Comxt-i/smart-pill-dispenser/output/qa/revised-render/page-9.png

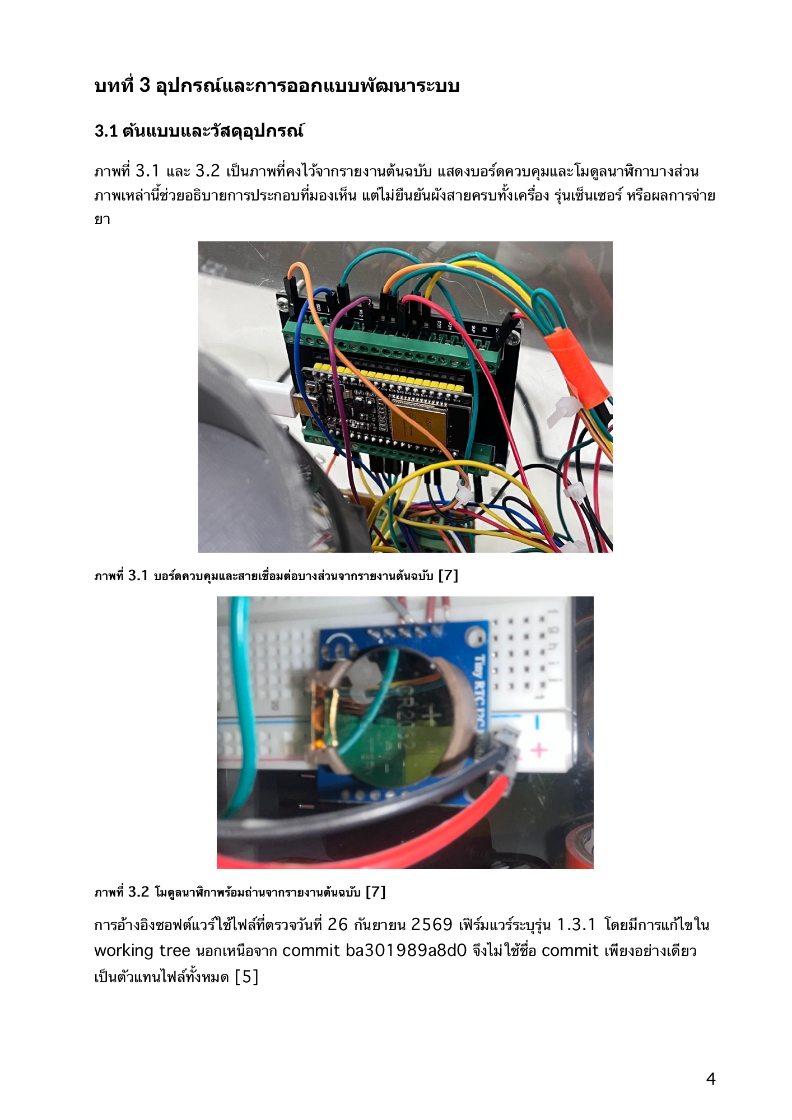
output/qa/revised-render/page-9.png
