Comxt-i/smart-pill-dispenser/output/imagegen/esp32-current-wiring.png

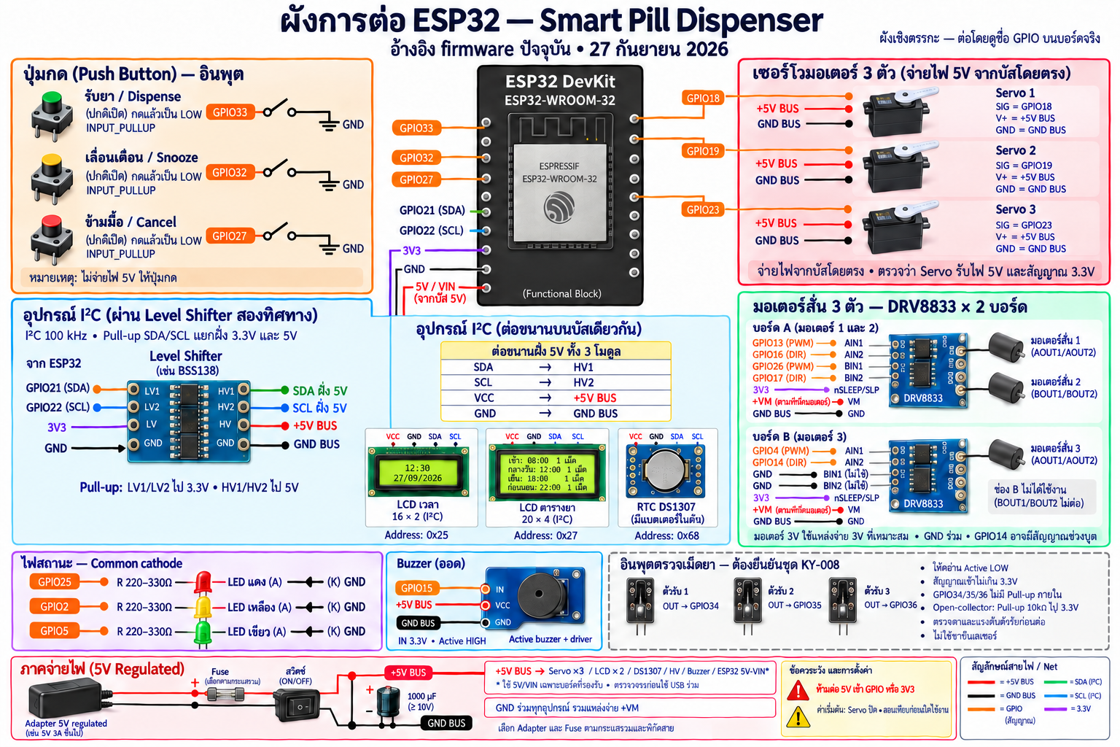
output/imagegen/esp32-current-wiring.png
