Comxt-i/smart-pill-dispenser/README.md

> Wi-Fi setup update: firmware 1.1.0 uses the QR/login + local setup portal. See [QR Wi-Fi setup](docs/QR_WIFI_SETUP.md). To provision a network before flashing, set `WIFI_PRESET_ENABLED true` and fill `WIFI_SSID`/`WIFI_PASSWORD` in local `secrets.h`. On boot, the firmware saves this network only if no valid Wi-Fi settings exist, then connects automatically. Existing saved networks take priority. Account pairing still uses the setup portal; hold the green GPIO33 button for 3 seconds while the mechanism is idle to open it; no restart is needed. The power-on gesture is also supported.

# Smart Pill Dispenser

โปรเจกต์กล่องยาสำหรับผู้สูงอายุแบบจานหมุน 3 ชุด ใช้ **ESP32 เพียงบอร์ดเดียว**
ทำงานร่วมกับเว็บ (`embedded_project/`) ซึ่งเป็นที่ตั้งตารางยาและเก็บประวัติการจ่ายยา

- ESP32 ควบคุม Wi-Fi, RTC DS1307, LCD 2 จอ, ปุ่มกด, Buzzer และ Servo 270° จำนวน 3 ตัวโดยตรง
- Servo แต่ละตัวหมุนจานของยาคนละชนิด ไม่ใช่ระบบรางยา 3 ชุด
- **ตารางยามาจากเว็บอัตโนมัติ** การแก้ไขแจ้งถึงเครื่องผ่าน `/api/device/wait`; sync เต็มทำตามช่วงที่ server กำหนด (ปกติประมาณ 5 นาที)
- ผลการจ่ายที่ส่งไม่สำเร็จจะรอในคิว NVS สูงสุด 12 รายการ เมื่อคิวเต็มรายการเก่าสุดจะถูกแทนที่
- มีอินพุตเซ็นเซอร์ดิจิทัลแบบ active-low สำหรับตรวจเม็ดยา แต่การใช้งานกับชุด **Laser Head Transmitter & Receiver Module KY-008** ยังต้องยืนยันกับอุปกรณ์จริง
- ไม่มีบอร์ด Nano หรือ protocol ส่งคำสั่งระหว่างบอร์ด

## การทำงานหนึ่งรอบ

```text
1. เว็บ: ผู้ใช้เพิ่มยา ตั้งเวลา และเลือกใส่ยาลงช่องที่ 1–3
2. ESP32: รับเวลาและตารางจาก `/api/device/sync`; `/api/device/wait` แจ้งการเปลี่ยนแปลงจากเว็บ
3. ถึงเวลามื้อยา: Buzzer เตือน + LCD จอที่ 2 แสดงชื่อยา เวลา และจำนวนเม็ด
4. ผู้ใช้กดปุ่ม Dispense (GPIO33) -> จานหมุนจ่ายยา
5. ESP32: POST /api/device/events -> เว็บเห็นผลในประวัติและหน้าตารางทันที
6. ถ้าไม่มีใครกดภายใน 30 นาที -> บันทึกเป็น "ขาดยา" อัตโนมัติ
```

รายละเอียดของ API ทั้งหมดอยู่ใน [docs/SERVER_API.md](docs/SERVER_API.md)

## หน้าจอ

**จอเล็ก (16x2, `0x25`)** — วันที่และเวลาปัจจุบันจาก DS1307 รีเฟรชทุกวินาที

**จอใหญ่ (20x4, `0x27`)** — ตารางยาและการโต้ตอบกับผู้ใช้

- **แสดงเฉพาะยาของ "รอบถัดไป" รอบเดียว** ไม่ปนกับรอบอื่น
  ยาหลายชนิดที่ต้องกินพร้อมกันจะขึ้นพร้อมกันบรรทัดละชนิด
- พอรอบนั้นจัดการครบ จอจะเลื่อนไปแสดงรอบถัดไปให้เอง
- รูปแบบ `1 Paracetamol x2` (เลขช่อง ชื่อยา จำนวนเม็ด) ไม่ต้องใส่เวลาในแต่ละบรรทัด
  เพราะทุกบรรทัดใช้เวลาเดียวกันและไปอยู่บรรทัดล่างแล้ว
- **แต่ละบรรทัดเลื่อนวนอิสระจากกัน** ถ้าชื่อยายาวเกิน 20 ตัวอักษร
- **บรรทัดที่ 4 = เวลาของรอบนั้น** และสลับไปแสดงคำแนะนำปุ่มเมื่อถึงเวลา

ตัวอย่างตอนรอ รอบ 08:00 มียา 2 ชนิด ส่วนรอบ 18:00 ยังไม่แสดง:

```text
1 Paracetamol x2
2 Amoxicillin x1

Next 08:00  2 items
```

| สถานการณ์ | บรรทัด 1–3 | บรรทัดที่ 4 (สลับ) |
|---|---|---|
| รอรอบถัดไป | ยาของรอบนั้นทุกชนิด | `Next 08:00  2 items` (นิ่ง ไม่สลับ) |
| ถึงเวลาแล้ว | ช่องที่กำลังเตือนต่อท้ายด้วย `<<` | `NOW 08:00  slot 1` ↔ `GREEN = TAKE NOW` ↔ `YEL +5min  RED skip` |
| เลื่อนไว้ | ช่องนั้นต่อท้ายด้วย `ZZZ` | `Snooze back 08:35` ↔ `Snoozed 1 of 3` |
| เลื่อนครบโควตา | — | คำแนะนำเหลือ `RED = SKIP DOSE` |
| กำลังจ่าย | `Dispensing...` | `Please wait` |
| หมดแล้ววันนี้ | ว่าง | `All done today` |
| เน็ตหลุด | ยาของรอบนั้น | `Next 08:00  2 items` ↔ `OFFLINE - no sync` |

**ไฟแสดงสถานะ (ถ้าเปิดใช้):** แดง GPIO25, เหลือง GPIO2, เขียว GPIO5; Buzzer ใช้ GPIO15

การกดปุ่มทุกครั้งมีข้อความตอบรับสั้นๆ 3 วินาที (`DRY RUN OK`, `SNOOZE 5 MIN`,
`SKIPPED`, `CANNOT SNOOZE`, `NO DOSE DUE`) แล้วกลับไปหน้าเดิมเอง

### สลับจอกัน

ถ้าจอสลับหน้าที่กัน ให้สลับ **เฉพาะค่า `ADDRESS`** ของสองชุดนี้ใน `config.h`
ส่วน `COLS`/`ROWS` ไม่ต้องแตะ เพราะมันบอกขนาดของจอที่ทำหน้าที่นั้น ไม่ได้ผูกกับ address:

```c
constexpr uint8_t LCD_TIME_ADDRESS = 0x25;      // จอเล็ก 16x2
constexpr uint8_t LCD_TIME_COLS = 16;
constexpr uint8_t LCD_TIME_ROWS = 2;

constexpr uint8_t LCD_MEDICINE_ADDRESS = 0x27;  // จอใหญ่ 20x4
constexpr uint8_t LCD_MEDICINE_COLS = 20;
constexpr uint8_t LCD_MEDICINE_ROWS = 4;
```

รองรับจอขนาดอื่นได้ด้วย แค่แก้ COLS/ROWS ให้ตรงกับจอจริง (สูงสุด 20 คอลัมน์ตาม `LCD_MAX_COLS`)

## ปุ่มกด

ใช้โมดูลปุ่ม 3 ตัว **จ่ายไฟ VCC ด้วย 3.3V เท่านั้น** (5V จะทำให้ GPIO เสียหาย)
ทุกปุ่มเป็น active-LOW คือกดแล้วดึงขาลง GND ซึ่งตรงกับ `INPUT_PULLUP` ในโค้ด

| ปุ่ม | สีบนโมดูล | ขาโมดูล | GPIO | กดขณะกำลังเตือน | กดตอนปกติ |
|---|---|---|---:|---|---|
| Dispense (กดสั้นแล้วปล่อย) | เขียว | K3 | 33 | จ่ายยามื้อนั้นเมื่อปล่อยปุ่ม | เตือนว่ายังไม่ถึงเวลา |
| Wi-Fi Setup (กดค้าง 3 วินาที) | เขียว | K3 | 33 | เข้า Setup เมื่อกลไกว่าง โดยไม่จ่ายยา | เข้า Setup โดยไม่ต้องรีสตาร์ต |
| Snooze | เหลือง | K2 | 32 | เลื่อนไปอีก 5 นาที | สั่ง sync ตารางใหม่ทันที |
| Cancel | แดง | K1 | 27 | กดสั้น = ข้ามมื้อนี้ (บันทึก SKIPPED) | — |
| Cancel (กดค้าง ≥ 1.2 วินาที) | แดง | K1 | 27 | หยุดส่ง PWM ทันที | หยุดส่ง PWM ทันที |

กดค้างจะไม่สั่งจ่ายยาเมื่อปล่อยปุ่ม หากกลไกทำงานระหว่างกด ต้องปล่อยแล้วกดใหม่หลังกลไกว่าง ระหว่าง Setup จะพักการจ่ายยาและการเตือนจนตั้งค่าเสร็จ

การหยุด PWM ไม่ใช่การตัดไฟ Servo หรือการรับประกันว่ากลไกหยุดทันที

### การเลื่อนการเตือน (ปุ่มเหลือง)

- เลื่อนครั้งละ `SNOOZE_MINUTES` (5 นาที) ได้สูงสุด `MAX_SNOOZE_PER_DOSE` (3 ครั้ง) ต่อมื้อ
- ระหว่างเลื่อนจะ**เงียบสนิท** ไม่มีเสียงเตือน แต่จอยังแสดงว่าจะกลับมาเตือนกี่โมง
- **เลื่อนจนเลยเวลาผ่อนผันไม่ได้** ถ้าเลื่อนแล้วจะตื่นหลังหมด 30 นาที ระบบจะปฏิเสธ
  และขึ้น `CANNOT SNOOZE` เพื่อไม่ให้ผู้ใช้ผัดจนกลายเป็นขาดยาโดยไม่รู้ตัว
- มื้อที่เลื่อนไว้แล้วไม่มีใครมากดจนหมดเวลา ยังถูกบันทึกเป็น `MISSED` ตามปกติ
- การเลื่อน**ไม่สร้างประวัติแยก** แต่จะแนบจำนวนครั้งไปกับผลสุดท้าย เช่น `snoozed 2x`
  ผู้ดูแลจึงเห็นว่ามื้อนั้นถูกผัดไปกี่รอบโดยที่ประวัติไม่รก

## โครงสร้างโฟลเดอร์

```text
smart-pill-dispenser/
├── ESP32_Main/
│   ├── ESP32_Main.ino        # setup/loop เรียก pill_app เท่านั้น
│   ├── pill_app.cpp/.h       # ตรรกะหลัก: รวมตาราง ปุ่ม เสียง จอ และการคุยกับ server
│   ├── net_sync.cpp/.h       # HTTP + JSON คุยกับ backend
│   ├── schedule_store.cpp/.h # ตารางยาของวันนี้และสถานะรายมื้อ
│   ├── event_queue.cpp/.h    # คิวผลการจ่ายยา เก็บลง NVS กันหายตอนไฟดับ
│   ├── dispenser_control.cpp/.h
│   ├── buttons.cpp/.h
│   ├── alert.cpp/.h          # จังหวะเสียง buzzer แบบไม่ block
│   ├── rtc_lcd.cpp/.h        # นาฬิกา DS1307 + จอสองจอ
│   ├── marquee.cpp/.h        # ข้อความเลื่อนวนบนจอแบบไม่ block
│   ├── wifi_web.cpp/.h       # Wi-Fi แบบไม่ block + หน้าเว็บสถานะในเครื่อง
│   ├── config.h
│   ├── certs.h               # root CA ของ Let's Encrypt สำหรับตรวจใบรับรอง HTTPS
│   └── secrets.example.h
├── examples/
│   ├── TestDispenseEvent/    # sketch ทดสอบยิงผลการกดรับยาขึ้น server (ไม่ต้องต่อกลไก)
│   └── TwoPlateDispense/     # sketch สอบเทียบจานหมุน 2 จาน + มอเตอร์สั่นบน DRV8833
├── tests/
│   ├── syntax/               # header จำลองสำหรับตรวจไวยากรณ์บนคอมพิวเตอร์
│   └── ...
├── docs/
│   ├── ARCHITECTURE.md
│   └── SERVER_API.md
├── .gitignore
└── README.md
```

เปิด `ESP32_Main/ESP32_Main.ino` ด้วย Arduino IDE และอัปโหลดเพียงบอร์ดเดียว

## บอร์ดและไลบรารีที่ต้องใช้

ผังขาเริ่มต้นอิง ESP32 DevKit / ESP32-WROOM-32 แบบดั้งเดิม ไม่ใช่ ESP32-C3/S3
ติดตั้งแพ็กเกจบอร์ด `esp32 by Espressif Systems` และเลือกบอร์ดให้ตรงกับฮาร์ดแวร์
ติดตั้งไลบรารี:

- `ESP32Servo` สำหรับควบคุม Servo ด้วย PWM ของ ESP32
- `ArduinoJson` **เวอร์ชัน 7 ขึ้นไป** (โค้ดใช้ `JsonDocument` แบบใหม่ ไม่รองรับ v6)
- `LiquidCrystal_I2C`
- `TimeLib` (ชื่อใน Library Manager: `Time`)
- `DS1307RTC`

`Wire`, `WiFi`, `WebServer`, `HTTPClient` และ `Preferences` มาพร้อมแพ็กเกจบอร์ด ESP32

## ตั้งค่าก่อนใช้งาน

1. **เตรียม backend ให้พร้อมก่อน** เลือกอย่างใดอย่างหนึ่ง:
   - *ทดสอบในวง LAN*: ที่ `embedded_project/backend` คัดลอก `.env.example` เป็น `.env`
     แล้วรัน `npm install`, `npm run prisma:db:push`, `npm run prisma:seed`, `npm start`
     backend ผูกกับ `0.0.0.0` อยู่แล้ว จึงเรียกจากวง LAN ได้
   - *ใช้งานจริงผ่านอินเทอร์เน็ต*: deploy ด้วย Docker Compose ตาม
     [embedded_project/DEPLOY.md](../embedded_project/DEPLOY.md) จะได้โดเมนพร้อม HTTPS
2. คัดลอก `ESP32_Main/secrets.example.h` เป็น `ESP32_Main/secrets.h` แล้วกรอก:
   - `WIFI_SSID` / `WIFI_PASSWORD`
   - `SERVER_BASE_URL` — รองรับทั้งสองแบบ:
     - deploy แล้ว: `https://pillbox.example.com` (ตรวจใบรับรองด้วย `certs.h` ให้อัตโนมัติ)
     - ในวง LAN: `http://192.168.1.100:3000` โดยใช้ IP ของเครื่องที่รัน backend
       ห้ามใช้ `localhost` เพราะ localhost ของ ESP32 คือตัวมันเอง
   - `DEVICE_API_KEY` = ค่าจาก `Device.api_key` ในฐานข้อมูล
     (seed ตอน dev ให้ค่า `esp32_sec_key_246f28abc199` ส่วนตอน production จะสุ่มให้ใหม่)
3. ต่อสายตาม [docs/ARCHITECTURE.md](docs/ARCHITECTURE.md): Servo จาน 1–3 ใช้ GPIO18, GPIO19, GPIO23
4. ตรวจ I²C address ของ LCD ทั้งสองจอ; ค่าเริ่มต้นคือ `0x27` และ `0x25` ส่วน DS1307 คือ `0x68`
5. ตรวจช่วง pulse ที่ Servo รองรับ แล้วปรับ `SERVO_MIN_PULSE_US`, `SERVO_MAX_PULSE_US`,
   `REST_PULSE_US`, `RELEASE_PULSE_US` และ `MOVE_TIME_MS` ใน `config.h` โดยทดสอบแบบไม่ใส่ยาก่อน
   ค่าเริ่มต้นเป็นเพียงตัวอย่าง ไม่ใช่ช่วงหมุนครบ 270°
6. **ยังไม่ต่อ Servo:** ปล่อย `ENABLE_SERVO_MOVEMENT = false` และ `DISPENSE_DRY_RUN = true`
   ระบบจะทำงานครบวงจร (เตือน → กดปุ่ม → บันทึกขึ้นเว็บ) โดยไม่ขยับอะไร
   และติดป้ายในบันทึกว่า `dry run` เพื่อไม่ให้ประวัติหลอกว่าเม็ดยาออกมาจริง

   **ต่อ Servo แล้ว:** ตั้ง `DISPENSE_DRY_RUN = false` ก่อน แล้วค่อยเปลี่ยน
   `ENABLE_SERVO_MOVEMENT` เป็น `true` เมื่อสอบเทียบค่า pulse เรียบร้อย
   ถ้าตั้ง dry run เป็น false ขณะที่ยังปิดการเคลื่อนไหว จะได้ `FAILED / servo disabled`
   ซึ่งเป็นพฤติกรรมที่ถูกต้อง ไม่ใช่ความผิดพลาดของการเชื่อมต่อ
7. เปิด Serial Monitor ที่ 115200 baud — ตอนบูตจะ**สแกนบัส I²C แล้วรายงาน**ว่าพบ
   จอทั้งสองและ DS1307 ครบไหม ถ้า address ไม่ตรงจะเห็นคำเตือนทันทีแทนที่จอจะดับเงียบๆ
   จากนั้นเปิด IP ที่แสดงหลังเชื่อมต่อ Wi-Fi เพื่อดูหน้าสถานะในเครื่อง
   (ตาราง สถานะ sync คิวที่ค้าง และปุ่มทดสอบจ่ายยา)

## ทดสอบการเชื่อมต่อก่อนประกอบกลไก

ถ้าอยากตรวจว่า ESP32 คุยกับ server ได้จริงก่อนจะต่อ LCD, RTC และ Servo
ให้อัปโหลด [examples/TestDispenseEvent](examples/TestDispenseEvent/) แทน
sketch นั้นต่อแค่บอร์ดกับสาย USB ก็ทดสอบได้ ใช้ไลบรารีแค่ ArduinoJson
และมีคำสั่งผ่าน Serial สำหรับยิง `DISPENSED` / `MISSED` / `SKIPPED` / `FAILED`
รวมถึงทดสอบการส่งซ้ำเพื่อพิสูจน์ว่าระบบกันบันทึกซ้ำได้จริง

## พฤติกรรมเมื่อเน็ตหรือไฟมีปัญหา

- **Wi-Fi หลุด**: หากมีตาราง cache ที่อ่านได้และ RTC ใช้งานได้ เครื่องยังแจ้งเตือนและจ่ายยาตามตารางในเครื่อง
  ผลที่บันทึกลงคิว NVS แล้วจะส่งเมื่อกลับมาออนไลน์; คิวรองรับ 12 รายการและทิ้งรายการเก่าสุดเมื่อเต็ม
- **ไฟดับ**: ตาราง cache และคิวเหตุการณ์ที่เขียนลง NVS แล้วคงอยู่ และ DS1307 ที่มีถ่านสำรองยังเดินเวลาต่อ
  แต่ผลของกลไกที่ยังพักใน RAM ระหว่างมีจานทำงานอาจหายหากไฟดับก่อนบันทึก
- **บูตกลางวัน**: มื้อที่เลยมาเกิน 30 นาทีจะถูกข้ามเงียบๆ ไม่ปลุกย้อนหลังและไม่รายงานซ้ำ
  เพราะฝั่ง server ถือว่ามื้อที่ไม่มี log คือขาดยาอยู่แล้ว
- **server ล่ม**: เครื่องลอง sync ใหม่หลังช่วง retry 15 วินาที และยังทำงานตามตารางในเครื่องได้เมื่อ RTC พร้อม

## ทดสอบ logic บนคอมพิวเตอร์

ต้องมี `c++` และ `python3`

```bash
python3 tests/test_dispenser_control.py
python3 tests/test_schedule_store.py
python3 tests/test_marquee.py
python3 tests/test_firmware_syntax.py
```

- `test_dispenser_control.py` ทดสอบการคุม Servo ด้วยฮาร์ดแวร์จำลอง ทั้งตอนเปิดและปิดการเคลื่อนไหว
  รวมถึงการรายงานผลหนึ่งรอบผ่าน `takeDispenseOutcome()`
- `test_schedule_store.py` ทดสอบตรรกะตารางยา: การเตือน การนับว่าขาดยา การข้ามมื้อที่เลยมานานตอนบูต
  การคงสถานะเมื่อ sync ระหว่างวัน การข้ามวัน และช่องที่ถูกปิดใช้งาน
- `test_marquee.py` ทดสอบการเลื่อนข้อความบนจอ: ข้อความสั้นต้องอยู่นิ่ง ข้อความยาวต้องเลื่อน
  ครบทุกตัวอักษรและวนกลับมาที่ต้นได้ และการเรียกซ้ำด้วยข้อความเดิมต้องไม่ทำให้ภาพกระตุก
- `test_firmware_syntax.py` ตรวจไวยากรณ์ของทุกโมดูล **รวมถึง sketch ใน `examples/`**
  ด้วย header จำลองใน `tests/syntax/` จับพวกพิมพ์ผิด ลืม include และเรียกฟังก์ชันผิด
  signature ได้โดยไม่ต้องมี ESP32 toolchain

การทดสอบเหล่านี้ **ไม่แทน** การ compile ด้วย ESP32 toolchain จริงหรือการทดสอบกับบอร์ดและกลไกจริง
`tests/syntax/` เป็น header จำลองแบบว่างเปล่า ไม่ได้ตรวจพฤติกรรมของไลบรารีจริง
ก่อนนำไปใช้งานจริงต้อง compile และอัปโหลดผ่าน Arduino IDE เสมอ

## ระบบจ่ายไฟ

- ใช้ Adapter 5V regulated ต่อผ่าน Fuse และสวิตช์ก่อนเข้าบอร์ดกระจายไฟ
- ต่อ Capacitor 1000µF คร่อม `+5V` กับ `GND` ใกล้จุดจ่ายไฟ Servo
- จ่ายไฟ Servo จากบอร์ดกระจายไฟโดยตรง ห้ามจ่ายผ่านขา 3.3V/5V ของ ESP32
- ESP32, Servo และโมดูลที่สื่อสารกันต้องใช้ GND ร่วมกัน
- ตรวจว่า Servo รองรับ 5V และเลือกพิกัด Fuse ตามสาย ขั้วต่อ และกระแสจริงของระบบ
- GPIO ของ ESP32 ใช้ลอจิก 3.3V: โมดูล I²C ที่ดึงสัญญาณขึ้น 5V ยังต้องผ่าน Logic Level Shifter

รายละเอียดระดับสัญญาณ ผังสาย และข้อจำกัด firmware อยู่ใน [docs/ARCHITECTURE.md](docs/ARCHITECTURE.md)

## สิ่งที่ยังไม่ได้ทำ

- firmware มีโค้ดอ่านเซ็นเซอร์ดิจิทัลแบบ active-low แต่การใช้ชุด KY-008 และการนับเม็ดยากับกลไกจริงยังไม่ผ่านการยืนยัน
  ผลจำลองหรือสถานะ `DISPENSED` จากการทดสอบจึงไม่ใช่หลักฐานว่าเม็ดยาตกครบจำนวน
- ค่า pulse และเวลาหมุนยังไม่ผ่านการสอบเทียบกับกลไกจริง
- การใช้ `http://` ในวง LAN ส่ง API Key แบบไม่เข้ารหัส เหมาะกับเครือข่ายที่เชื่อถือได้เท่านั้น
  ถ้าเปิดออกอินเทอร์เน็ตต้องใช้ `https://` (รองรับแล้ว ดู `certs.h` และ `TLS_VERIFY_CERTIFICATE`)

## ทดสอบระบบโดยยังไม่มีฮาร์ดแวร์

เฟิร์มแวร์ 1.2.0 ยังใช้ `ENABLE_SERVO_MOVEMENT=false` และ `DISPENSE_DRY_RUN=true` จึงไม่ขยับกลไก
เมื่อเชื่อมเว็บและ sync สำเร็จ เวลาท้องถิ่นจาก server จะเริ่มนาฬิกาใน RAM แม้ไม่มี RTC/LCD
นาฬิกาเดินต่อได้ขณะ Wi-Fi หลุด แต่หลังไฟดับหรือรีบูตต้องรับเวลาใหม่ก่อนใช้ตารางยา ถ้ามี RTC ที่ใช้ได้จะอ่านเวลาจาก RTC
หน้า `/status` ในเครือข่ายเดียวกันแสดง `clock_valid`, `clock_source` (`RTC`, `SERVER`, `WAITING`) และ `dry_run`

ตั้งยาทดสอบลงช่องแล้วตั้งเวลาในอนาคต เมื่อถึงเวลากดปุ่มเขียวสั้นแล้วปล่อย (เว็บสั่งจ่ายยาไม่ได้ ต้องกดที่กล่องเท่านั้น)
ผลจะมีหมายเหตุ `dry run` รวมถึงการข้าม และการเลยเวลาในโหมดจำลอง
ปฏิทินควรแสดงว่าเป็นการทดสอบและไม่นับรวมสถิติการจ่ายจริง ต้องใช้เว็บ/backend ชุดที่รองรับด้วย
ผลทดสอบยืนยันได้เฉพาะเส้นทางซอฟต์แวร์ ไม่ได้ยืนยันจำนวนเม็ดหรือการทำงานของกลไกจริง

## เตรียมอัปโหลดรุ่น 1.3.1

ดู [คู่มืออัปโหลดและเปิดใช้ฮาร์ดแวร์](docs/UPLOAD_FIRMWARE.md)
ค่าเริ่มต้นสำหรับบอร์ดเปล่าเป็น SIMULATION; profile ฮาร์ดแวร์แยกใน `hardware.local.h`
สคริปต์ `python3 tools/firmware.py upload --port <USB_PORT>` จะ build ใหม่ก่อน flash ทุกครั้ง
