Comxt-i/smart-pill-dispenser/output/qa/original-render/Smart_Pill_Dispenser_Report.pdf

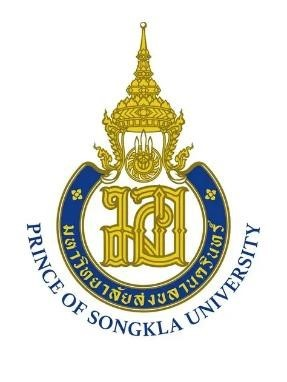
[picture p16: figure]

รื่ | จ่
อั | ริ

### Smart Pill Dispenser

จั | ทำ
กั | ษ์ | ก้ | หั | นั | ศึ
6710110021
ดี | รี | ล้ | หั | นั | ศึ
6710110562
. | . วี
ศั | ดิ์ | รื
พี | กุ | ร .

. ปั
. | ริ | ร์
ก้ | ภิ | ชั

นี้ | ป็ | ส่ | นึ่ | วิ | 240-
319 Embedded System Developer Module
วิ | รร | ร์ | วิ | รร
พิ | ร์
วิ | ลั | ริ | ร์ | วิ

ญ่

คำ | นำ

ESP32

ร

IR

Wi-Fi
รร

รร

25 | . . 2569

บั

1

1
1.1 | 1.2 | 1.3
| | 1
2
| | 2
2.1 | 2.4
| | 2
2.5 | 2.7
| | 3
3
| | 4
3.1 | | 4
3.2 | | 5
3.3 | | 6
3.4 | | 7
3.5 | | 8
3.6 | | 9
4 | 10
4.1 | | 10
4.2 | | 11
4.3 | 12 5 | 13
| | 14

ที่ | 1 | นำ
1.1 ที่ | สำ | คั

ESP32

IR

1.2 วั | ถุ | ค์
1.
ESP32
2. รร
3. IR
4. รร

1.3

1–9
ร
ร

ที่ | 2 | ยี | ที่
กี่ | ข้
2.1 | ร์ | ESP32
ESP32 | Wi-Fi ร
GPIO | ESP32 DevKit | ESP32-
WROOM-32

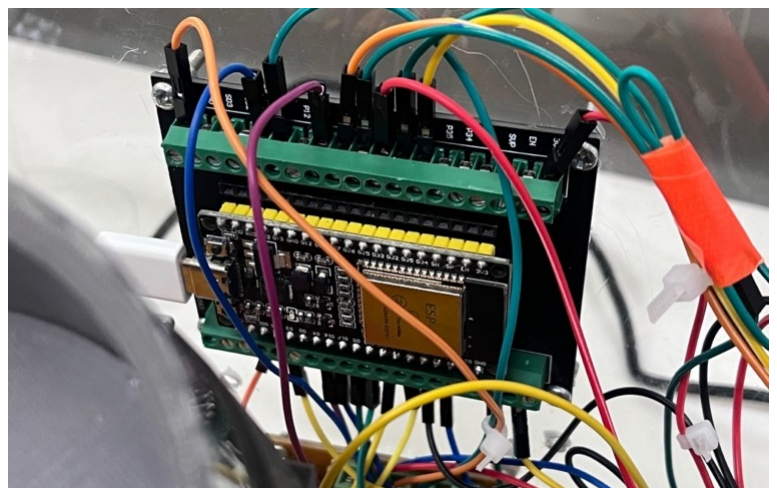
[picture p17: figure]

2.2 | ฬิ | DS1307 | LCD
DS1307 | I²C
LCD | 16×2 | 20×4
I²C | 0x25
| 0x27

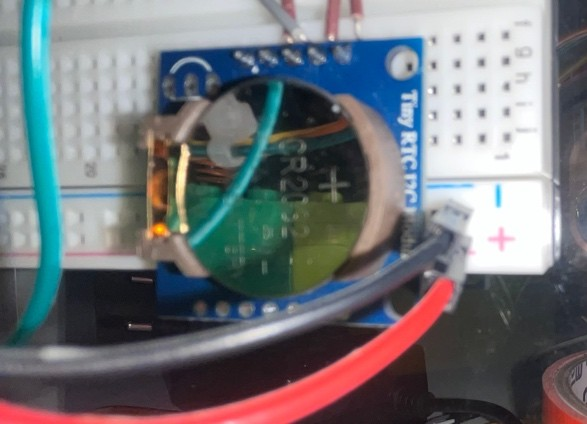
[picture p18: figure]

2.3 | ร์ | ร์ | ร์ | สั่

DRV8833

2.4 ซ็ | ร์ | IR สำ | รั | นั | ม็
IR
60
ร

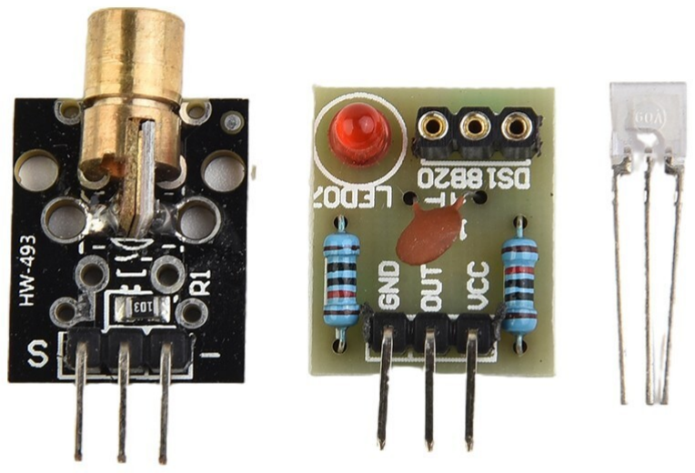
[picture p19: figure]

ที่ | 2 | ยี | ที่
กี่ | ข้
2.5 | สื่ | ผ่ | รื | ข่ | API
ESP32
60 | รร | GET /api/device/sync
ร | POST
/api/device/events
URL | HTTP | HTTPS | HTTPS
config.h
API key
JWT
2.6 ว็ | ต์ | ข้ | มู
React | TypeScript
NestJS | Prisma | PostgreSQL
ร

account

2.7 | ทำ | ก็ | ข้ | มู
ร | ร

loop
Flash/NVS
website | (Command ID)

ร

ที่ | 3 อุ | ณ์ | พั
3.1 วั | ดุ | อุ | ณ์
ำ ดั | อุ ณ์ | จำ | น้ ที่
1 | ESP32 DevKit / WROOM-32 | 1
2 | RTC DS1307 | 1
3 | LCD I²C 16×2 | 1
4 | LCD I²C 20×4 | 1
5 | | 3
6 | | 3
7 | DRV8833 | 2
8 | IR | 3
9 | | 1
10 | LED | 1
11 | Buzzer | 1
12 | I²C | 1
13 | | 1
14 | | 1

ำ ดั | อุ ณ์ | จำ | น้ ที่

15

รื่ | มื | พั | ต์ | ร์
Arduino IDE
ESP32 | ESP32Servo, ArduinoJson, LiquidCrystal_I2C, TimeLib
DS1307RTC | Python | C++
ESP32

3.2 | ร้ | ชื่ | ต่

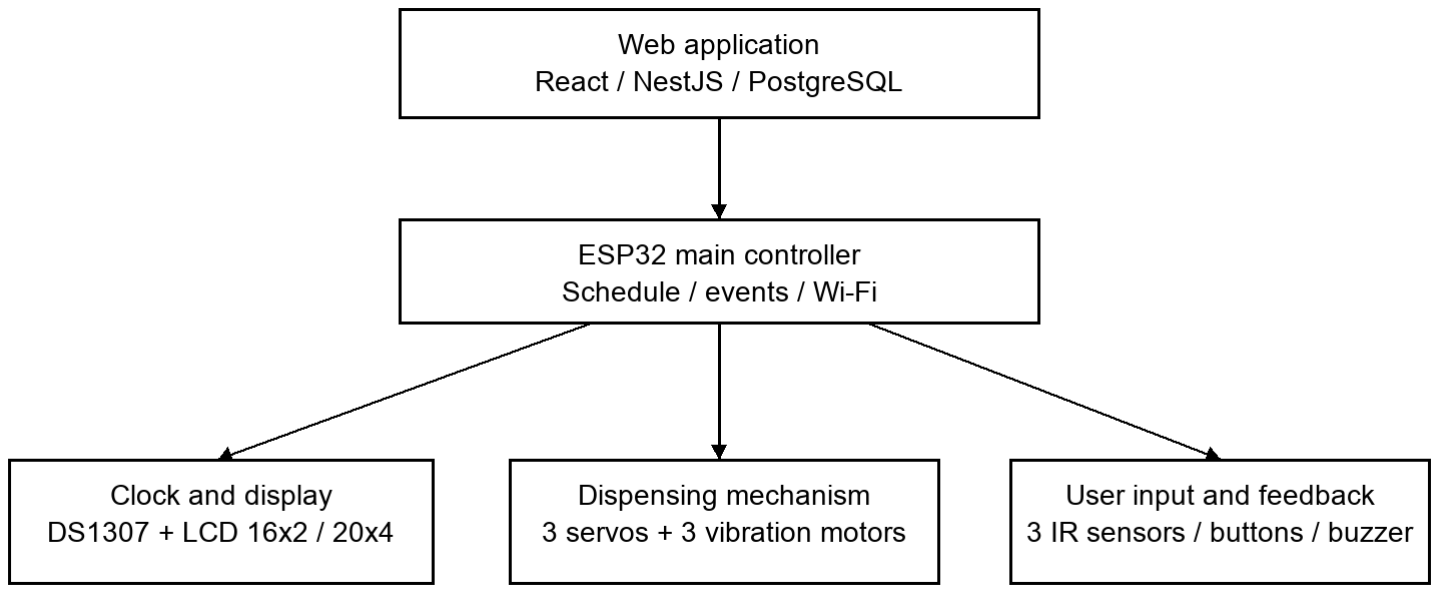
[picture p20: figure]

รู | ที่ | 1 | ร้ | ทำ
รื่ | จ่ | อั | ริ
อุ ณ์ รื สั | GPIO ESP32
I²C SDA SCL | 21 22
Servo 1 / 2 / 3 | 18 / 19 / 23
PWM 1 / 2 / 3 | 13 / 26 / 4
DIR 1 / 2 / 3 | 16 / 17 / 14
IR 1 / 2 / 3 | 34 / 35 / 36
/ / | 33 / 32 / 27
Buzzer | 25
RTC | I
| 2 C ร
IR | ESP32

GND

ESP32

3.3 | นั | ม็

Idle →
WaitingStart → Releasing | → Returning | → Shaking

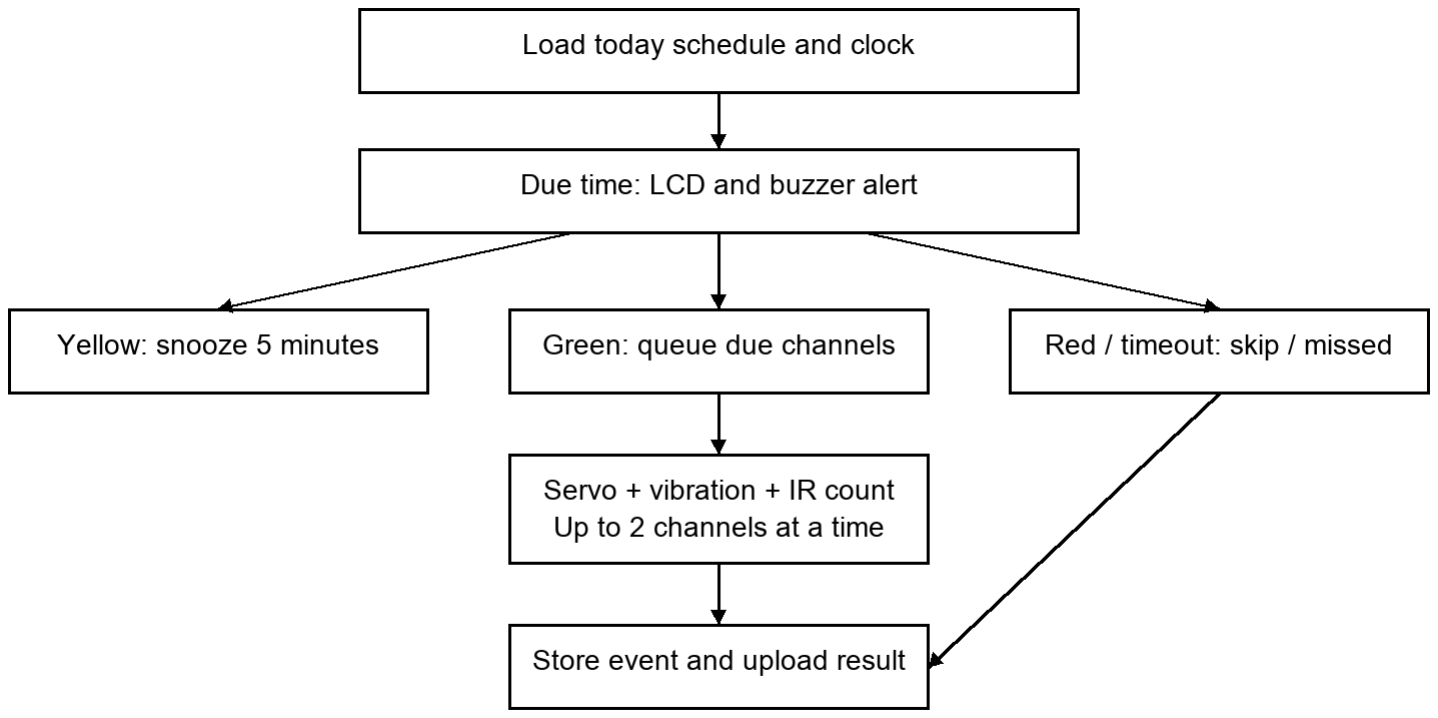
[picture p21: figure]

รู | ที่ | 2 ลำ | ดั | รั | บั | ทึ

ทำ
KY-008
8 | (
, | , | )
8 | ร

2
250

3.4 | ปุ่ | น้

รร

ช้ | ติ | รร
3 | Wi-Fi
| 5 3 ค
1.2 | PWM
| MISSED ค 30

รร
1–3 | รร | 4
รร
ตั | ย่ | ข้
1 MedicineA x2
2 MedicineB x1
3 MedicineC x1
Next 08:00 2 items

3.5 ว็ | ต์ | ลี่ | ข้ | มู

รร

รร

ค์ ข้ มู

User Device

Compartment Medication
Schedule
IntakeLog
DeviceCommand
DeviceSetupSession
ลำ | ดั | รั | ส่ | ข้ | มู
1. : ESP32
2. :
ร
3. :
4. :

ที่ | ส่ | ลั
- DISPENSED DISPENSED:
- MISSED:
- SKIPPED:
- FAILED:
- Dry Run: | dry run

รร

3.6 | ตั้ | ค่ | จั | มื่ | กิ
ข้ | ขั | ข้
ตั้ | ค่ | Wi-Fi | จั | คู่ | บั | ชี
QR

192.168.4.1

ร

ทำ | มื่ | รื | ข่ | ขั | ข้
NVS | 12
ริ่ | รื่ | ม่ | ป้ | กั
จ่ | ซ้ำ
NVS

RTC

รี | รื่ | ก่ | ปิ | ริ

PILLBOX_REAL_HARDWARE
PILLBOX_CALIBRATED

IR

ที่ | 4 | ดำ | นิ
4.1 | ต์ | ร์
25 | 2569
tests | unittest discover
13 | ร | 24.3
C++
ลุ่ | จำ
| 2
| 1
| 1
| 1
LCD | 1
| 1
| 2
| 1
| 1
| 2
| 13

รร

4.2 | มิ | กั | รื่ | ริ
ร | ร
สิ่ | ที่ | ต้

ก็

IR

| LCD
Wi-Fi | ค

QR

บั | ทึ | สำ | รั | ติ | ลั
| ช่ | สั่ ม็ | ริ ม็ | วิ ที | รื ข้ สั
1 | ...... | ...... | ...... | ...... | |
2 | ...... | ...... | ...... | ...... | |
3 | ...... | ...... | ...... | ...... | |
4 | ...... | ...... | ...... | ...... | |
5 | ...... | ...... | ...... | ...... | |

= | ÷
× 100

4.3 ค่ | ช้ | จ่ | ดำ | นิ
| จำ | ต่ น่
ESP32 | 1 | 168 | 168
Adabter 5V 5A | 1 | 280 | 280
DS1307 | 1 | 45 | 45
LCD 16×2 | 1 | 73 | 73
LCD 20×4 | 1 | 123 | 123
| 3 | 91 | 273
| 3 | 32 | 96
DRV8833 | 2 | 40 | 80
Laser Head Transmitter Sensor + Laser receiver module | 3 ค | 50 | 150
Buzzer | 1 | 7 | 7
| 1 | 42 | 42
| 1 | 9 | 9
Push Button Switch Module 3 3 | 1 | 22 | 22
LED Module 3 traffic light | 1 | 12 | 12
| 1 | 100 | 100
| 1 | 398 | 398
| 12 | 7 | 84
| 1 | 160 | 160
google cloud | 1 | -
| | | 2,122

ค่ | พั | รั้ | (NRE Cost)
- | 20 | × 150 | = 3,000
- | 20 | × 150 | = 3,000
- | 10 | × 150 | = 1500
NRE = 3,000 + 3,000 + 1,500 = 7,500
ต้ | ทุ | = 2,122 ( | ) + 7,500
(NRE) = 9,622
ค่ | ช้ | จ่ | จำ | (Recurring Cost)
Google Cloud: | 1 | 3
6 | 30
70 | /

ที่ | 5 รุ | ข้
5.1 รุ | พั

ESP32
รร
ร
13 | รร
5.2 ข้ | จำ | กั

12

รร

5.3 | พั | ต่

IR

ร
