Comxt-i/smart-pill-dispenser/output/restart/qa/original-render/Original_Report.pdf

รายงานโครงงานเครื่องจ่ายยาอัจฉริยะ Smart Pill Dispenser

จัดทำโดย

นายกันตพงษ์ ปานแก้ว รหัสนักศึกศึ | ษา 6710110021
นางสาวญาณวดีศรีสล้าง รหัสนักศึกศึ | ษา 6710110562

เสนอ

รศ. ดร. ทวีศักศั ดิ์
เรืองพีระกุล รศ.
ดร. ปัญญยศ ไชย
กาฬ ผศ. ดร. วชริน
ทร์ แก้วอภิชัยชั

รายงานนี้เป็นส่วนส่ หนึ่งของรายวิชา 240-319 Embedded System Developer Module

คณะวิศวกรรมศาสตร์ สาขาวิศวกรรมคอมพิวเตอร์ มหาวิทยาลัยสงขลานครินทร์วิทยาเขตหาดใหญ่

คำนำ

รายงานฉบับนี้นำเสนอการออกแบบและพัฒนาเครื่องจ่ายยาอัจฉริยะ
สำ หรับช่วยช่ | จัดการยาตามเวลาที่กำหนด โดยใช้ไมโครคอนโ ช้ | ทรลเลอร์
ESP32 ควบคุมกลไกจานหมุนสามช่องช่ | ทำงานร่วมกับเว็บไซต์สำ หรับ
กำหนด ตารางยาและตรวจสอบประวัติการจ่ายยา โครงงานมุ่งเชื่อมโยง ชื่ ความรู้ด้านระบบฝังตัว การควบคุมอุปกรณ์และ การสื่อสาร สื่ ผ่านเครือข่าย เข้าด้วยกัน
เนื้อหาประกอบด้วยที่มาและวัตถุประสงค์ เทคโนโลยีที่ใช้ วัสดุ อุปกรณ์ การออกแบบฮาร์ดแวร์และ ซอฟต์แวร์ ตลอดจนผลการทดสอบ
และข้อเสนอแนะในการพัฒนาต่อ ระบบใช้จช้ | อแสดงผลและเสียงเ สี | ตือน
เพื่อ แจ้งรอบยา ผู้ใช้สามาร ช้ | ถกดรับยา เลื่อนการเตือน หรือข้ามรอบยา
และระบบส่งส่ | ผลการทำงานกลับไปยังเว็บไซต์
การพัฒนาซอฟต์แวร์ครอบคลุมการนับเม็ดยาด้วยเซ็นเซอ ซ็ | ร์IR การ
จัดคิวหลายช่อง การเ ช่ | ก็บเหตุการณ์เมื่อเครือข่ายขัดข้อง และการตั้งค่า
Wi-Fi ผ่านโทรศัพศั | ท์ผลทดสอบซอฟต์แวร์ช่วยตรว ช่ | จสอบตรรกะของ
ระบบ ส่วนการประเ ส่ | มินความแม่นยำของกลไกต้องดำเนินการกับอุปกรณ์
และเม็ดยาจริงเพิ่มเติม
คณะผู้จัดทำหวังว่ารายงานฉบับนี้จะเป็นประโยชน์ต่อผู้ที่สนใจ
พัฒนาระบบจ่ายยาและประยุกต์ใช้ อินเทอร์เน็ตของสรรพสิ่งในงานระ สิ่ | บบ
ฝังตัว

คณะผู้จัดทำ
วันที่ 25 เดือน กันยายน พ.ศ. 2569

สารบัญ

คำนำ | ก
สารบัญ | ข
บทที่ 1 บทนำ | 1
1.1 ที่มาและความสำ คัญ 1.2 วัตถุประสงค์ 1.3 ขอบเขต | 1
บทที่ 2 เอกสารและเทคโนโลยีที่เกี่ยวข้อง | 2
2.1 ถึง 2.4 อุปกรณ์ควบคุมและตรวจจับ | 2
2.5 ถึง 2.7 เครือข่าย ฐานข้อมูล และการทำงานแบบสถานะ | 3
บทที่ 3 อุปกรณ์และการออกแบบพัฒนาระบบ | 4
3.1 วัสดุและอุปกรณ์ | 4
3.2 โครงสร้างระบบและการเชื่อมชื่ | ต่อ | 5
3.3 การออกแบบกลไกและการนับเม็ดยา | 6
3.4 ตารางยา ปุ่มกด และหน้าจอ | 7
3.5 เว็บไซต์และการแลกเปลี่ยนข้อมูล | 8
3.6 การตั้งค่าและการจัดการเมื่อเกิดข้อขัดข้อง | 9
บทที่ 4 ผลการดำเนินงาน | 10
4.1 ผลทดสอบซอฟต์แวร์ | 10
4.2 การประเมินกับเครื่องจริง | 11
4.3 ค่าใช้จ่ ช้ | ายในการดำเนินงาน | 12
บทที่ 5 สรุปผลและข้อเสนอแนะ | 13
เอกสารอ้างอิงของโครงงาน | 14

บทที่ 1 บทนำ

### 1.1 ที่มาและความสำ คัญ

ปัจจุบัน สังคมไ สั | ด้ก้าวเข้าสู่สัสู่ | งคม สั | ผู้สูงอายุ ซึ่งซึ่ | ผู้สูงอายุส่วนให ส่ | ญ่มักมี
โรคประจำตัวที่จำเป็นต้องรับประทานยาอย่างต่อเนื่องเป็นประจำทุกวัน
ปัญหาสำ คัญที่พบได้บ่อยในการดูแลผู้สูงอายุคือความเสื่อมสื่ | ถอยของความ
จำและความสับสั | สน โดยเฉพาะเมื่อต้องรับประทานยาหลายชนิดและมีช่วงช่
เวลาที่แตกต่างกัน ทำให้เกิดความผิดพลาดในการทานยาอยู่บ่อยครั้ง เช่น ช่
การลืมทานยา การทานยาไม่ตรงเวลา หรือในบางกรณีอาจเกิดความสับสั | สน
จนทานยาซ้ำ | ซึ่งซึ่ | ส่งส่ | ผลให้ผู้สูงอายุได้รับปริมาณยาเกินขนาด อาจก่อให้เกิด
อันตรายร้ายแรงต่อสุขภาพและชีวิชี | ตได้
การจัดยาหลายชนิดให้ตรงตามตารางจึงเป็นภาระงานที่ต้องติดตาม
อย่างใกล้ชิดชิ | ทั้งในเรื่องของเวลาและจำนวนเม็ด โดยเฉพาะอย่างยิ่งเมื่อผู้
ใช้งาน ช้ | มีรอบยาหลายช่วงในห ช่ | นึ่งวัน เพื่อลดข้อผิดพลาดดังกล่าวและแบ่ง
เบาภาระของผู้ดูแล โครงงานนี้จึงพัฒนาอุปกรณ์ช่วยเ ช่ | ตือนและจ่ายยาตาม
ข้อมูลที่กำหนดไว้บนเว็บไซต์ซึ่งซึ่ | จะช่วยใ ช่ | ห้การทานยาเป็นไปอย่างแม่นยำ
มากขึ้น และยังออกแบบมาเพื่อให้ผู้ใช้และ ช้ | ผู้ดูแลสามารถตรวจสอบการ
ทำงานของเครื่องได้จากประวัติที่บันทึกไว้ในระบบอย่างละเอียด ในด้านการออกแบบทางเทคนิค เครื่องจ่ายยาอัจฉริยะใช้ไมโคร ช้ คอนโทรลเลอร์ESP32 เพียงบอร์ดเดียวในการประมวลผลและควบคุม
จานยาสามชุด เมื่อถึงเวลาที่กำหนดไว้ เครื่องจะส่งเส่ | สียงเ สี | ตือนและแสดง
รายการยาเพื่อให้ผู้สูงอายุรับทราบ หลังจากนั้น ผู้ใช้เช้ | พียงแค่กดปุ่มรับยา
เพื่อเริ่มกลไกการจ่ายยา โดยระบบจะใช้เลเซอ ช้ | ร์ในการตรวจนับเม็ดยาที่
ผ่านทางออกเพื่อความแม่นยำ ผลการจ่ายยาและสถานะต่างๆ จะถูกส่งกส่ | ลับ
ไปยังเซิร์ซิ | ฟเวอร์นอกจากนี้ ระบบยังถูกออกแบบมาให้รองรับเหตุสุดวิสัย สั
โดยหากเครือข่ายขัดข้องระหว่างใช้งาน เค ช้ | รื่องยังสามารถใช้ตาราง ช้ | ของวัน
ที่รับไว้ในหน่วยความจำเพื่อทำงานต่อไปได้อย่างต่อเนื่อง และจะรอส่งส่ เหตุการณ์การจ่ายยาไปยังเซิร์ซิ ฟเวอร์ในภายหลังเมื่อเครือข่ายกลับมาเป็น ปกติ

### 1.2 วัตถุประสงค์

1. เพื่อออกแบบต้นแบบเครื่องจ่ายยาสามช่องช่ ที่ควบคุมด้วย ESP32 และรับตารางจากเว็บไซต์
2. เพื่อพัฒนาการเตือน การรับยา การเลื่อนเตือน และการบันทึกผล ของแต่ละรอบยา
3. เพื่อใช้เช้ | ซ็นเซอ ซ็ | ร์IR ตรวจนับยาและจัดการกรณีจ่ายไม่ครบหรือ
เซ็นเซอ ซ็ | ร์ถูกบัง
4. เพื่อทดสอบตรรกะการทำงานร่วมกันของกลไก ตารางเวลา และการ
สื่อสาร สื่ | กับเซิร์ซิ | ฟเวอร์

### 1.3 ขอบเขตของโครงงาน

จากข้อมูลในภาพ โครงงานเครื่องจ่ายยาอัจฉริยะได้กำหนดขอบเขตการ ทำงานและคุณสมบัติของระบบไว้ดังรายละเอียดต่อไปนี้ครับ:

- ความจุและการตั้งค่ารอบการจ่ายยา: ตัวเครื่องออกแบบมาให้รองรับการ
แยกบรรจุยาได้ทั้งหมด 3 ช่อง โ ช่ | ดยแต่ละช่องสา ช่ | มารถบรรจุยาได้1 ชนิด
ระบบสามารถรองรับการตั้งเวลาจ่ายยา
- ปริมาณการจ่ายยาต่อครั้ง: สามารถกำหนดคำสั่งใสั่ ห้เครื่องจ่ายยาได้ครั้งละ

โดยทำงานตามค่าที่ถูกกำหนดไว้ใน Firmware

- กลไกการจ่ายยา: ระบบสามารถทำการจ่ายยาได้พร้อมกันสูงสุด 2 ช่อง ช่
ในกรณีที่มีการสั่งสั่ | จ่ายยาจากช่องช่ | ที่ 3 ระบบจะให้ช่องช่ | ที่เหลืออยู่ในสถานะ
รอคิวเพื่อจ่ายยาในลำดับถัดไป
- ระบบติดตามและรายงานผล: ตัวเครื่องมีระบบสำ หรับรายงานสถานะการ
จ่ายยา ซึ่งจะ ซึ่ | ช่วช่ | ยตรวจสอบและรายงานผลให้ทราบว่าผู้ใช้ไช้ | ด้รับประทาน
ยาในรอบนั้นๆ แล้วหรือไม่
- การตั้งค่าเครื่องก่อนใช้งาน ช้ | (Calibration): เพื่อความแม่นยำและ
ป้องกันข้อผิดพลาด ก่อนที่จะเริ่มใช้งานโห ช้ | มดกลไกจริง จะต้องมีการ
Calibration ค่าต่างๆ ที่สำ คัญ ได้แก่ การตั้งค่าขนาดของเม็ดยา การ กำหนดตำแหน่งของจานยา และค่าขับมอเตอร์

บทที่ 2 เอกสารและเทคโนโลยีที่เกี่ยวข้อง

### 2.1 ไมโครคอนโทรลเลอร์ESP32

ESP32 เป็นศูนย์กลางของระบบ ทำหน้าที่เชื่อมชื่ | ต่อ Wi-Fi รับข้อมูลจาก
เซิร์ซิ | ฟเวอร์ ประมวลผลตารางยา และควบคุมอุปกรณ์ผ่านขา GPIO โครง
งานกำหนดผังขาสำ หรับบอร์ด ESP32 DevKit หรือ ESP32-WROOM-32
แบบดั้งเดิม และใช้ในการ ช้ | สั่งสั่ | จานยา

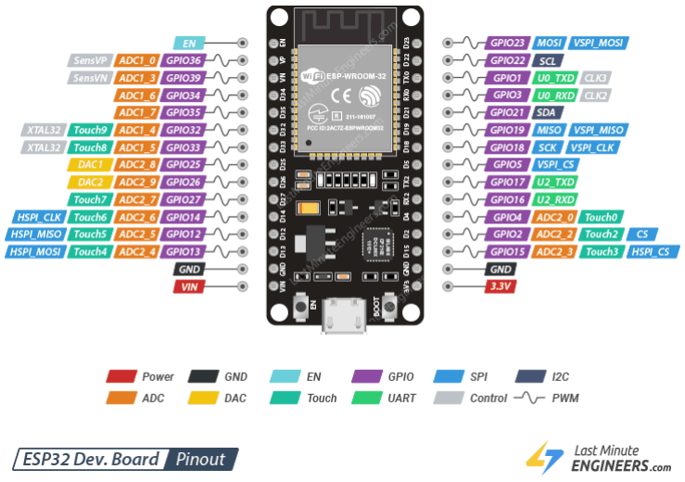
[picture p36: figure]

2.2 นาฬิกฬิ | า DS1307 และจอ LCD
ระบบอ่านเวลาจาก DS1307 ผ่านบัส I²C และปรับเวลาจากข้อมูล
เซิร์ซิ | ฟเวอร์จอ LCD ขนาด 16×2 ใช้แสดง ช้ | วันที่และเวลา ส่วนส่ | จอ 20×4
แสดงรายการยาและคำแนะนำปุ่ม ค่าเริ่มต้นของที่อยู่ I²C คือ 0x25 และ
0x27 ตามลำดับ ชื่อยา ชื่ | บนจอใช้อัช้ | กษภาษาอังกถษตามรูปแบบข้อมูลที่
เซิร์ซิ | ฟเวอร์ส่งมา ส่

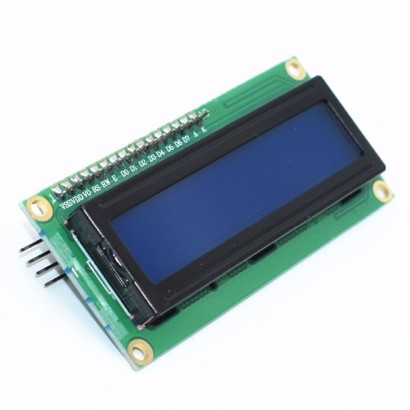
[picture p37: figure]
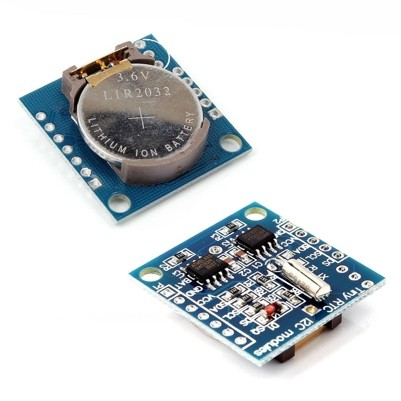
[picture p38: figure]

### 2.3 เซอร์โวมอเตอร์และมอเตอร์สั่นสั่

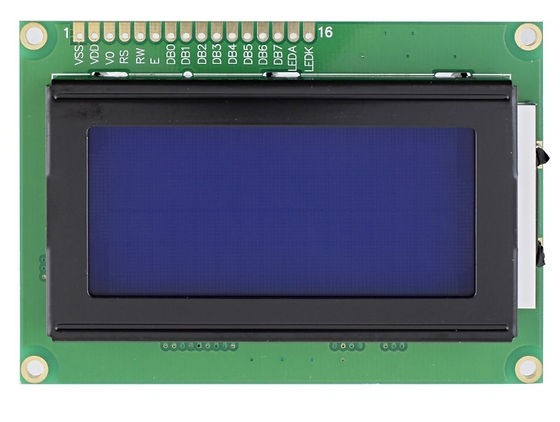
[picture p39: figure]

กลไกแต่ละช่องประกอ ช่ | บด้วยเซอร์โวมอเตอร์ขับจานและมอเตอร์สั่นสั่
ช่วยใ ช่ | ห้เม็ดยาเคลื่อนผ่านทางออก โปรแกรมกำหนดตำแหน่งพักและ
ตำแหน่งปล่อยด้วยความกว้างพัลส์ จึงต้องใช้ค่ ช้ | าที่สอบเทียบกับเซอร์โว
และจานจริง มอเตอร์สั่นสาม สั่ | ตัวควบคุมผ่าน DRV8833 สองบอร์ด โดยใช้
เอาต์พุตสามช่องช่ | จากสี่ช่สี่ | องช่ | ที่มี

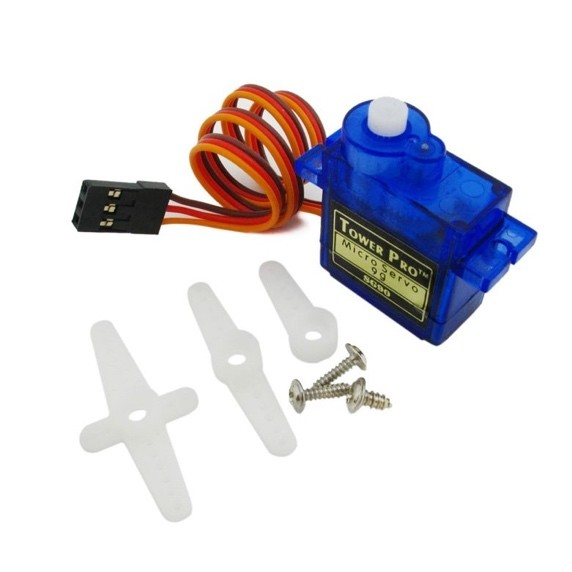
[picture p40: figure]
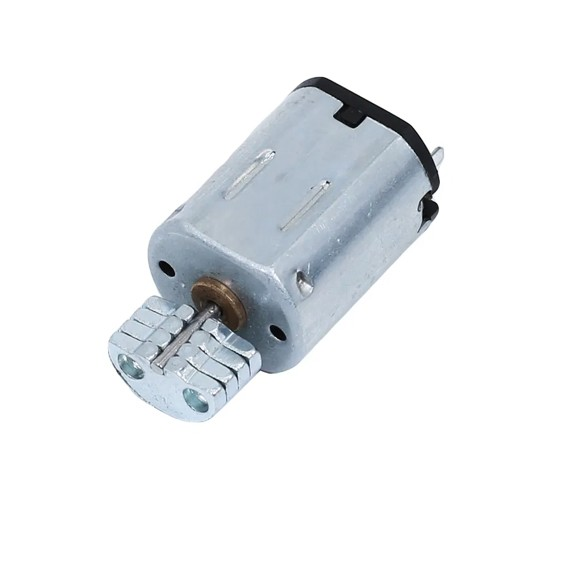
[picture p41: figure]

2.4 เลเซอร์สีแดง สี | สำ หรับตรวจนับเม็ดยา
แต่ละจานมีLaser Head Transmitter Sensor + Laser receiver
module 1 คู่ โปรแกรมจะมีช่วงช่ | พักการนับ 60 มิลลิวินาที เพื่อลดการนับซ้ำ
นับเฉพาะ ช่องช่ | ที่เริ่มจ่ายแล้ว และหยุดเมื่อครบจำนวนที่สั่ง สั่ | ถ้าเซ็นเซอ ซ็ | ร์ถูก
บังก่อนเริ่ม ระบบจะปฏิเสธการเริ่มจ่ายช่องช่ | นั้น การตรวจจับในซอฟต์แวร์ยัง
ต้องประเมินกับระยะ ติดตั้ง แสงแวดล้อม และรูปร่างเม็ดยาจริง


2.5 การสื่อสสื่ | ารผ่านเครือข่ายและ API
ESP32 เป็นฝ่ายร้องขอข้อมูลจากเซิร์ซิ | ฟเวอร์เป็นระยะ โดยปกติทุก 60
วินาที การร้องขอ GET /api/device/sync ใช้รัช้ | บเวลา ตารางยาของวัน
ปัจจุบัน และคำสั่งสั่ | ที่รอดำเนินการ ส่วน ส่ | POST /api/device/events ใช้ส่ช้ | งส่
ผลกลับ การตอบรับคำสั่งเสั่ | ริ่มจ่ายและผลการจ่ายเสร็จเป็นคนละขั้นตอน จึง
ต้องติดตามผลจากเหตุการณ์ที่เครื่องรายงาน
เฟิร์มแวร์รองรับ URL แบบ HTTP และ HTTPS เมื่อใช้ HTTPS จะตรวจ ใบรับรองตามค่าที่เปิดไว้ใน config.h การยืนยันตัวตนของอุปกรณ์ใช้ API
key เฉพาะเครื่อง ส่วนเ ส่ | ว็บไซต์ใช้บัช้ | ญชีผู้ ชี | ใช้และ ช้ | JWT ข้อมูลรหัสผ่านและ
กุญแจของอุปกรณ์ไม่ควรปรากฏในรายงานหรือภาพตัวอย่าง

### 2.6 เว็บไซต์และฐานข้อมูล

ส่วนเ ส่ | ว็บไซต์ใช้ React และ TypeScript ส่วนส่ | บริการฝั่งเซิร์ซิ | ฟเวอร์ใช้
NestJS และ Prisma เชื่อมชื่ | ต่อ PostgreSQL โครงสร้างข้อมูลหลักประกอบ
ด้วยบัญชีผู้ ชี | ใช้ อุปกรณ์ช่องยา รายการยา ตารางเวลา ประ ช่ | วัติผลการจ่าย
และคำสั่งสั่ | อุปกรณ์ข้อมูลเหล่านี้ทำให้การตั้งตารางและตรวจสอบผลผูกกับ
อุปกรณ์และ เจ้าของข้อมูลหรือ account ที่สร้าง

### 2.7 การทำงานแบบสถานะและการเก็บข้อมูลถาวร

โปรแกรมแยกสถานะรอบยา เช่น รอเวลา เ ช่ | ตือน เลื่อนเตือน รอคิว
กำลังจ่าย สำ เร็จ ข้าม ขาดรอบ และ ล้มเหลว การควบคุมเซอร์โวเปลี่ยน สถานะตามเวลาโดยไม่ใช้การห ช้ น่วงรอในขั้นตอนการเคลื่อนที่ ทำให้loop หลักตรวจปุ่มและอัปเดตหน้าจอต่อได้
Flash/NVS ใช้เช้ | ก็บค่าตั้งเครือข่าย คิวเหตุการณ์ และคำสั่งสั่ | ที่รับจาก
website ไว้แล้ว การจองรหัสคำสั่งสั่ | (Command ID) ก่อนเริ่ม เพื่อช่วยลด ช่
การทำซ้ำ เมื่อคำสั่งสั่ | ถูกส่งให ส่ | ม่หรืออุปกรณ์เริ่มทำงานใหม่ ถ้าจองรายการไม่
ได้ ระบบจะไม่เริ่มกลไก การเก็บคิวเหตุการณ์มีขนาดจำกัดจึงต้องสั่งสั่ | ล้างคิว
เก่า และมีการเตือนเมื่อเน็ตดับนานเกินไป

บทที่ 3 อุปกรณ์และการออกแบบพัฒนาระบบ

### 3.1 วัสดุและอุปกรณ์

ลำ ดับ | อุปกรณ์ | จำนว น | หน้าที่
1 | ESP32 DevKit / WROOM-32 | 1 | ควบคุมและเชื่อชื่ มต่อเครือ ข่าย
2 | RTC DS1307 พร้อมถ่าน | 1 | รักษาเวลา
3 | LCD I²C 16×2 | 1 | แสดงวันและเวลา
4 | LCD I²C 20×4 | 1 | แสดงรอบยาและสถานะ
5 | เซอร์โวมอเตอร์270 องศา | 3 | จ่ายยา
6 | มอเตอร์สั่นสั่ | 3 | ช่วช่ ยให้ยาเคลื่อนผ่าน ทางออก
7 | DRV8833 | 2 | ขับมอเตอร์สั่นสา สั่ มช่องช่
8 | เซ็นเ ซ็ ซอร์IR | 3 | ตรวจนับยาแยกแต่ละช่องช่
9 | ปุ่มกด เขียว เหลือง แดง | 1 | ทำการรับยาหรือควบคุม ระบบ
10 | LED เขียว เหลือง แดง | 1 | แสดงสถานะ รับยา เลื่อน เตือน และข้าม
11 | Buzzer | 1 | แจ้งเตือนด้วยเสียงสี
12 | Logic Level Conversion Module 3.3V-5V, 5V-3.3V | 1 ชุด | แปลงแรงดันจาก 5v เป็น 3.3v
13 | Adapter ฟิวส์ และ ส์ แหล่ง เก็บประจุ | 1 ชุด | จ่ายไฟและควบคุมไฟหลัก
14 | จานยา ตัวกล่อง และ ทางออก | 1 ชุด | โครงสร้างตัวเครื่อง

ลำ ดับ | อุปกรณ์ | จำนว น | หน้าที่
15 | สายไฟ ขั้วต่อ และอุปกรณ์ ประกอบ | ตามที่ ใช้ | ติดตั้งและเชื่อชื่ มต่อวงจร

เครื่องมือพัฒนาซอฟต์แวร์
ใช้ Arduino IDE หรือเครื่องมืออัปโหลดของโครงงานสำ หรับ ESP32 พร้อม ESP32Servo, ArduinoJson, LiquidCrystal_I2C, TimeLib และ
DS1307RTC และใช้ภาษา ช้ | Python เรียกคอมไพเลอร์C++ แล้วลอง
รันทดสอบบนบอร์ด ESP32 จำลอง เพื่อเช็กช็ | ว่าเงื่อนไขการทำงานถูกต้อง
หรือไม่

### 3.2 โครงสร้างระบบและการเชื่อมชื่ ต่อ


รูปภาพที่ 1 โครงสร้างการทำงานของเครื่องจ่ายยาอัจฉริยะ

อุปกรณ์หรือสัญญาณ สั | GPIO ของ ESP32
I²C SDA และ SCL | 21 และ 22
Servo จาน 1 / 2 / 3 | 18 / 19 / 23
มอเตอร์สั่น สั่ PWM จาน 1 / 2 / 3 | 13 / 26 / 4
มอเตอร์สั่น สั่ DIR จาน 1 / 2 / 3 | 16 / 17 / 14
เลเซอร์ จาน 1 / 2 / 3 | 34 / 35 / 36
Button เขียว / เหลือง / แดง | 33 / 32 / 27
LED เขียว / เหลือง / แดง | 25 / 02 / 05
Buzzer | 15
จอทั้งสองและโมดูล RTC เชื่อมชื่ | | ต่อผ่านบัส I
| | 2
C ร่วมกัน ส่วนเซอ ส่ | ร์โว
มอเตอร์สั่น และเซนเซอ สั่ | ร์IR ให้แยกต่อเข้าขาของ ESP32 ตามการควบคุม
ของแต่ละจาน โดยฝั่งกลไกอย่างมอเตอร์และเซอร์โวต้องใช้แหช้ | ล่งจ่ายไฟ
แยกภายนอกที่จ่ายกระแสได้เพียงพอ ไม่ดึงไฟตรงจากขาลูกของบอร์ด
ควบคุมเพื่อป้องกันไฟตกหรือชิปเ ชิ | สียหาย สี | พร้อมทั้งต้องต่อสายกราวค์ของ

แหล่งจ่ายไฟเข้ากับ GND ของ ESP32 ร่วมกันเพื่อให้ระบบทำงานและส่งส่ สัญญา สั ณคุยกันได้อย่างถูกต้อง

### 3.3 การออกแบบกลไกและการนับเม็ดยา

ชุดจ่ายแต่ละช่องเ ช่ | ริ่มจากตำแหน่งพัก เมื่อรับคำสั่งสั่ | ที่ผ่านการตรวจสอบ
แล้ว โปรแกรมสั่งเซอ สั่ | ร์โวไปตำแหน่งปล่อย กลับตำแหน่งพัก และสั่นสั่ | ต่อ
เพื่อช่วยใ ช่ | ห้ยาผ่านทางออก ลำดับสถานะคือ | Idle → WaitingStart →
Releasing → Returning → Shaking | แล้วตรวจว่าจะทำรอบต่อหรือสิ้นสิ้
สุด หมุนตามขนาดยาจากเว็บก่อน เรื่องแปรง


รูปภาพที่ 2 ลำดับการรับรอบยาและบันทึกผลการทำงาน
ระบบจะใช้อุ ช้ | ปกรณ์เลเซอร์โมดูล KY-008 ยิงลำแสงเข้าหาตัวรับ เพื่อ
ตรวจจับและนับจำนวนเม็ดยาที่ตกผ่านลำแสงจนครบตามคำสั่ง ในกร สั่ | ณีที่
เม็ดยายังตกไม่ตัดลำแสงจนครบจำนวน เครื่องจะทำการหมุนจ่ายยาซ้ำ โดย
อัตโนมัติสูงสุด 10 รอบ พร้อมส่งสส่ | รุปข้อมูล (ได้แก่ จำนวนที่นับได้,
จำนวนที่สั่ง และส สั่ | ถานะการยกเลิก) กลับไปประเมินผล หากพยายามครบ
10 รอบแล้วยายังออกมาไม่ครบ ระบบจะเริ่มกระบวนการจ่ายยาใหม่อีกครั้ง
โดยขยับไปใช้ช่ช้ | องช่ | ที่มีขนาดรูใหญ่ขึ้น และหากพยายามจนครบทั้ง 4 ช่องช่
แล้วยังไม่สำ เร็จ ระบบจะส่งรายงานส ส่ | ถานะไปยังเซิร์ซิ | ฟเวอร์ว่าล้มเหลว
(FAILED)

ระบบสามารถหมุนจานจ่ายยาพร้อมกันได้สูงสุด 2 ช่อง โดยเ ช่ | ว้นระยะ
เริ่มช่องช่ | ถัดไป 250 มิลลิวินาทีเพื่อป้องกันไม่ให้มอเตอร์ดึงกระแสไฟสูง

พร้อมกัน

### 3.4 ตารางยา ปุ่มกด และหน้าจอ

เว็บไซต์เป็นแหล่งกำหนดตารางยา เครื่องรับเฉพาะตารางของวัน
ปัจจุบันและใช้สช้ | ถานะรายมื้อควบคุมการเตือน การรับข้อมูลใหม่ใช้พื้ ช้ | นที่พัก
ก่อนนำมาใช้จช้ | ริง เพื่อไม่ให้ข้อมูลที่รับไม่ครบทำลายตารางที่กำลังใช้งาน ช้
และคงสถานะของรายการเดิมระหว่างการซิงซิ | ก์
การใช้งาน ช้ | พฤติกรรมของระบบ
ปุ่มเขียว กดสั้นแสั้ ล้วปล่อย | จ่ายยามื้อนั้น และจัดการคิวช่องยา ช่
ปุ่มเขียว กดค้าง 3 วินาที | เปิดหน้าตั้งค่า Wi-Fi เมื่อกลไกว่าง
ปุ่มเหลือง ขณะมีการเตือน | เลื่อน 5 นาที ไม่เกิน 3 ครั้ง
ปุ่มเหลือง ขณะปกติ | ร้องขอซิงซิ ก์ตารางใหม่
ปุ่มแดง กดสั้นสั้ | ข้ามมื้อที่กำลังเตือน
ปุ่มแดง กดค้างอย่างน้อย 1.2 วินาที | ยุติการทำงานและหยุดส่ง ส่ PWM
ไม่มีการรับยาภายในเวลาผ่อน ผัน | เปลี่ยนเป็น MISSED ค่าเริ่มต้น 30 นาที

การแสดงผล
จอเล็กแสดงวันและเวลา จอใหญ่แสดงเฉพาะรอบถัดไป โดยบรรทัดที่ 1–3 เป็นรายการยาแต่ละช่องและ ช่ จำนวนเม็ด บรรทัดที่ 4 เป็นเวลาของรอบ หรือคำแนะนำปุ่ม เมื่อจัดการรอบเสร็จจึงเปลี่ยนไปแสดงรอบต่อไป ตัวอย่างข้อความบนจอ
| 1 MedicineA x2 2 MedicineB x1
| 3 MedicineC x1

Next 08:00 2 items//จอจริง

ชื่อและ ชื่ จำนวนข้างต้นเป็นเพียงตัวอย่างหน้าจอ การกำหนดรายการจริง ทำบนเว็บไซต์

### 3.5 เว็บไซต์และการแลกเปลี่ยนข้อมูล

ผู้ใช้สามาร ช้ | ถเข้าสู่ระสู่ | บบเพื่อจัดการรายการยา กำหนดเวลาของแต่ละ
ช่อง และตรว ช่ | จสอบประวัติได้อุปกรณ์จะรับคำสั่งสั่ | จากเซิร์ซิ | ฟเวอร์ด้วยการ
ร้องขอข้อมูลเป็นระยะ ซึ่งซึ่ | ทำให้มีช่วงเวลารอ ช่ | ก่อนที่คำสั่งสั่ | จากเว็บไซต์จะ
เดินทางมาถึงตัวเครื่อง
องค์ประกอบข้อมูล | บทบาทในโครงงาน
User และ Device | บัญชี เชี จ้าของอุปกรณ์ และตัวตนของ เครื่อง
Compartment และ Medication | ช่องยาและรายละเ ช่ อียดรายการยา
Schedule | เวลาและรูปแบบการตั้งรอบยา
IntakeLog | ผลที่บันทึกจากการทำงานของเครื่อง
DeviceCommand | คำสั่งสั่ จ่ายและสถานะการดำเนินการ
DeviceSetupSession | การตั้งค่าและจับคู่อุปกรณ์กับบัญชี
ลำดับการรับและส่งส่ | ข้อมูล
1. ส่งส่ | คำขอปรับปรุงข้อมูล (Sync Request): ไมโครคอนโทรลเลอร์
ESP32 จะส่งส่ | คำขอไปยังเซิร์ซิ | ฟเวอร์เพื่ออัปเดตข้อมูล พร้อมทั้งแนบข้อมูล
การยืนยันตัวตนและเวอร์ชันชั | ของเฟิร์มแวร์ประจำเครื่อง
2. ตอบกลับข้อมูลจากเซิร์ซิ | ฟเวอร์(Server Response): เซิร์ซิ | ฟเวอร์จะ
ตอบกลับข้อมูลเวลาปัจจุบัน ตารางยาประจำวัน และรายการคำสั่งสั่ | ที่รอ
ดำเนินการ จากนั้นระบบจะทำการตรวจสอบความถูกต้องของข้อมูลก่อนนำ ไปประมวลผลใช้งาน ช้
3. การบันทึกเหตุการณ์การทำงาน (Event Logging): เมื่อกลไก
ดำเนินการจ่ายยาเสร็จสิ้น ระ สิ้ | บบจะทำการสร้างข้อมูลเหตุการณ์(Event)
โดยระบุรหัสอ้างอิงเฉพาะ (Event ID) หมายเลขช่องยา ช่ | จำนวนเม็ดยา
สถานะการทำงาน และตราเวลา (Timestamp) ที่เกิดขึ้น

4. การส่งรายงานและล ส่ | บคิวข้อมูล (Report Submission & Queue
Clearing): ระบบจะส่งรายงานเห ส่ | ตุการณ์กลับไปยังเซิร์ซิ | ฟเวอร์ เมื่อ
เซิร์ซิ | ฟเวอร์บันทึกข้อมูลเรียบร้อยแล้ว อุปกรณ์จะทำการลบรายการดังกล่าว
ออกจากคิวในหน่วยความจำ ทั้งนี้ การใช้นานร ช้ | หัสอ้างอิงเฉพาะจะช่วยช่
ป้องกันการบันทึกประวัติซ้ำ ซ้อนในฐาน ซ้ | ข้อมูลกรณีที่มีการส่งส่ | ข้อมูลซ้ำ
ความหมายของผลที่ส่งส่ | กลับ
- DISPENSED DISPENSED: หมายถึงระบบประเมินว่าการจ่ายยา สำ เร็จตามโหมดที่ใช้งาน ช้
- MISSED: หมายถึงพ้นกำหนดเวลาผ่อนผัน
- SKIPPED: หมายถึงผู้ใช้เช้ ลือกกดข้ามรอบยานั้น
- FAILED: หมายถึงการจ่ายยาไม่สำ เร็จหรือมีข้อขัดข้องเกิดขึ้น
- Dry Run: ระบบจะแนบข้อความ dry run เพื่อแยกแยะออกจากการ จ่ายยาด้วยกลไกจริง และการที่ระบบรายงานว่าจ่ายยาสำ เร็จยังไม่ เท่ากับการยืนยันว่าผู้ป่วยได้ทำการรับประทานยาจริง

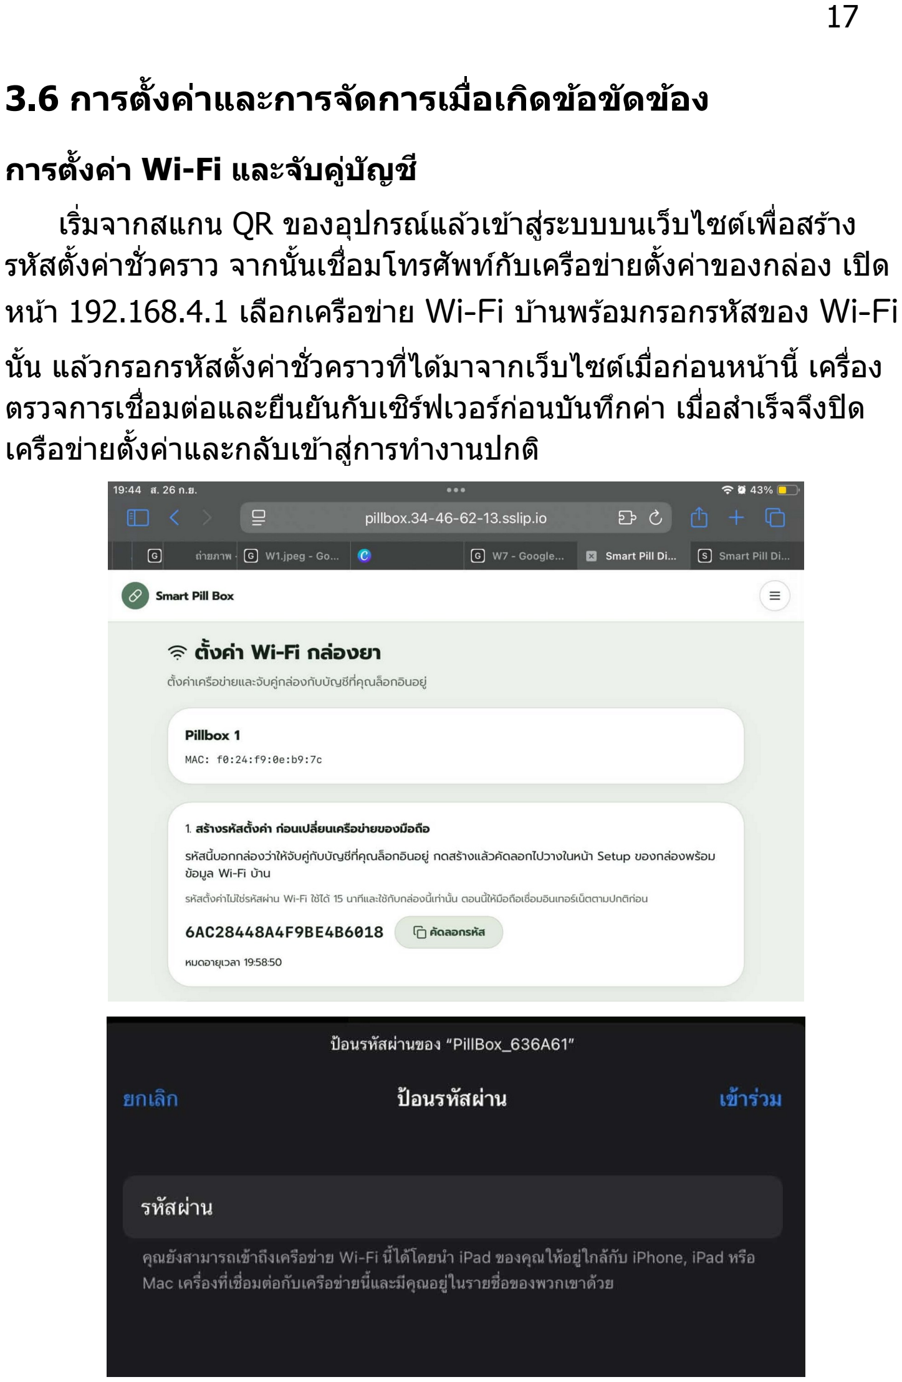
[picture p42: page 21]

### 3.6 การตั้งค่าและการจัดการเมื่อเกิดข้อขัดข้อง

การตั้งค่า Wi-Fi และจับคู่บัญชี
เริ่มจากสแกน QR ของอุปกรณ์แล้วเข้าสู่ระสู่ | บบบนเว็บไซต์เพื่อสร้าง
รหัสตั้งค่าชั่วคชั่ | ราว จากนั้นเชื่อมโ ชื่ | ทรศัพศั | ท์กับเครือข่ายตั้งค่าของกล่อง เปิด
หน้า 192.168.4.1 เลือกเครือข่าย Wi-Fi บ้านพร้อมกรอกรหัสของ Wi-Fi
นั้น แล้วกรอกรหัสตั้งค่าชั่วคชั่ | ราวที่ได้มาจากเว็บไซต์เมื่อก่อนหน้านี้ เครื่อง
ตรวจการเชื่อมชื่ | ต่อและยืนยันกับเซิร์ซิ | ฟเวอร์ก่อนบันทึกค่า เมื่อสำ เร็จจึงปิด
เครือข่ายตั้งค่าและกลับเข้าสู่การ สู่ | ทำงานปกติ

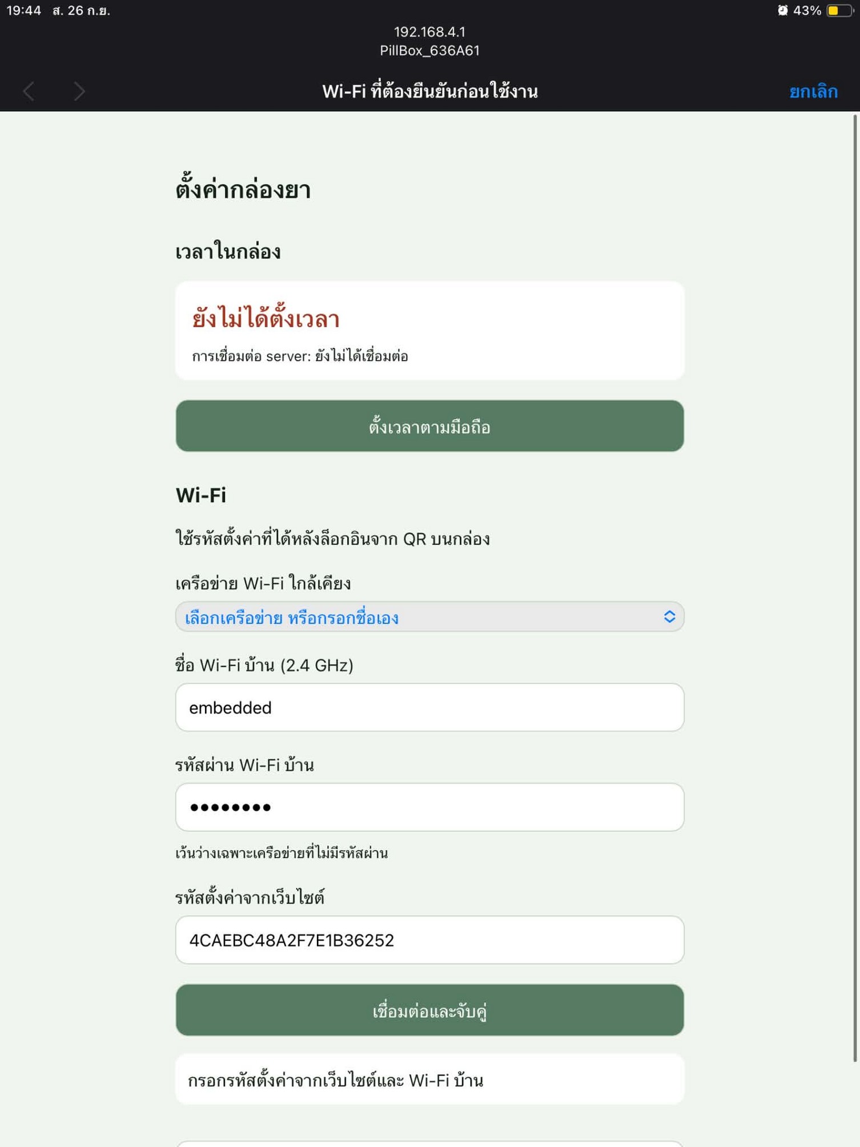
[picture p43: figure]

กรณีต้องเปลี่ยนเครือข่าย ผู้ใช้กดช้ ปุ่มเขียวค้างสามวินาทีขณะกลไกว่าง ระหว่างตั้งค่าระบบพักการจ่ายและการเตือน การหลุดจากเราเตอร์ชั่วคราว ชั่ ไม่ลบรหัสผ่านเดิม
การทำงานเมื่อเครือข่ายขัดข้อง
หากอินเทอร์เน็ตหลุด อุปกรณ์ยังแจ้งเตือนและจ่ายยาตามตารางที่
โหลดไว้ได้ โดยต้องมีตารางยาในเครื่องและนาฬิกา ฬิ | RTC ใช้งานไ ช้ | ด้ ประวัติ
ผลการจ่ายจะบันทึกรอส่งไส่ | ว้ในคิว NVS ซึ่งเซึ่ | ก็บได้สูงสุด 12 รายการ หากมี

รายการใหม่เข้ามาตอนคิวเต็ม ระบบจะลบรายการเก่าสุดทิ้ง จึงอาจทำให้ ประวัติการจ่ายยาบางส่วนส่ สูญหายได้ครับ การเริ่มเครื่องใหม่และการป้องกันการจ่ายซ้ำ
เมื่อเปิดเครื่อง ESP32 จะอ่านตารางยาที่ cache ไว้และรายการมื้อที่
จบแล้วจาก NVS หาก RTC ใช้งานไ ช้ | ด้และข้อมูล cache ถูกต้อง เครื่อง
สามารถกลับมาใช้ตาราง ช้ | ของวันนั้นได้โดยไม่ต้องรออินเทอร์เน็ต
ก่อนนำมื้อยาตามตารางเข้าคิวจ่าย ระบบจะบันทึกกุญแจของมื้อนั้นลง
journal ใน NVS เพื่อกันการสั่งสั่ | ซ้ำ | ส่วนส่ | คำสั่งสั่ | จาก server จะใช้ Command
ID บันทึกแยกกัน หากไฟดับระหว่างจ่าย ระบบจะไม่เริ่มมื้อนั้นซ้ำ เอง แต่ การบันทึกนี้ไม่ได้ยืนยันว่าจ่ายยาออกมาครบหรือออกมาแล้วจริง ผู้ใช้จึช้ ง ควรตรวจสอบยาในกรณีไฟดับระหว่างทำงานครับ

บทที่ 4 ผลการดำเนินงาน

### 4.1 ผลทดสอบซอฟต์แวร์

วันที่ 25 กันยายน 2569 ได้รันชุดทดสอบเฟิร์มแวร์ในโฟลเดอร์tests
ด้วยคำสั่ง สั่ | unittest discover
ผลคือผ่าน 13 รายการ ใช้เวลาประมา ช้ | ณ 24.3 วินาที การทดสอบใช้คอม ช้
ไพเลอร์C++ และอุปกรณ์จำลองบนคอมพิวเตอร์
กลุ่มตรวจสอบ | จำนวน รายการ | ผล
การส่งส่ คำสั่งและ สั่ ทะเบียนป้องกันซ้ำ | 2 | ผ่าน
การควบคุมกลไกจ่ายยา | 1 | ผ่าน
ไวยากรณ์เฟิร์มแวร์และตัวอย่าง | 1 | ผ่าน
โปรไฟล์ฮาร์ดแวร์และเงื่อนไขสอบเทียบ | 1 | ผ่าน
การเลื่อนข้อความ LCD | 1 | ผ่าน
การทำงานร่วมกันของรอบยา | 1 | ผ่าน
การตั้งค่าขณะทำงานและปุ่ม | 2 | ผ่าน
การจัดการตารางยา | 1 | ผ่าน
นาฬิกาฬิ ซอฟต์แวร์ | 1 | ผ่าน
การตั้งค่าและค่าเครือข่ายเริ่มต้น | 2 | ผ่าน
รวม | 13 | ผ่าน ทั้งหมด

ผลดังกล่าวสนับสนุนว่าตรรกะที่ชุดทดสอบครอบคลุมทำงานตาม
เงื่อนไขที่กำหนด เช่น การ ช่ | จัดคิวรอบยา การตรวจคำสั่งสั่ | ซ้ำ | การเลื่อนเตือน
และการตั้งค่า ผลในตารางนี้เป็นชุดทดสอบของเฟิร์มแวร์เท่านั้น

### 4.2 การประเมินกับเครื่องจริง

การทดลองกับต้นแบบควรบันทึกจำนวนที่สั่งและ สั่ | จำนวนเม็ดที่ออกจริง
แยกกันในแต่ละรอบ พร้อมระบุช่องยา ช่ | รูปร่างเม็ด ระดับยาคงเหลือ และ
สภาพแหล่งจ่าย เพื่อใช้วิช้ | เคราะห์ความคลาดเคลื่อนที่ไม่สามารถพบจาก
อุปกรณ์จำลอง
การทดลอง | สิ่งสิ่ ที่ต้องตรวจและเก็บผล
จ่ายทีละช่องและหลาย ช่ ช่องช่ | จำนวนสั่ง สั่ จำนวนออกจริง เวลาจ่าย และ รายการที่รอคิว
เลเซอร์ถูกบังก่อนเริ่มหรือยา ไม่ตก | การปฏิเสธเริ่มทำงาน จำนวนรอบซ้ำ และสถานะล้มเหลว
ปุ่มรับยา เลื่อน ข้าม และหยุด | สถานะบน LCD เสียงเ สี ตือน และเวลา ตอบสนอง
ตัด Wi-Fi แล้วเชื่อชื่ มใหม่ | การใช้ตารางเ ช้ ดิม คิวเหตุการณ์ และการ ส่งผล ส่ ซ้ำ
ปิดไฟแล้วเปิดใหม่ | การกู้คิว การรับตารางใหม่ และการ ป้องกันคำสั่งสั่ ซ้ำ
ตั้งค่าผ่าน QR และโทรศัพศั ท์ | การเชื่อชื่ มเครือข่าย รหัสผิด รหัสหมด อายุ และการบันทึกค่า

แบบบันทึกผลสำ หรับเติมหลังทดลอง

รอ บ | ช่อช่ ง | สั่ง เ สั่ ม็ด | ออกจริง เม็ด | เวลา วินาที | ผลหรือข้อสังเกต สั
1 | ...... | ...... | ...... | ...... | |
2 | ...... | ...... | ...... | ...... | |
3 | ...... | ...... | ...... | ...... | |
4 | ...... | ...... | ...... | ...... | |
5 | ...... | ...... | ...... | ...... | |

อัตรารอบที่จ่ายครบ = จำนวนรอบที่จ่ายตรงจำนวนและช่อง ช่ ÷ จำนวน รอบทดลองทั้งหมด × 100 โดยรายงานจำนวนรอบทดลองควบคู่กับร้อยละ เสมอ และบันทึกกรณีจ่ายเกิน จ่ายขาด หรือนับคลาดเคลื่อนแยกกัน
ก่อนสรุปผลการใช้งาน ช้ | ต้องเติมข้อมูลจากการทดลองจริงลงในแบบ
บันทึก และแนบภาพต้นแบบ การติดตั้งเซ็นเซอ ซ็ | ร์ และหน้าประวัติที่สัมสั | พันธ์
กับรอบทดลองนั้น

4.3 ค่าใช้จ่ ช้ | ายในการดำเนินงาน
รายการ | จำนวน | ราคาต่อหน่วย บาท | รวม บาท
ESP32 | 1 | 168 | 168
Adabter 5V 5A | 1 | 280 | 280
DS1307 และถ่าน | 1 | 45 | 45
LCD 16×2 | 1 | 73 | 73
LCD 20×4 | 1 | 123 | 123
เซอร์โวจานยา | 3 | 91 | 273
มอเตอร์สั่นสั่ | 3 | 32 | 96
DRV8833 | 2 | 40 | 80
Laser Head Transmitter Sensor + Laser receiver module | 3 คู่ | 50 | 150
ปุ่ม Buzzer และตัวแปลง ระดับสัญญาณ สั | 1 | 7 | 7
ฟิวส์ | 1 | 42 | 42
ตัวเก็บประจุ | 1 | 9 | 9
Push Button Switch Module 3 ปุ่ม 3 สี | 1 | 22 | 22

รายการ | จำนวน | ราคาต่อหน่วย บาท | รวม บาท
LED Module 3 traffic light | 1 | 12 | 12
สายไฟ | 1 ชุด | 100 | 100
จานยา และวัสดุประกอบ | 3 ชุด | 133 | 399
สปริงยึดจานยา | 12 | 7 | 84
ตัวกล่องยา | 1 | 160 | 160
ค่าบริการ google cloud | 1 | 70 | 70
รวมต้นทุนอุปกรณ์ | | | 2,193

ค่าออกแบบและพัฒนาครั้งแรก (NRE Cost)
- การออกแบบวงจรและกลไก 20 ชั่วโมง ชั่ | × 150 บาท = 3,000 บาท
- การพัฒนาเฟิร์มแวร์และเว็บไซต์20 ชั่วโมง ชั่ | × 150 บาท = 3,000

บาท
- การทดสอบและปรับเทียบ 10 ชั่วโมง ชั่ × 150 บาท = 1500 บาท

รวม NRE = 3,000 + 3,000 + 1,500 = 7,500 บาท

ต้นทุนโครงงานรวม = 2,193 (ต้นทุนอุปกรณ์) + 7,500 (NRE) = 9,693 บาท

ค่าใช้จ่ ช้ ายประจำ (Recurring Cost)

ค่าบริการ Google Cloud: โดยอ้างว่า ผู้สูงอายุ 1 คน ยา 3 ชนิด และ

กินสูงสุดวันละ 6 รอบ ประเมินปริมาณใช้งานในเ ช้ | ดือนที่มี30 วัน ประมาณ
70 บาท/เดือนก่อนหักส่วส่ | นลดและเครดิต

บทที่ 5 สรุปผลและข้อเสนอแนะ

### 5.1 สรุปผลการพัฒนา

โครงงานนี้ได้พัฒนาระบบควบคุมเครื่องจ่ายยาโดยใช้ ESP32 ติดต่อ
กับเซิร์ซิ | ฟเวอร์เพื่อรับตารางยา เวลา และคำสั่งสั่ | จ่ายยา พร้อมส่งส่ | ผลการ
ทำงานกลับไปยังเซิร์ซิ | ฟเวอร์ตัวเครื่องมีระบบแจ้งเตือนด้วยเสียง แสดง สี
ข้อมูลบนจอ LCD และรับคำสั่งสั่ | จากปุ่มกดเพื่อจ่ายยา เลื่อนการเตือน หรือ
ยกเลิกมื้อยา
เฟิร์มแวร์จัดการตารางยาและสถานะของแต่ละมื้อ รวมถึงบันทึกสำ เนา
ตารางไว้ใน NVS เพื่อให้โหลดกลับมาใช้ไช้ | ด้เมื่อเปิดเครื่องโดยไม่มี
อินเทอร์เน็ต โดยต้องมีข้อมูลเวลา RTC ที่ใช้งานไ ช้ | ด้ นอกจากนี้ผลการจ่าย
ที่ยังส่งไส่ | ม่ถึงเซิร์ซิ | ฟเวอร์จะถูกเก็บไว้ในคิว NVS เพื่อส่งส่ | ซ้ำ เมื่อการเชื่อมชื่ | ต่อ
กลับมา และมีjournal สำ หรับป้องกันการประมวลผลคำสั่งหสั่ | รือมื้อยาเดิม

ซ้ำ

### 5.2 ข้อจำกัด

ข้อระบบจำกัดการทำงานพร้อมกันไว้ไม่เกิน 2 ช่องตามง ช่ | บกระแสที่
กำหนด และเมื่ออินเทอร์เน็ตหลุด ผลการจ่ายจะรอส่งใน ส่ | คิว NVS ซึ่งเซึ่ | ก็บได้
สูงสุด 12 รายการ หากคิวเต็ม ระบบจะลบรายการเก่าสุดเพื่อบันทึกรายการ
ใหม่ จึงอาจสูญเสียประ สี | วัติบางส่วนไ ส่ | ด้ส่วนตารางยาใ ส่ | ช้แช้ | บบออฟไลน์ได้เมื่อ
มีcache ที่อ่านได้และ RTC ใช้งานไ ช้ | ด้จอ LCD แบบ HD44780 แสดง
ภาษาไทยไม่ได้

### 5.3 แนวทางพัฒนาต่อ

พัฒนาระบบตรวจสอบปริมาณยาในแต่ละช่อง โดยใ ช่ | ห้ผู้ใช้บัช้ | นทึก
จำนวนยาที่เติม และปรับยอดคงเหลือตามจำนวนที่จ่าย เมื่อยาใกล้หมด หรือถึงจำนวนครั้งที่กำหนด ระบบจะแจ้งเตือนให้เติมยา เพื่อช่วยลดโอกาส ช่ ที่ยาจะหมดโดยไม่รู้ตัว
เพิ่มระบบแจ้งเตือนผู้ดูแลผ่านแอปหรือ LINE เมื่อผู้ใช้ไช้ | ม่กดรับยา
ภายในเวลาที่กำหนด การจ่ายยาไม่สำ เร็จ อุปกรณ์ขาดการเชื่อมชื่ | ต่อเป็น

เวลานาน หรือมีประวัติการจ่ายยาค้างส่ง เ ส่ พื่อให้ผู้ดูแลติดตามและช่วยช่ เหลือได้ทันท่วงทีครับ
