Comxt-i/smart-pill-dispenser/output/imagegen/system-architecture.png

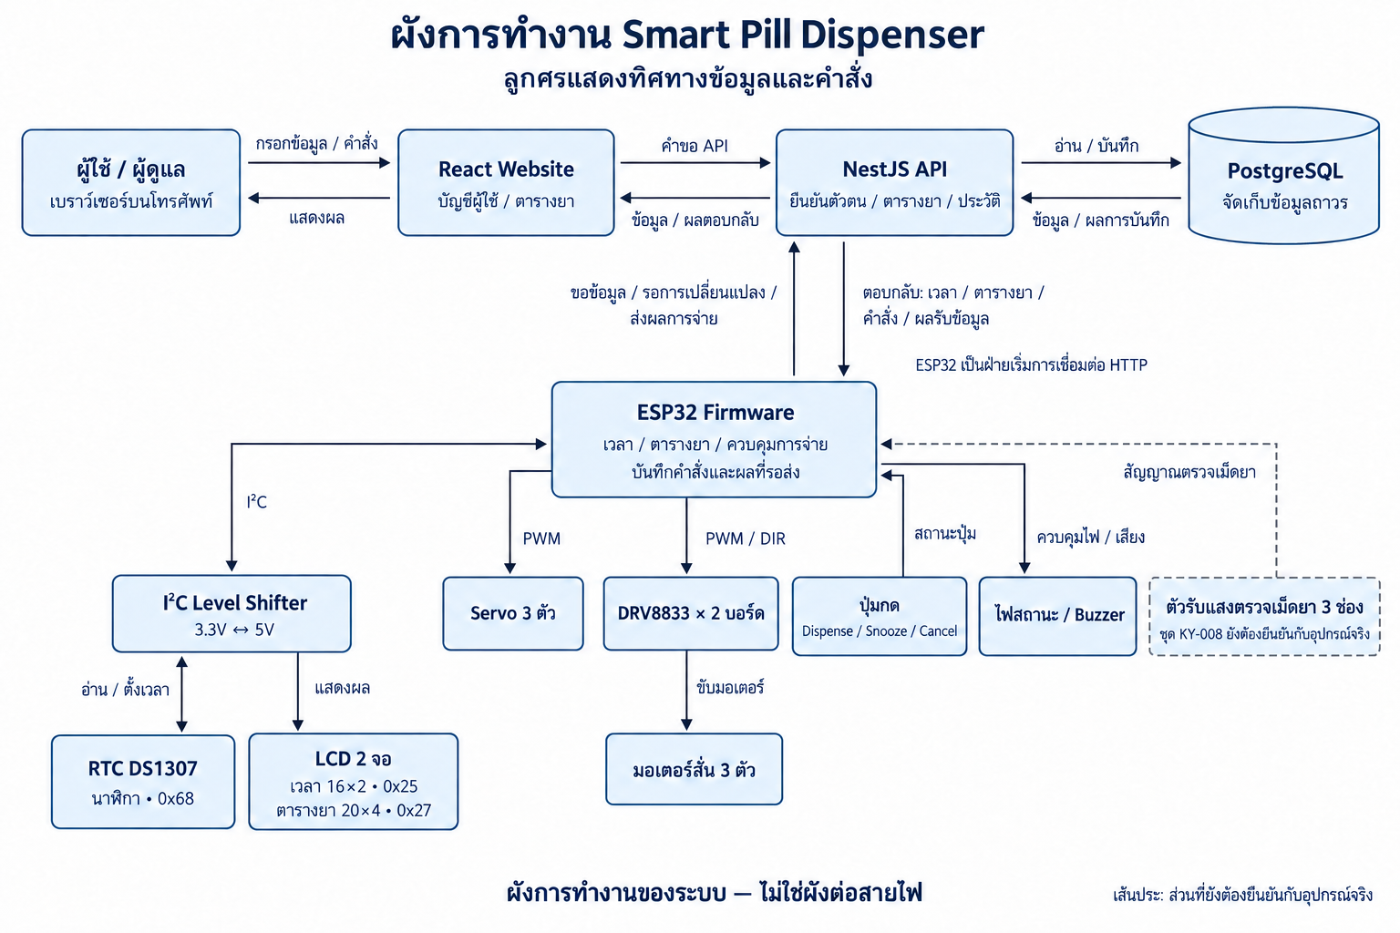
output/imagegen/system-architecture.png
