Comxt-i/smart-pill-dispenser/output/qa/architecture.png

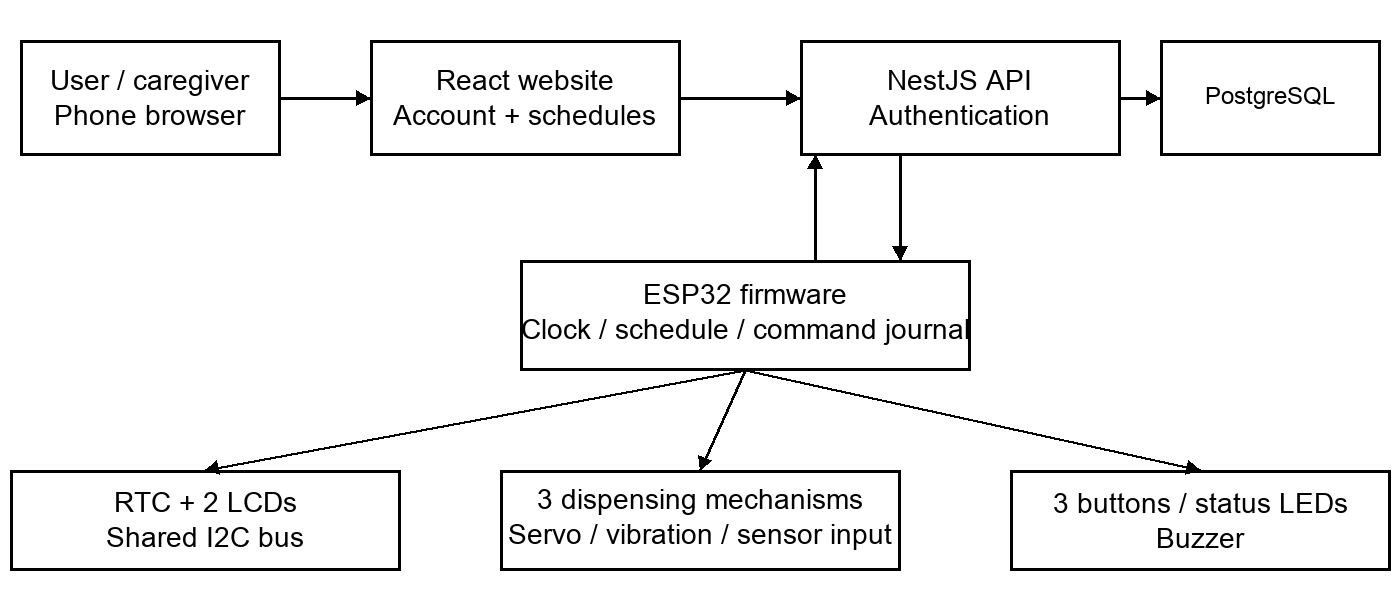
output/qa/architecture.png
