Comxt-i/smart-pill-dispenser/output/qa/setup.png

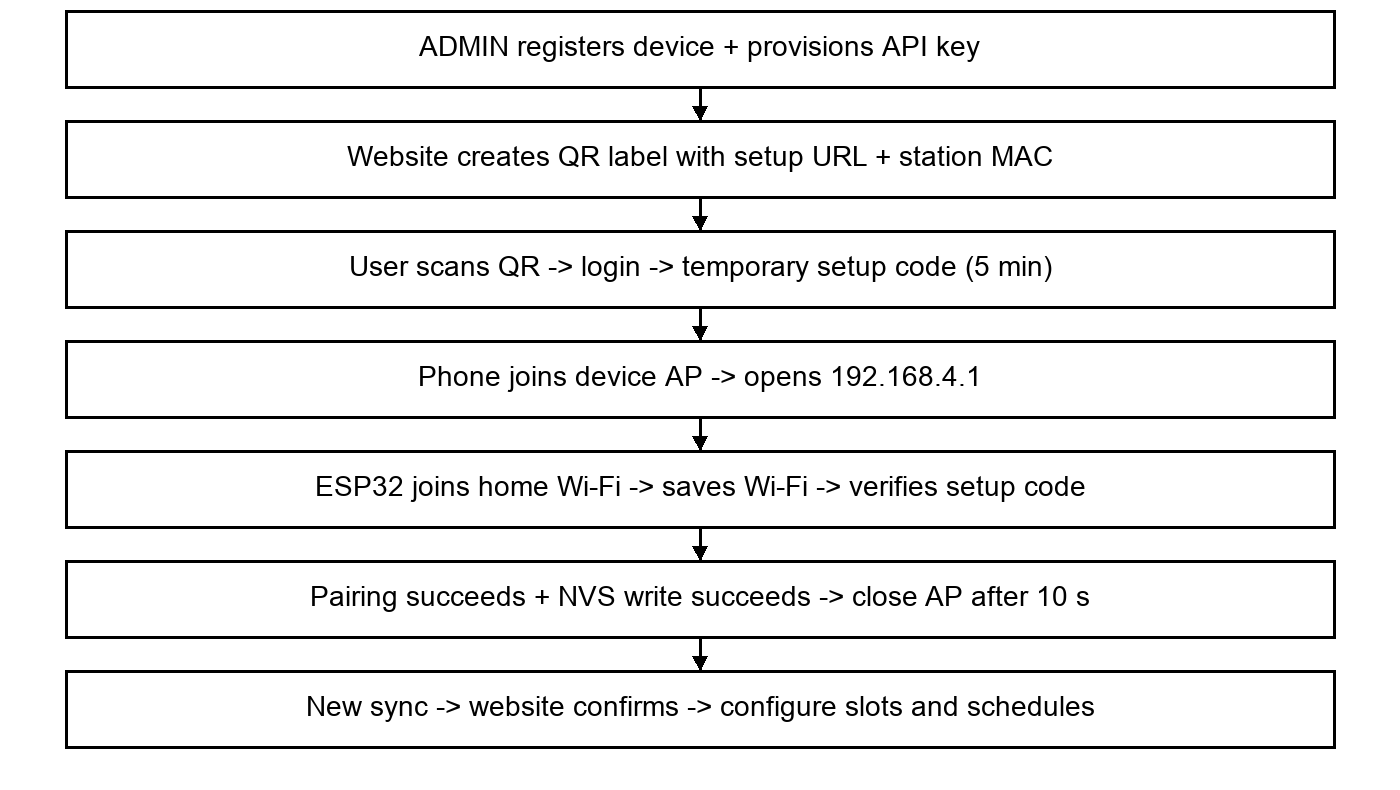
output/qa/setup.png
