Comxt-i/smart-pill-dispenser/output/qa/font-test.docx

รายงานโครงงานเครื่องจ่ายยาอัจฉริยะ ทดสอบภาษาไทยและวรรณยุกต์ น้ำ กึ่ง ขึ้น
