Comxt-i/smart-pill-dispenser/output/pill-pill-pill-qa/render/page-1.png

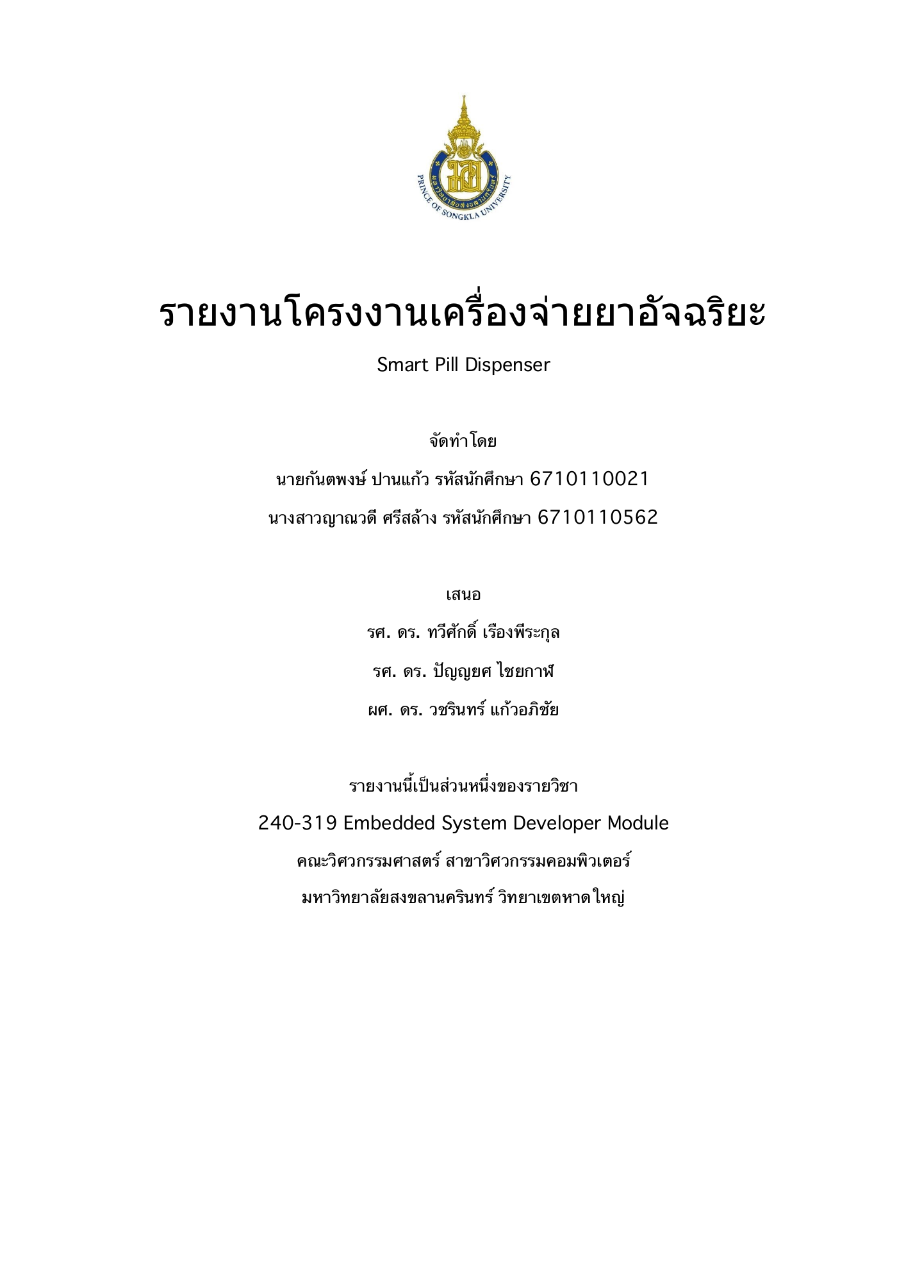
output/pill-pill-pill-qa/render/page-1.png
