Comxt-i/smart-pill-dispenser/output/pill-pill-pill-qa/render/page-9.png

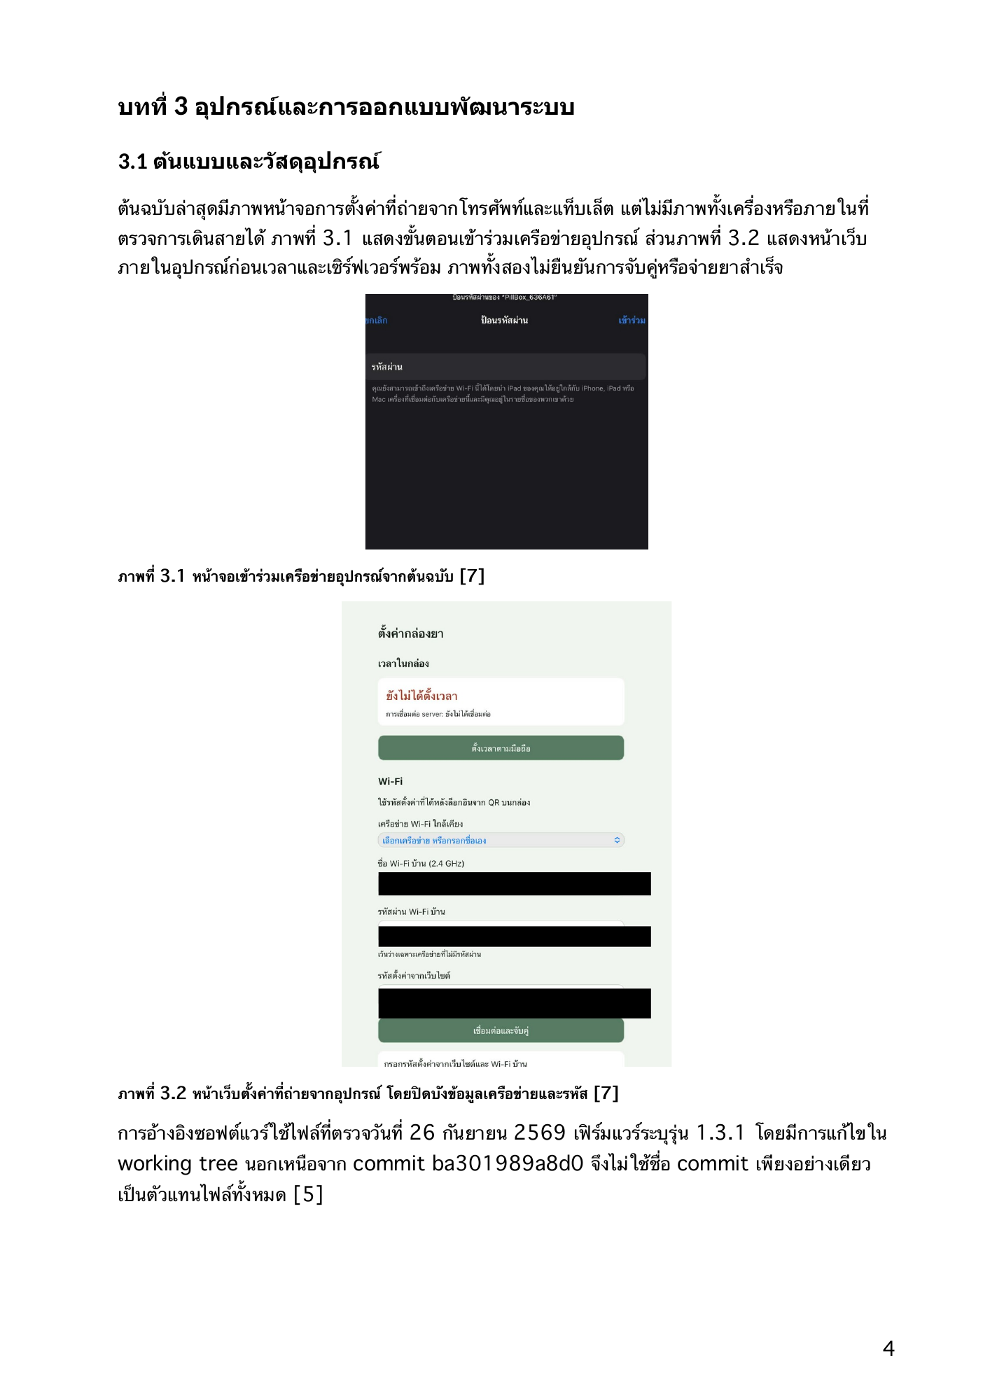
output/pill-pill-pill-qa/render/page-9.png
