Comxt-i/smart-pill-dispenser/output/pill-pill-pill-qa/render/page-11.png

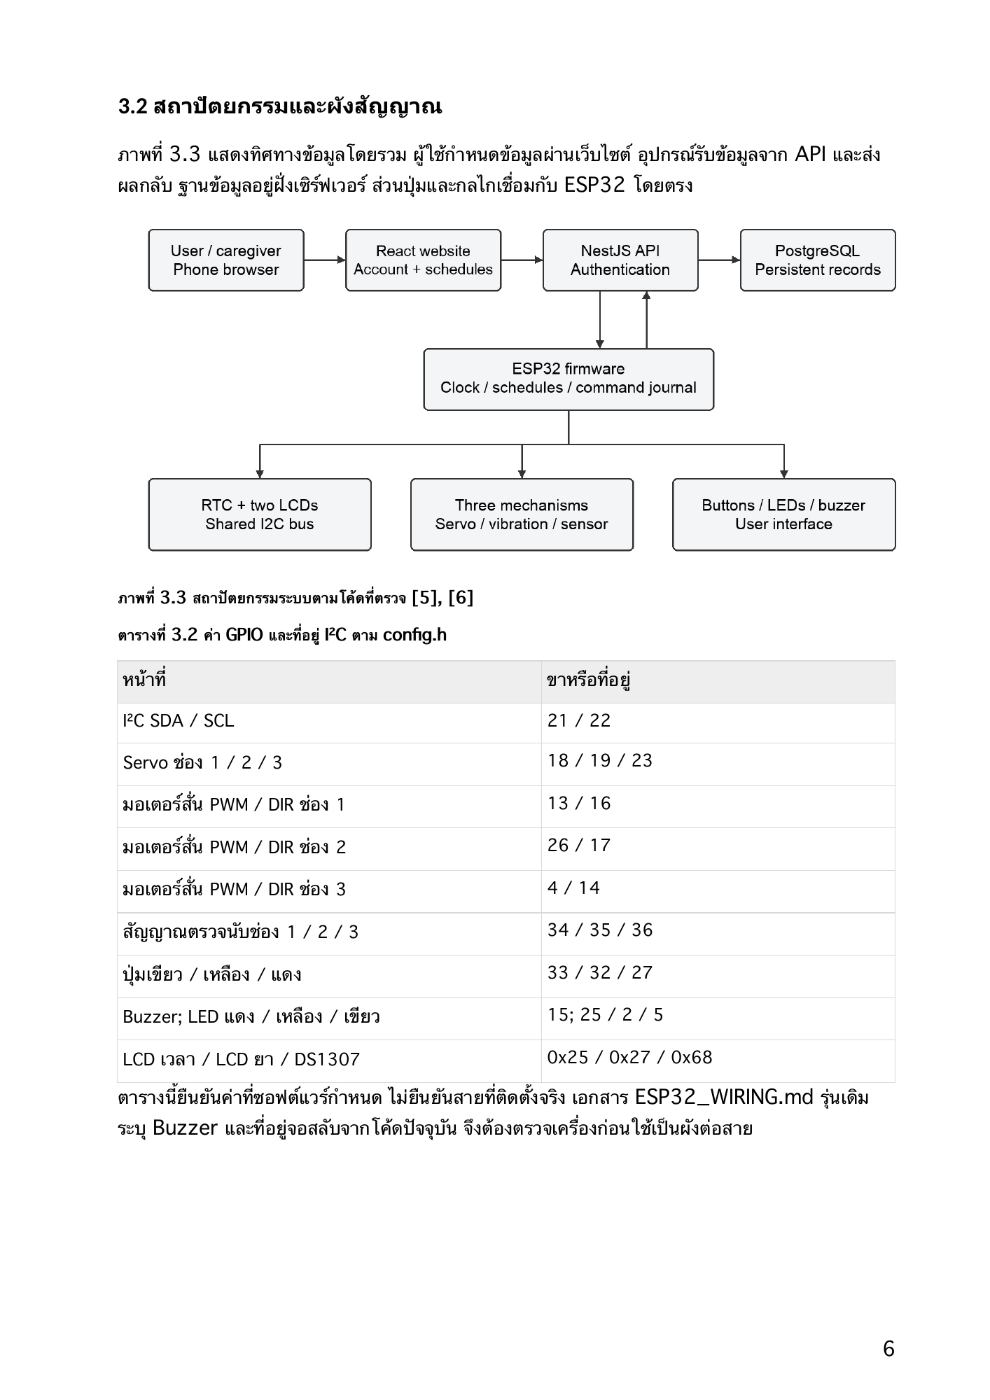
output/pill-pill-pill-qa/render/page-11.png
