Comxt-i/smart-pill-dispenser/output/pill-pill-pill-qa/render/page-12.png

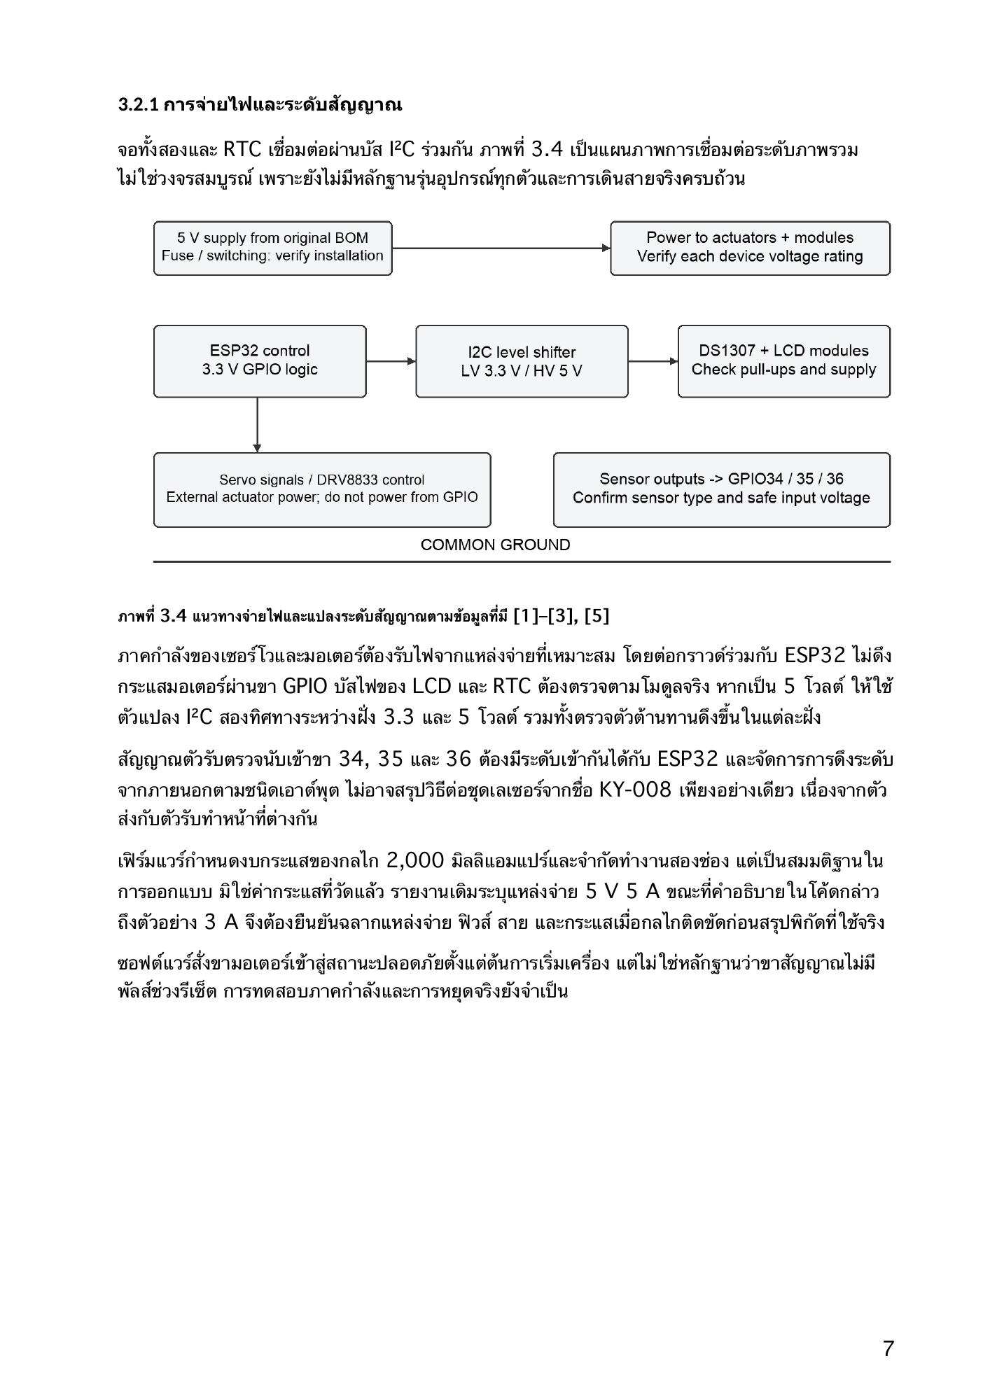
output/pill-pill-pill-qa/render/page-12.png
