Comxt-i/smart-pill-dispenser/output/pill-pill-pill-qa/render/page-21.png

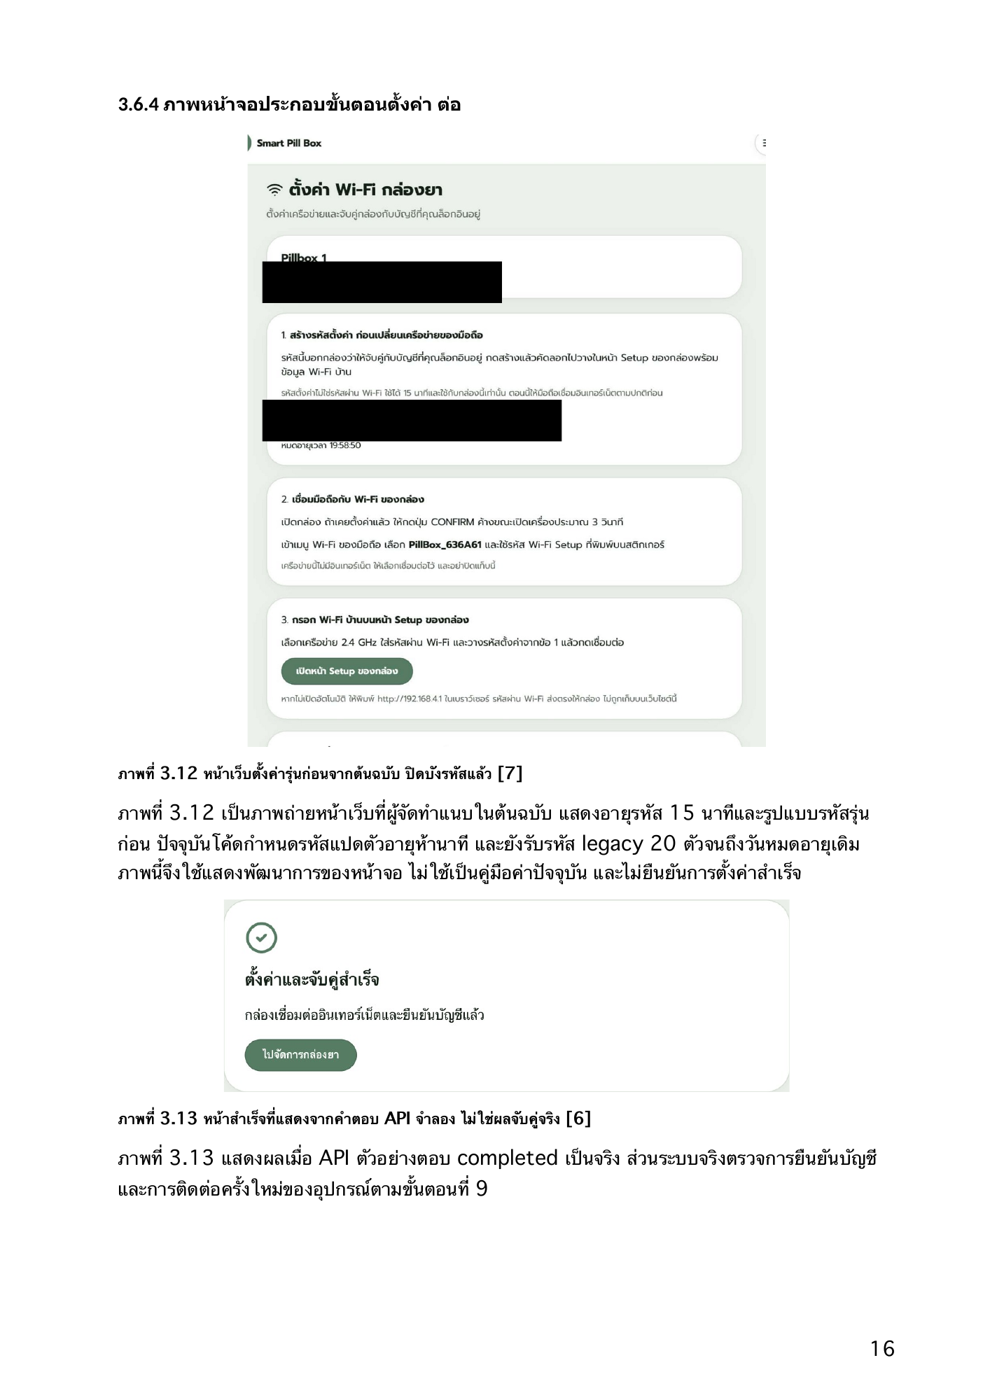
output/pill-pill-pill-qa/render/page-21.png
