Comxt-i/smart-pill-dispenser/output/pill-pill-pill-qa/render/page-23.png

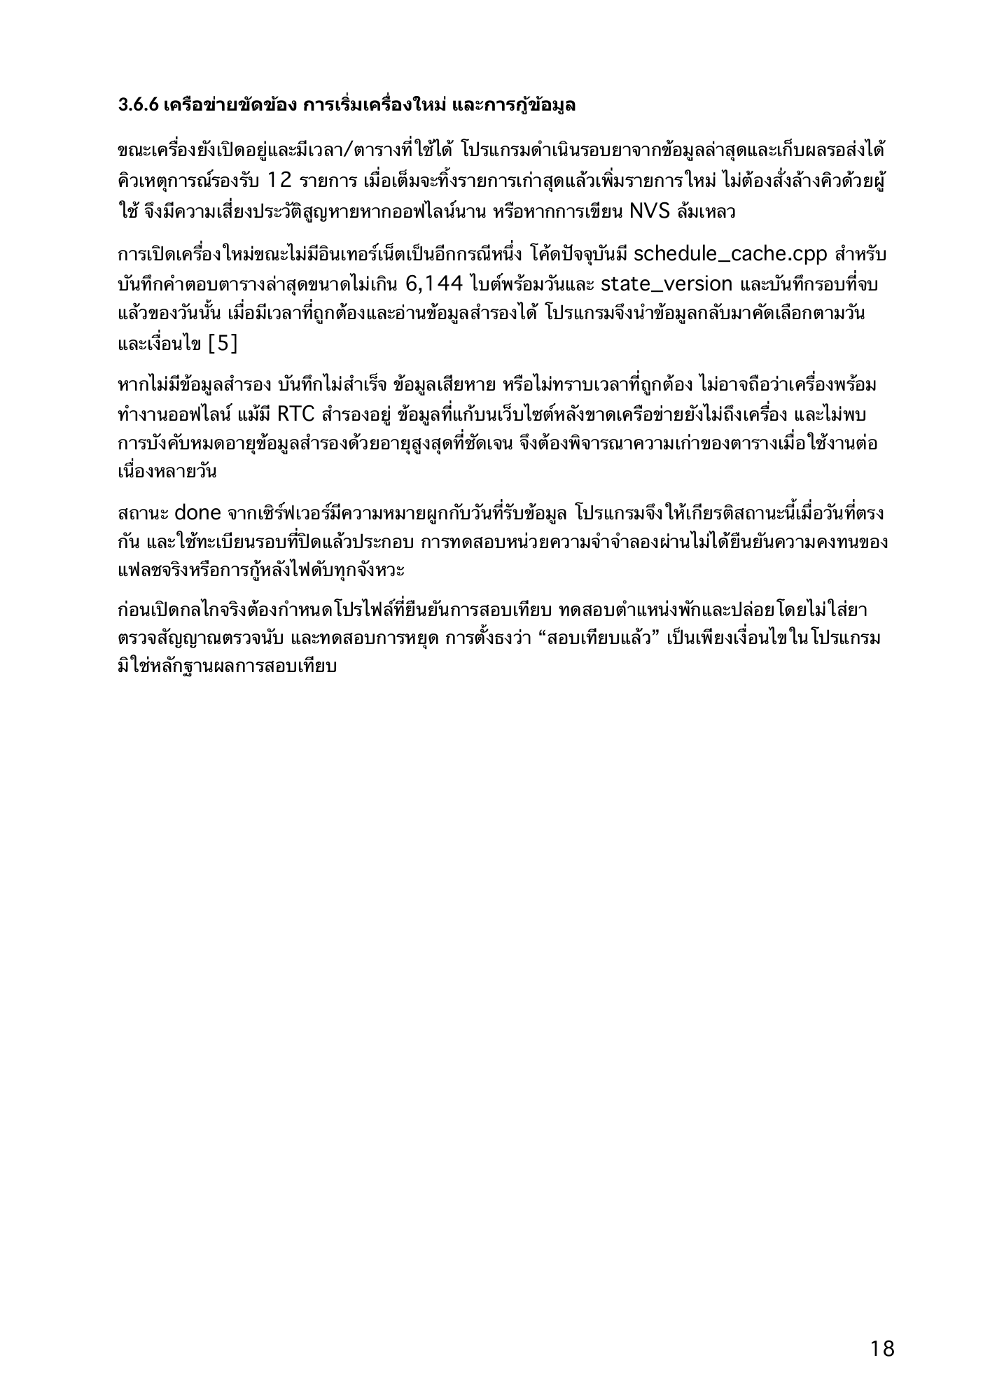
output/pill-pill-pill-qa/render/page-23.png
