Comxt-i/smart-pill-dispenser/output/pill-pill-pill-qa/render/page-26.png

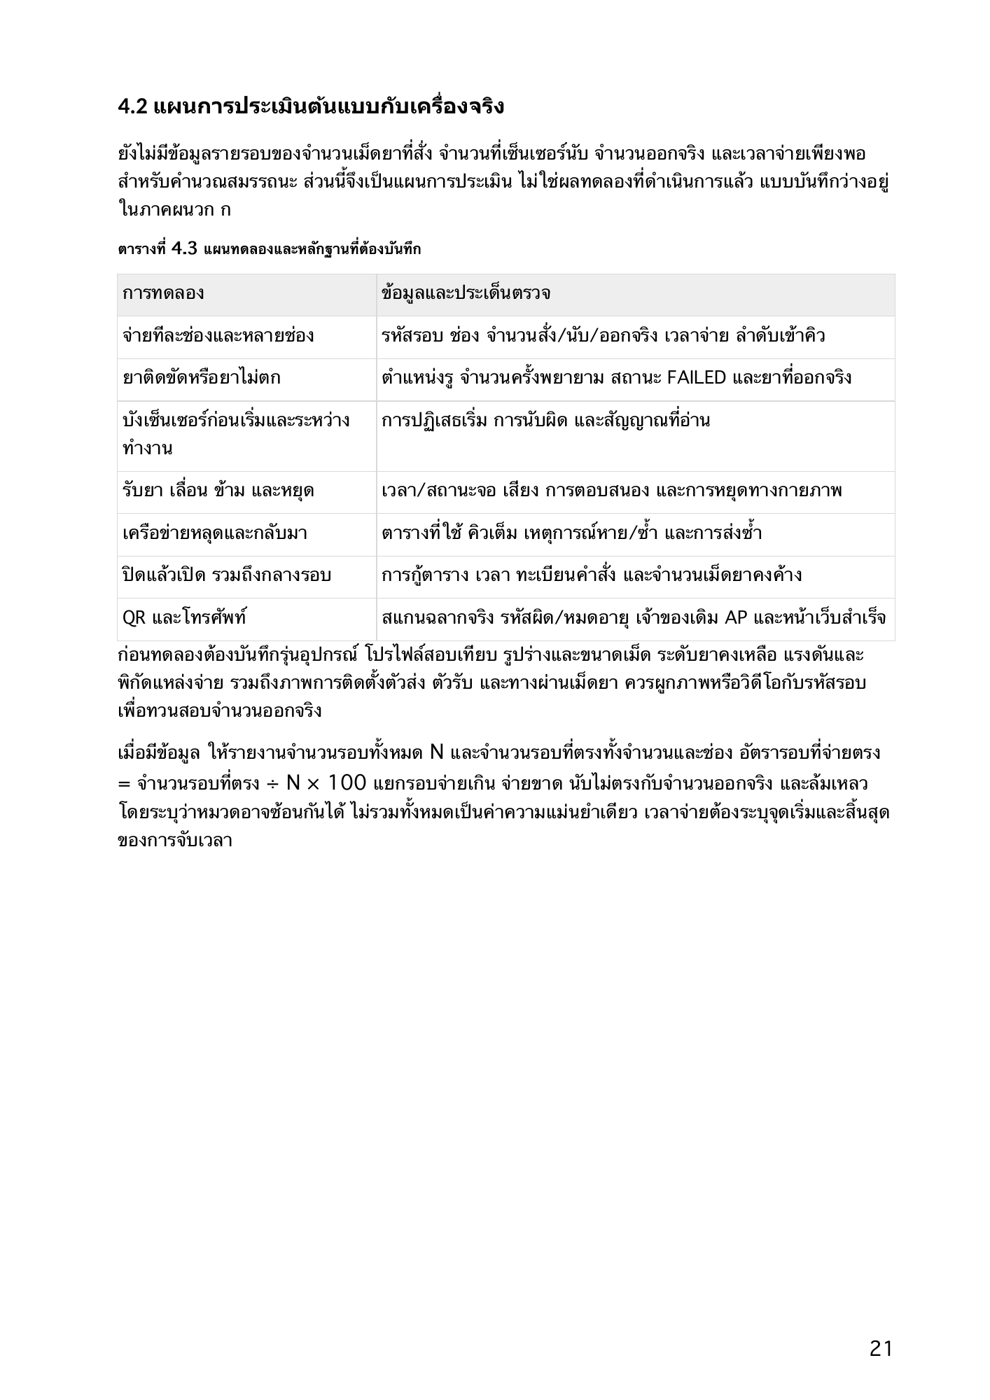
output/pill-pill-pill-qa/render/page-26.png
