Comxt-i/smart-pill-dispenser/output/pill-pill-pill-qa/render/page-30.png

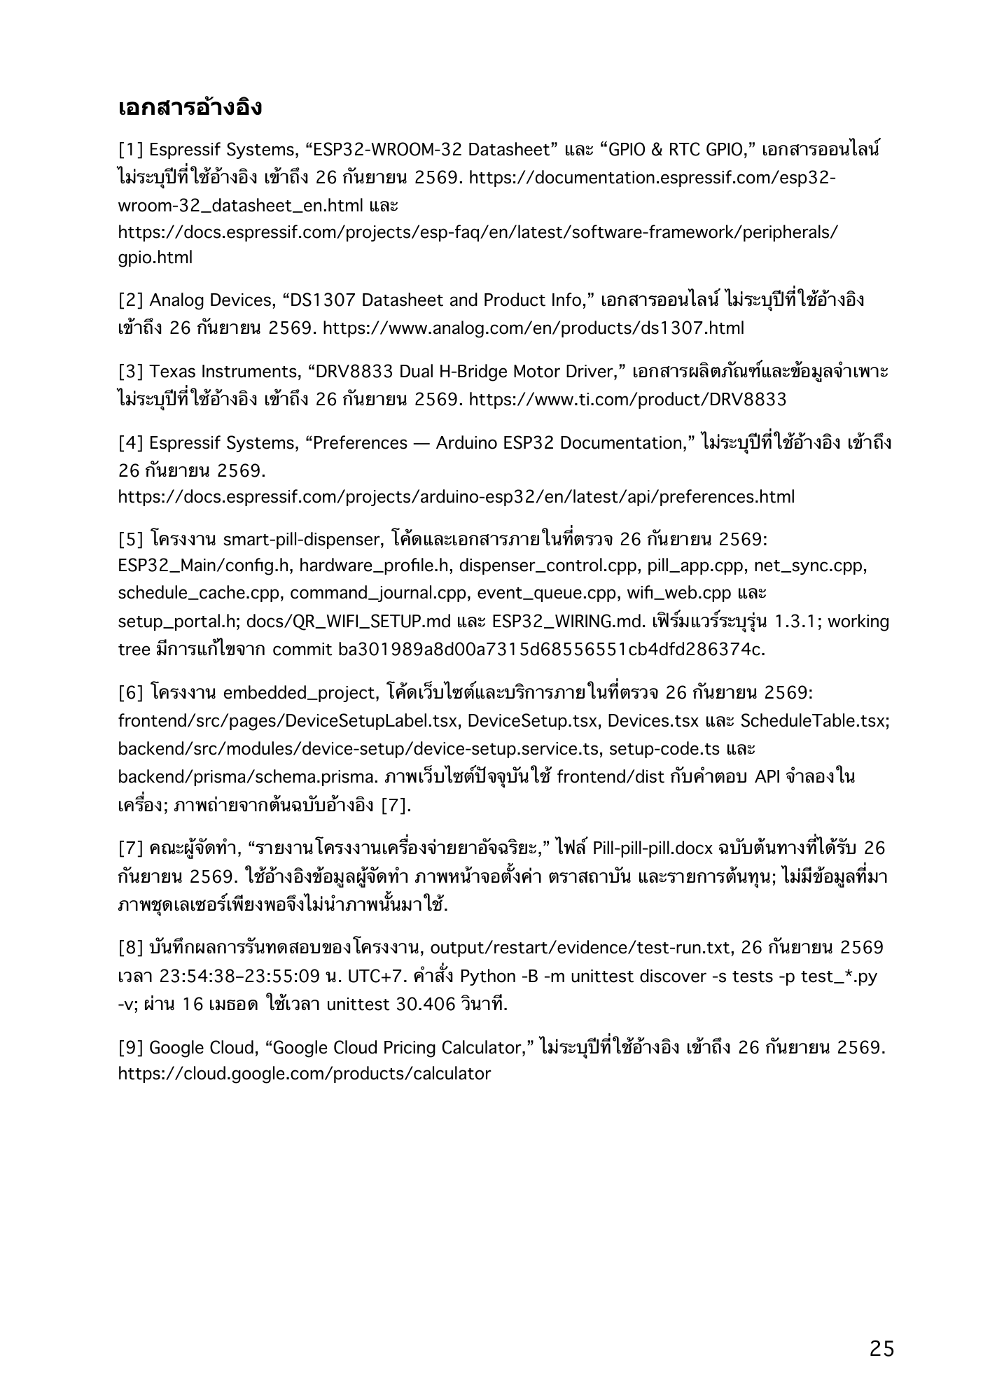
output/pill-pill-pill-qa/render/page-30.png
