Comxt-i/smart-pill-dispenser/output/pill-pill-pill-qa/render/page-31.png

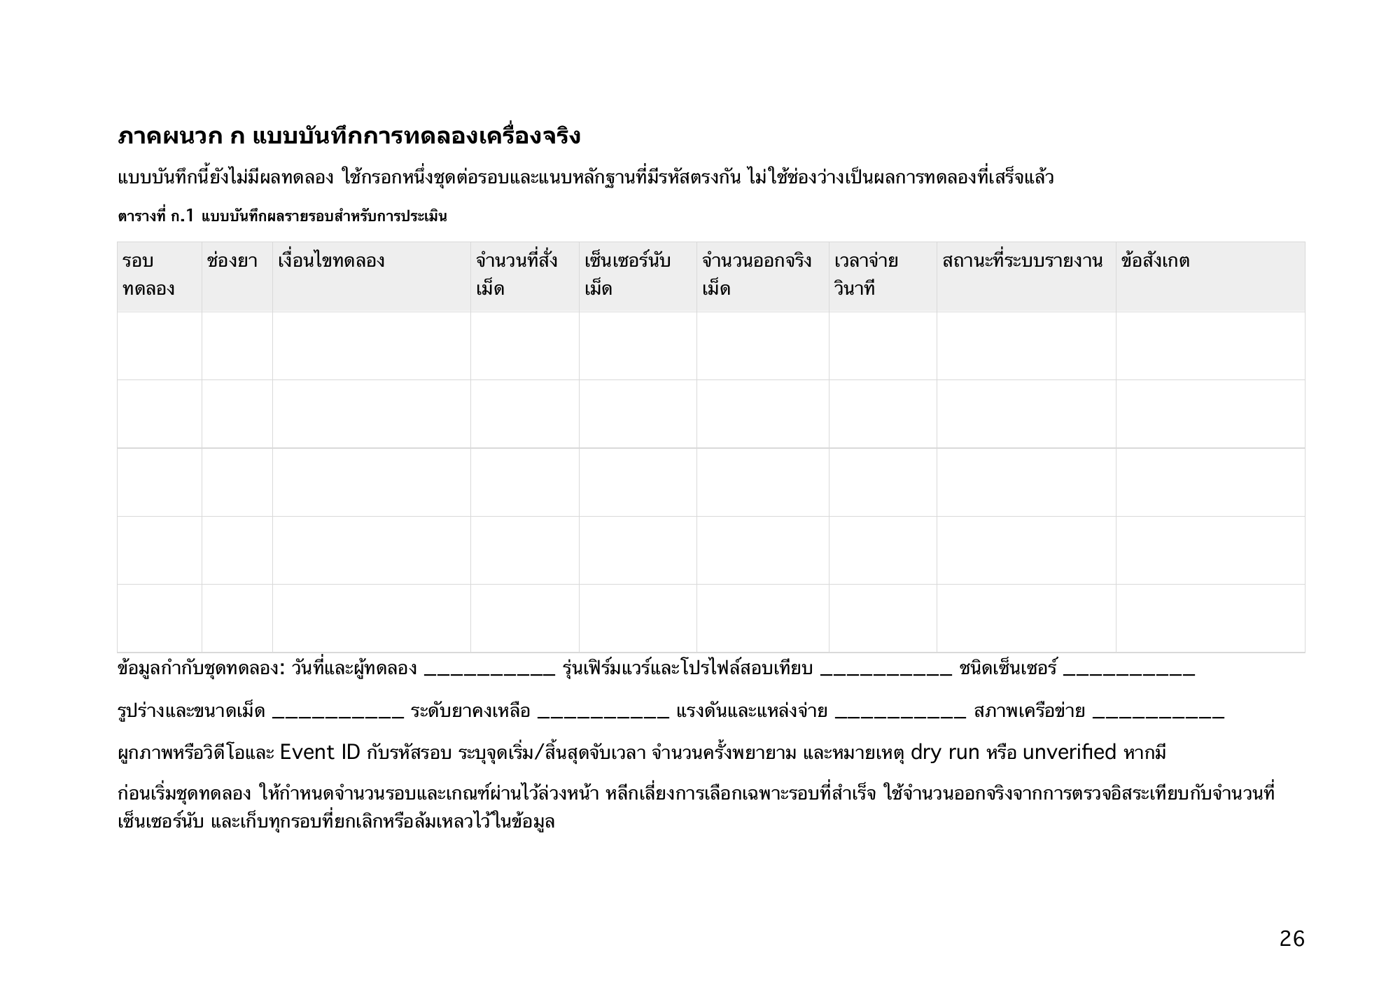
output/pill-pill-pill-qa/render/page-31.png
