Comxt-i/smart-pill-dispenser/output/qa/contact.jpg

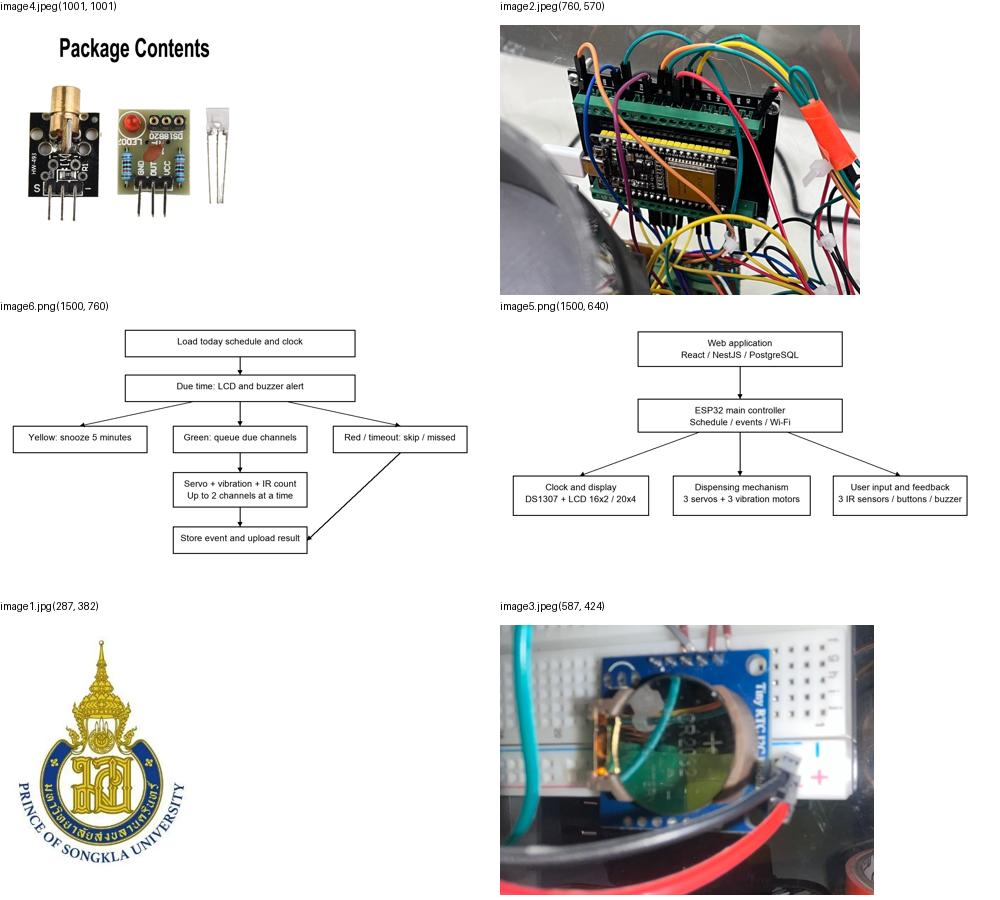
output/qa/contact.jpg
