Comxt-i/smart-pill-dispenser/output/qa/exchange.png

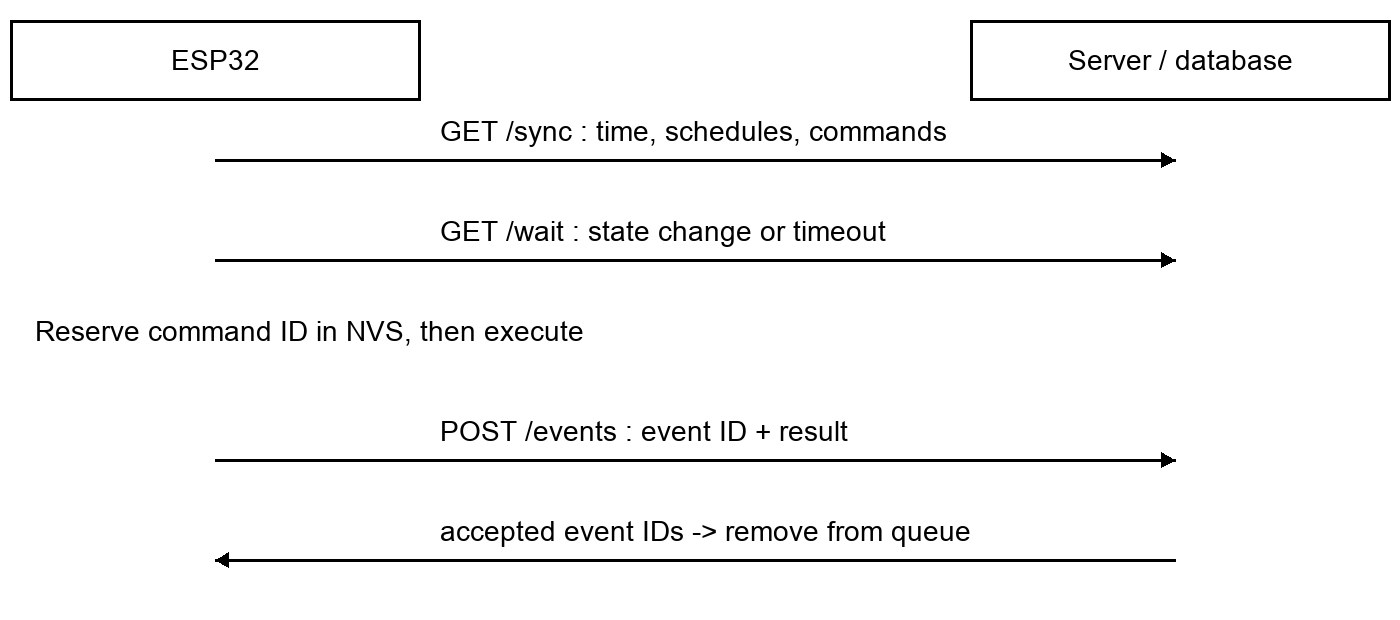
output/qa/exchange.png
