Comxt-i/smart-pill-dispenser/output/qa/final-render/page-5.png

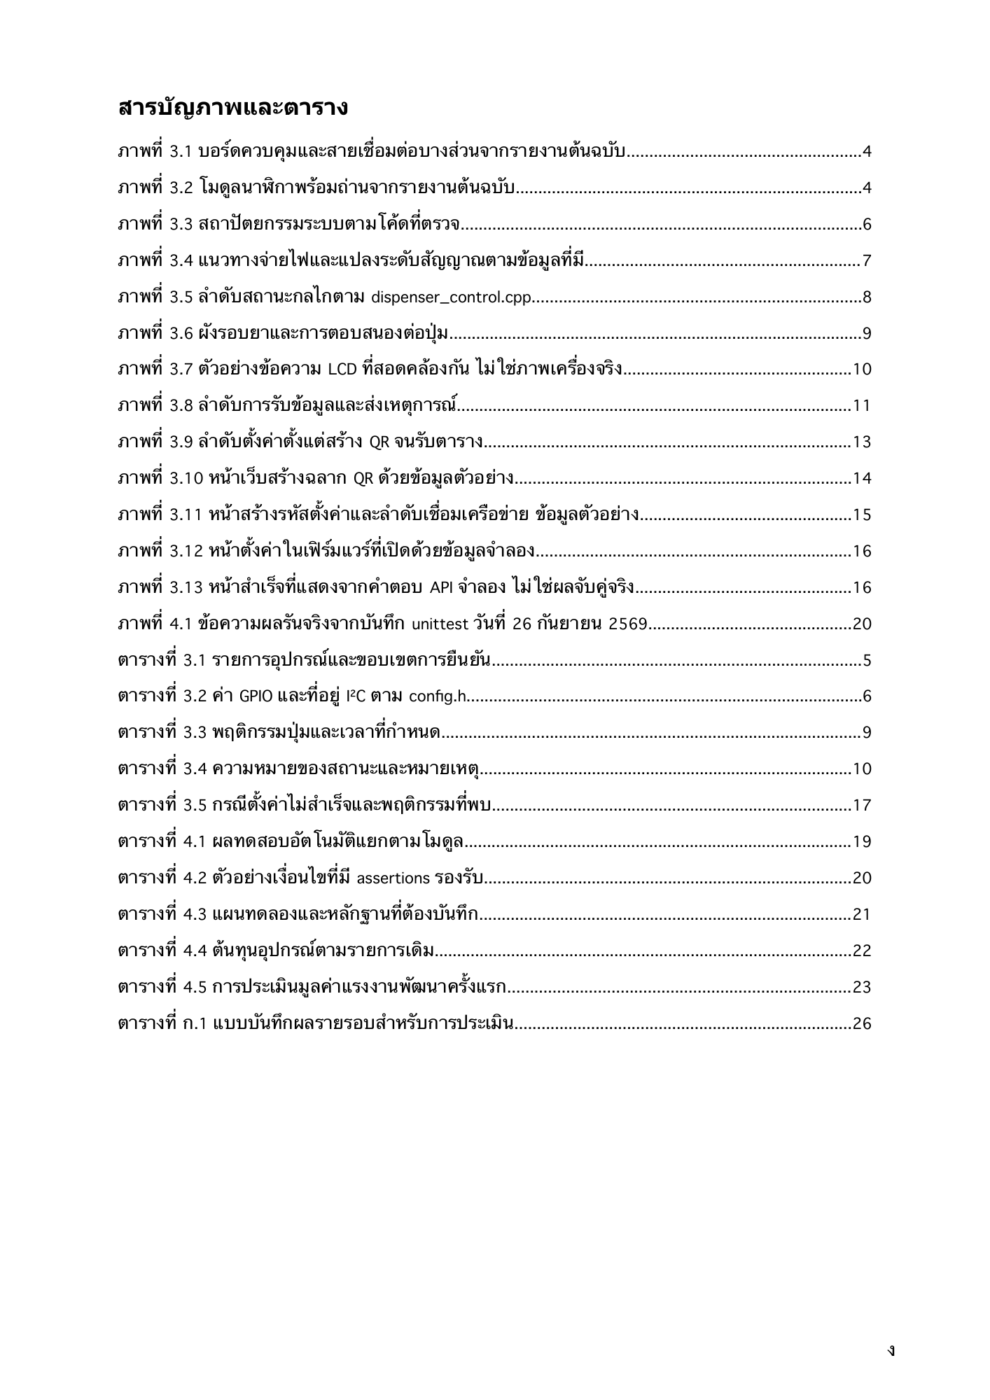
output/qa/final-render/page-5.png
