Comxt-i/smart-pill-dispenser/output/qa/final-render/page-6.png

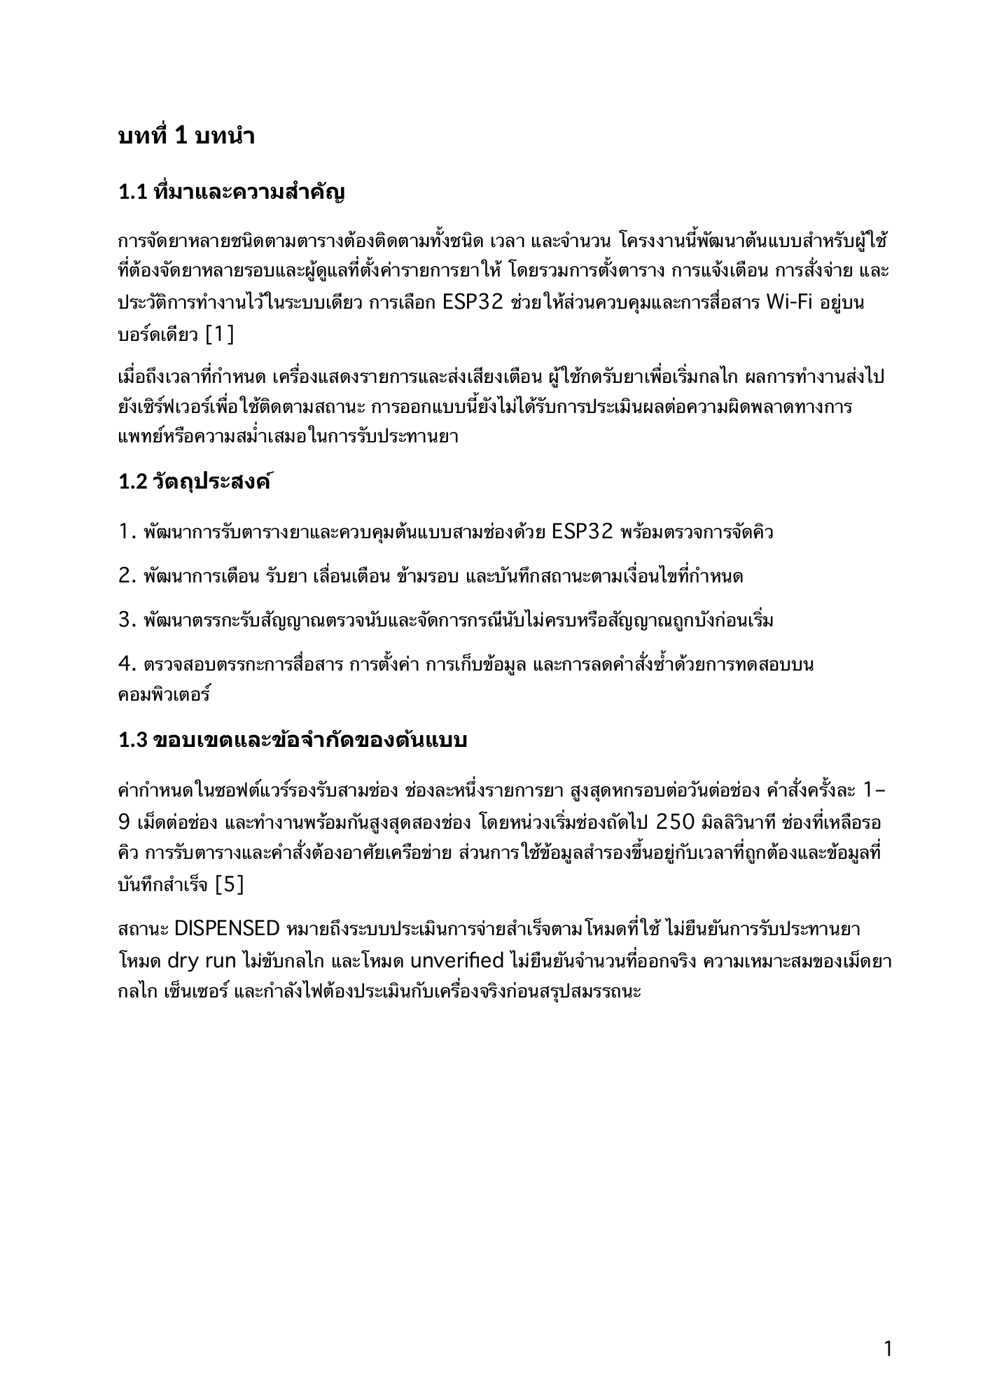
output/qa/final-render/page-6.png
