Comxt-i/smart-pill-dispenser/output/qa/final-render/page-7.png

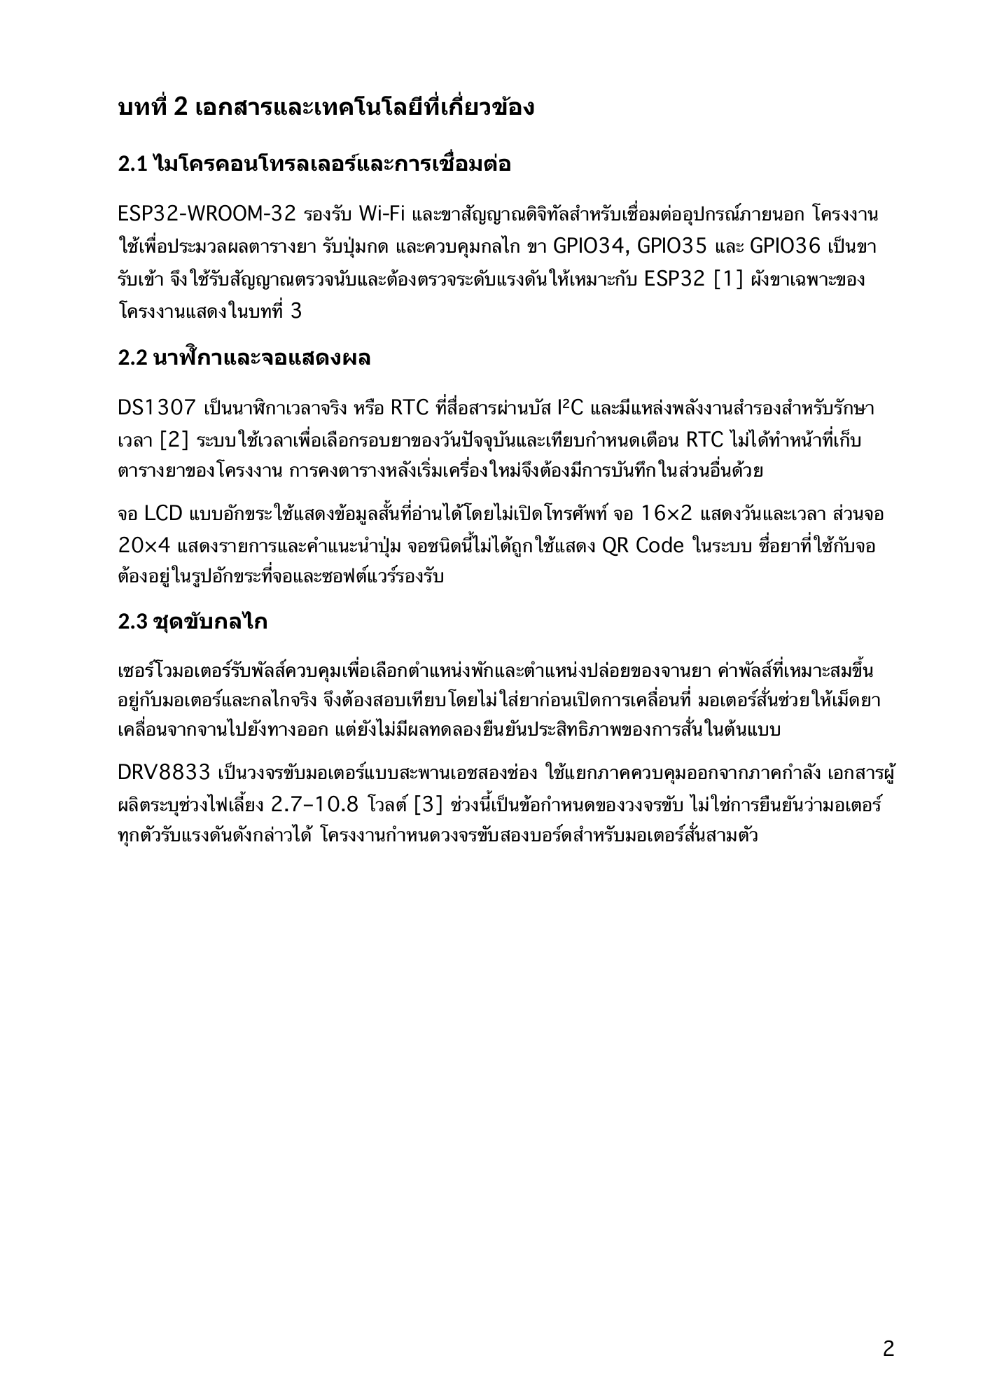
output/qa/final-render/page-7.png
