Comxt-i/smart-pill-dispenser/output/qa/final-render/page-8.png

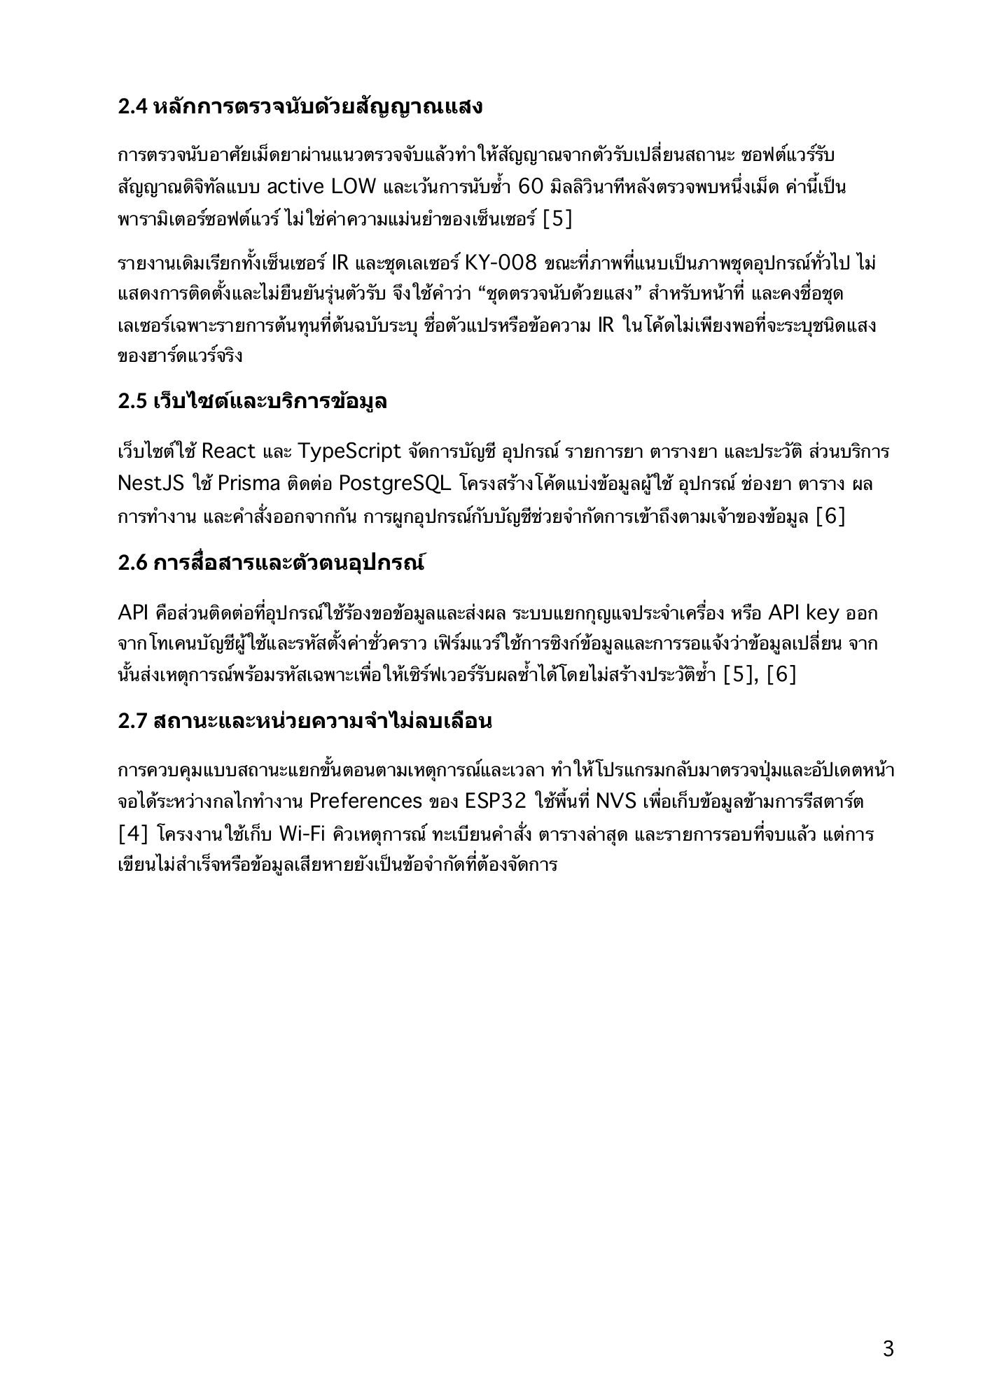
output/qa/final-render/page-8.png
