Comxt-i/smart-pill-dispenser/output/qa/final-render/page-11.png

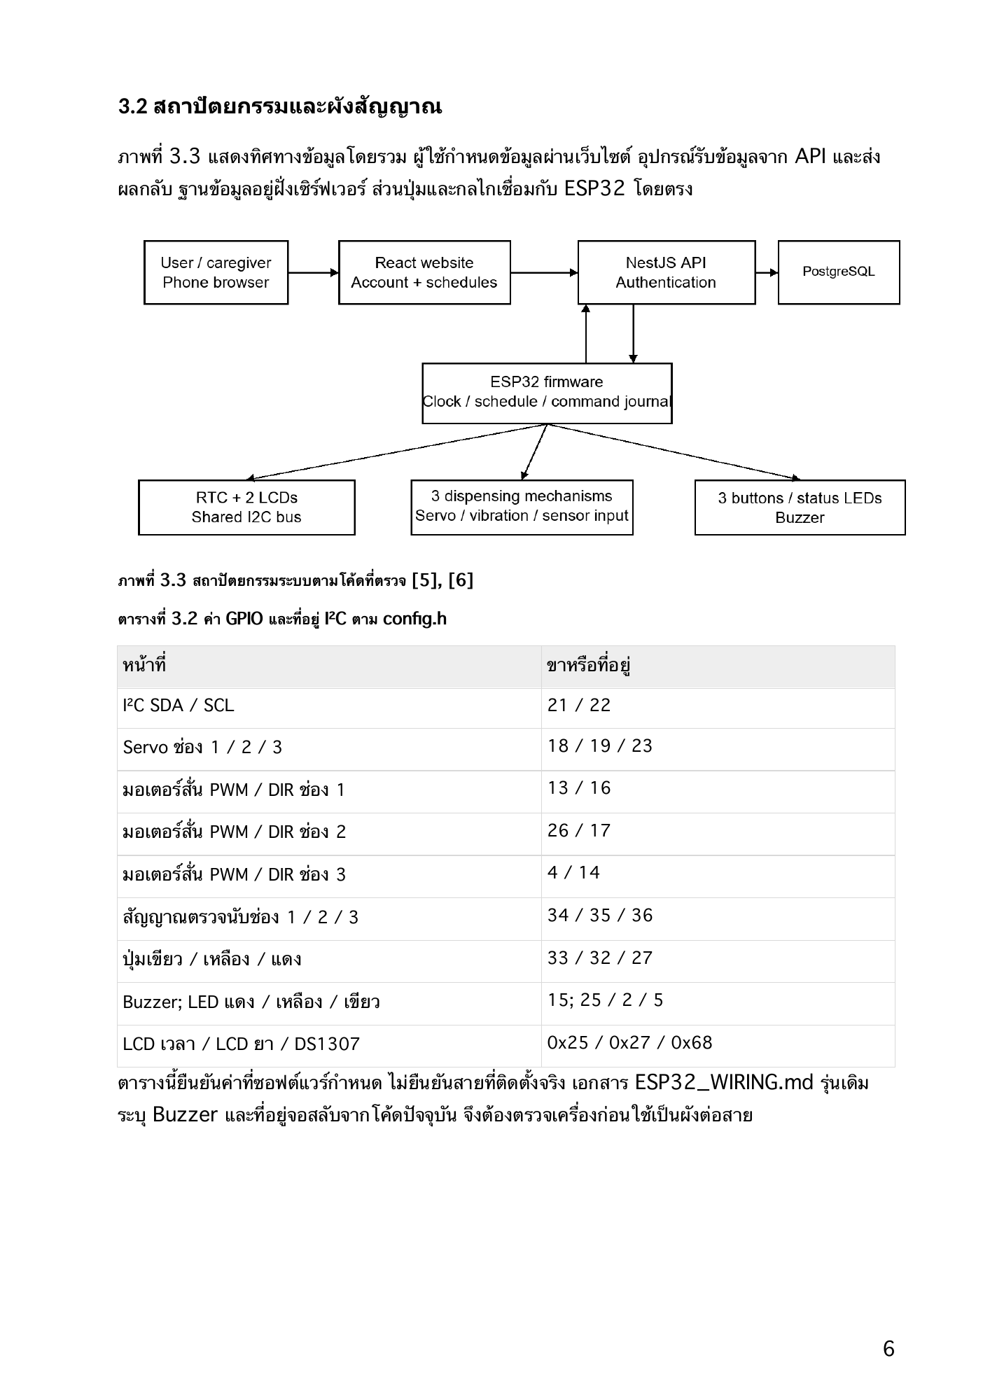
output/qa/final-render/page-11.png
