Comxt-i/smart-pill-dispenser/output/qa/final-render/page-12.png

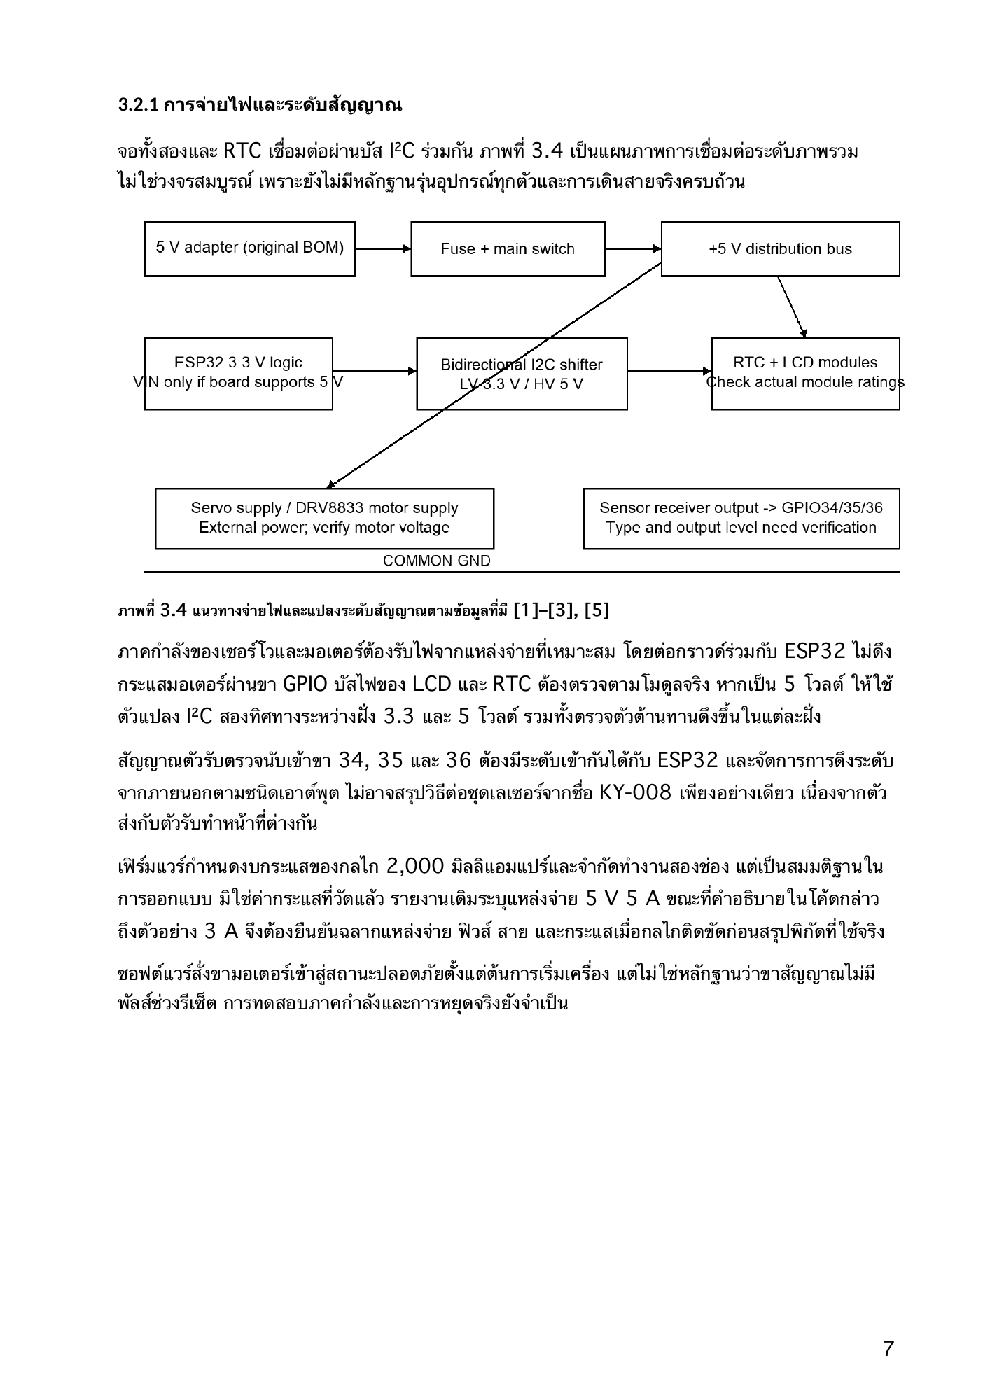
output/qa/final-render/page-12.png
