Comxt-i/smart-pill-dispenser/output/qa/final-render/page-13.png

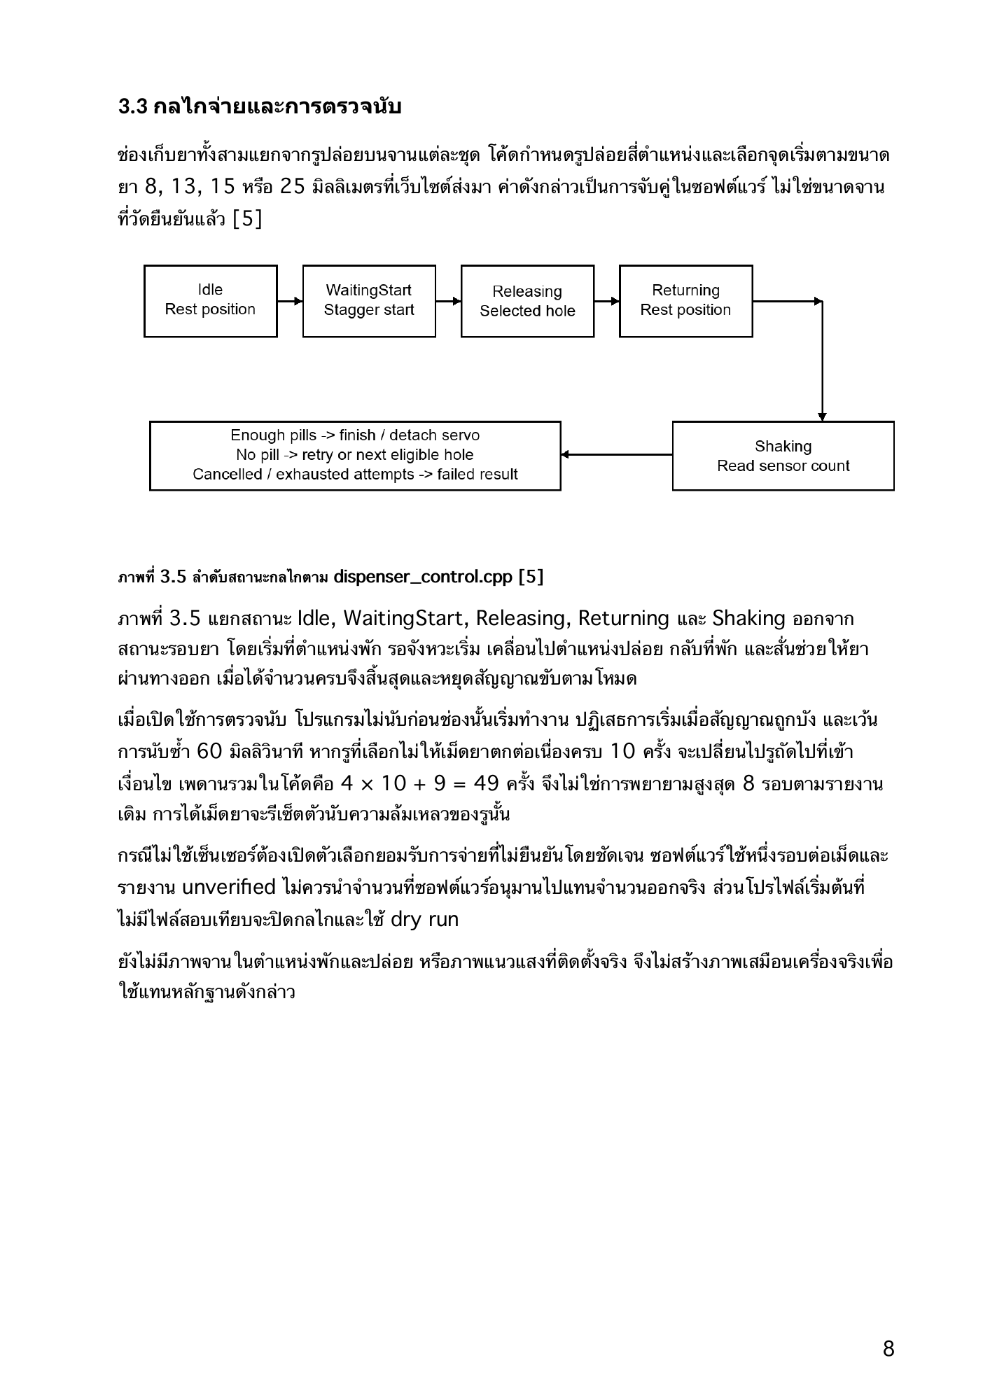
output/qa/final-render/page-13.png
