Comxt-i/smart-pill-dispenser/output/qa/final-render/page-14.png

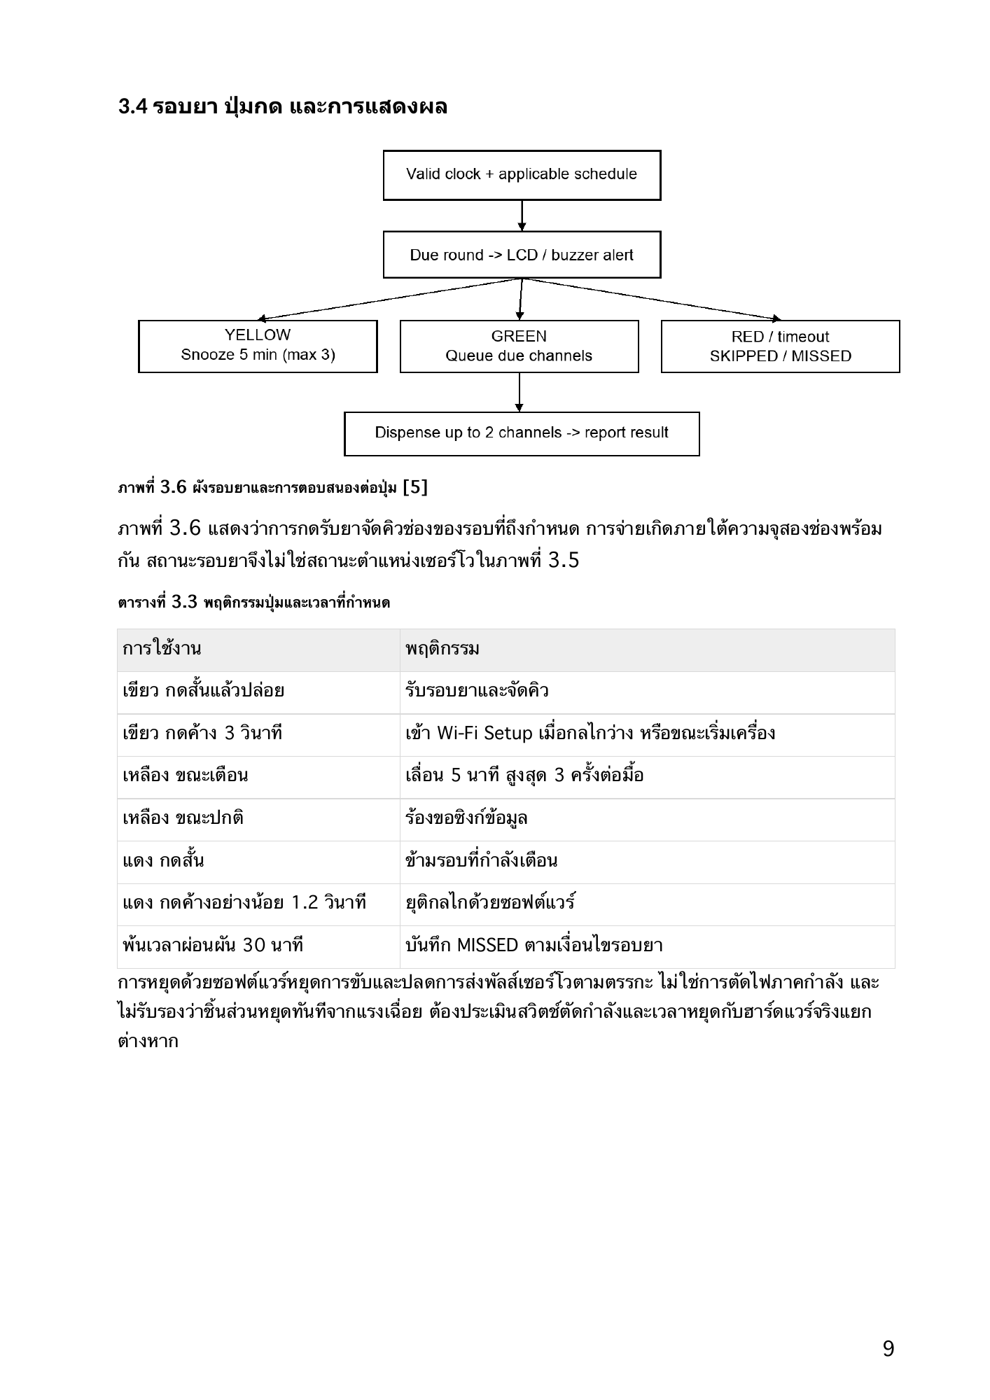
output/qa/final-render/page-14.png
