Comxt-i/smart-pill-dispenser/output/qa/final-render/page-15.png

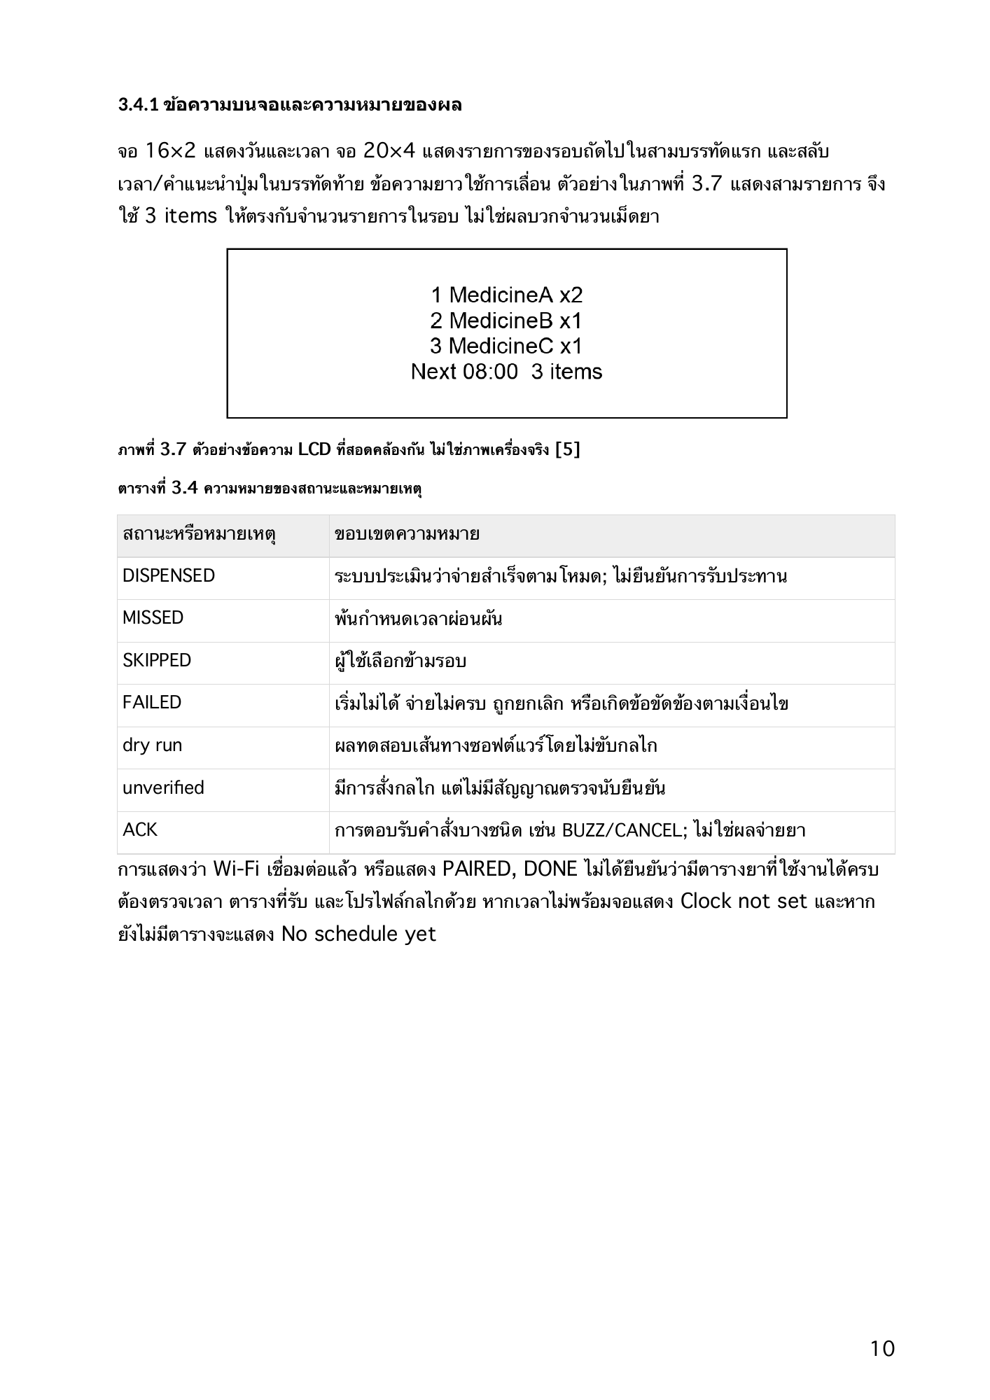
output/qa/final-render/page-15.png
