Comxt-i/smart-pill-dispenser/output/qa/final-render/page-16.png

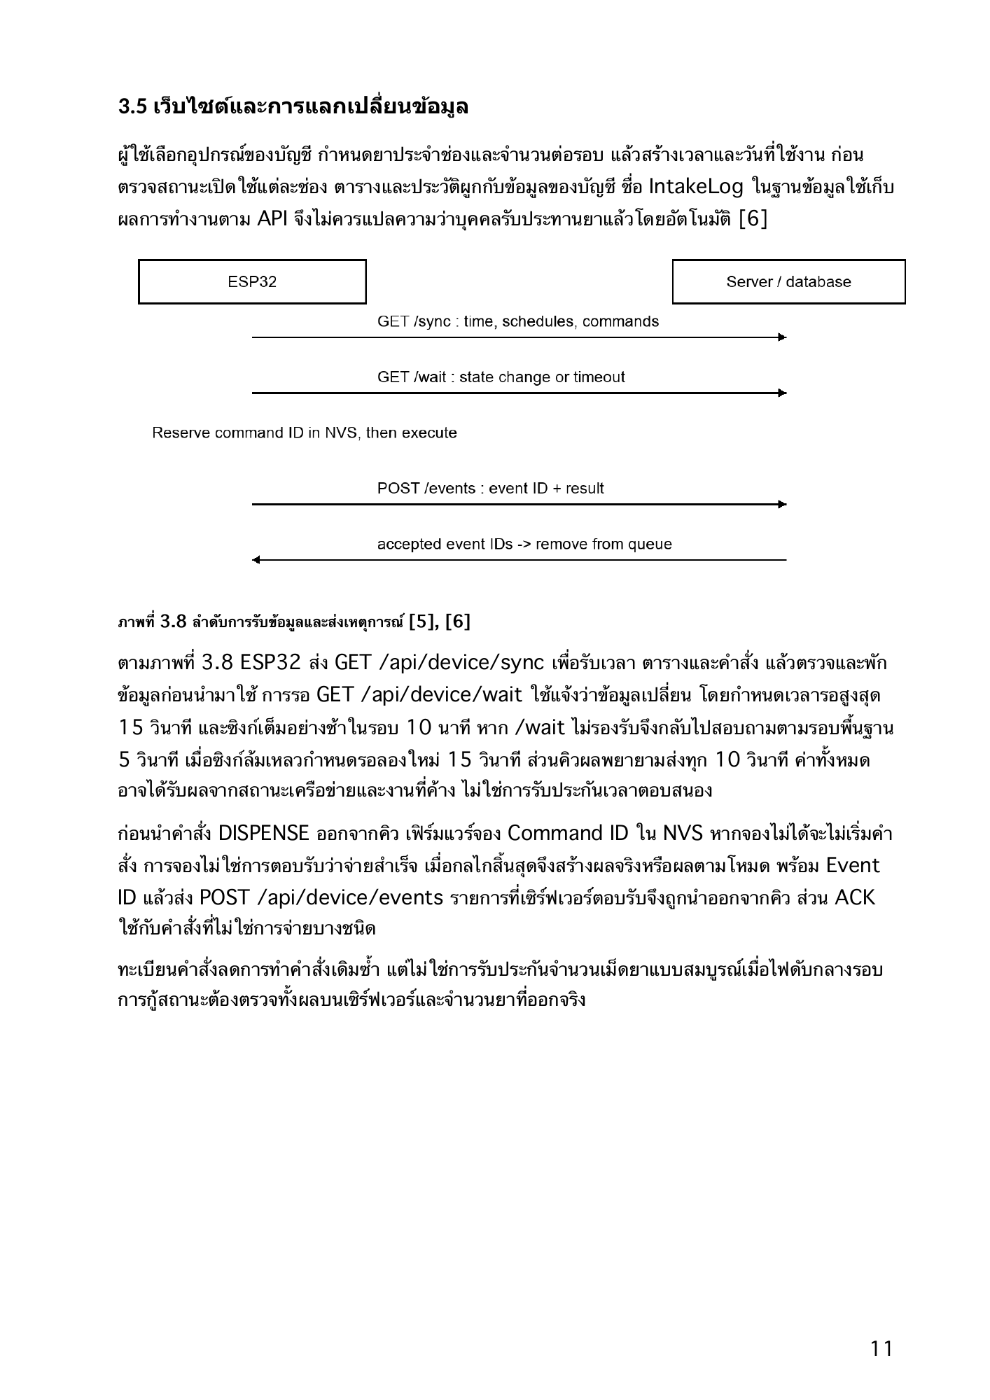
output/qa/final-render/page-16.png
