Comxt-i/smart-pill-dispenser/output/qa/final-render/page-17.png

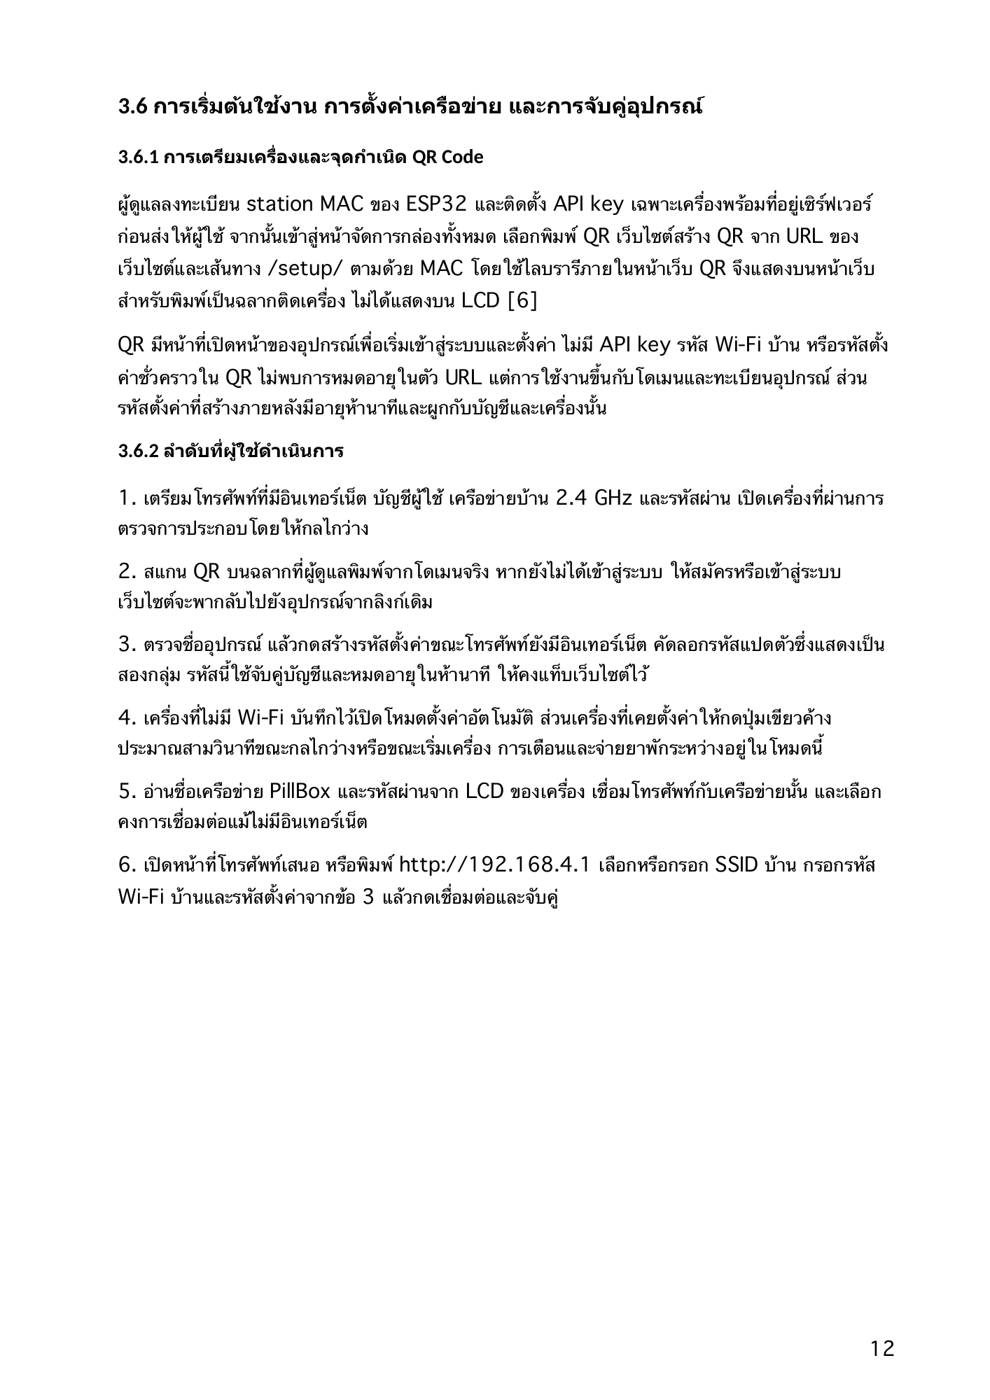
output/qa/final-render/page-17.png
