Comxt-i/smart-pill-dispenser/output/qa/final-render/page-18.png

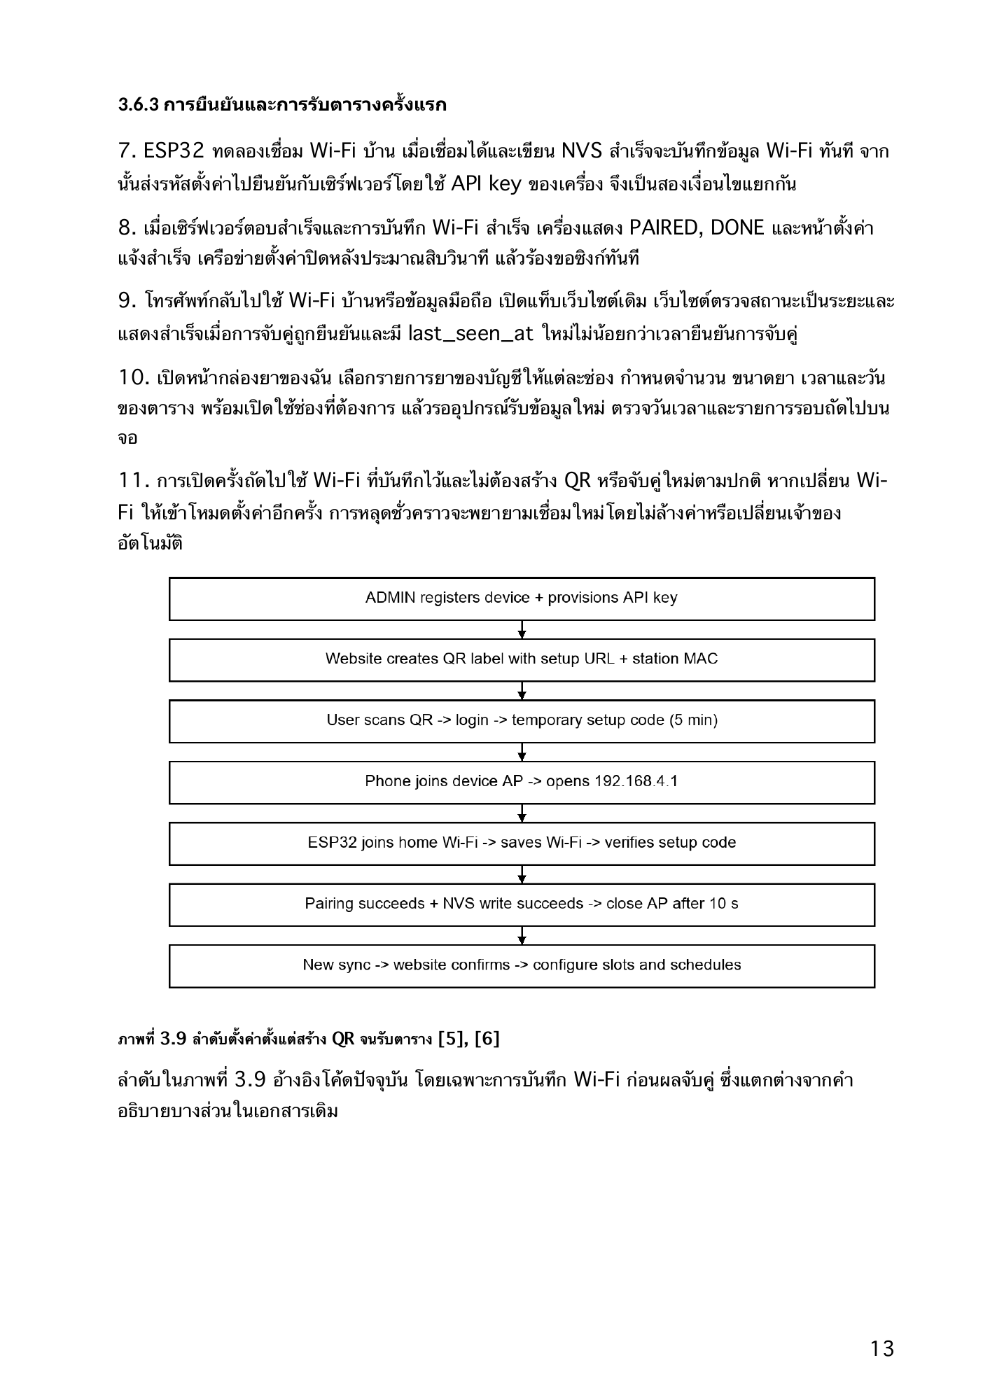
output/qa/final-render/page-18.png
