Comxt-i/smart-pill-dispenser/output/qa/final-render/page-19.png

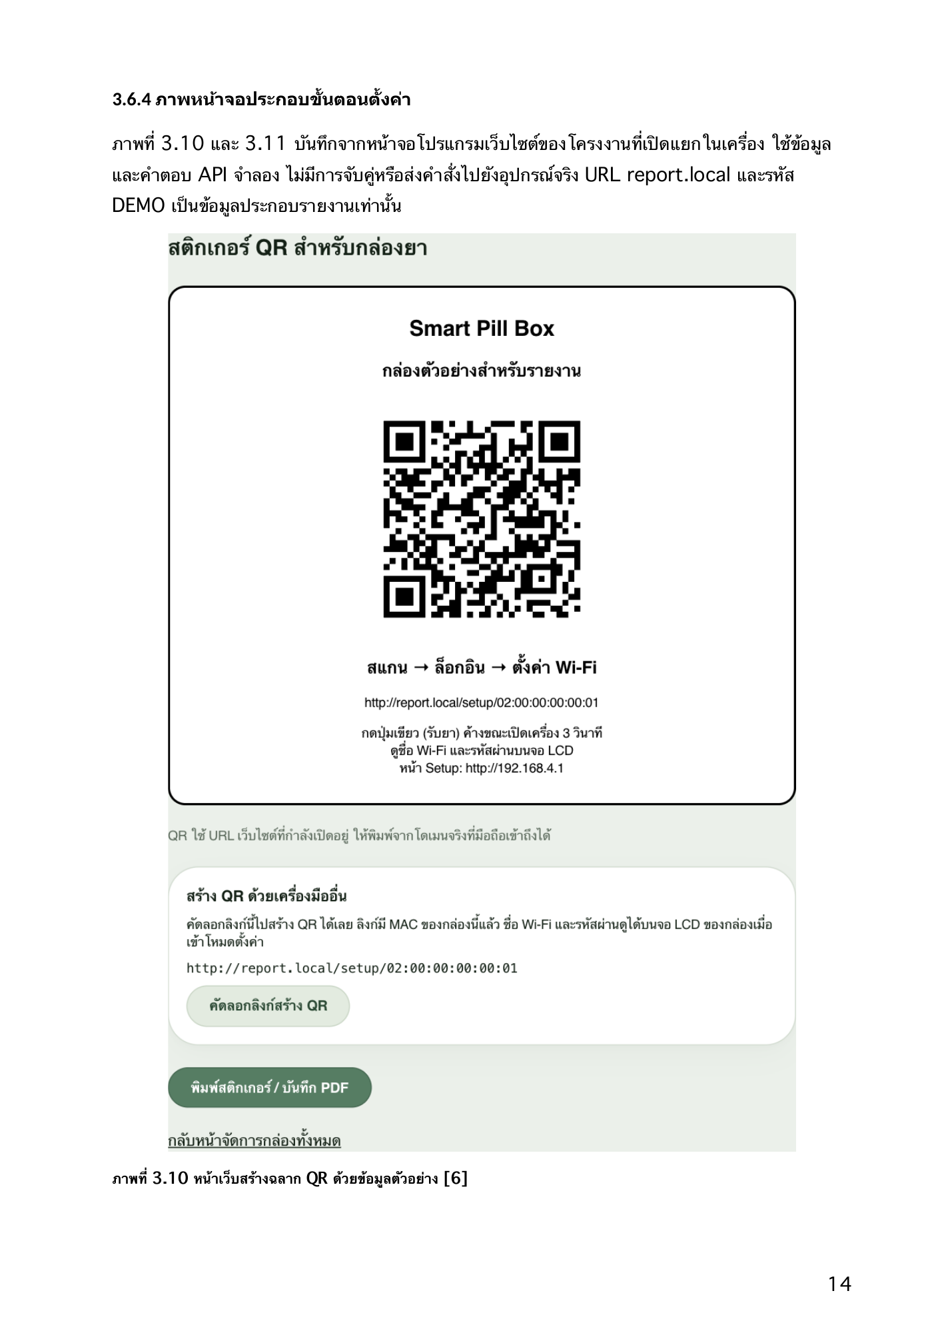
output/qa/final-render/page-19.png
