Comxt-i/smart-pill-dispenser/output/qa/final-render/page-20.png

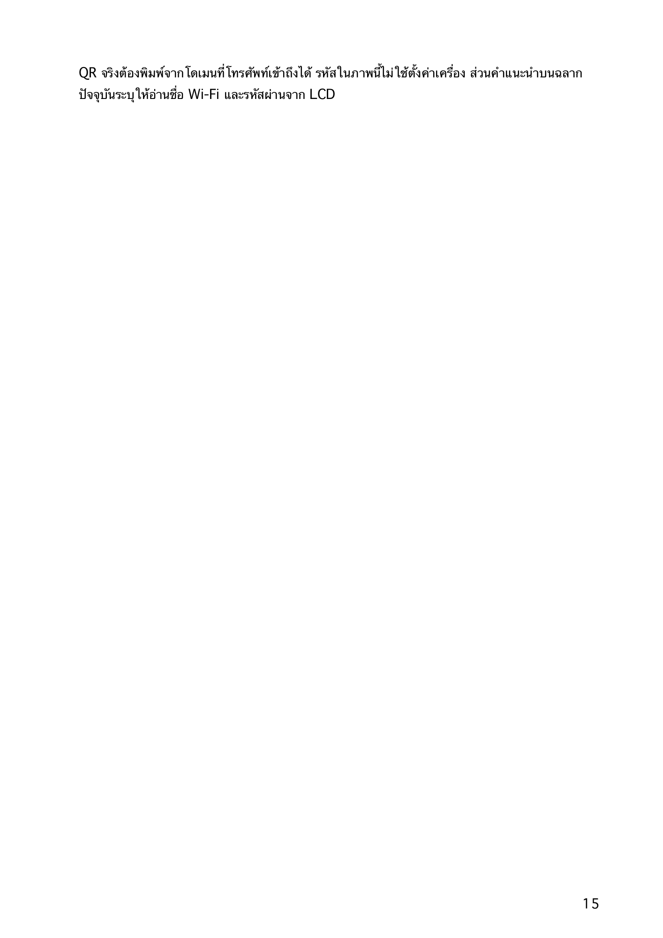
output/qa/final-render/page-20.png
