Comxt-i/smart-pill-dispenser/output/qa/final-render/page-22.png

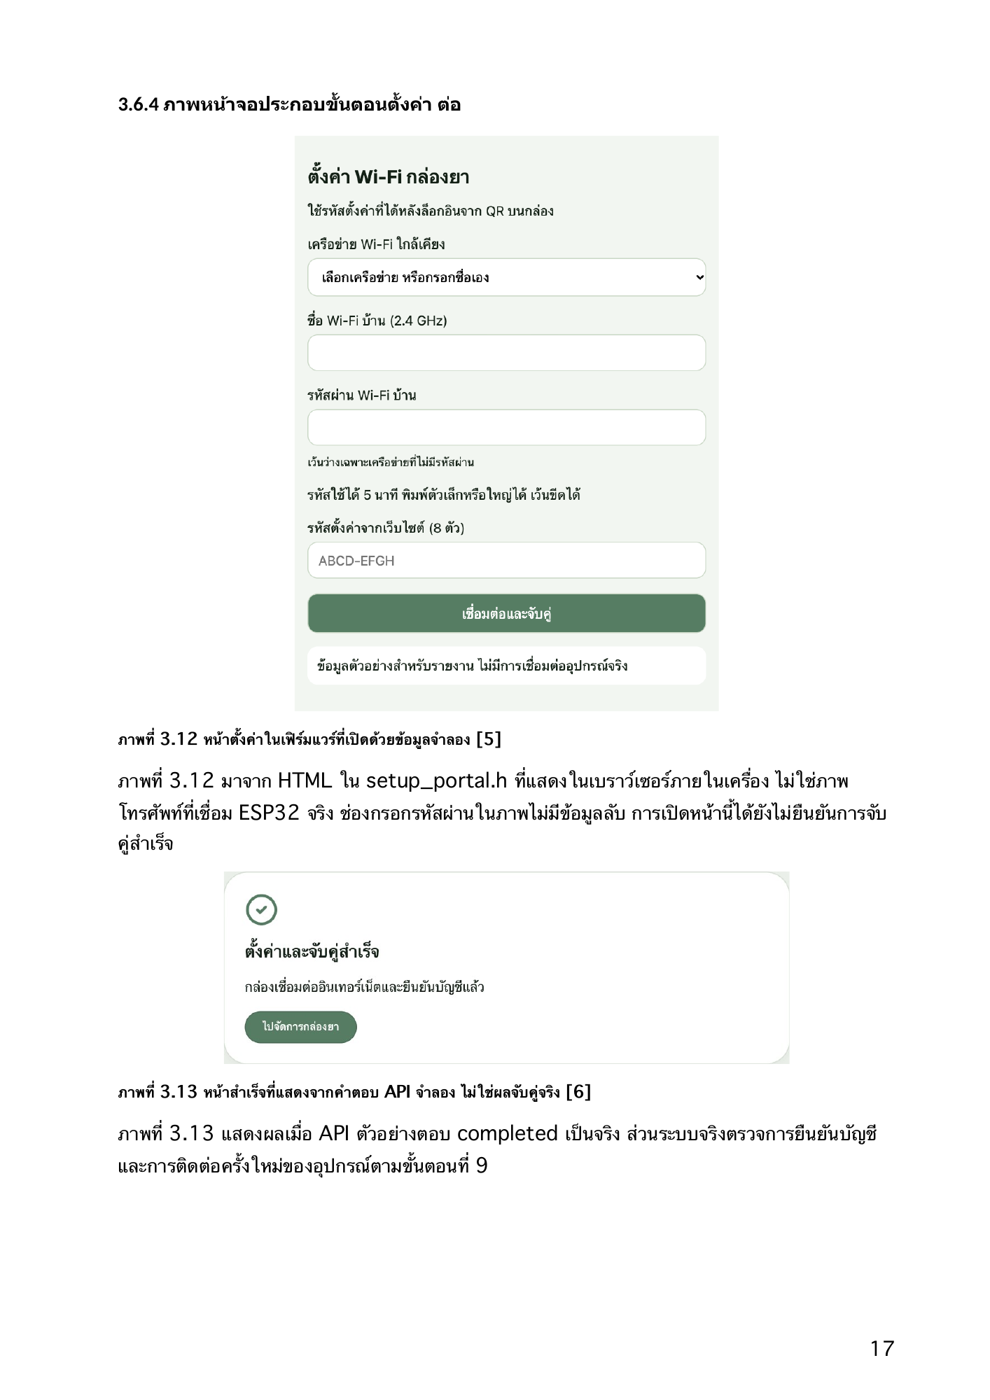
output/qa/final-render/page-22.png
