Comxt-i/smart-pill-dispenser/output/qa/final-render/page-24.png

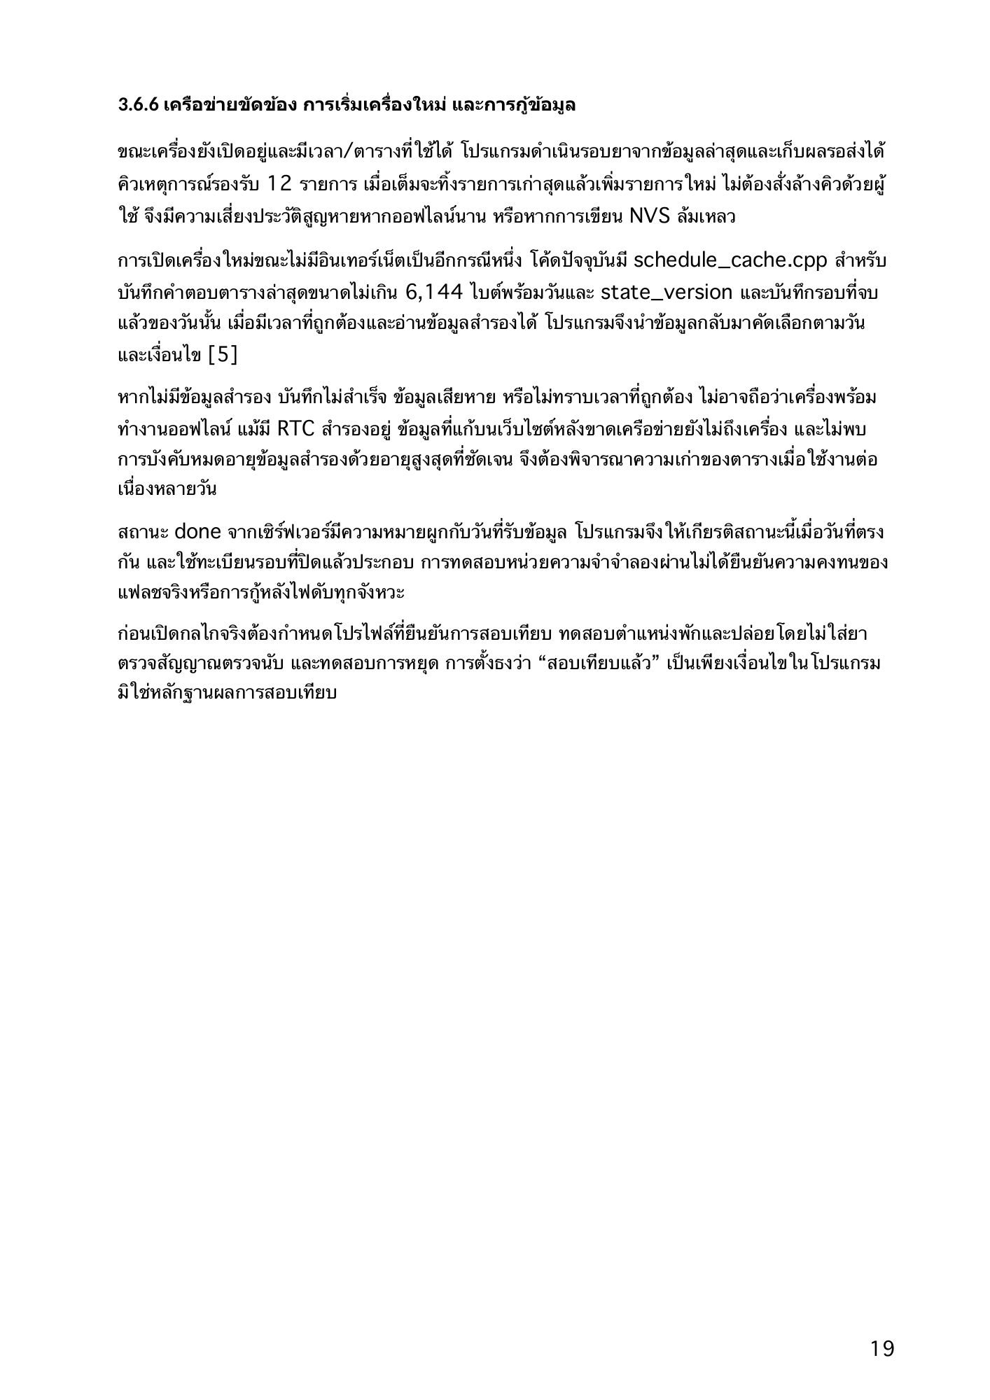
output/qa/final-render/page-24.png
