Comxt-i/smart-pill-dispenser/output/qa/final-render/page-26.png

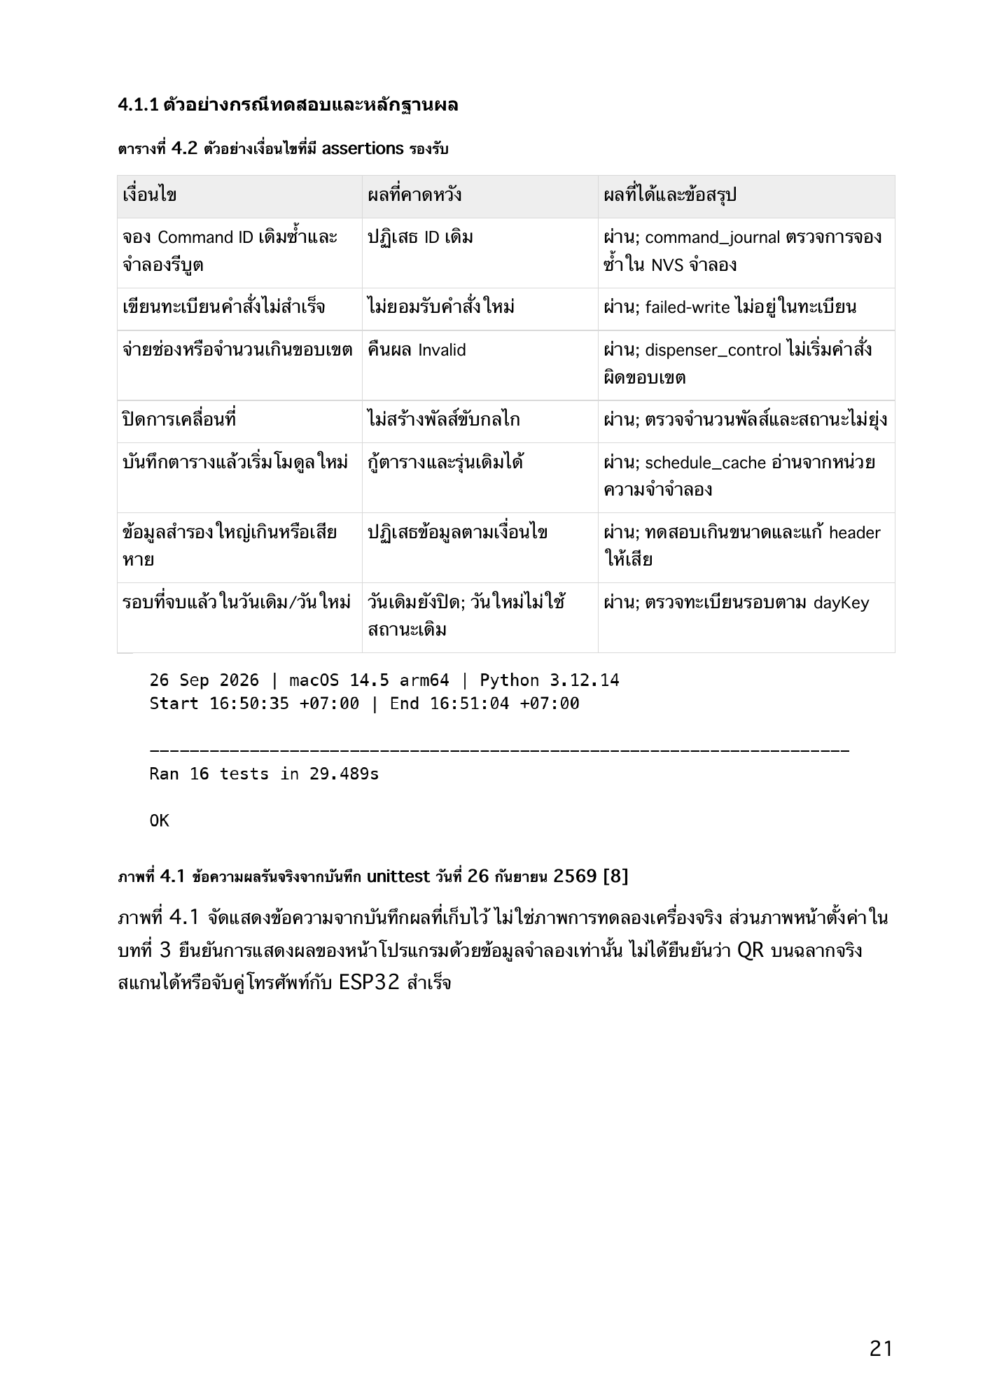
output/qa/final-render/page-26.png
