Comxt-i/smart-pill-dispenser/output/qa/final-render/page-30.png

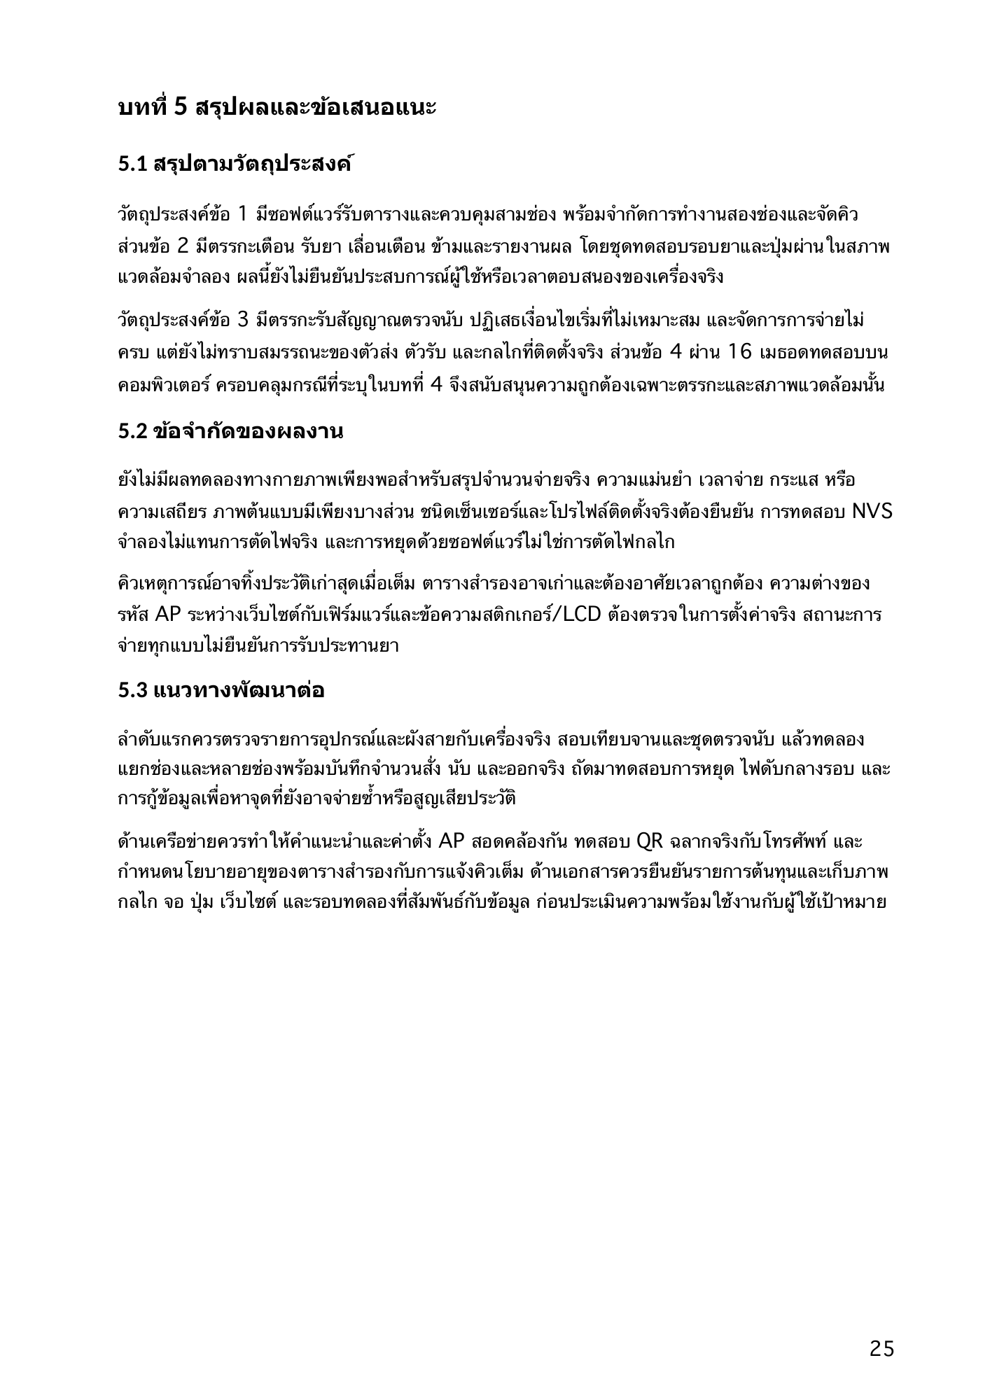
output/qa/final-render/page-30.png
