Comxt-i/smart-pill-dispenser/output/qa/final-render/page-31.png

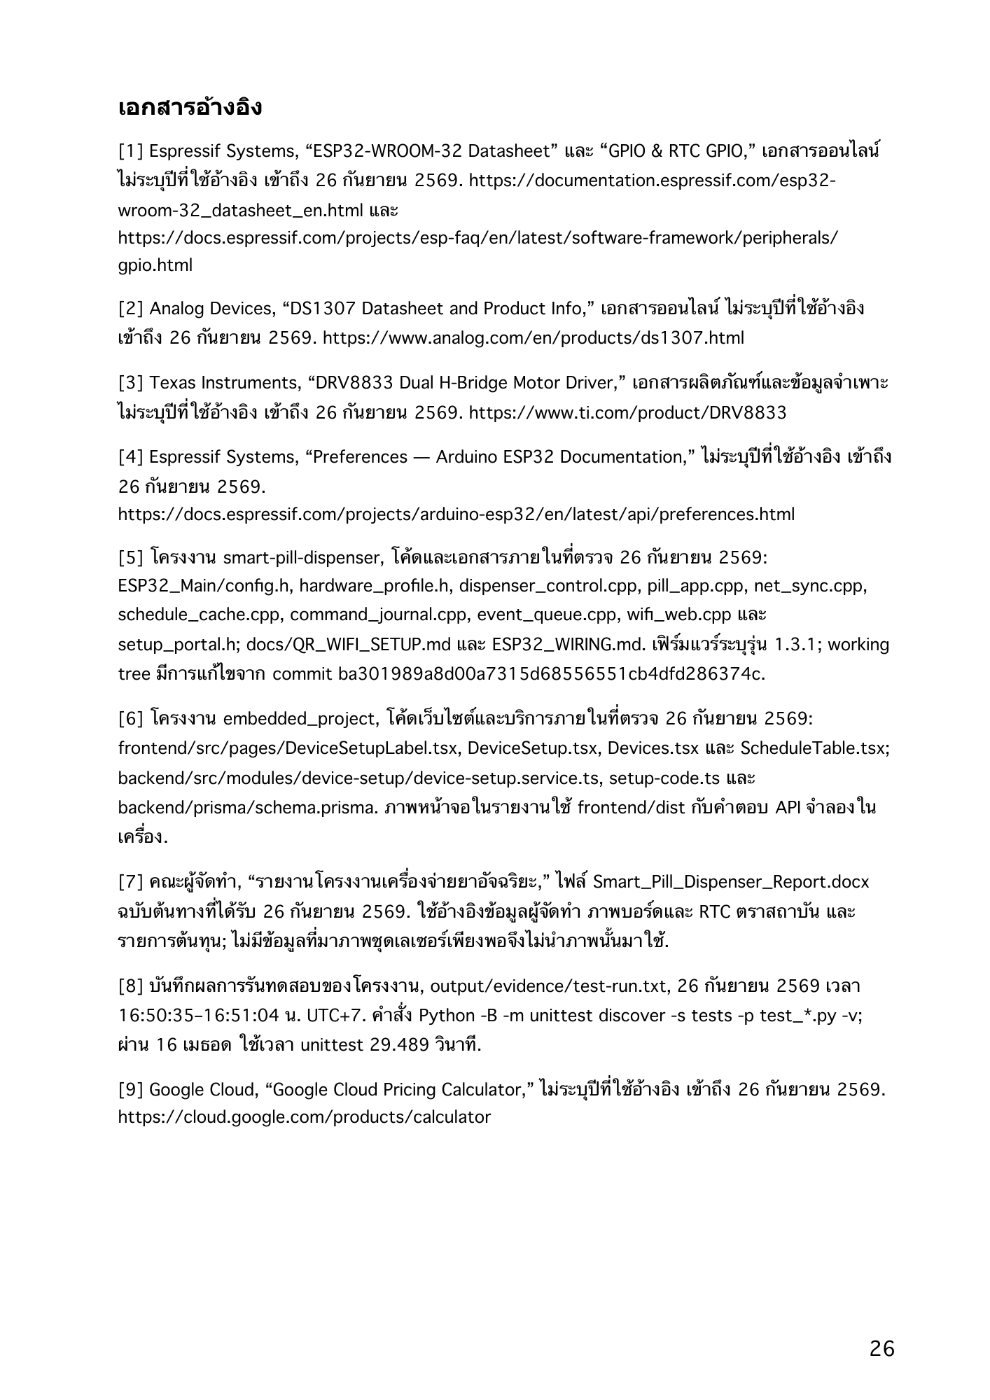
output/qa/final-render/page-31.png
