Comxt-i/smart-pill-dispenser/output/qa/image4.jpeg

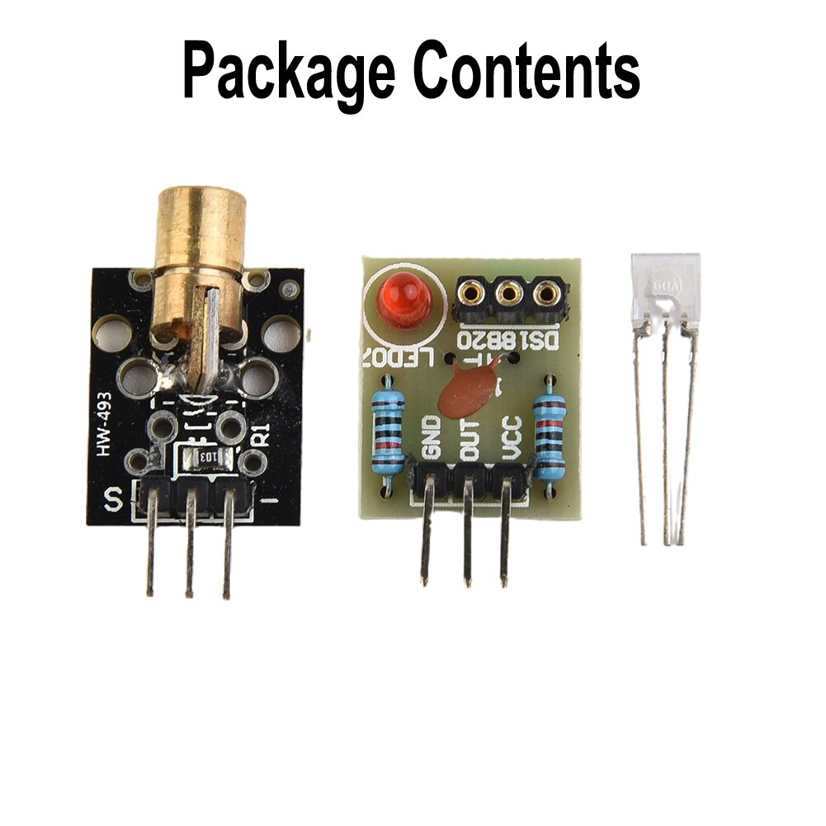
output/qa/image4.jpeg
