Comxt-i/smart-pill-dispenser/output/qa/mechanism.png

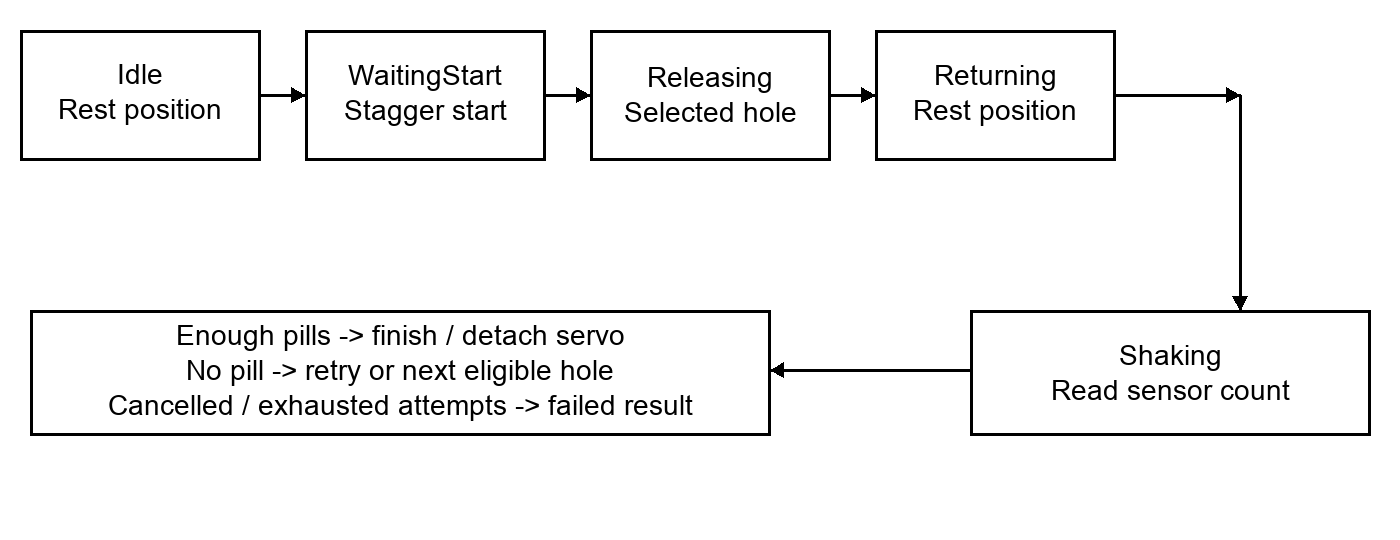
output/qa/mechanism.png
