Comxt-i/smart-pill-dispenser/output/qa/original-render/page-1.png

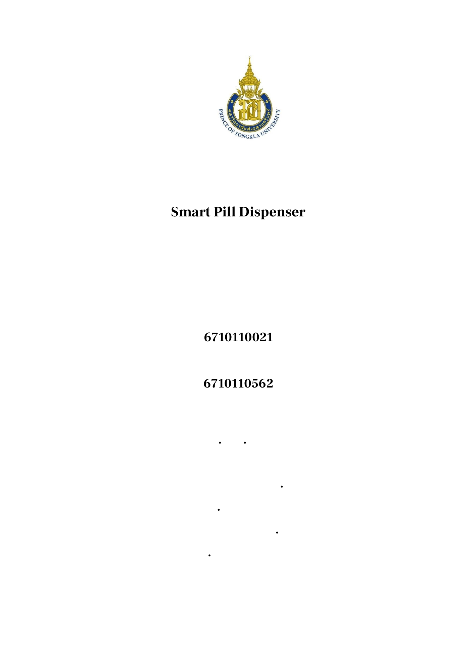
output/qa/original-render/page-1.png
