Comxt-i/smart-pill-dispenser/output/qa/original-render/page-2.png

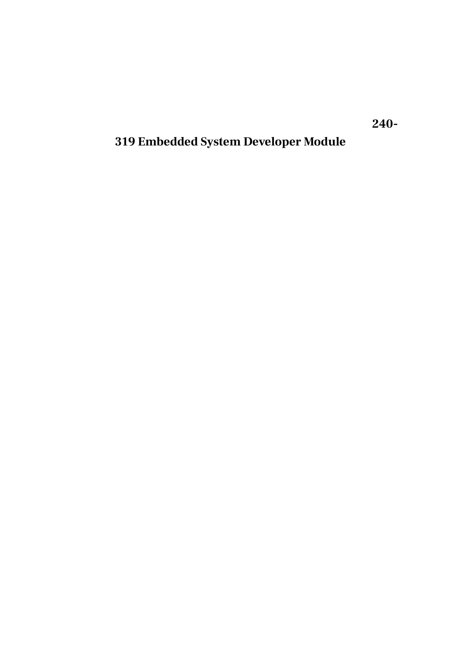
output/qa/original-render/page-2.png
