Comxt-i/smart-pill-dispenser/output/qa/original-render/page-3.png

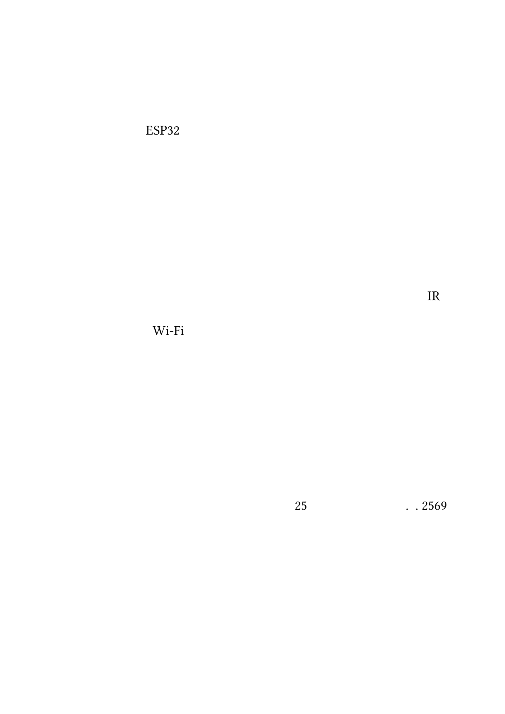
output/qa/original-render/page-3.png
