Comxt-i/smart-pill-dispenser/output/qa/original-render/page-4.png

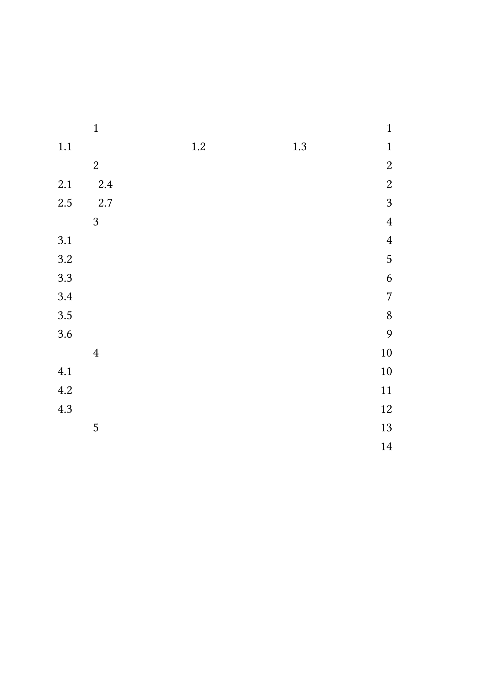
output/qa/original-render/page-4.png
