Comxt-i/smart-pill-dispenser/output/qa/original-render/page-5.png

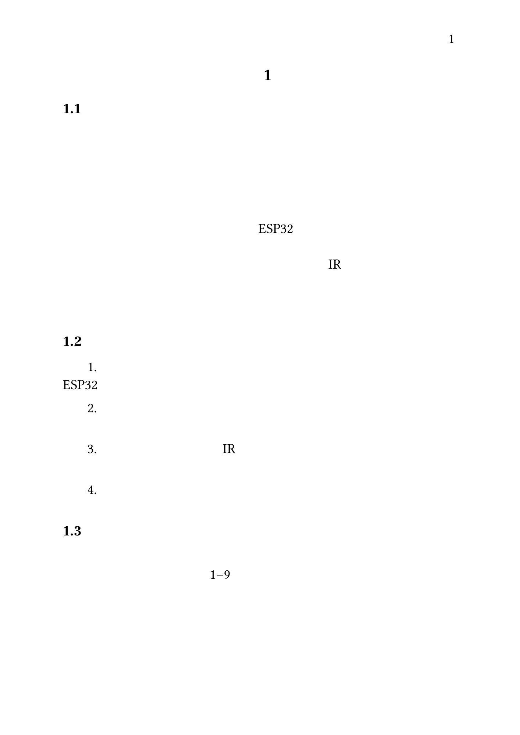
output/qa/original-render/page-5.png
