Comxt-i/smart-pill-dispenser/output/qa/original-render/page-6.png

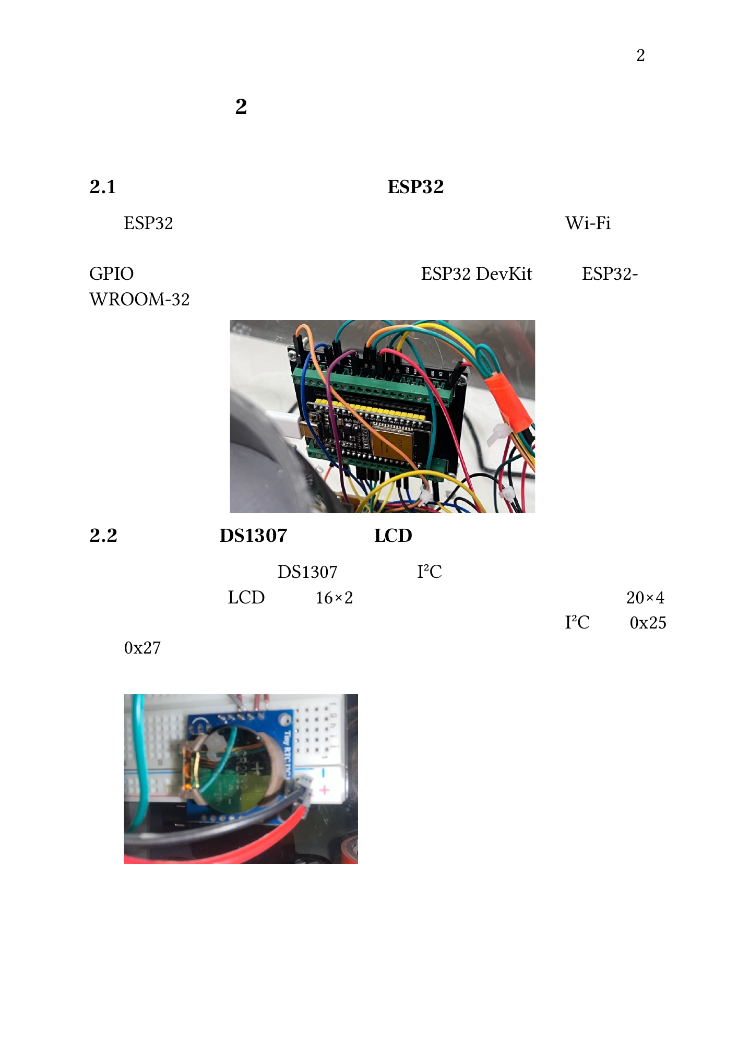
output/qa/original-render/page-6.png
