Comxt-i/smart-pill-dispenser/output/qa/original-render/page-7.png

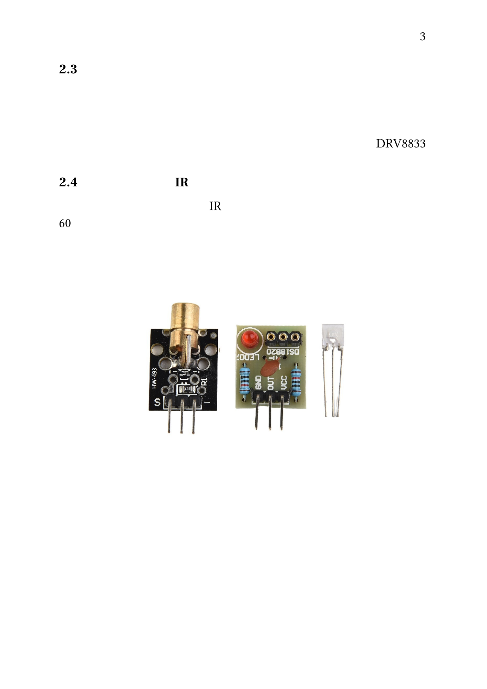
output/qa/original-render/page-7.png
