Comxt-i/smart-pill-dispenser/output/qa/original-render/page-8.png

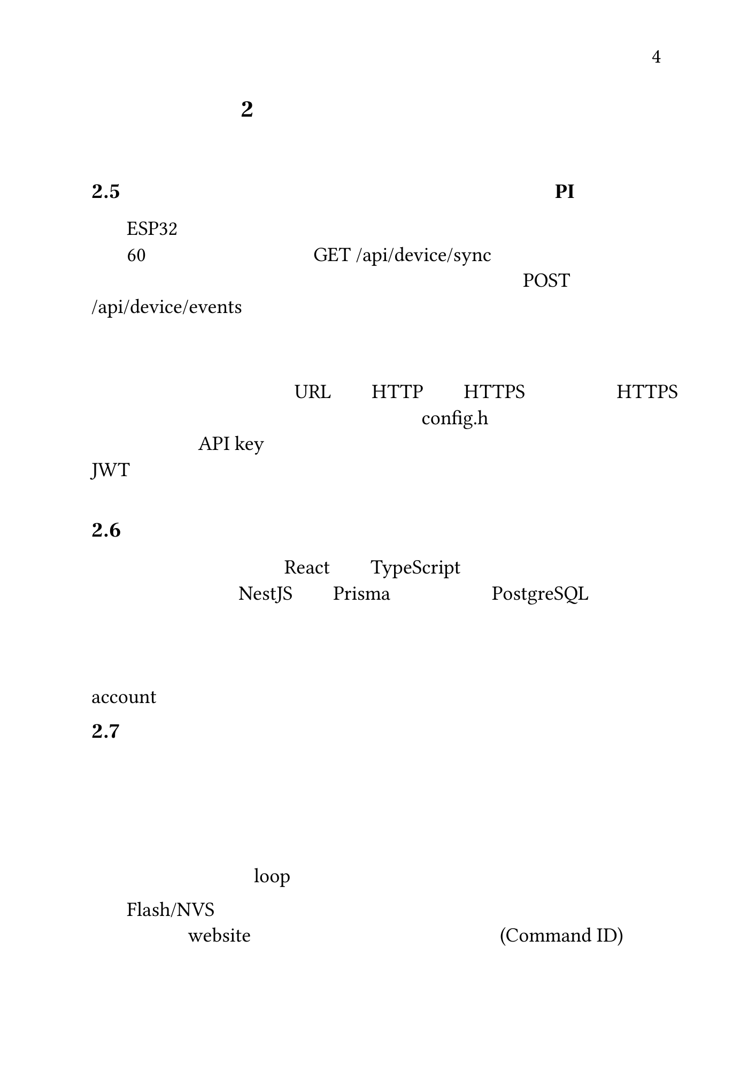
output/qa/original-render/page-8.png
