Comxt-i/smart-pill-dispenser/output/qa/original-render/page-10.png

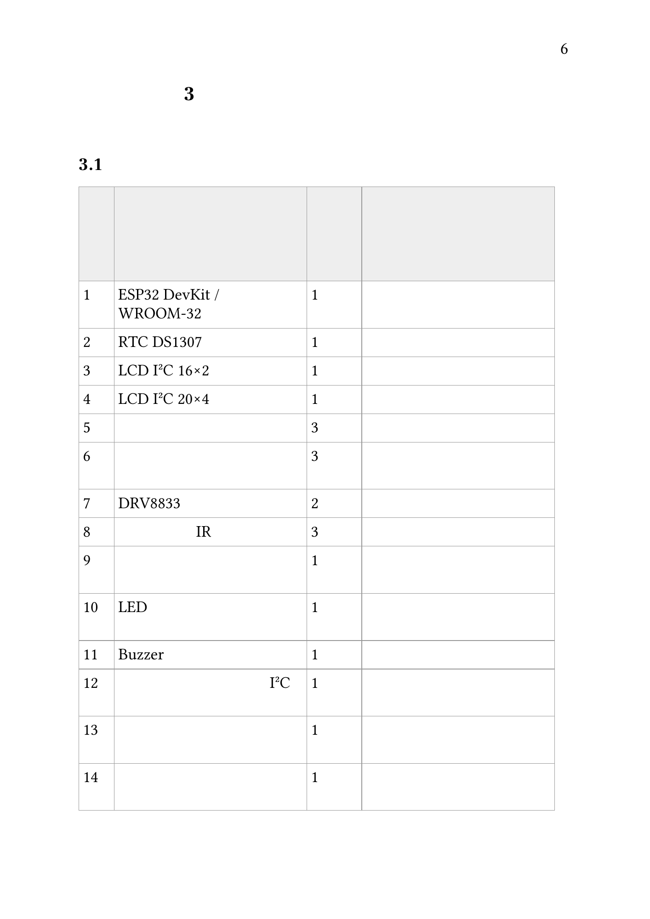
output/qa/original-render/page-10.png
