Comxt-i/smart-pill-dispenser/output/qa/original-render/page-12.png

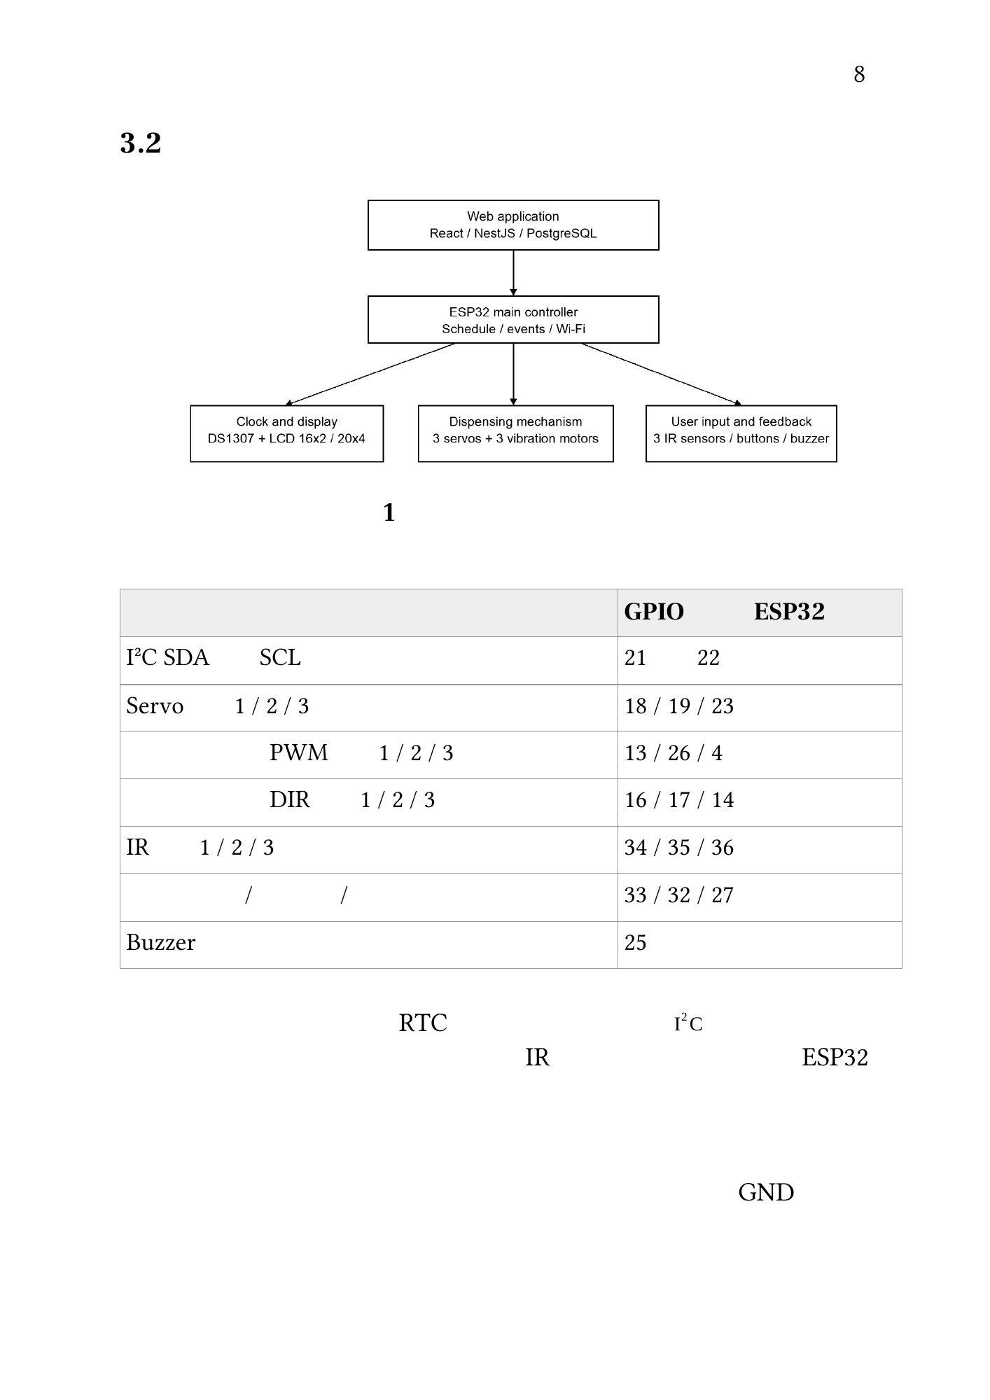
output/qa/original-render/page-12.png
