Comxt-i/smart-pill-dispenser/output/qa/original-render/page-14.png

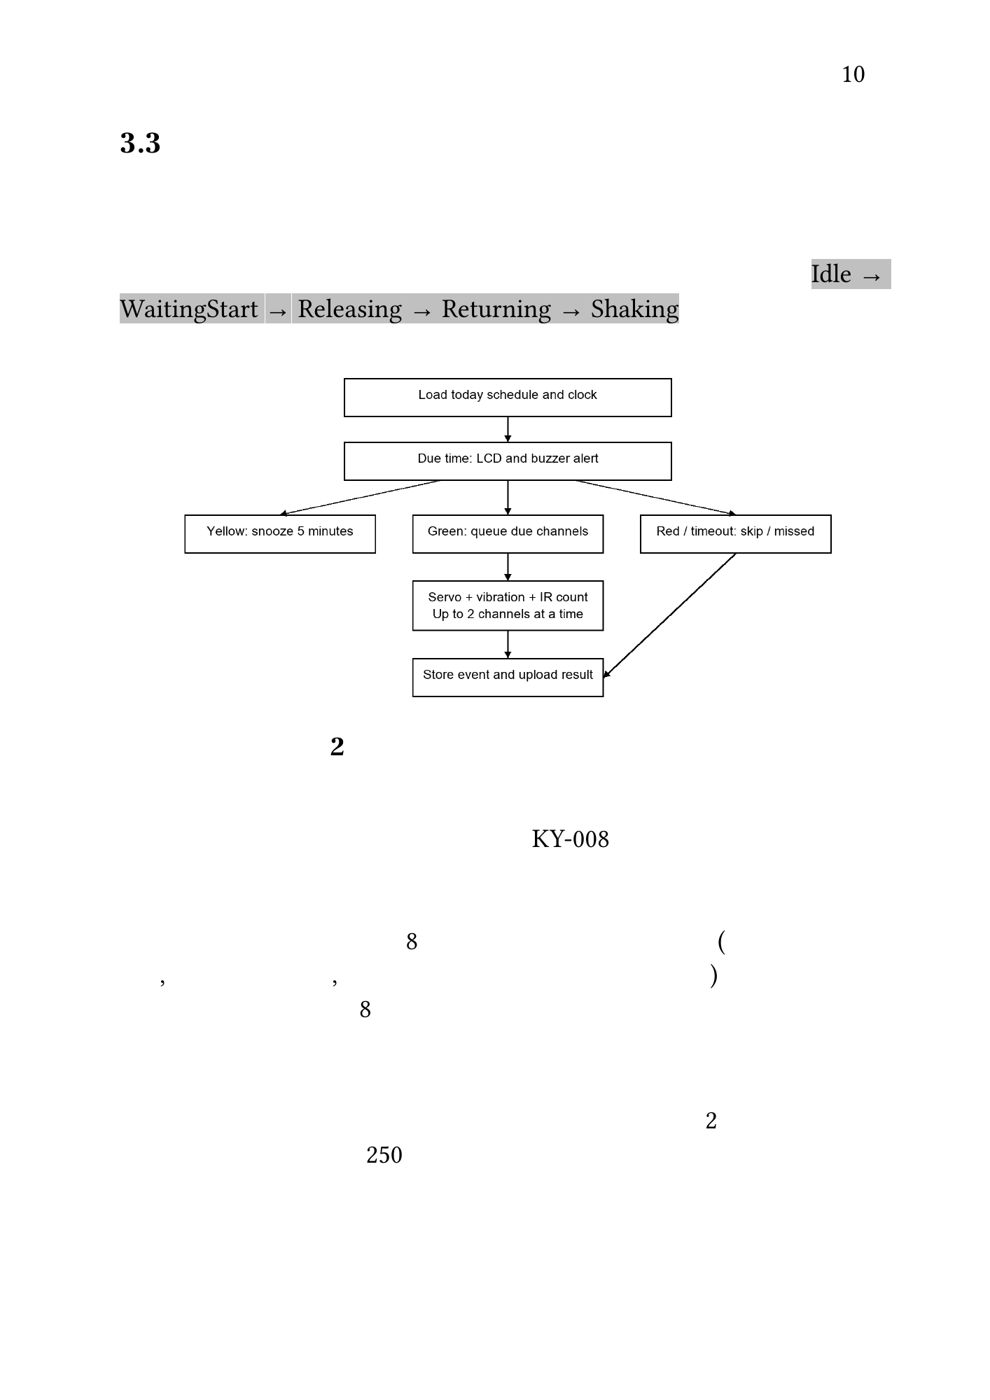
output/qa/original-render/page-14.png
