Comxt-i/smart-pill-dispenser/output/qa/original-render/page-15.png

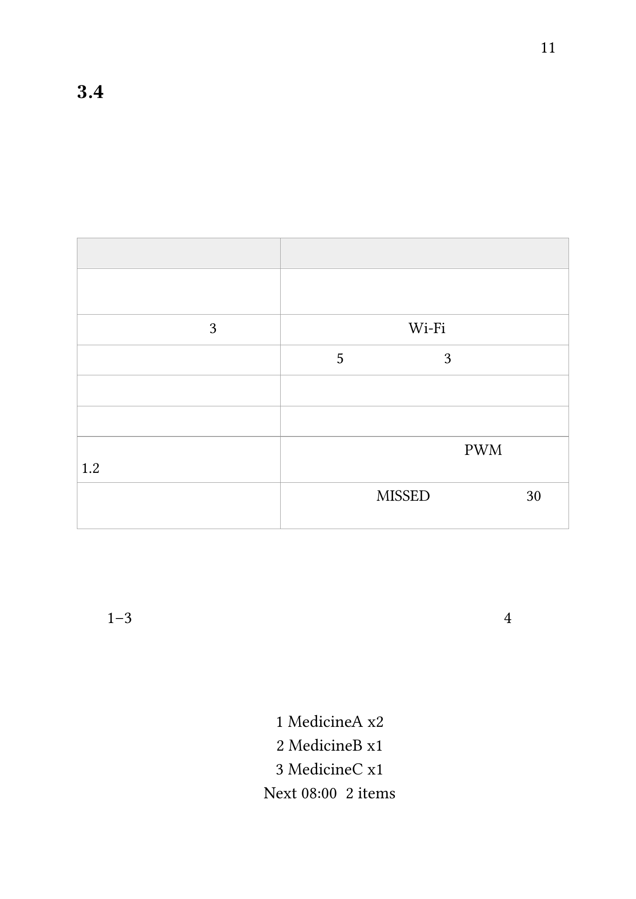
output/qa/original-render/page-15.png
