Comxt-i/smart-pill-dispenser/output/qa/original-render/page-17.png

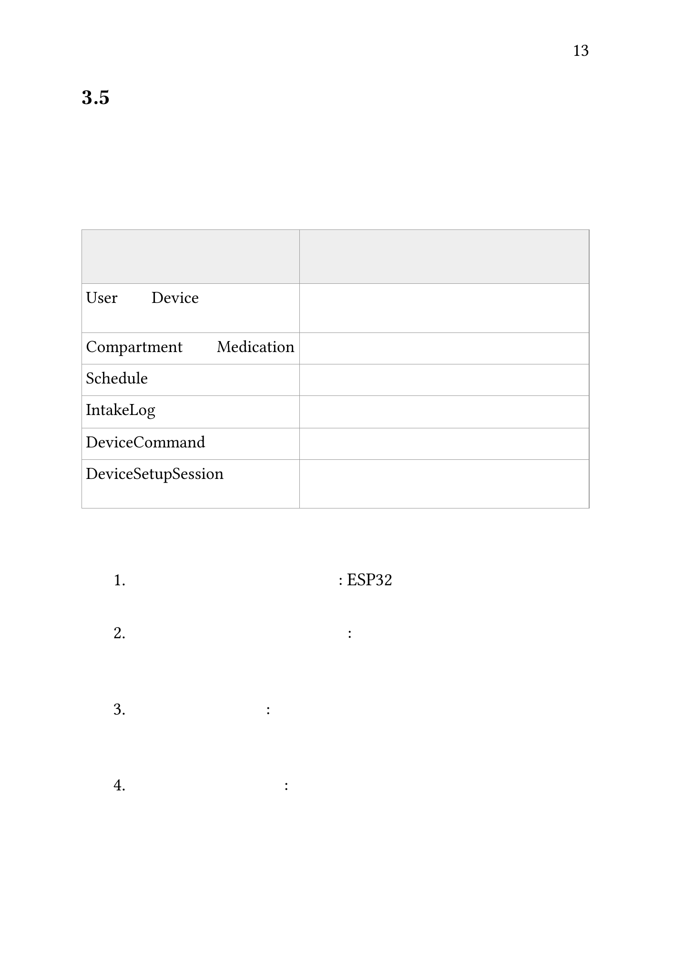
output/qa/original-render/page-17.png
