Comxt-i/smart-pill-dispenser/output/qa/original-render/page-18.png

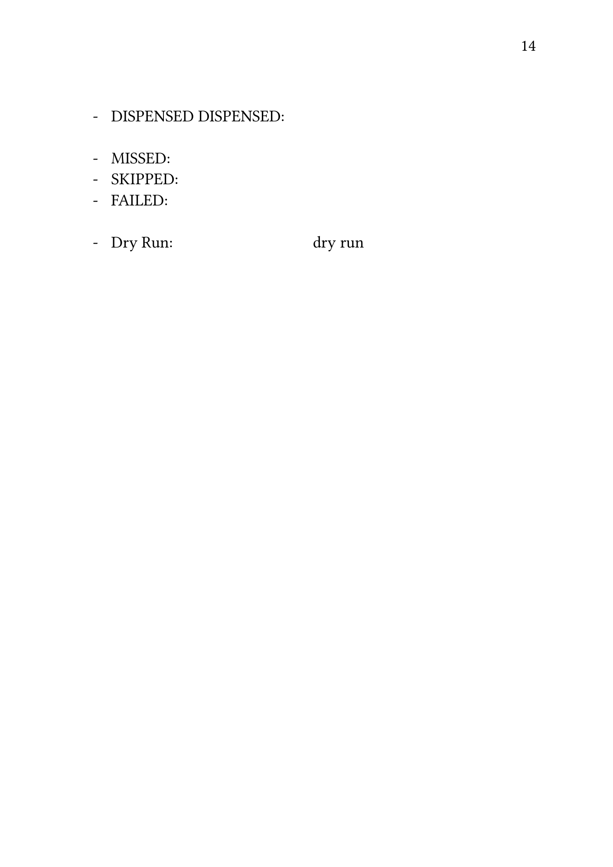
output/qa/original-render/page-18.png
