Comxt-i/smart-pill-dispenser/output/qa/original-render/page-19.png

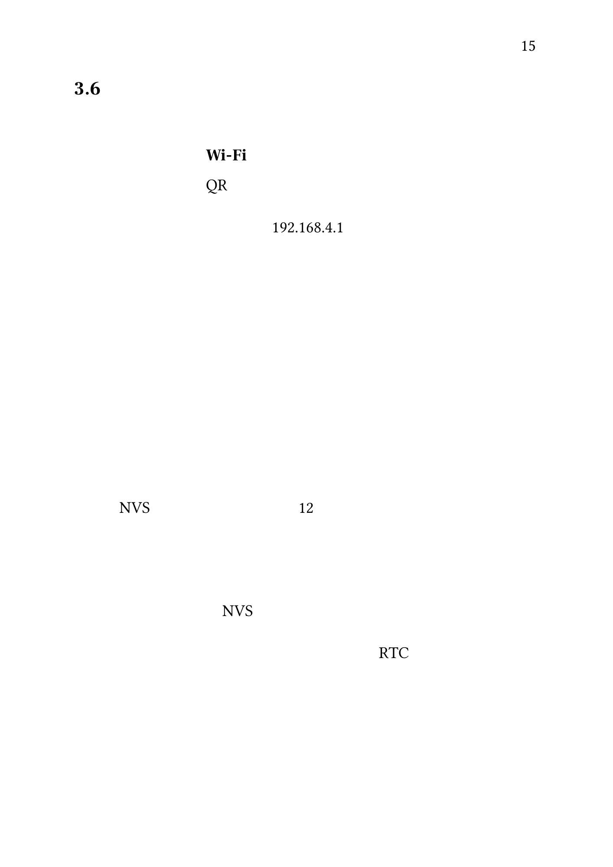
output/qa/original-render/page-19.png
