Comxt-i/smart-pill-dispenser/output/qa/original-render/page-22.png

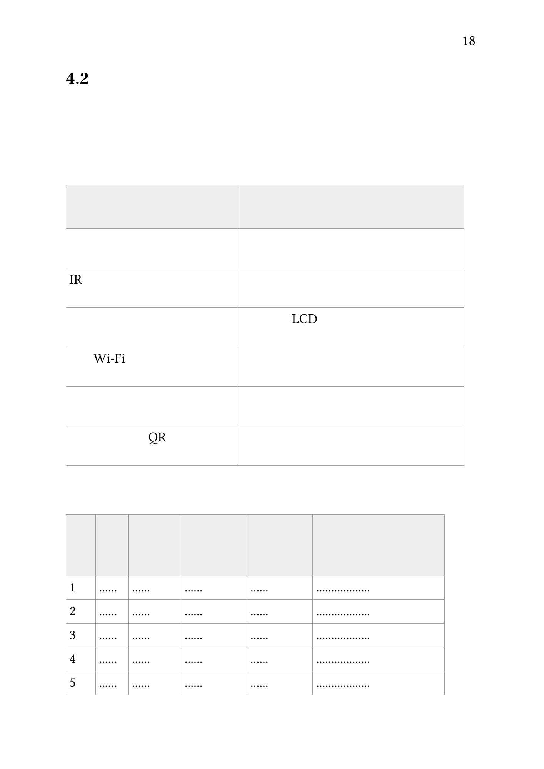
output/qa/original-render/page-22.png
