Comxt-i/smart-pill-dispenser/output/qa/original-render/page-24.png

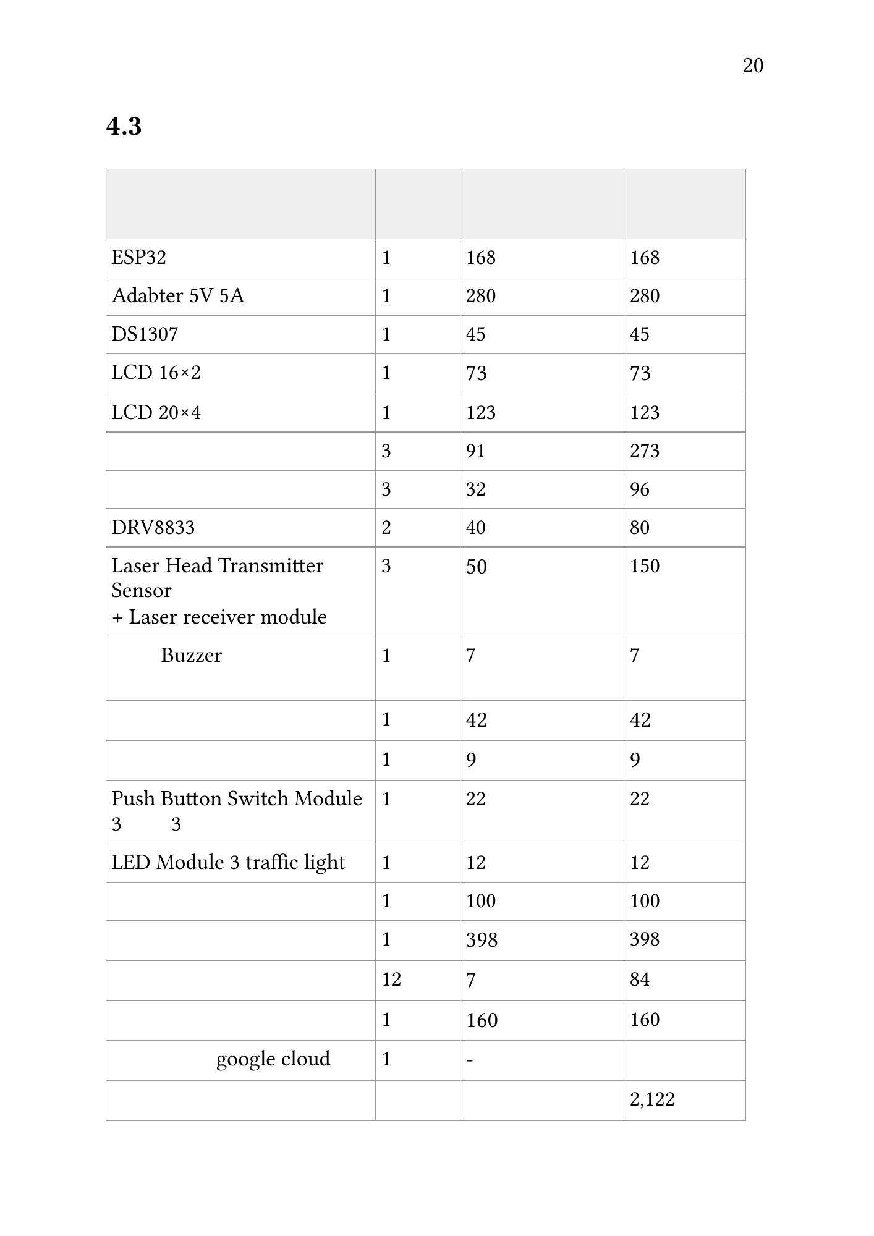
output/qa/original-render/page-24.png
