Comxt-i/smart-pill-dispenser/output/qa/original-render/page-25.png

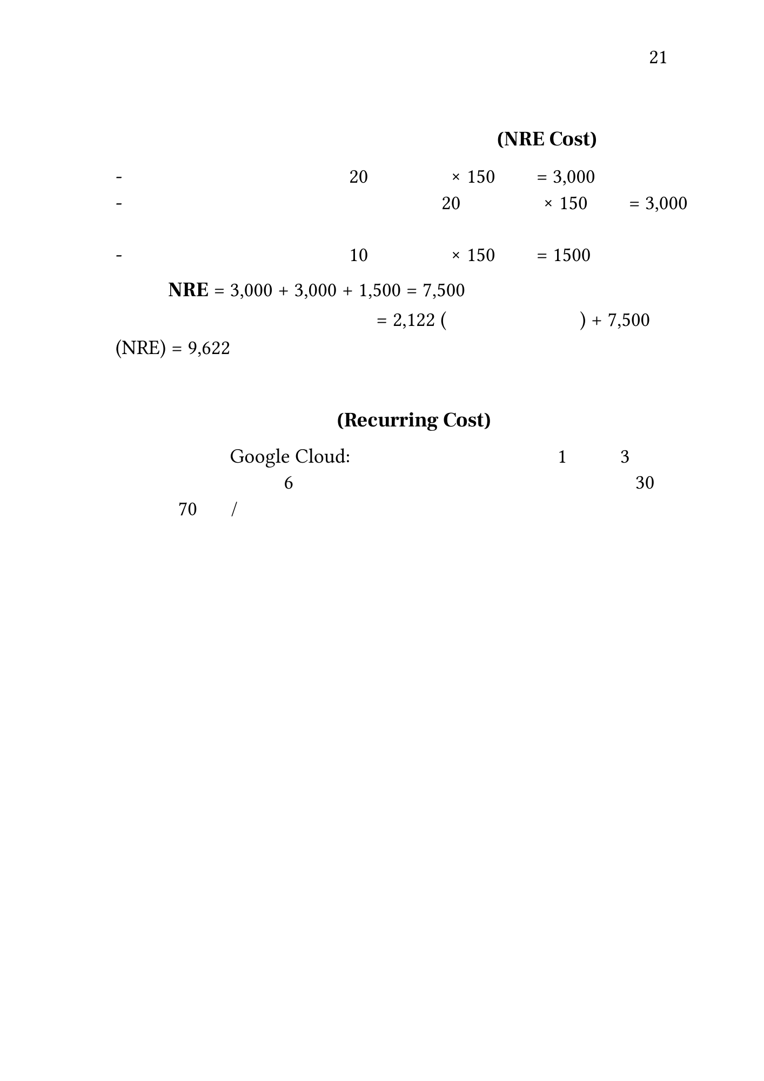
output/qa/original-render/page-25.png
