Comxt-i/smart-pill-dispenser/output/qa/original-render/page-26.png

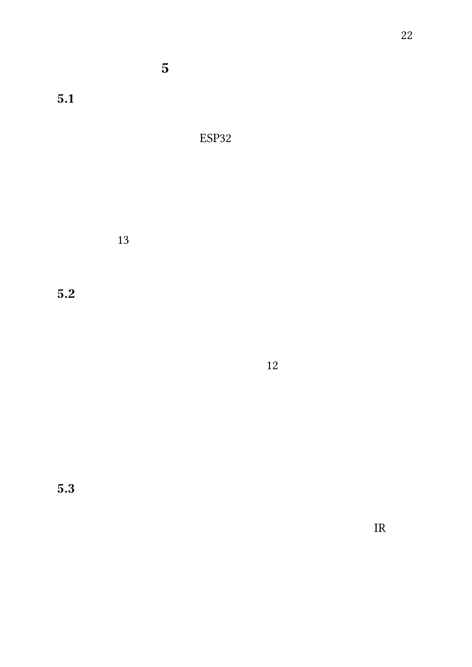
output/qa/original-render/page-26.png
