Comxt-i/smart-pill-dispenser/output/qa/original-sheet-0.jpg

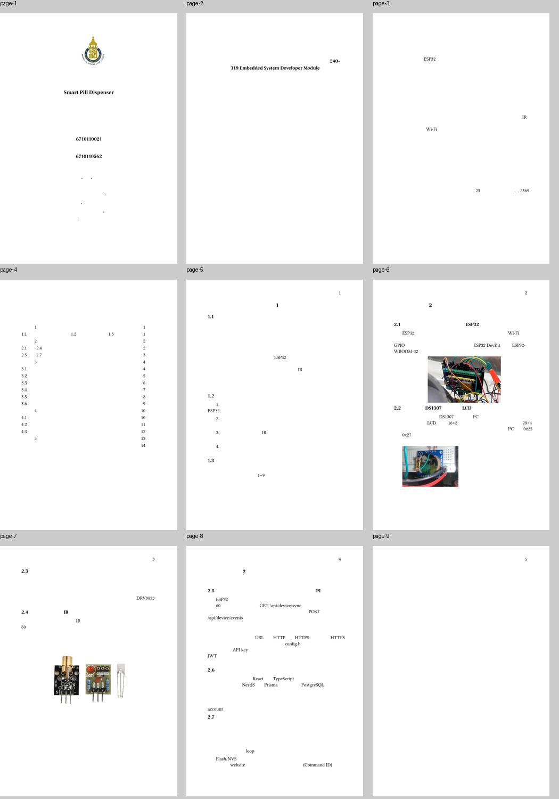
output/qa/original-sheet-0.jpg
