Comxt-i/smart-pill-dispenser/output/qa/original-sheet-1.jpg

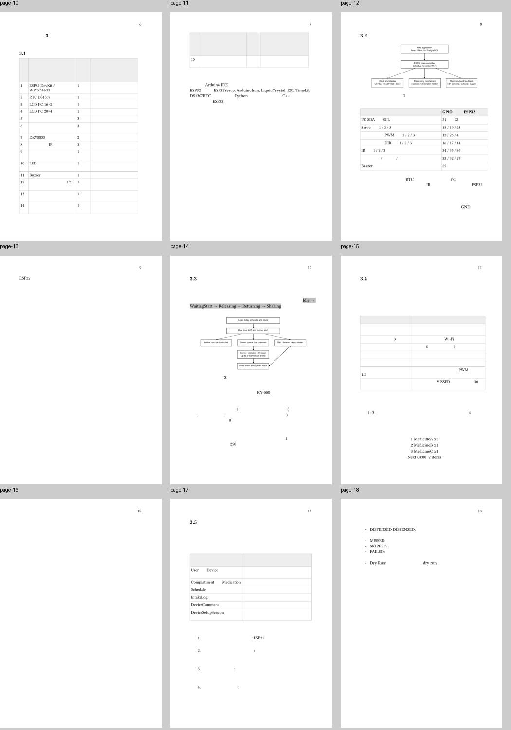
output/qa/original-sheet-1.jpg
