Comxt-i/smart-pill-dispenser/output/qa/original-sheet-2.jpg

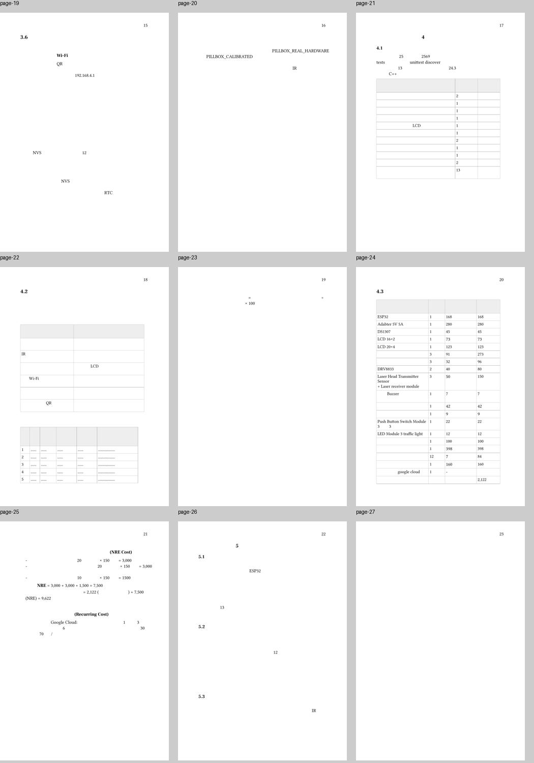
output/qa/original-sheet-2.jpg
