Comxt-i/smart-pill-dispenser/output/qa/portal.png

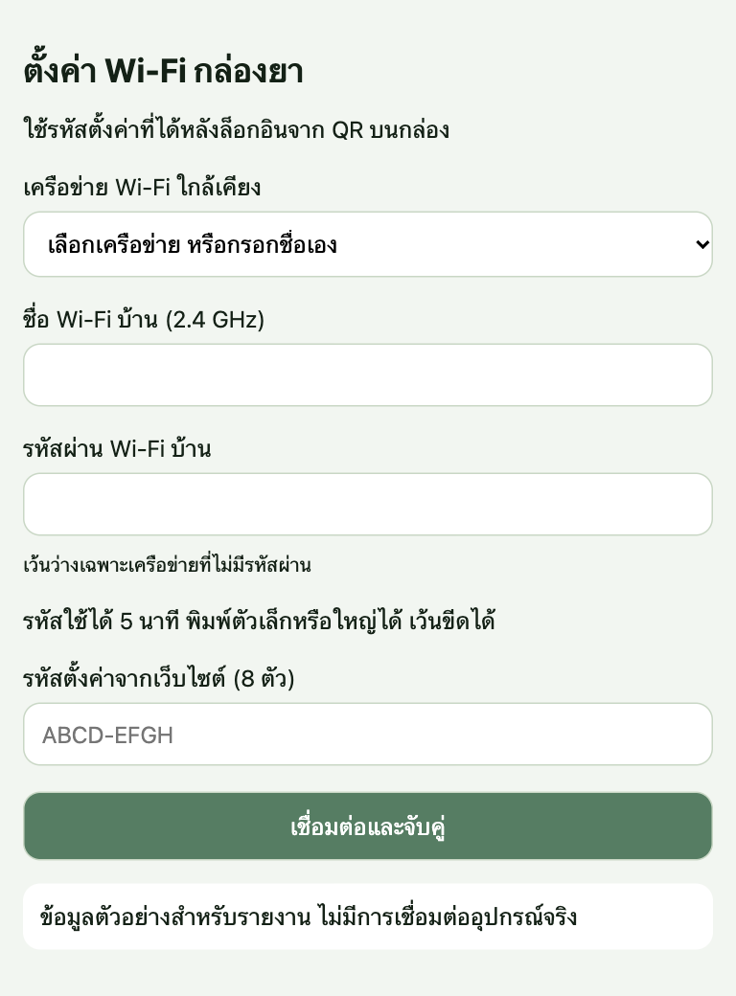
output/qa/portal.png
