Comxt-i/smart-pill-dispenser/output/qa/power.png

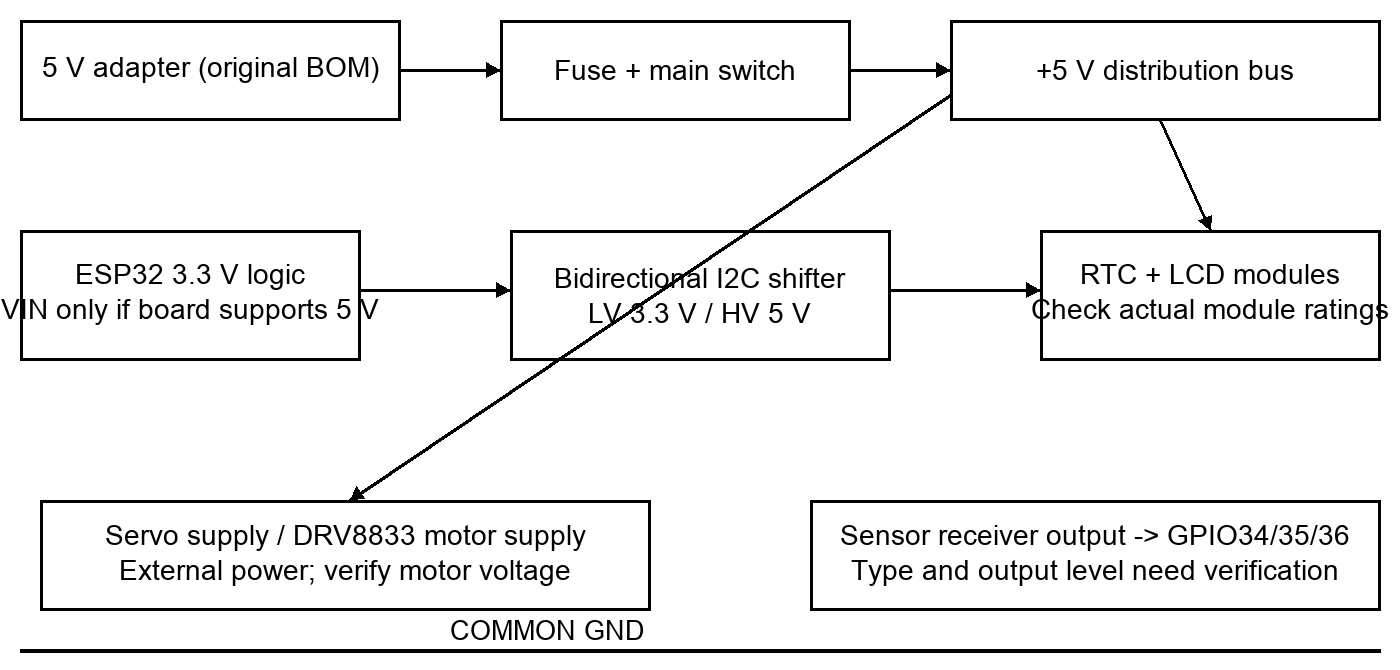
output/qa/power.png
