Comxt-i/smart-pill-dispenser/output/qa/revised-render/page-20.png

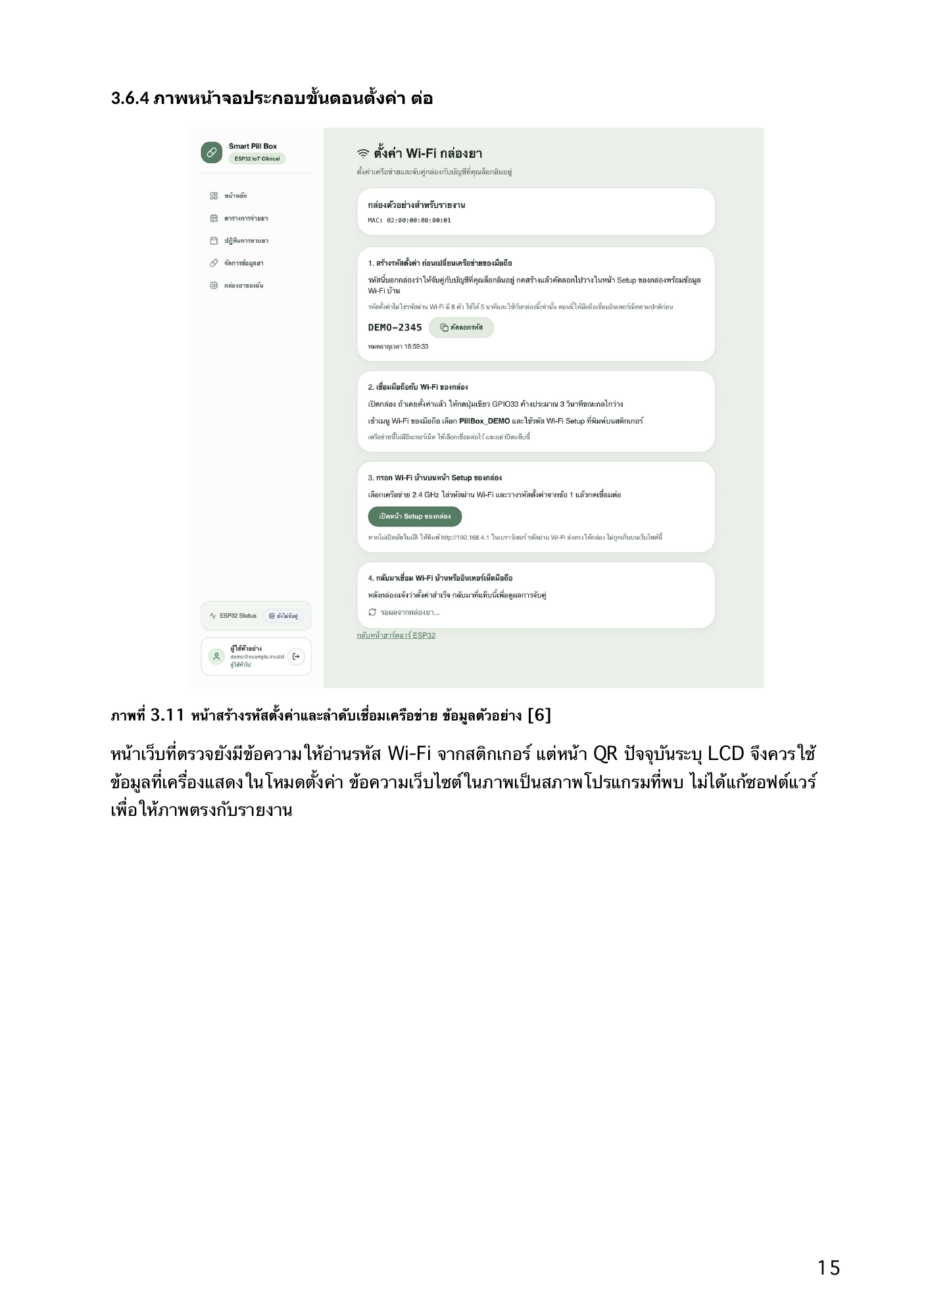
output/qa/revised-render/page-20.png
