Comxt-i/smart-pill-dispenser/output/qa/revised-render/page-21.png

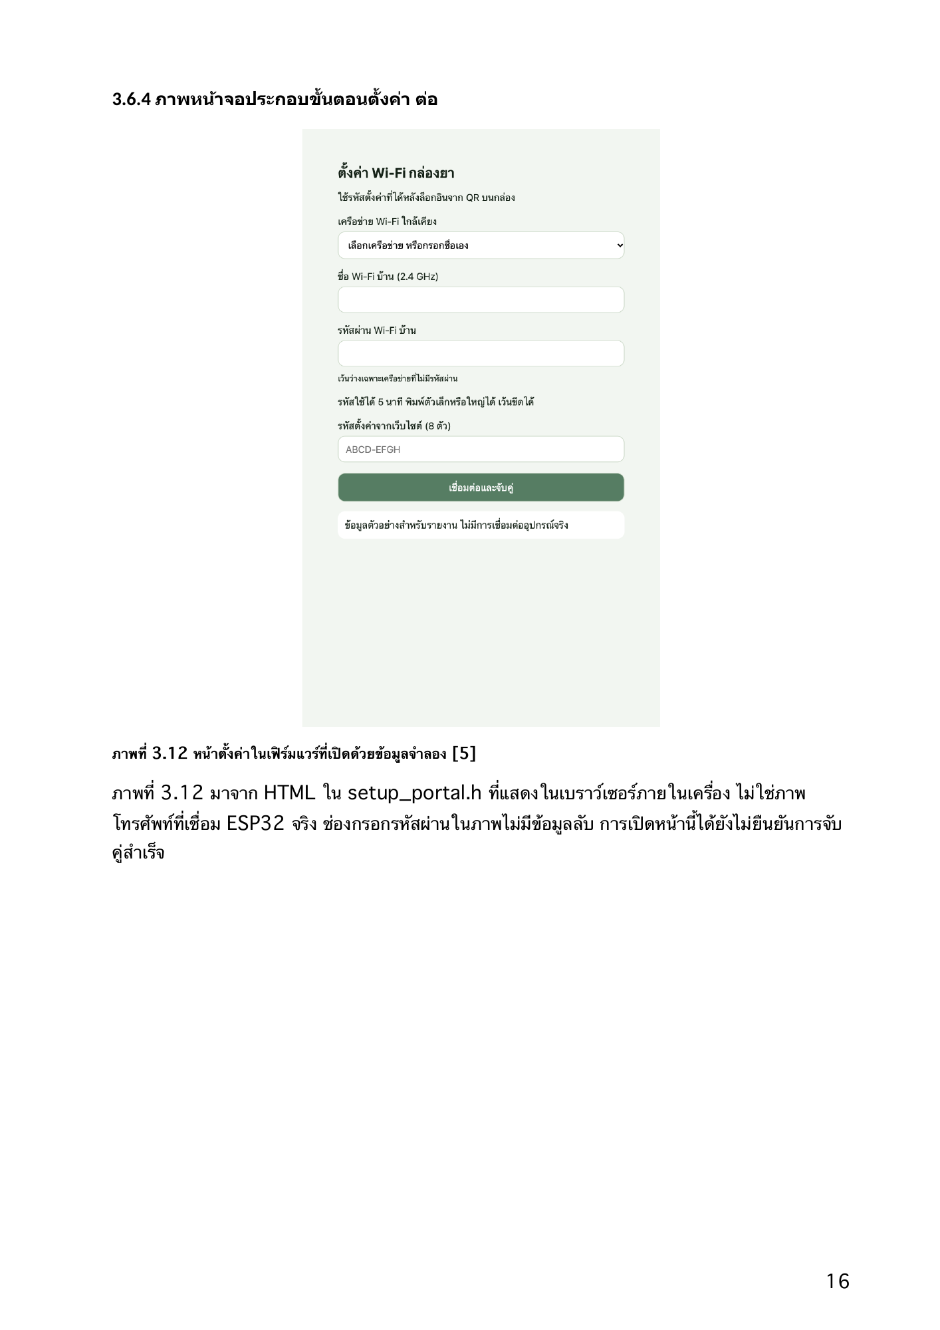
output/qa/revised-render/page-21.png
