Comxt-i/smart-pill-dispenser/output/qa/revised-render/page-27.png

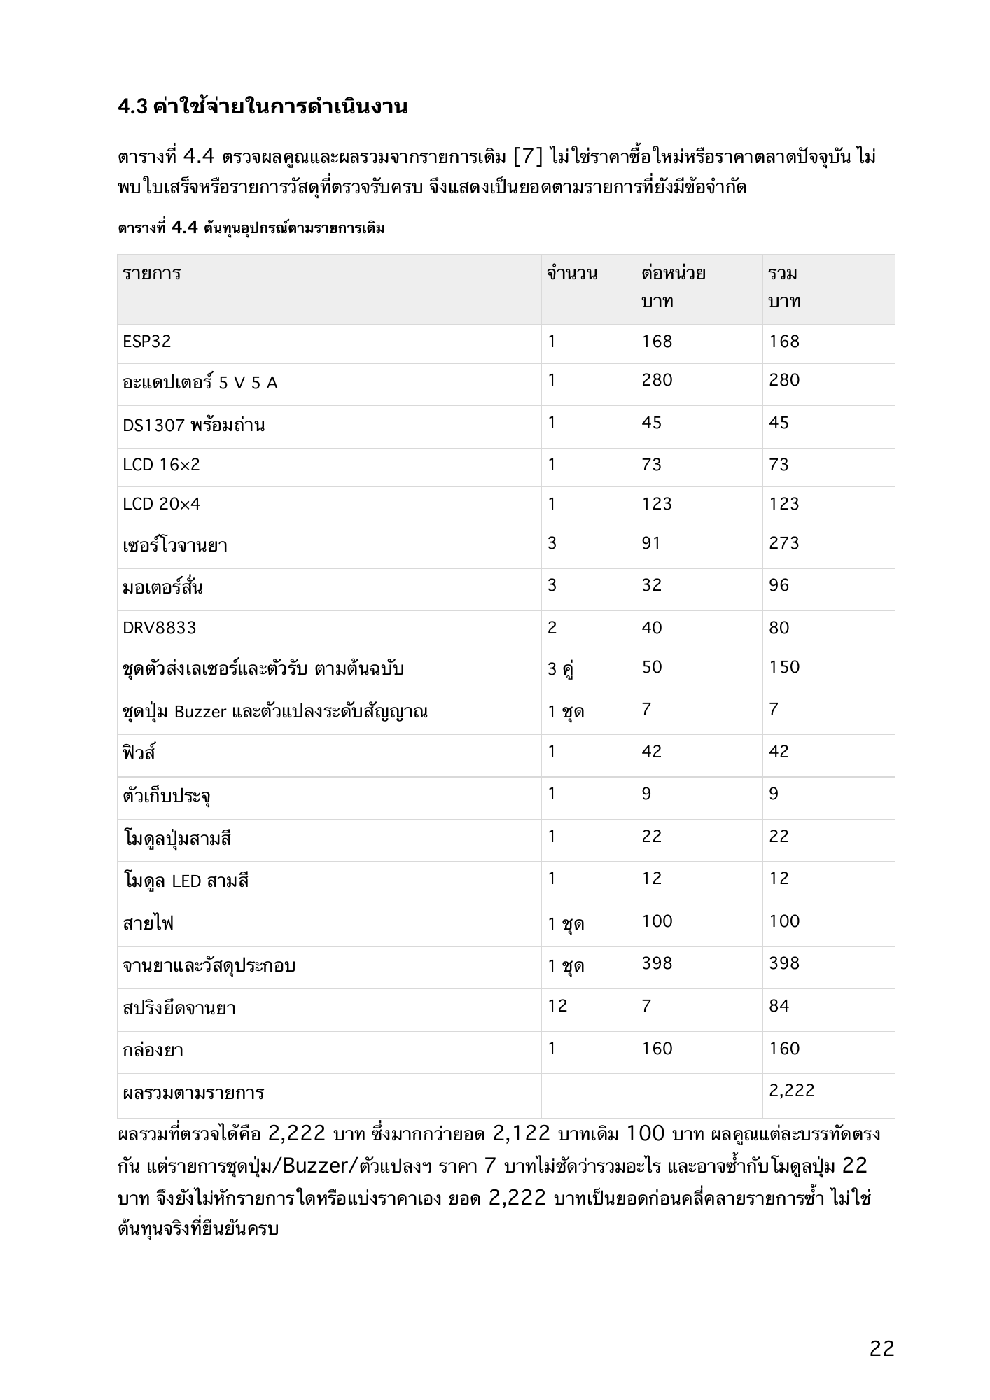
output/qa/revised-render/page-27.png
