Comxt-i/smart-pill-dispenser/output/qa/revised-render/page-28.png

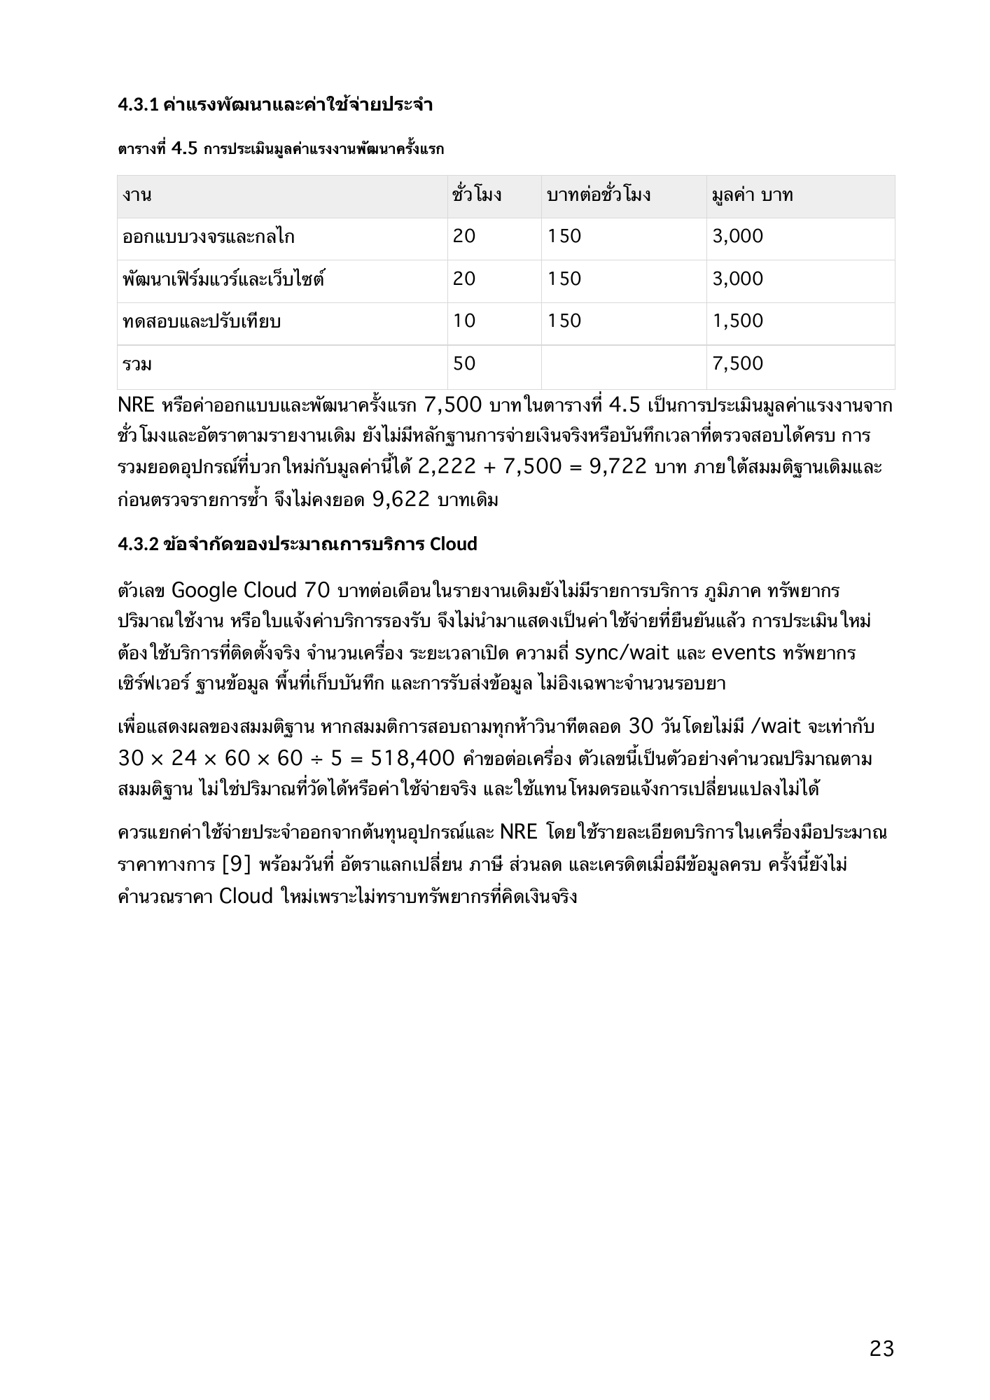
output/qa/revised-render/page-28.png
