Comxt-i/smart-pill-dispenser/output/qa/revised-render/page-31.png

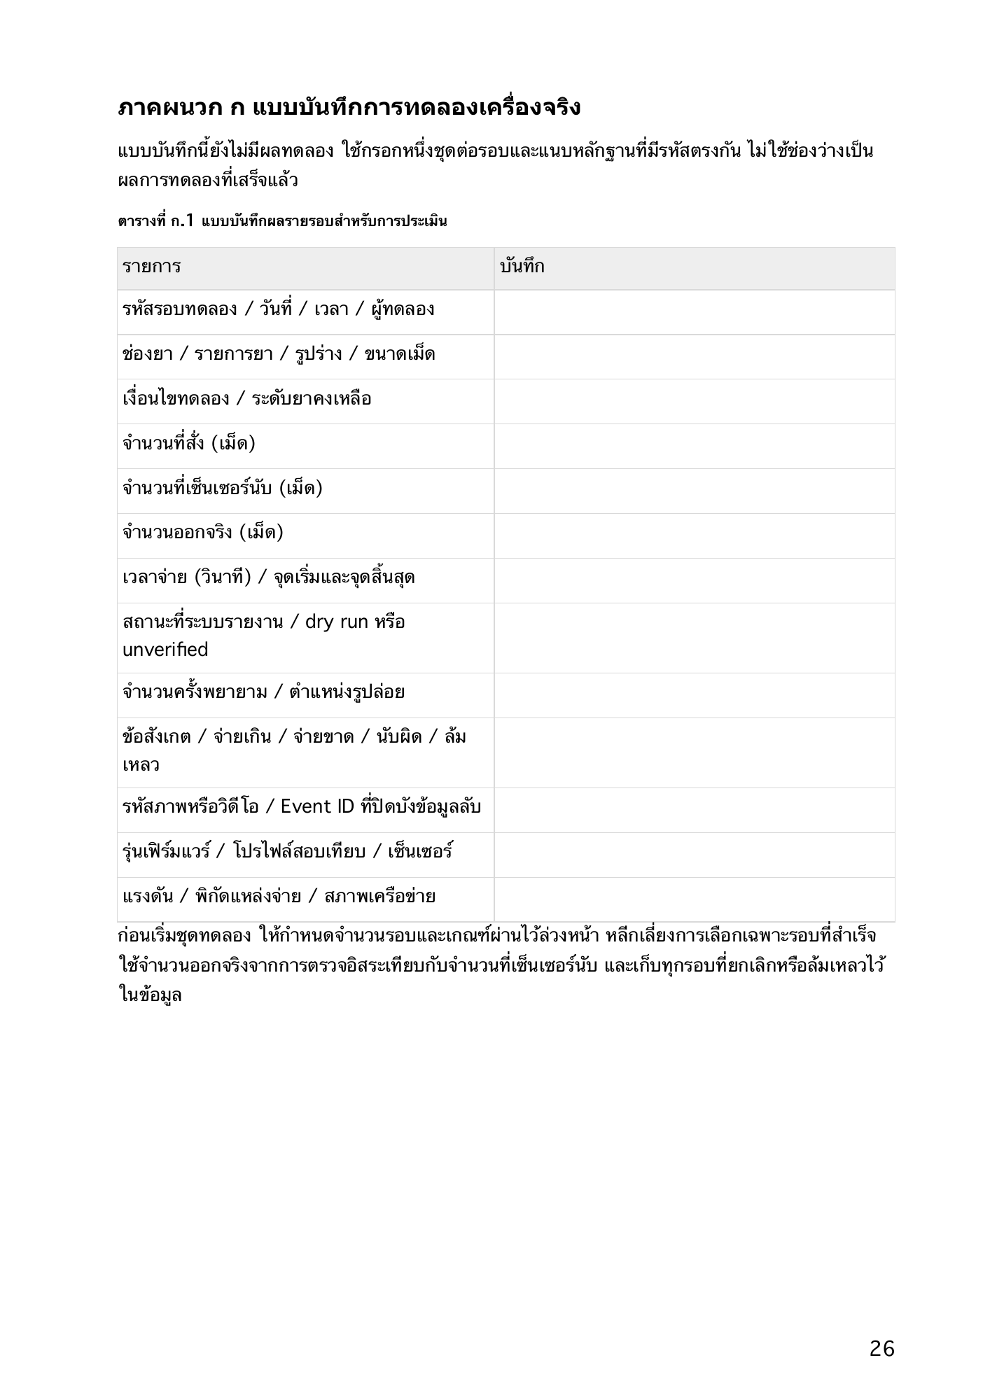
output/qa/revised-render/page-31.png
