Comxt-i/smart-pill-dispenser/output/qa/revised-sheet-0.jpg

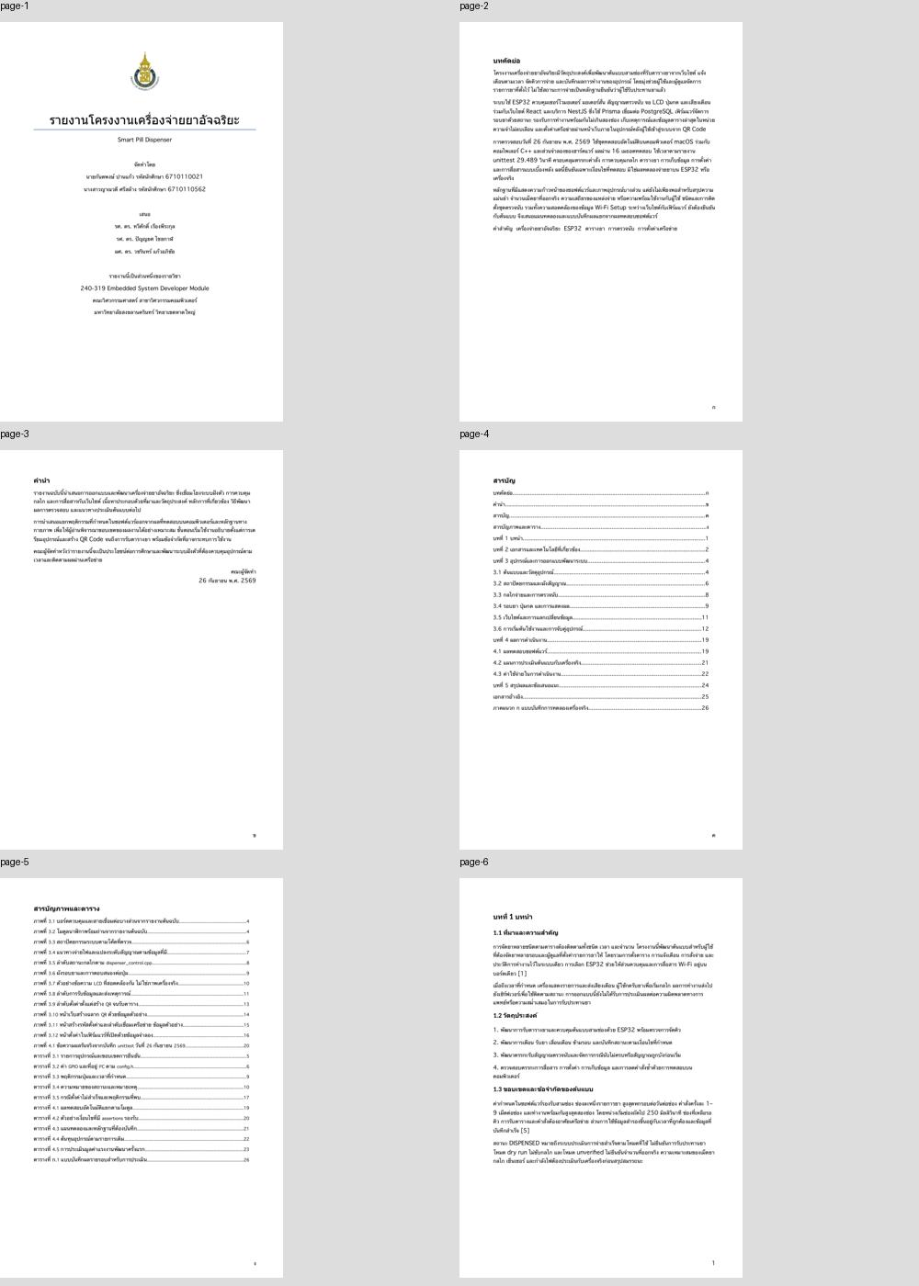
output/qa/revised-sheet-0.jpg
