Comxt-i/smart-pill-dispenser/output/qa/revised-sheet-1.jpg

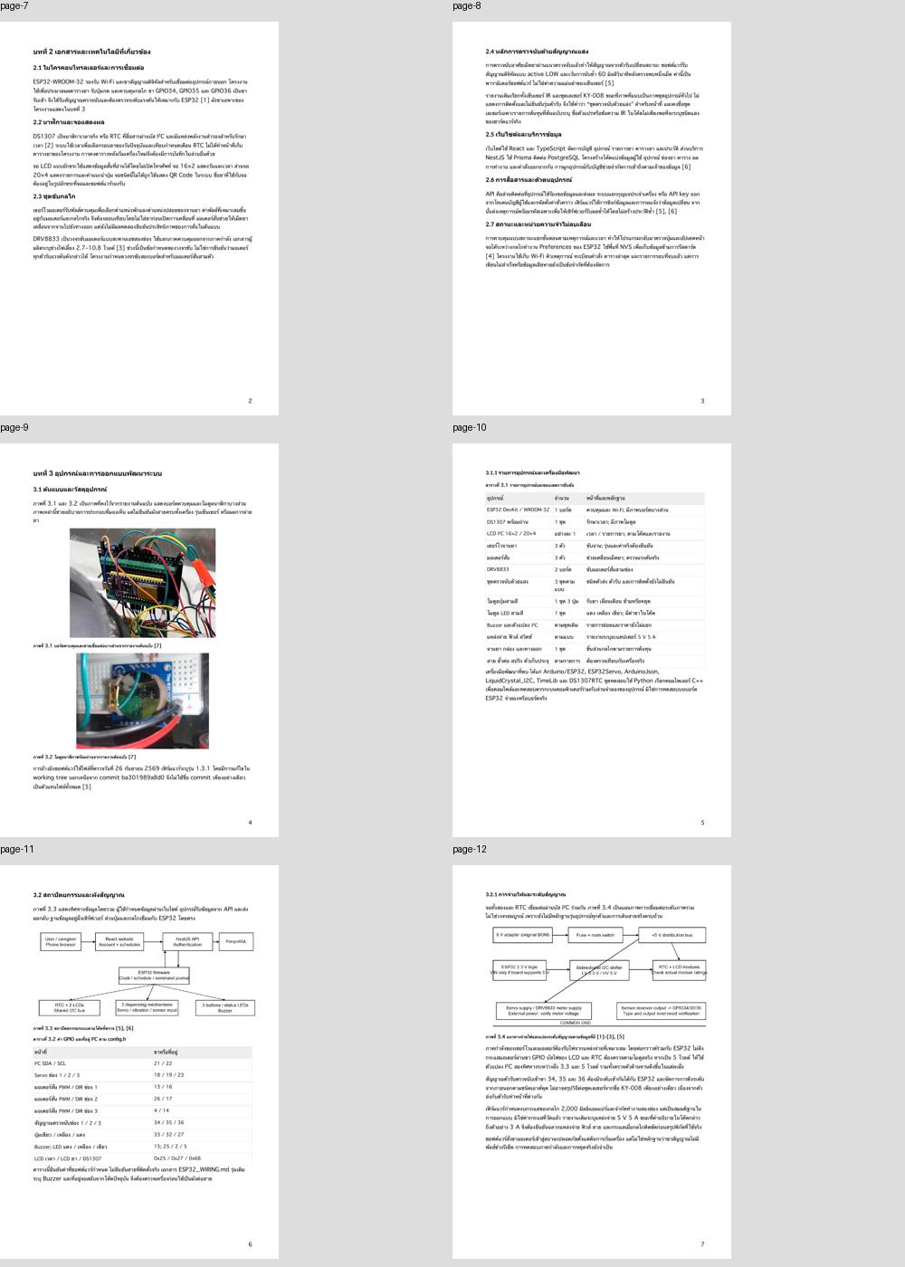
output/qa/revised-sheet-1.jpg
