Comxt-i/smart-pill-dispenser/output/qa/revised-sheet-4.jpg

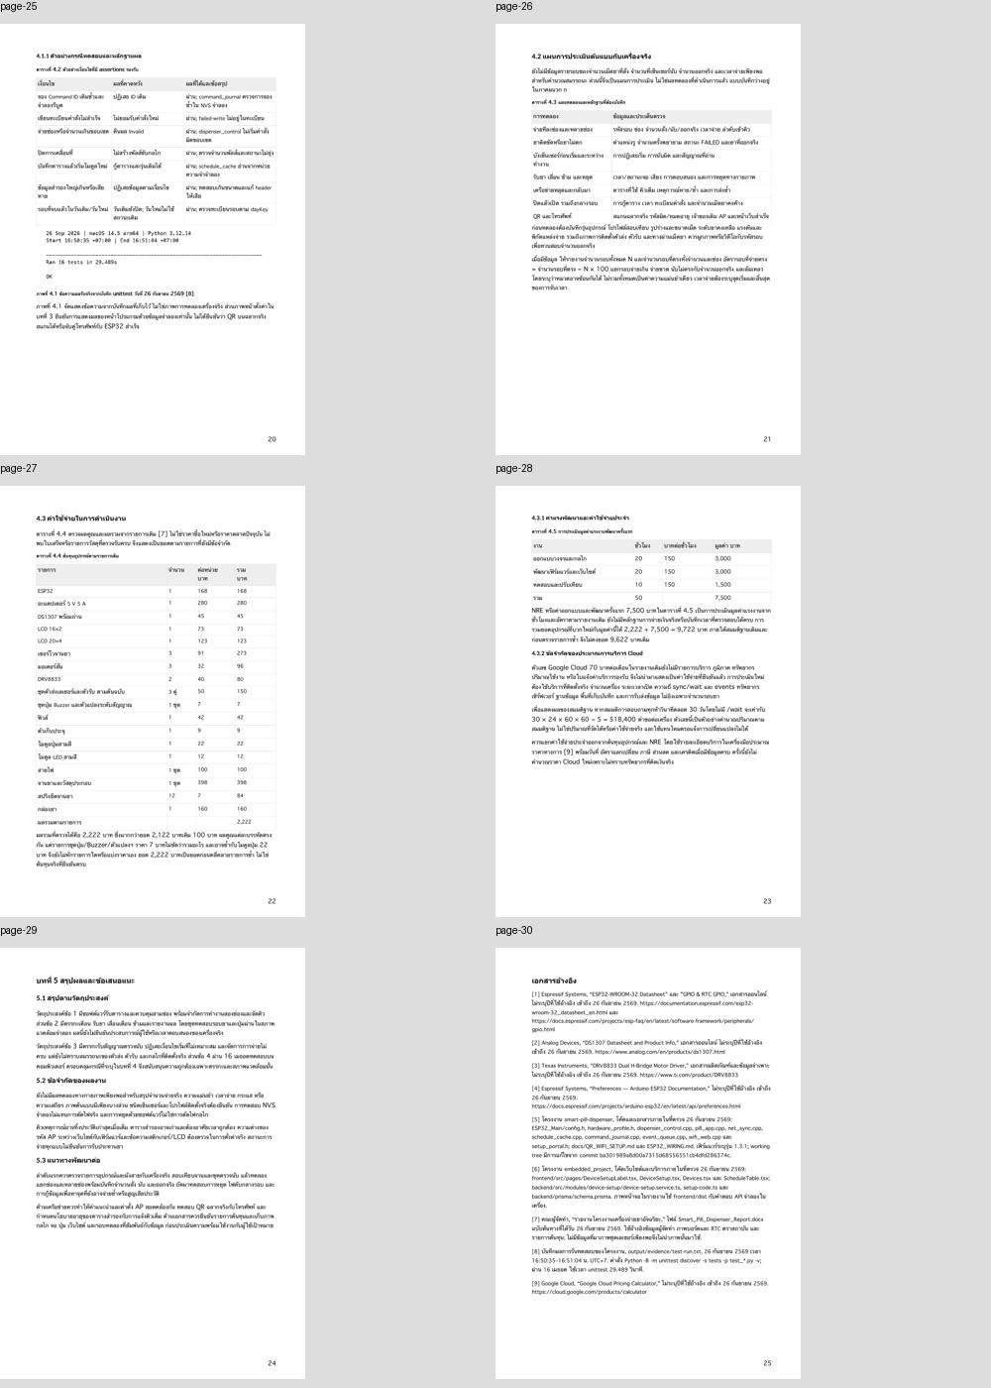
output/qa/revised-sheet-4.jpg
