Comxt-i/smart-pill-dispenser/output/qa/revised-sheet-5.jpg

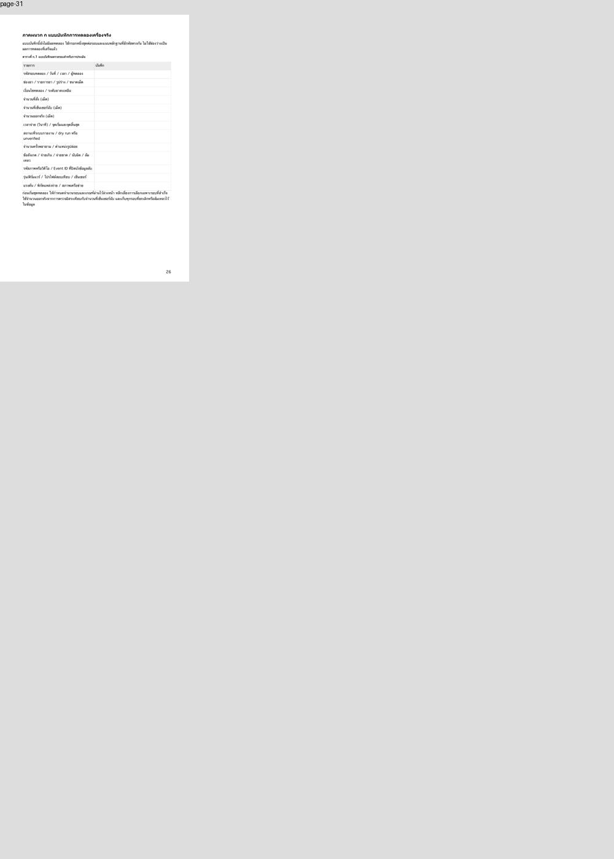
output/qa/revised-sheet-5.jpg
