Comxt-i/smart-pill-dispenser/output/qa/test-evidence.png

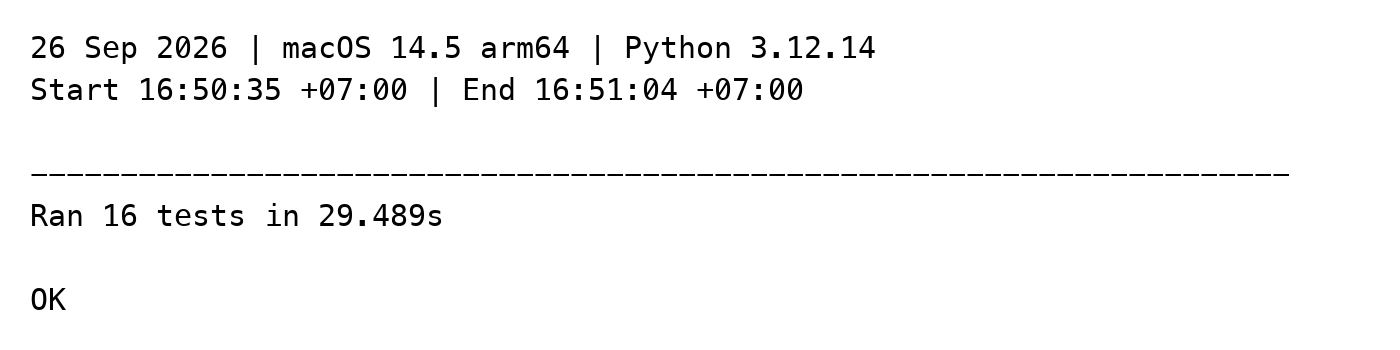
output/qa/test-evidence.png
