Comxt-i/smart-pill-dispenser/output/restart/qa/contact-0.jpg

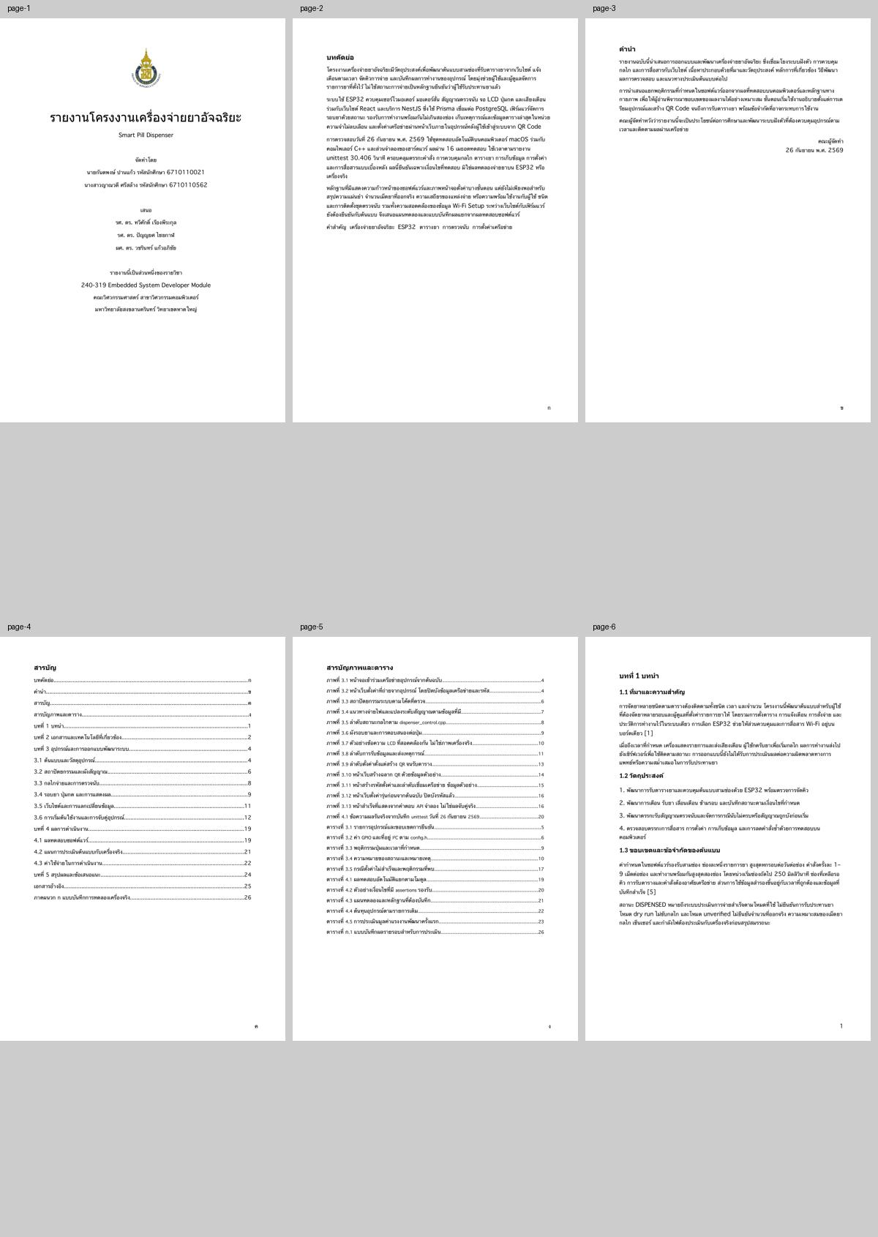
output/restart/qa/contact-0.jpg
