Comxt-i/smart-pill-dispenser/output/restart/qa/contact-1.jpg

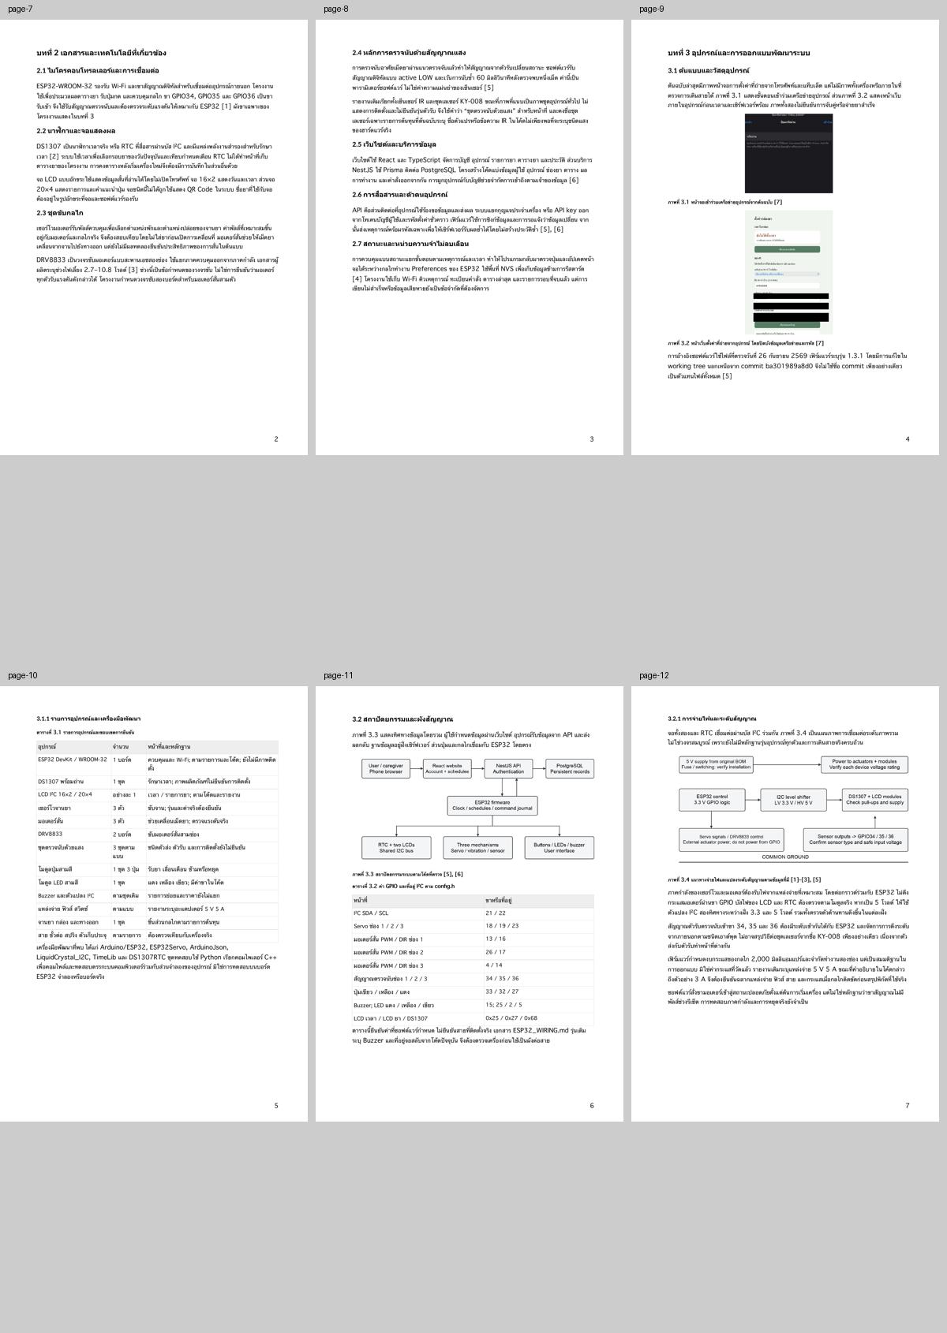
output/restart/qa/contact-1.jpg
