Comxt-i/smart-pill-dispenser/output/restart/qa/contact-2.jpg

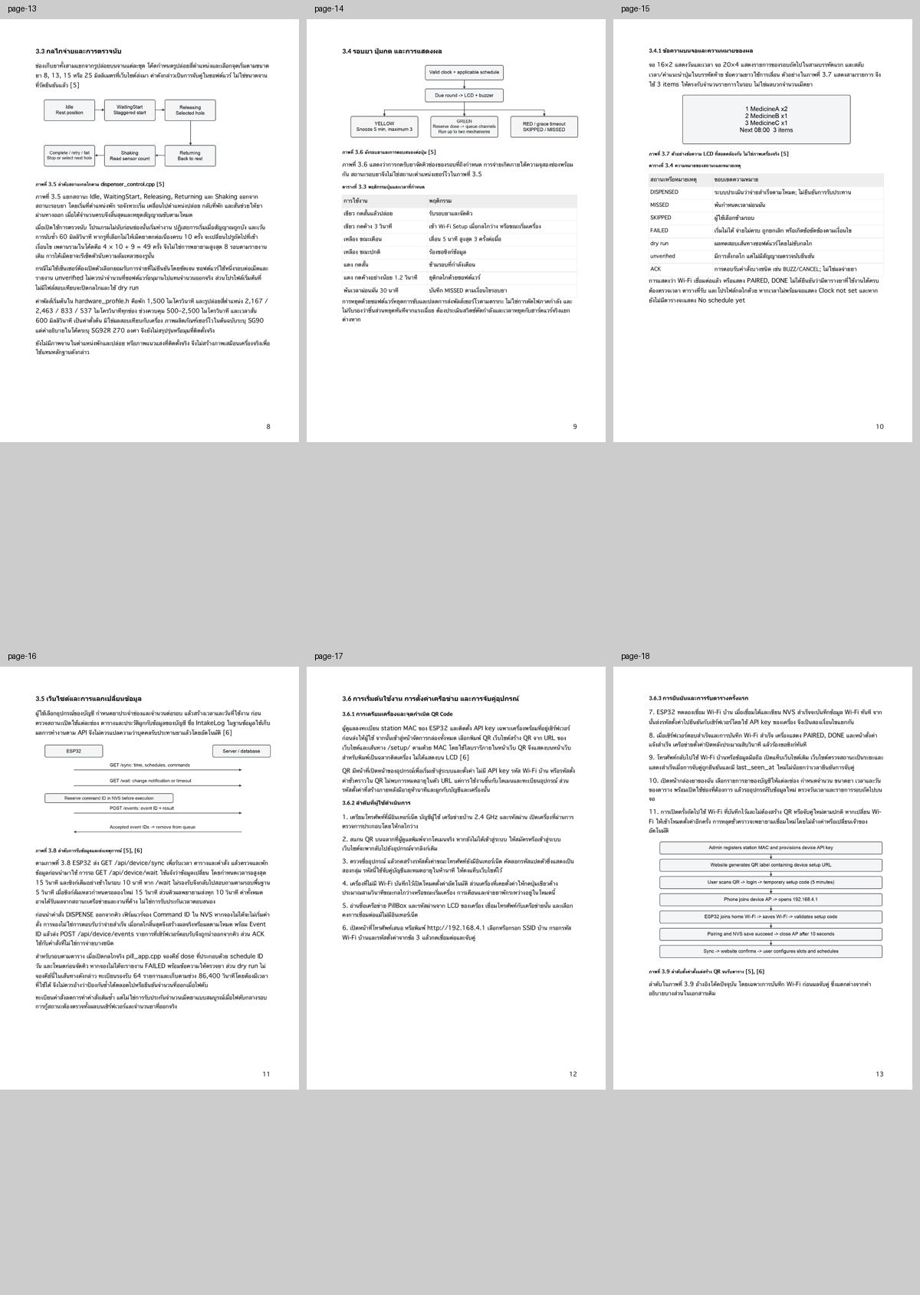
output/restart/qa/contact-2.jpg
