Comxt-i/smart-pill-dispenser/output/restart/qa/contact-3.jpg

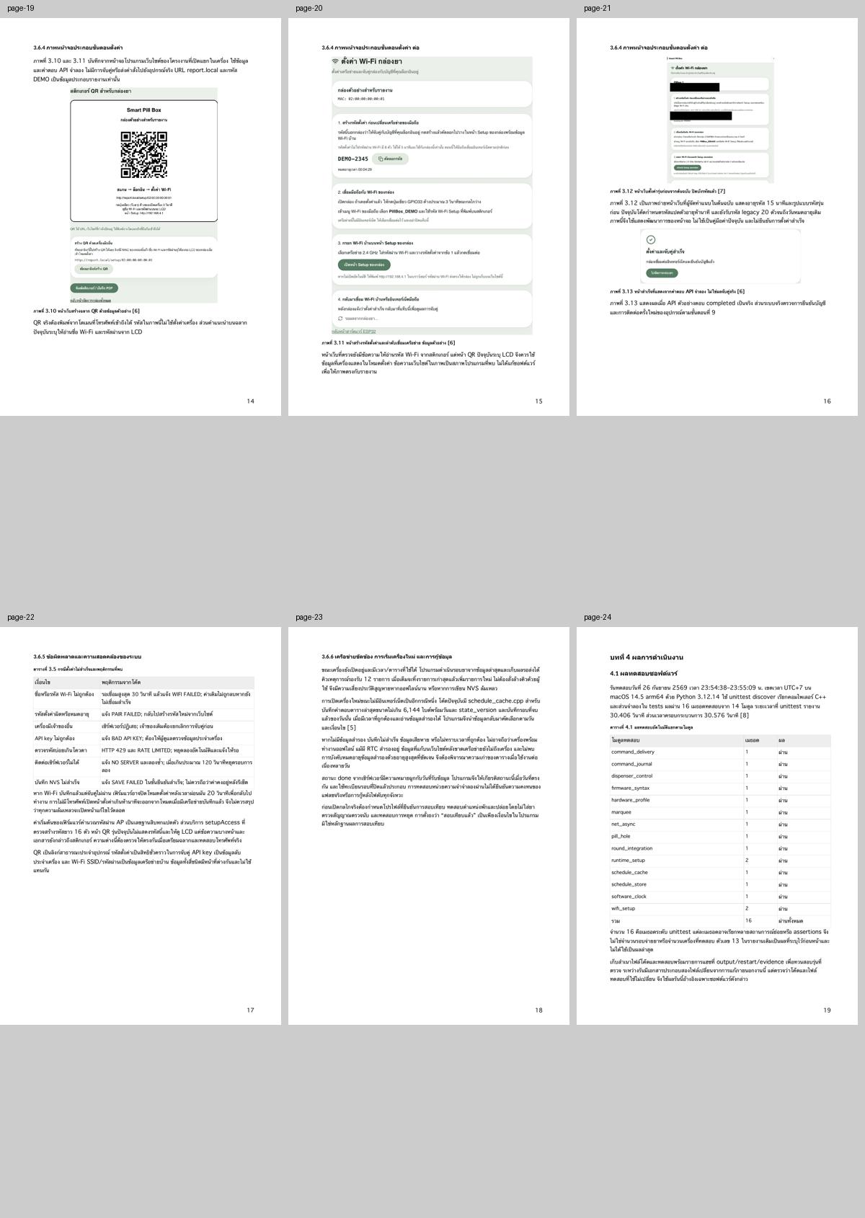
output/restart/qa/contact-3.jpg
