Comxt-i/smart-pill-dispenser/output/restart/qa/contact-4.jpg

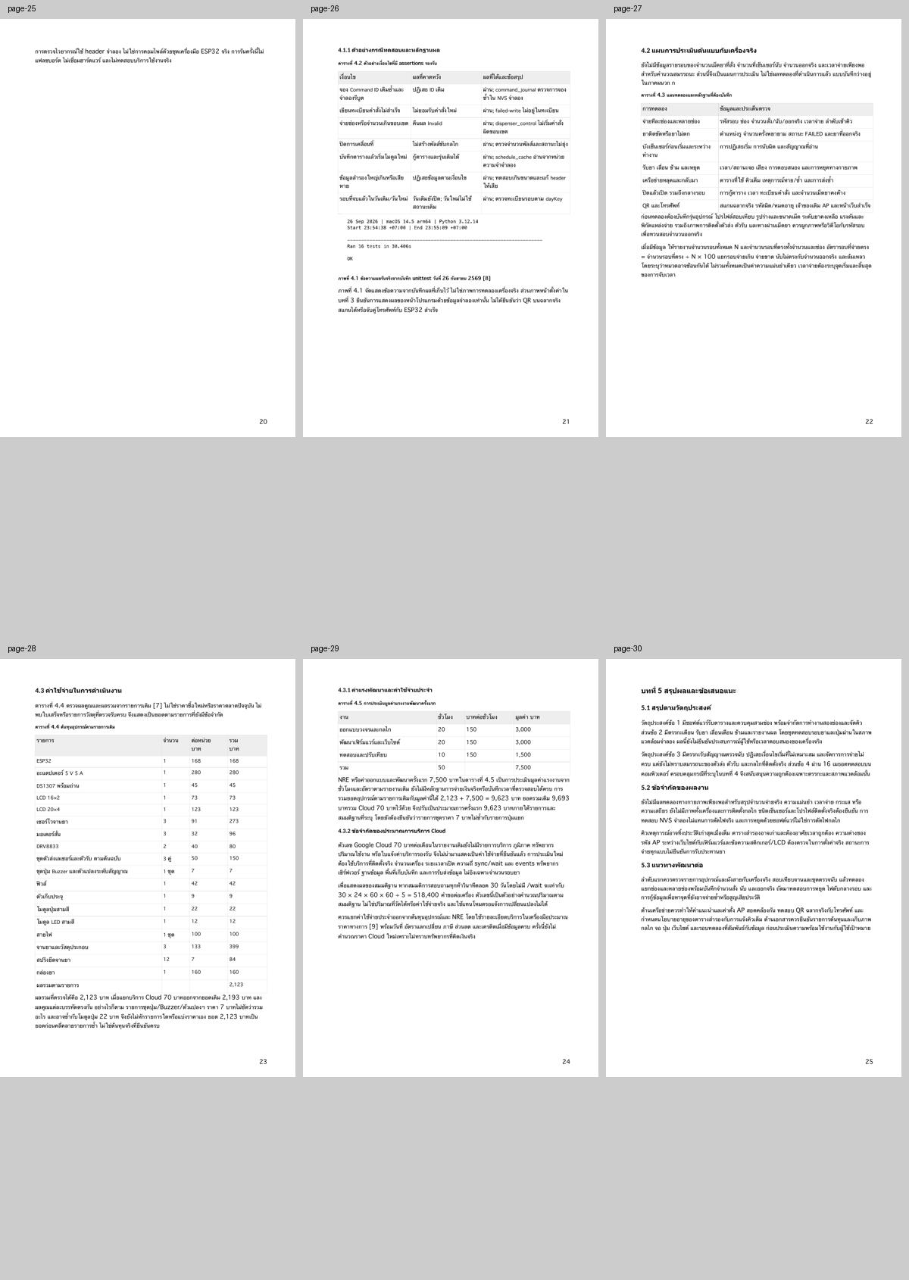
output/restart/qa/contact-4.jpg
