Comxt-i/smart-pill-dispenser/output/restart/qa/contact-5.jpg

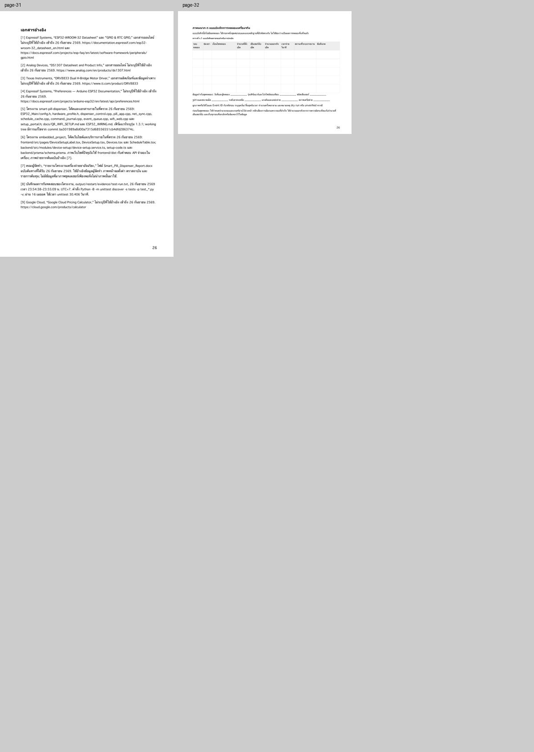
output/restart/qa/contact-5.jpg
