Comxt-i/smart-pill-dispenser/output/restart/qa/final-render/page-9.png

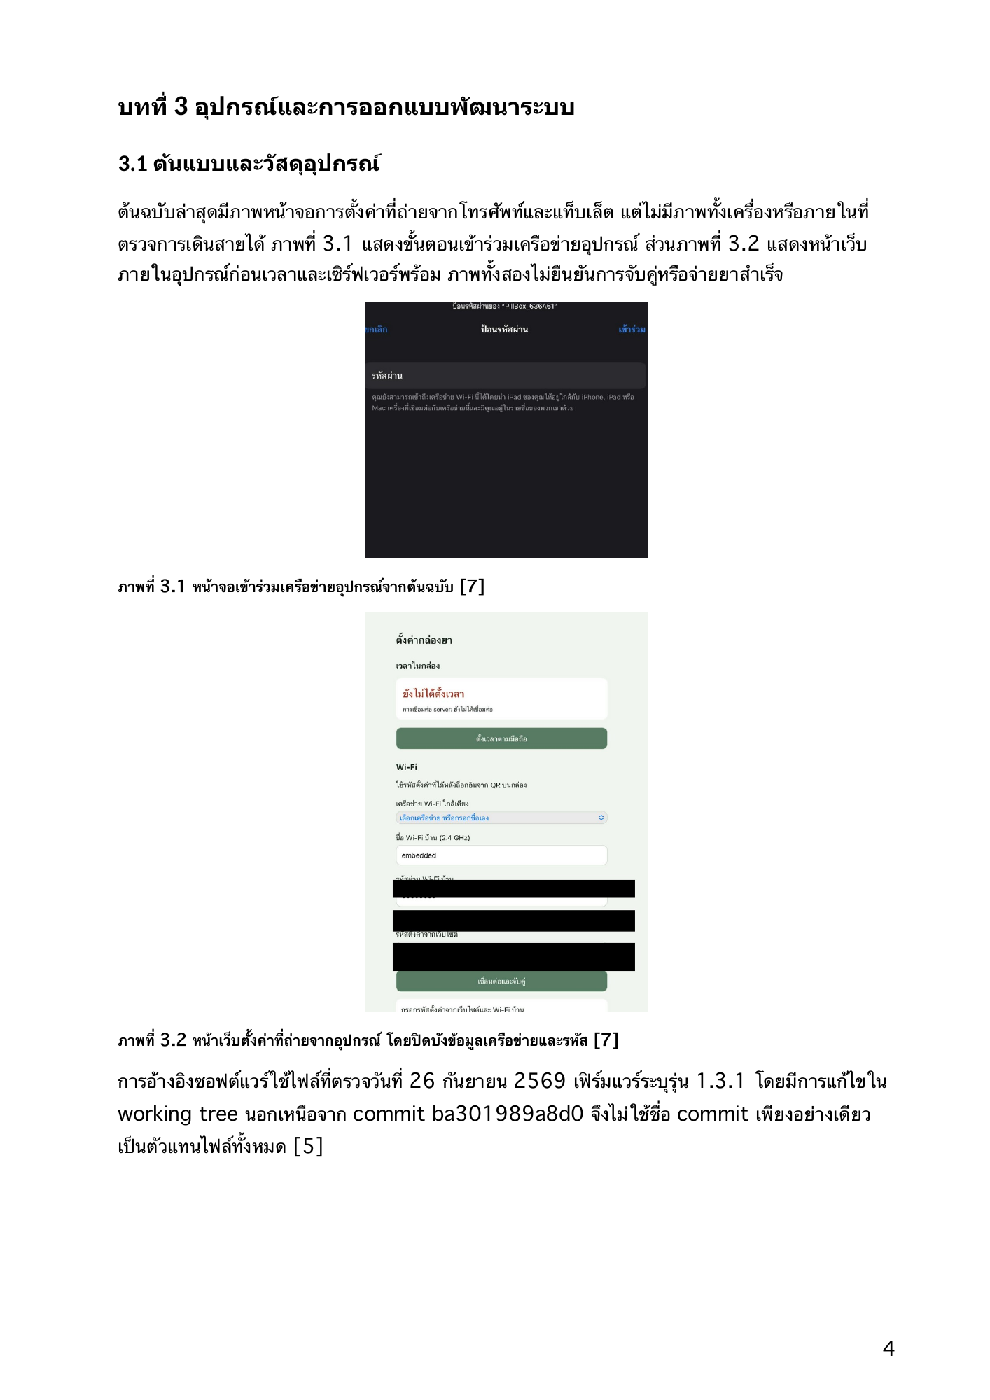
output/restart/qa/final-render/page-9.png
