Comxt-i/smart-pill-dispenser/output/restart/qa/final-render/page-13.png

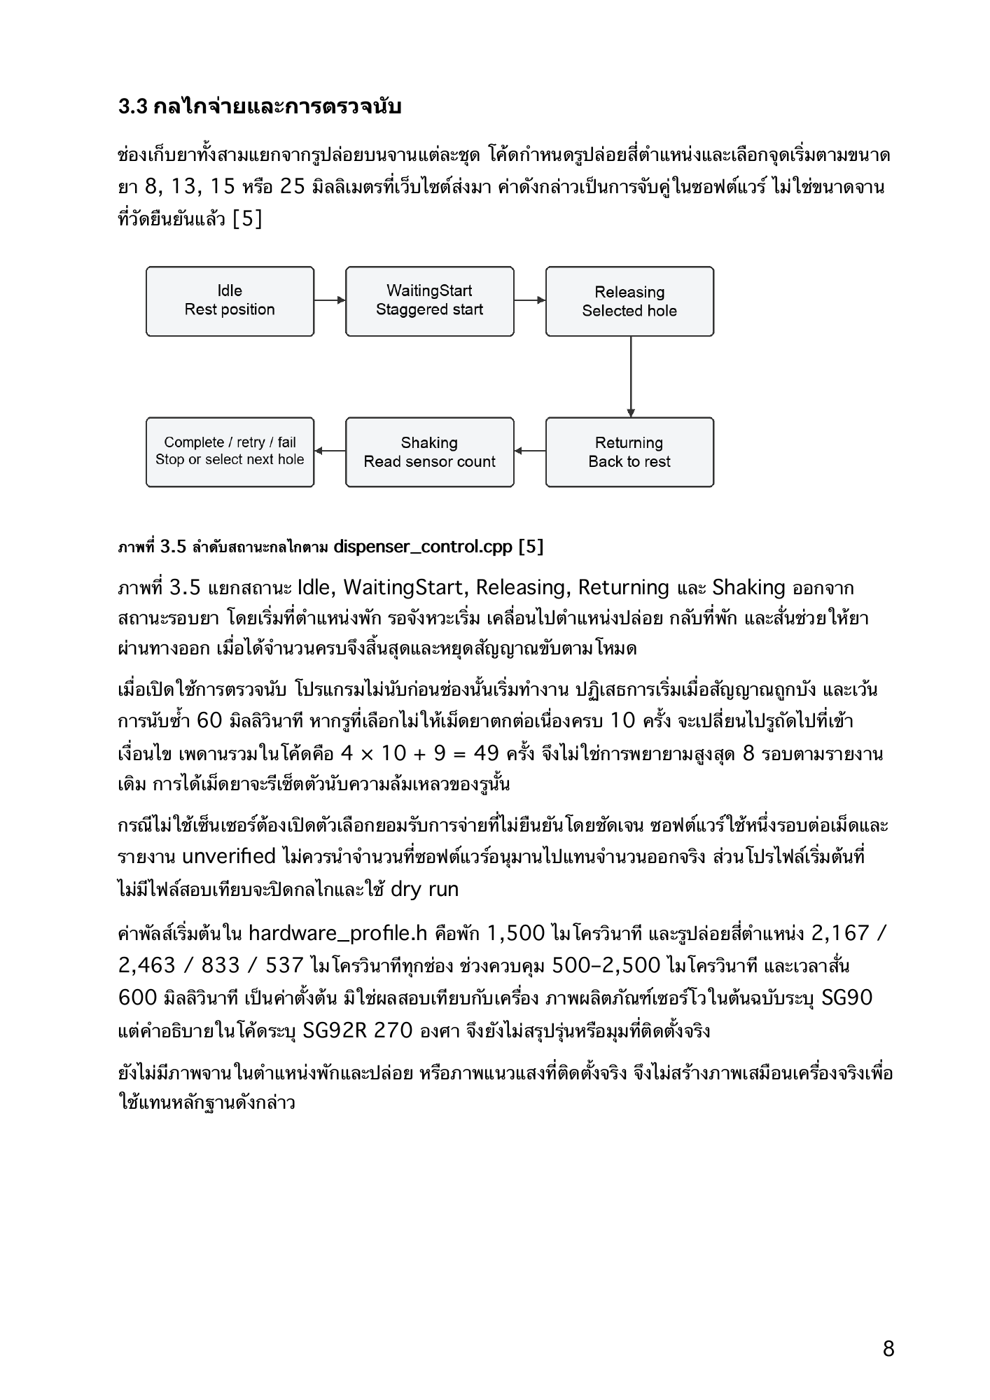
output/restart/qa/final-render/page-13.png
