Comxt-i/smart-pill-dispenser/output/restart/qa/final-render/page-21.png

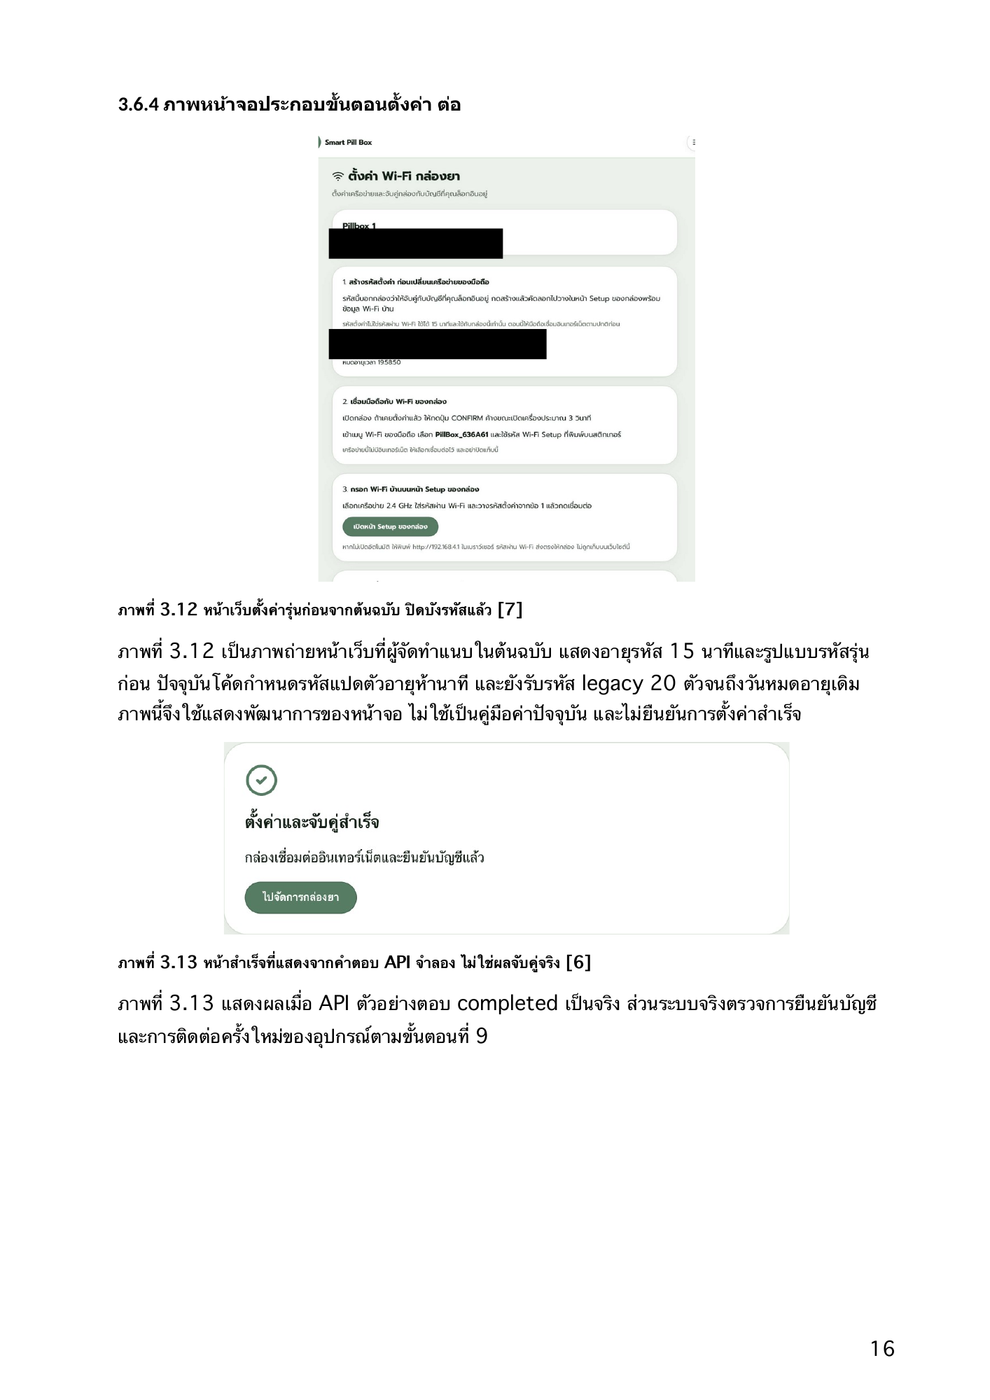
output/restart/qa/final-render/page-21.png
