Comxt-i/smart-pill-dispenser/output/restart/qa/final-render/page-24.png

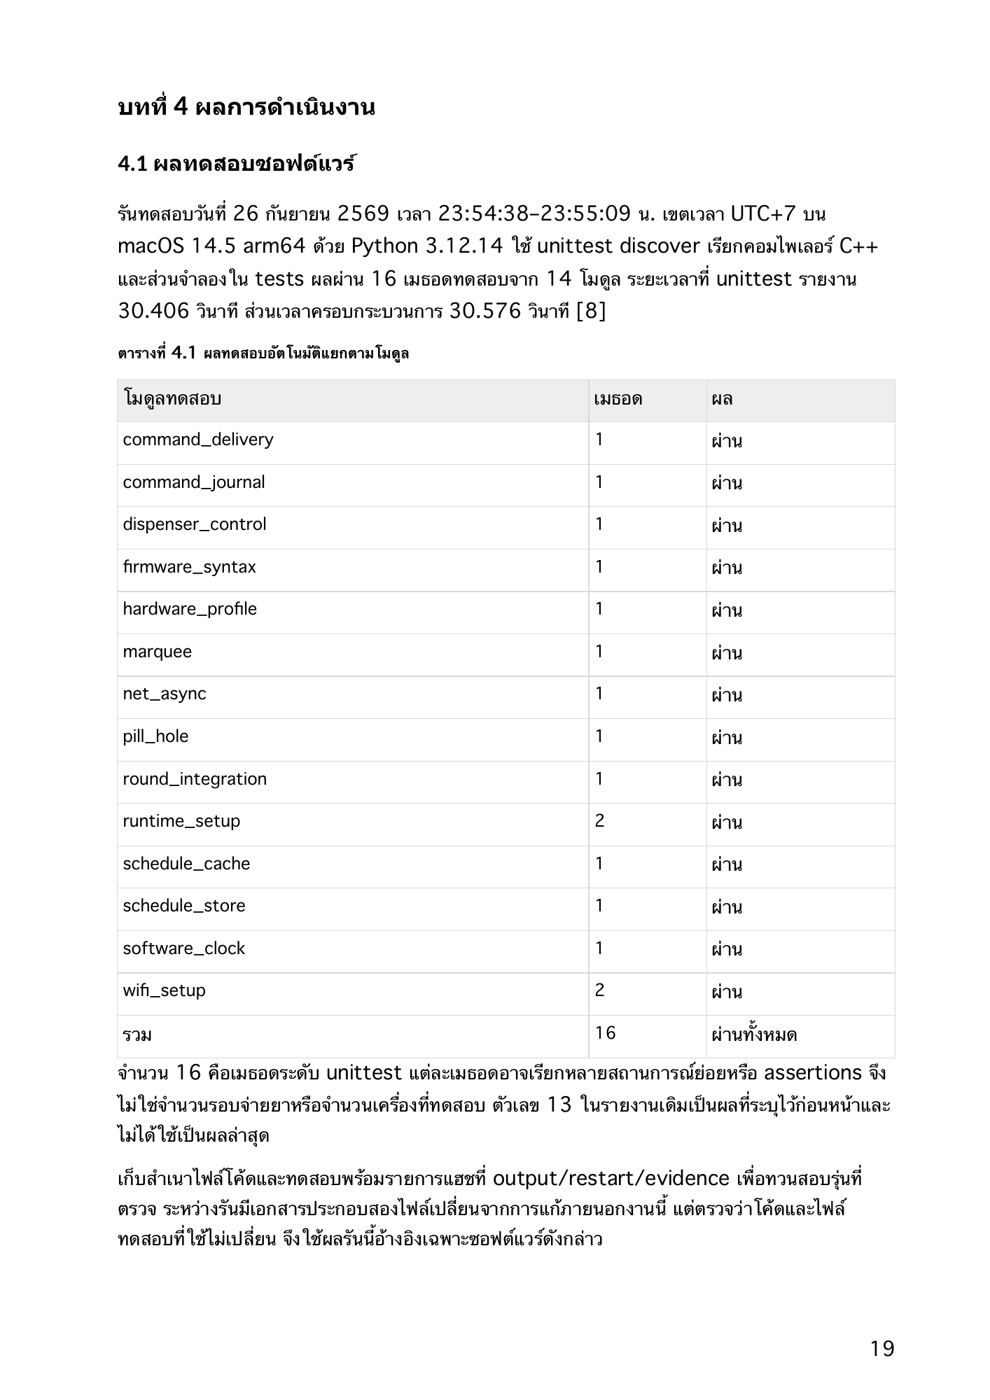
output/restart/qa/final-render/page-24.png
