Comxt-i/smart-pill-dispenser/output/restart/qa/final-render/page-31.png

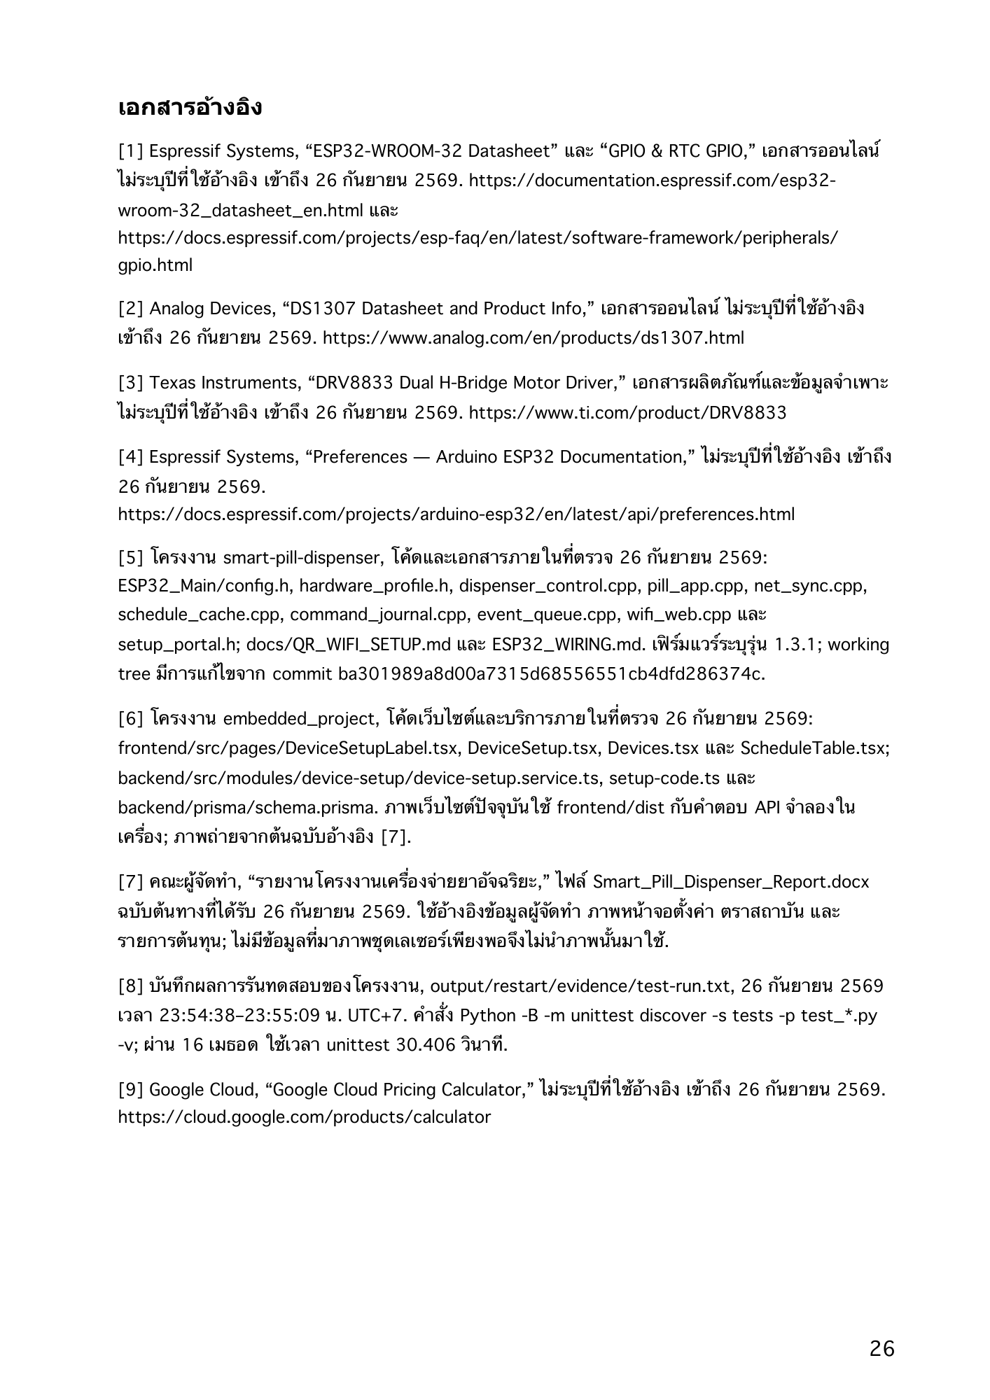
output/restart/qa/final-render/page-31.png
