Comxt-i/smart-pill-dispenser/output/restart/qa/original-render/page-1.png

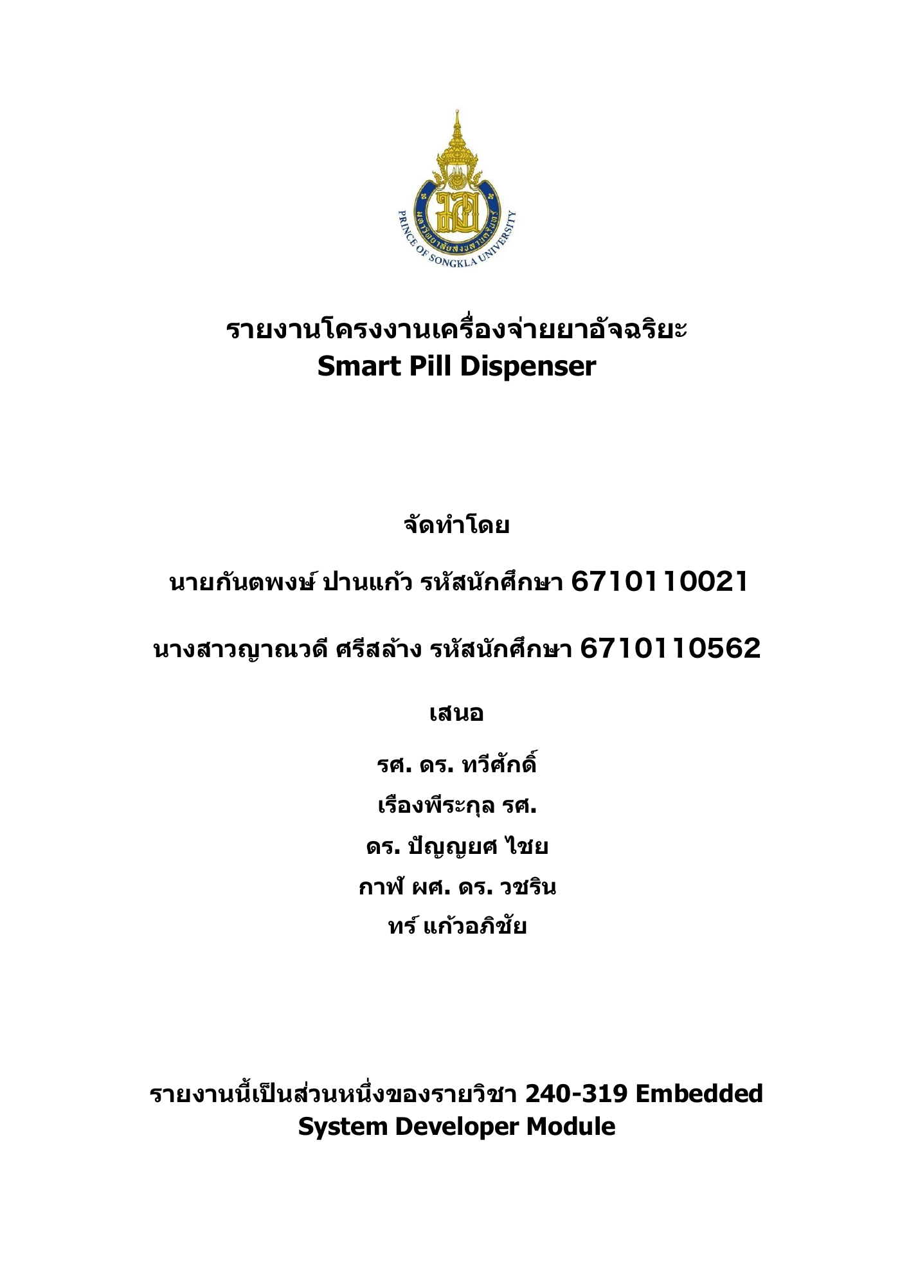
output/restart/qa/original-render/page-1.png
