Comxt-i/smart-pill-dispenser/output/restart/qa/original-render/page-3.png

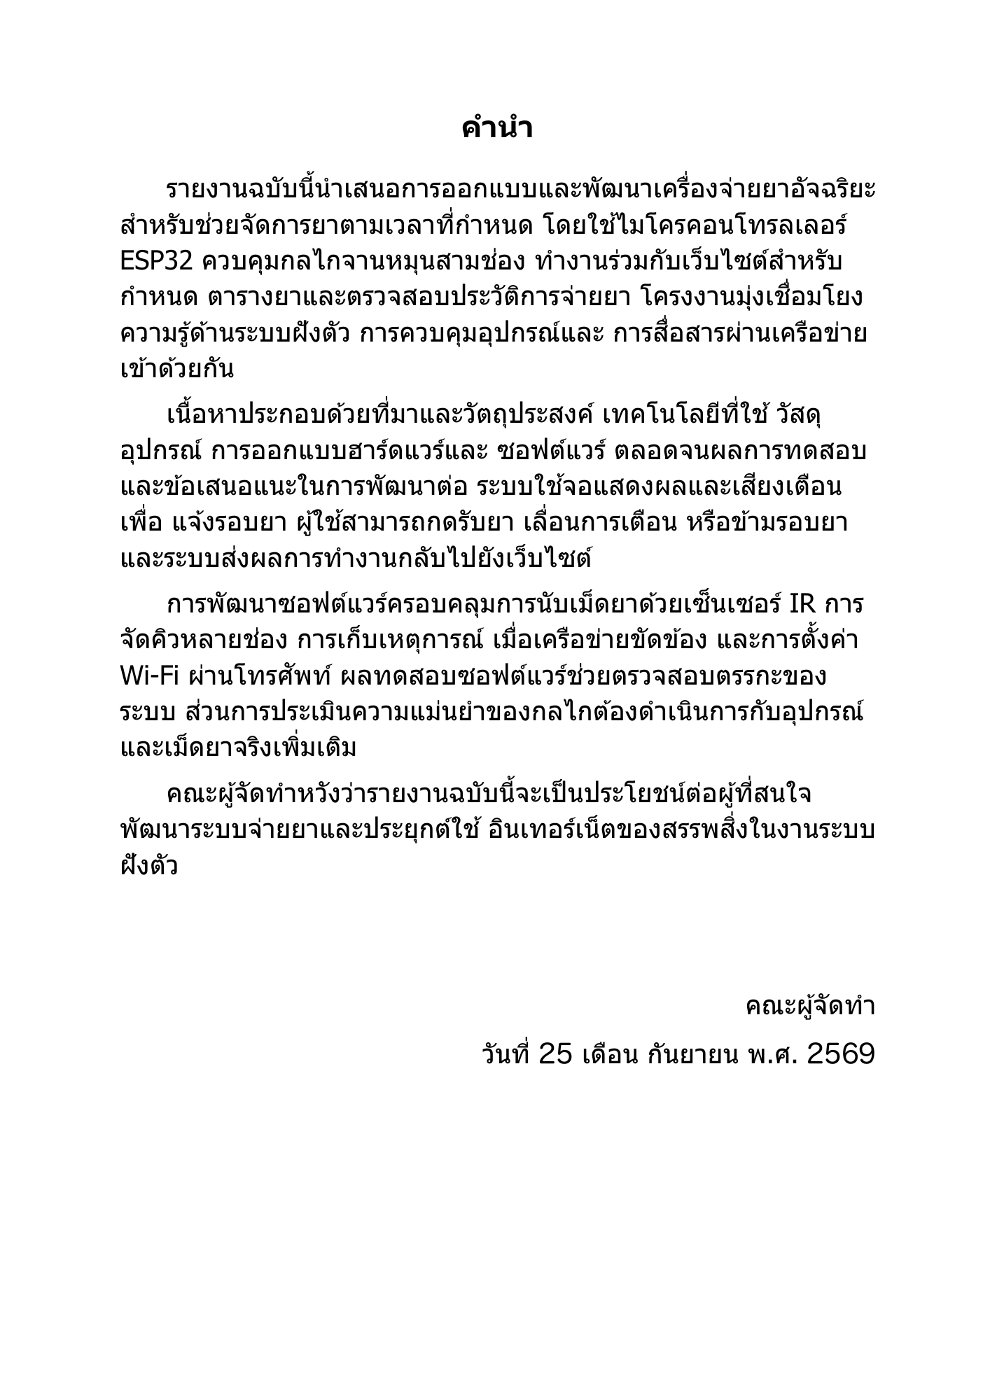
output/restart/qa/original-render/page-3.png
