Comxt-i/smart-pill-dispenser/output/restart/qa/original-render/page-4.png

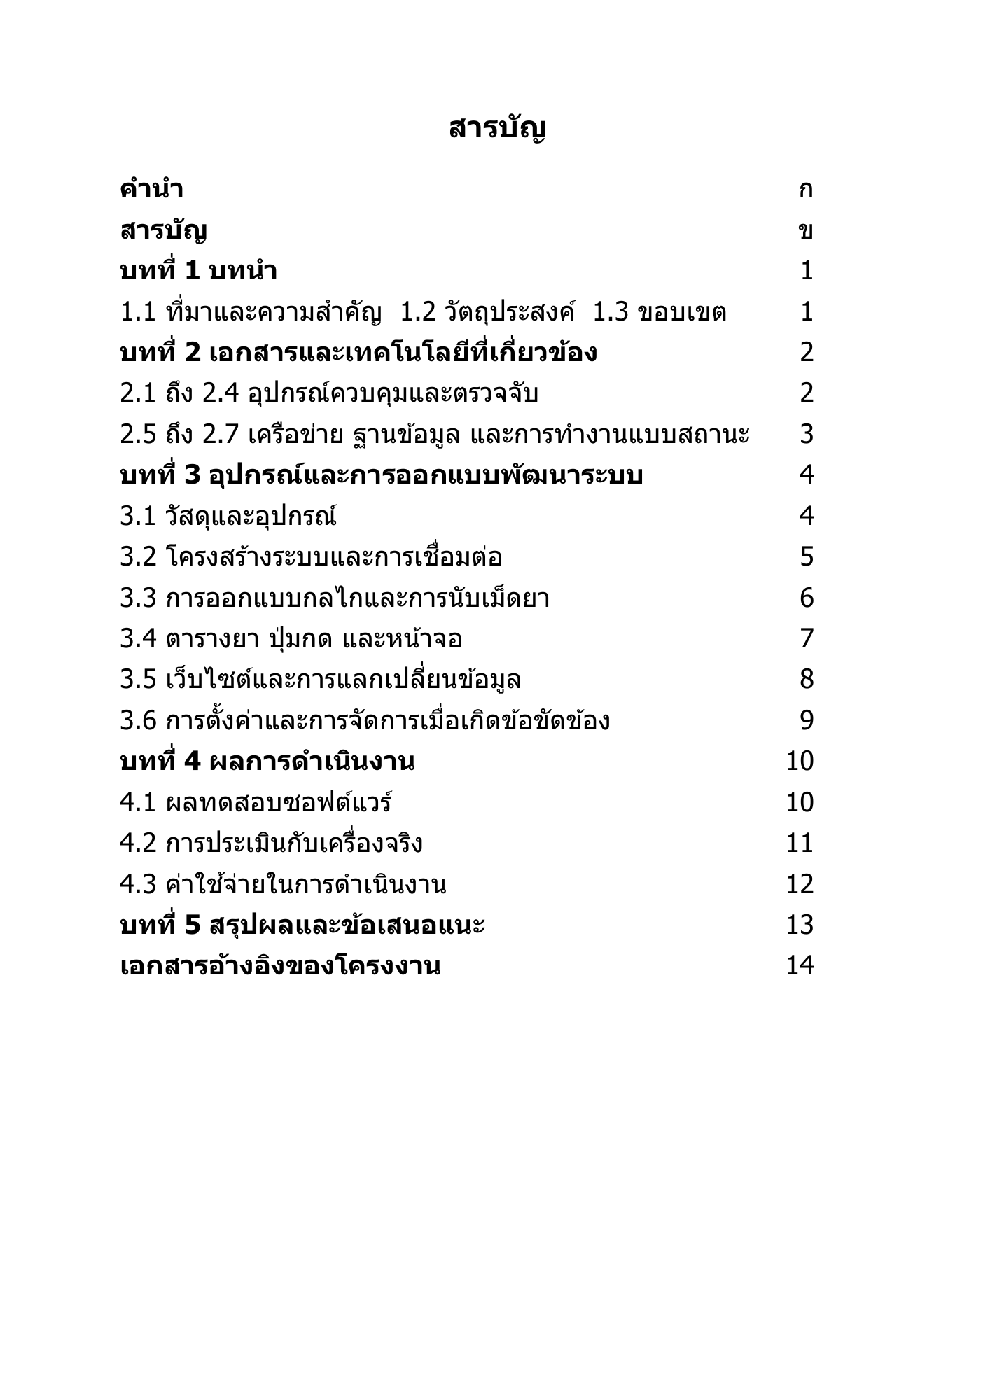
output/restart/qa/original-render/page-4.png
