Comxt-i/smart-pill-dispenser/output/restart/qa/original-render/page-5.png

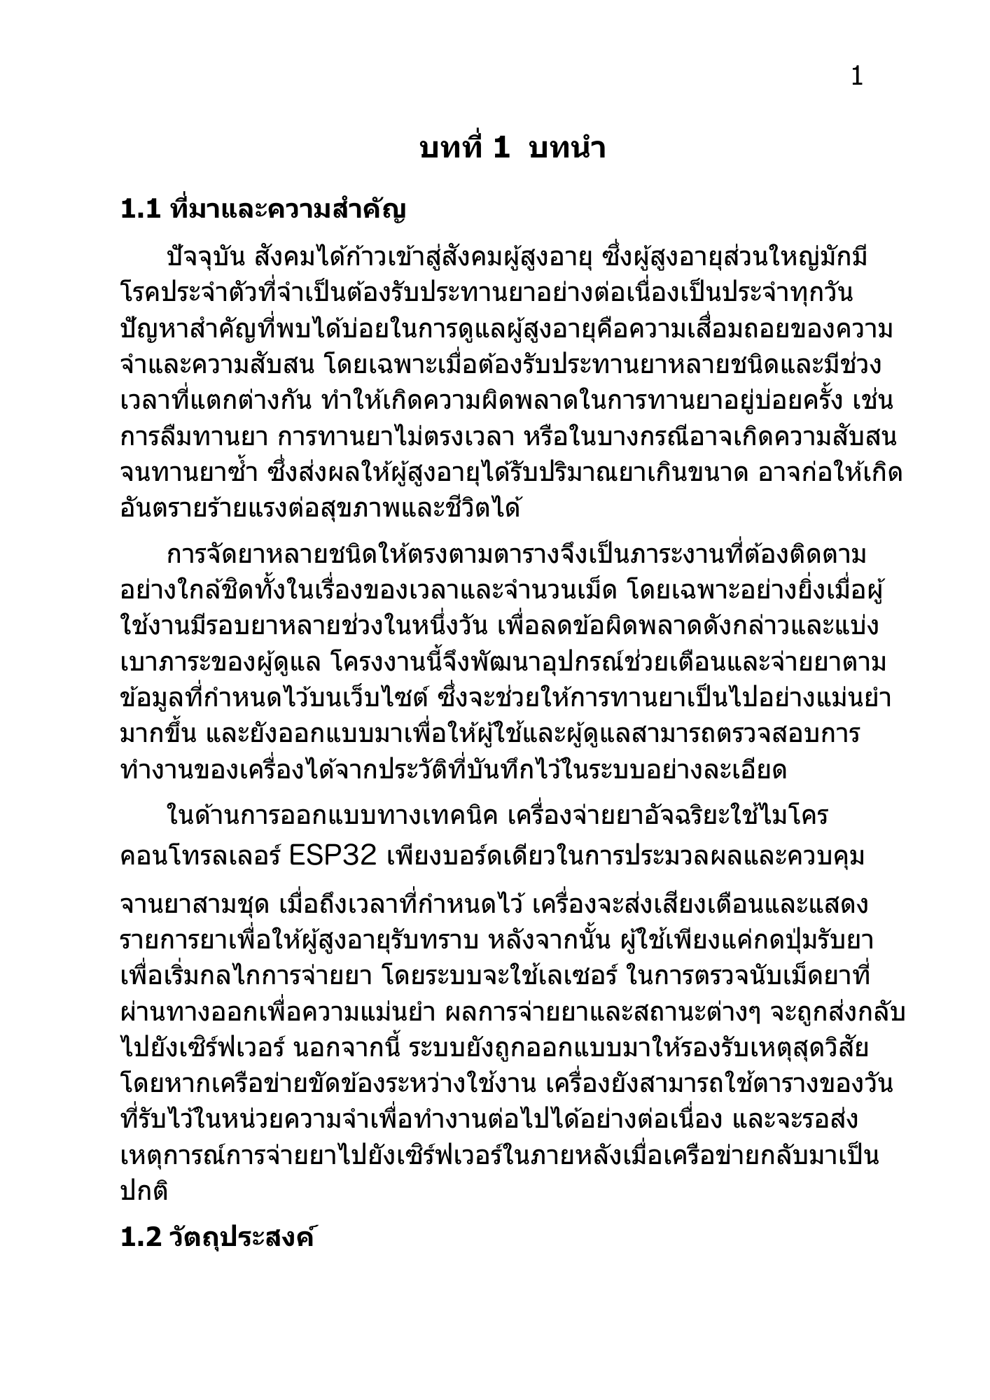
output/restart/qa/original-render/page-5.png
