Comxt-i/smart-pill-dispenser/output/restart/qa/original-render/page-6.png

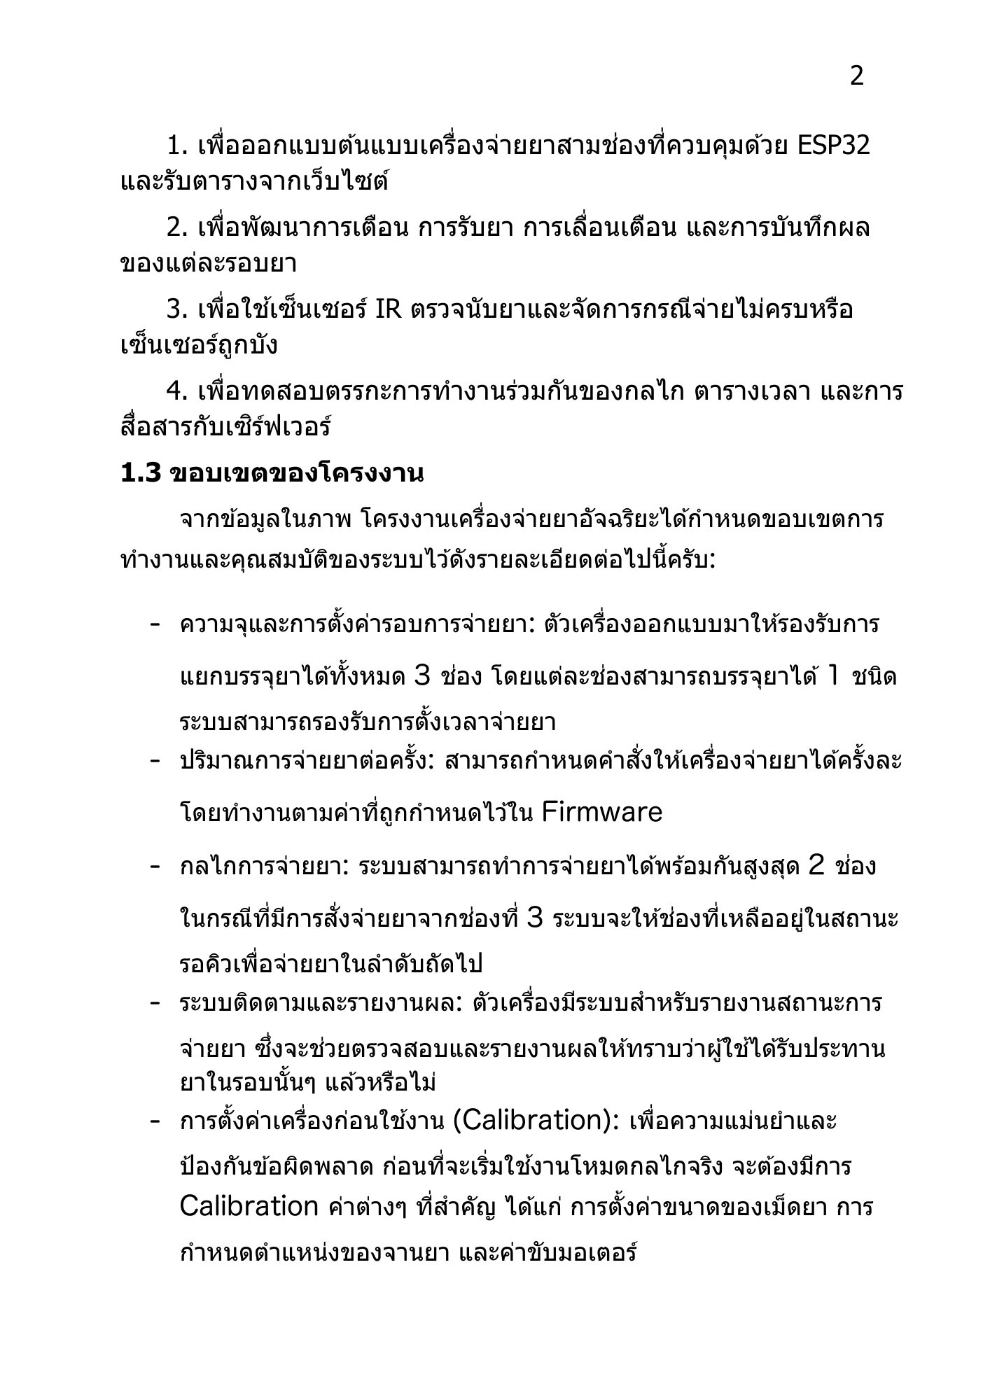
output/restart/qa/original-render/page-6.png
