Comxt-i/smart-pill-dispenser/output/restart/qa/original-render/page-7.png

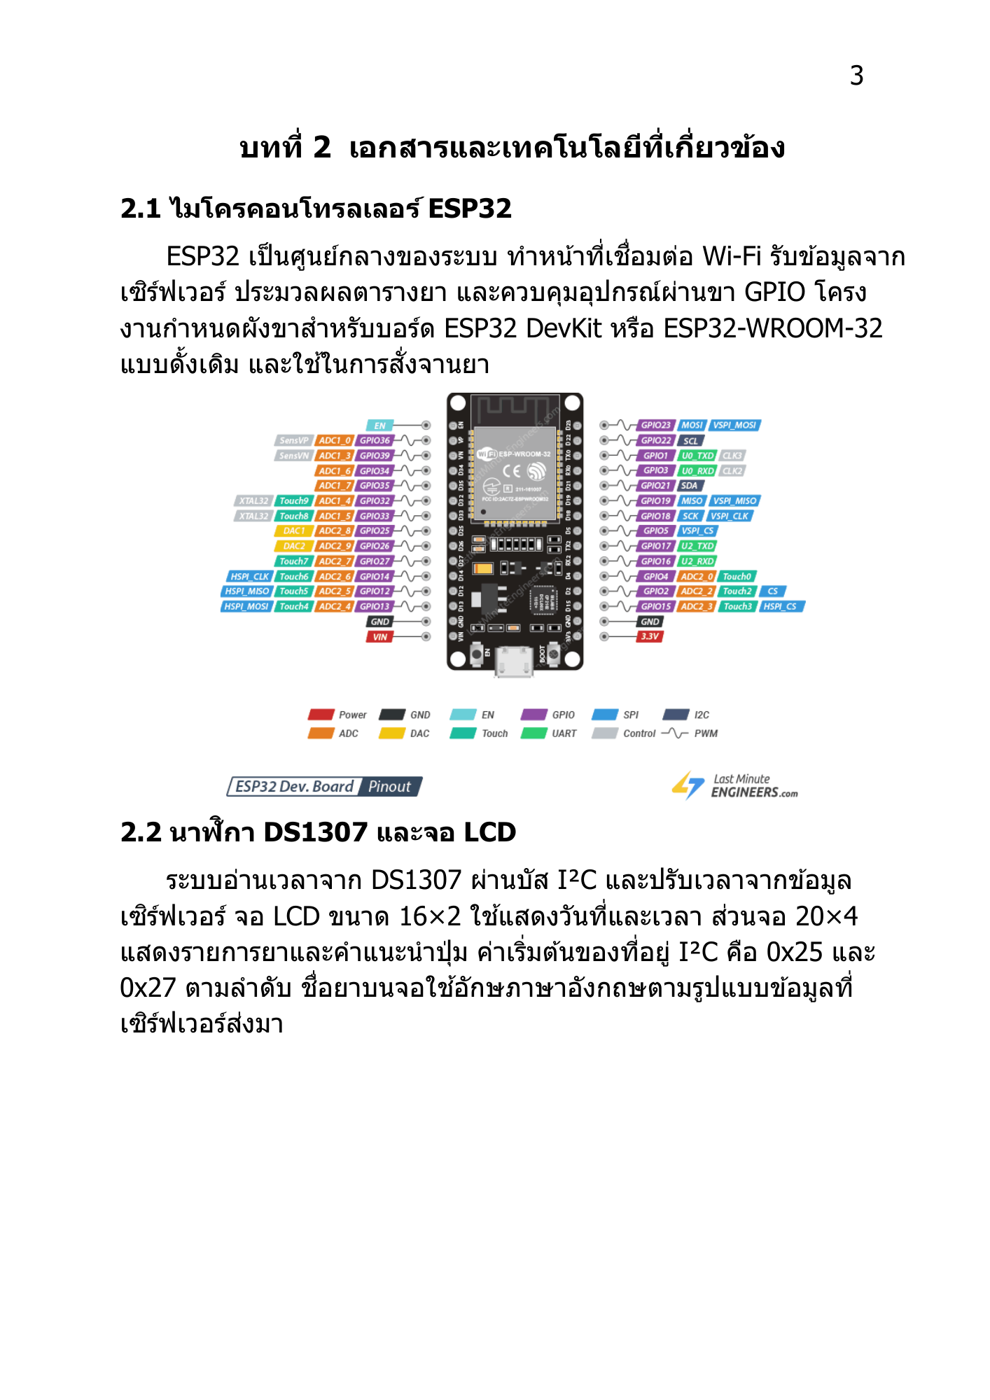
output/restart/qa/original-render/page-7.png
