Comxt-i/smart-pill-dispenser/output/restart/qa/original-render/page-8.png

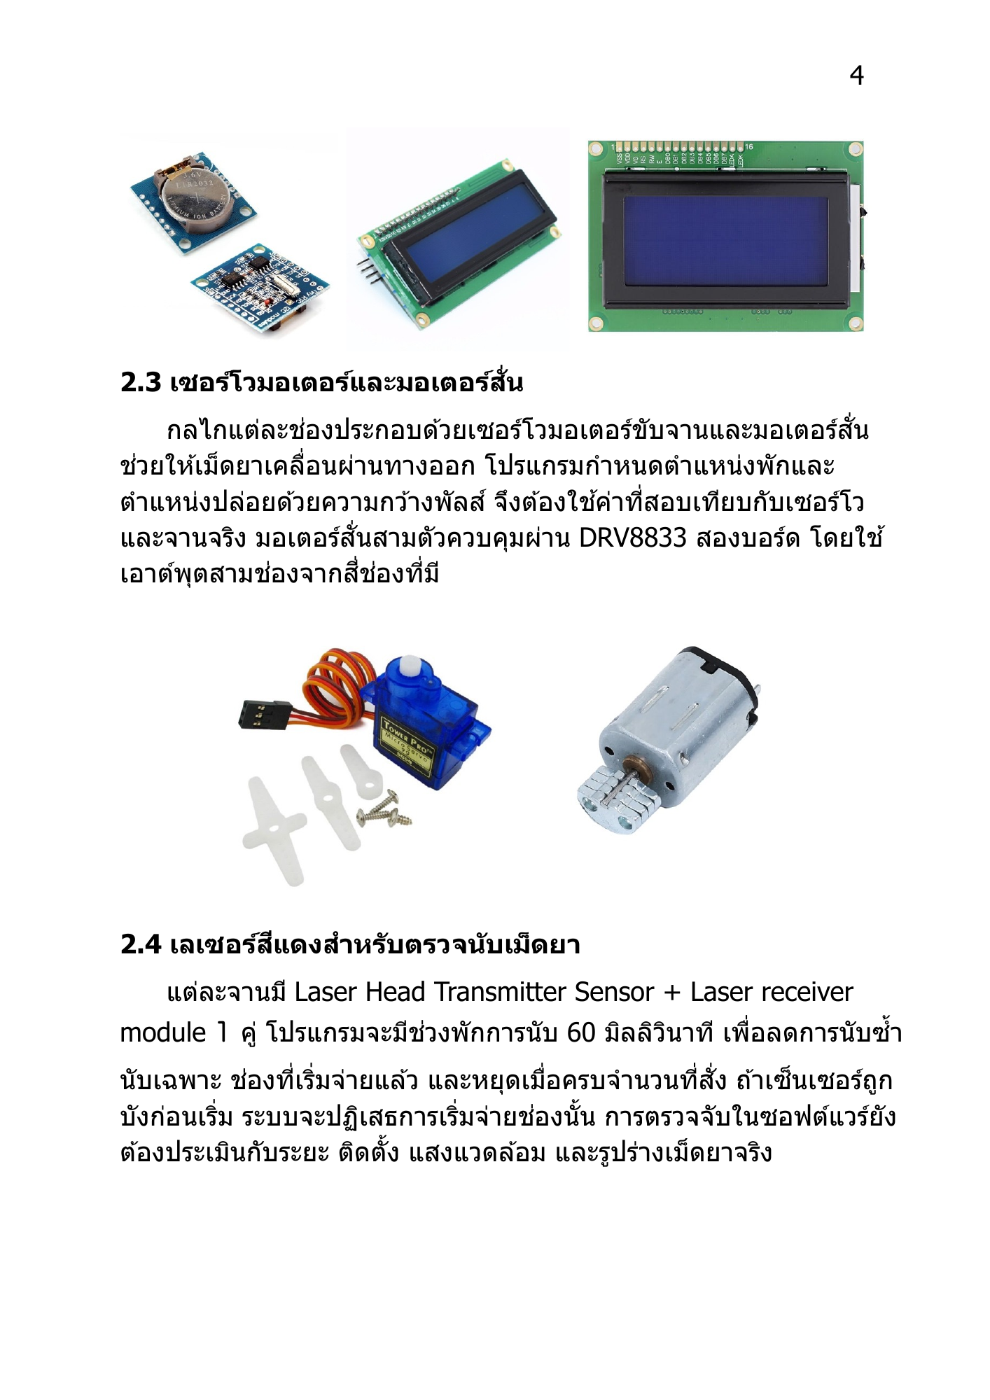
output/restart/qa/original-render/page-8.png
