Comxt-i/smart-pill-dispenser/output/restart/qa/original-render/page-9.png

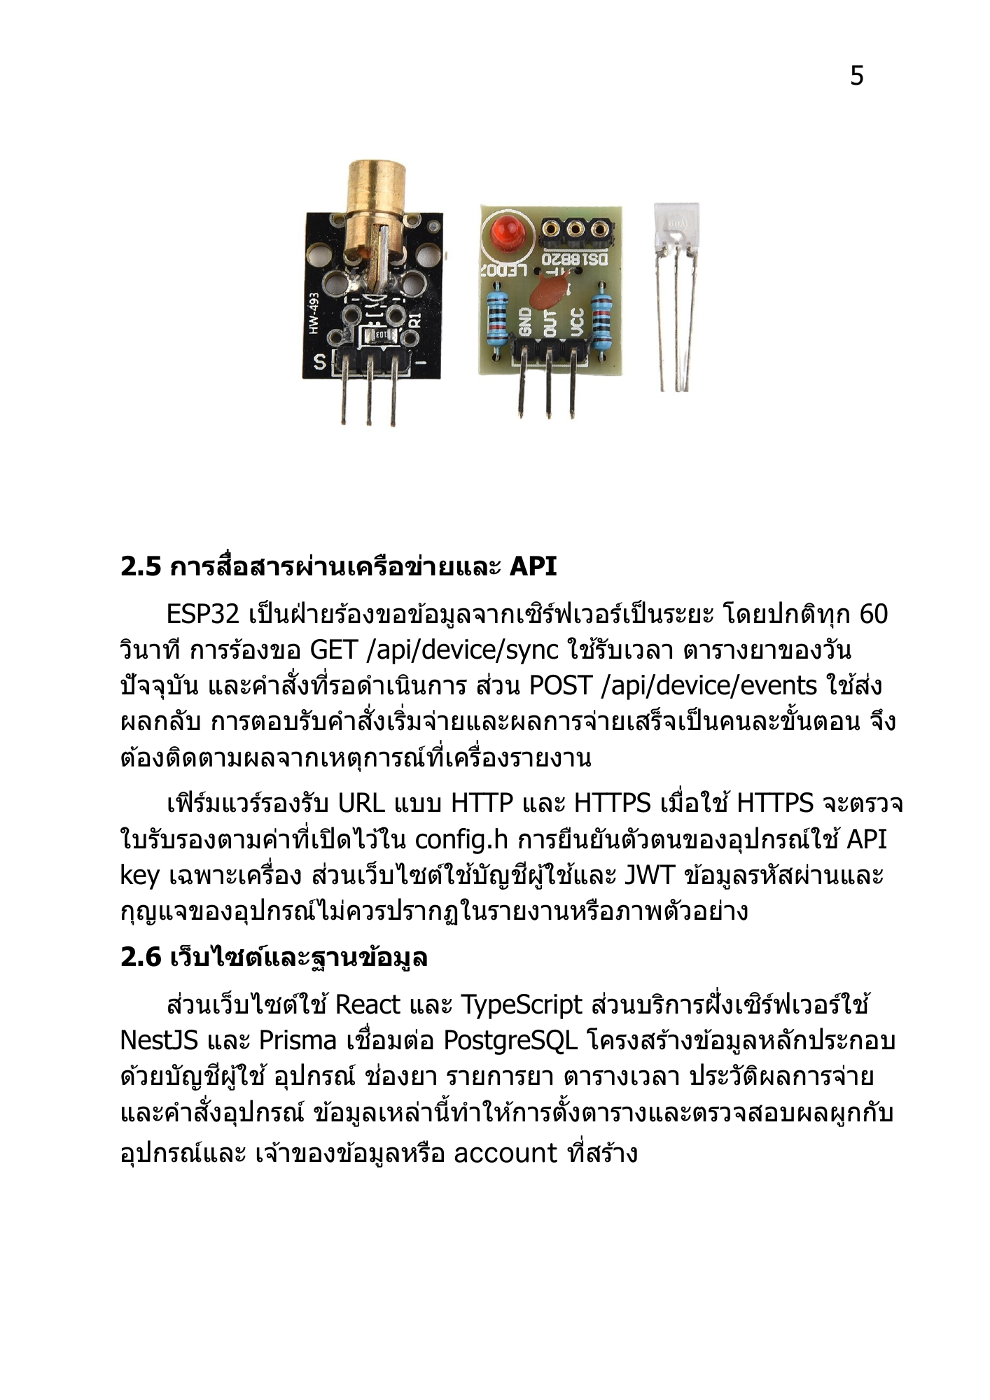
output/restart/qa/original-render/page-9.png
