Comxt-i/smart-pill-dispenser/output/restart/qa/original-render/page-10.png

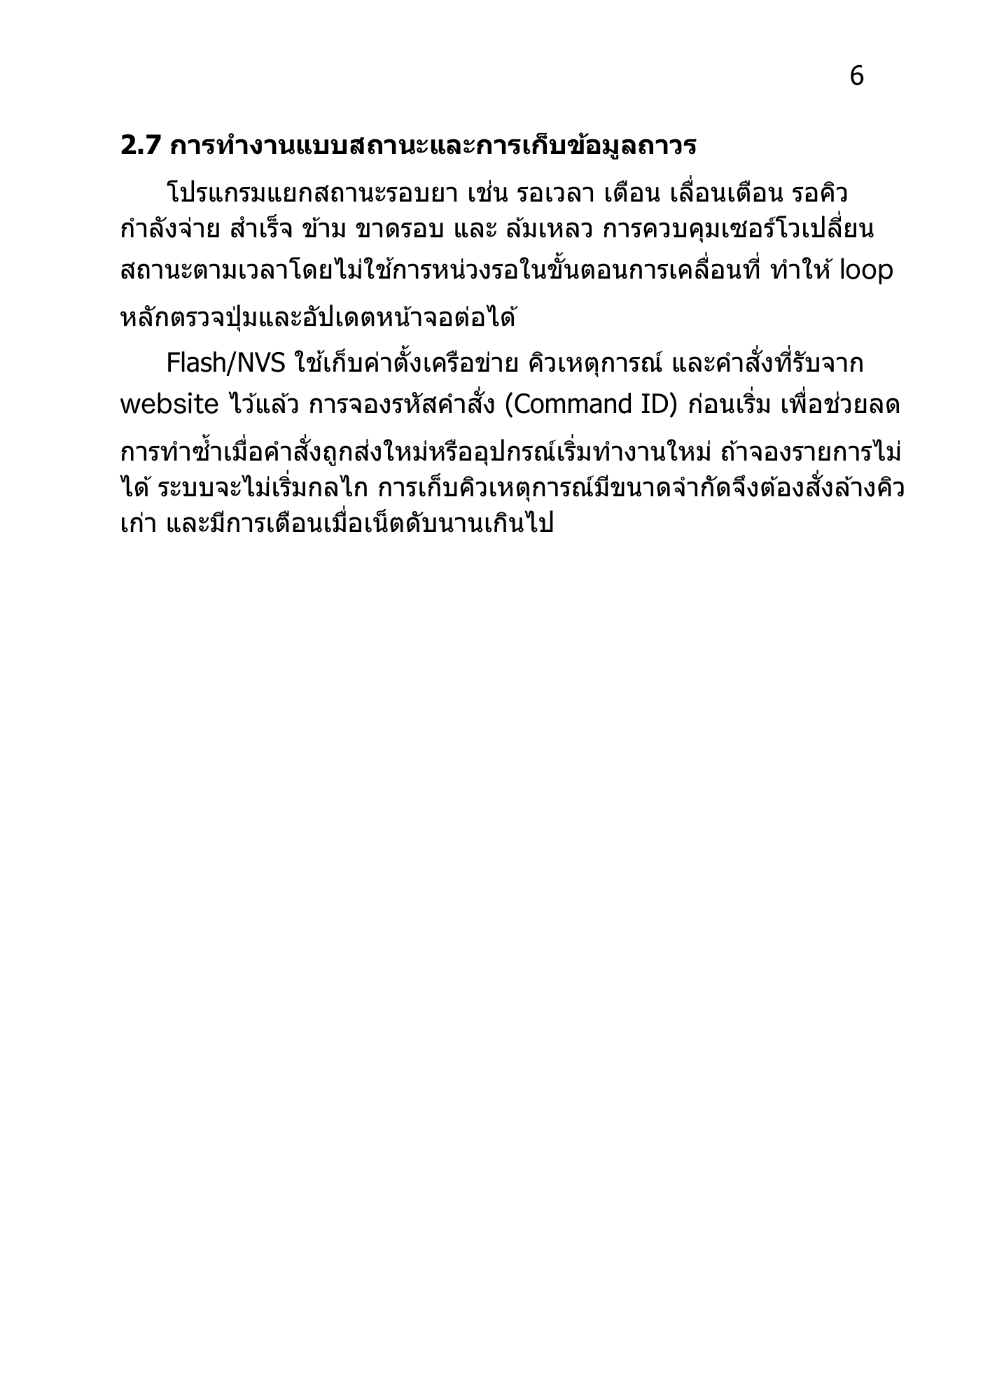
output/restart/qa/original-render/page-10.png
