Comxt-i/smart-pill-dispenser/output/restart/qa/original-render/page-11.png

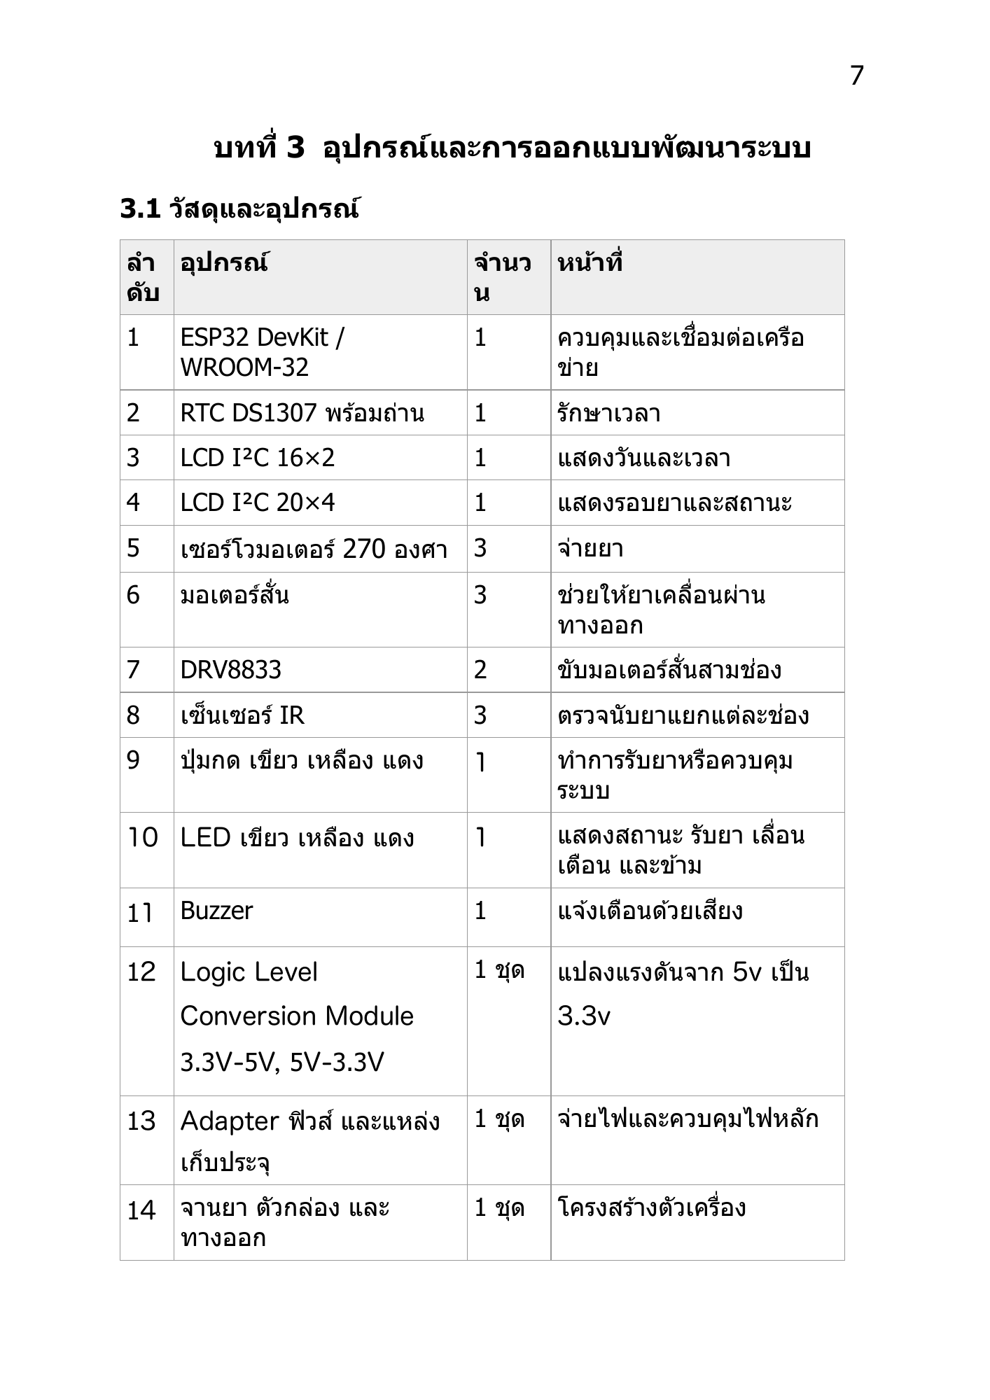
output/restart/qa/original-render/page-11.png
