Comxt-i/smart-pill-dispenser/output/restart/qa/original-render/page-12.png

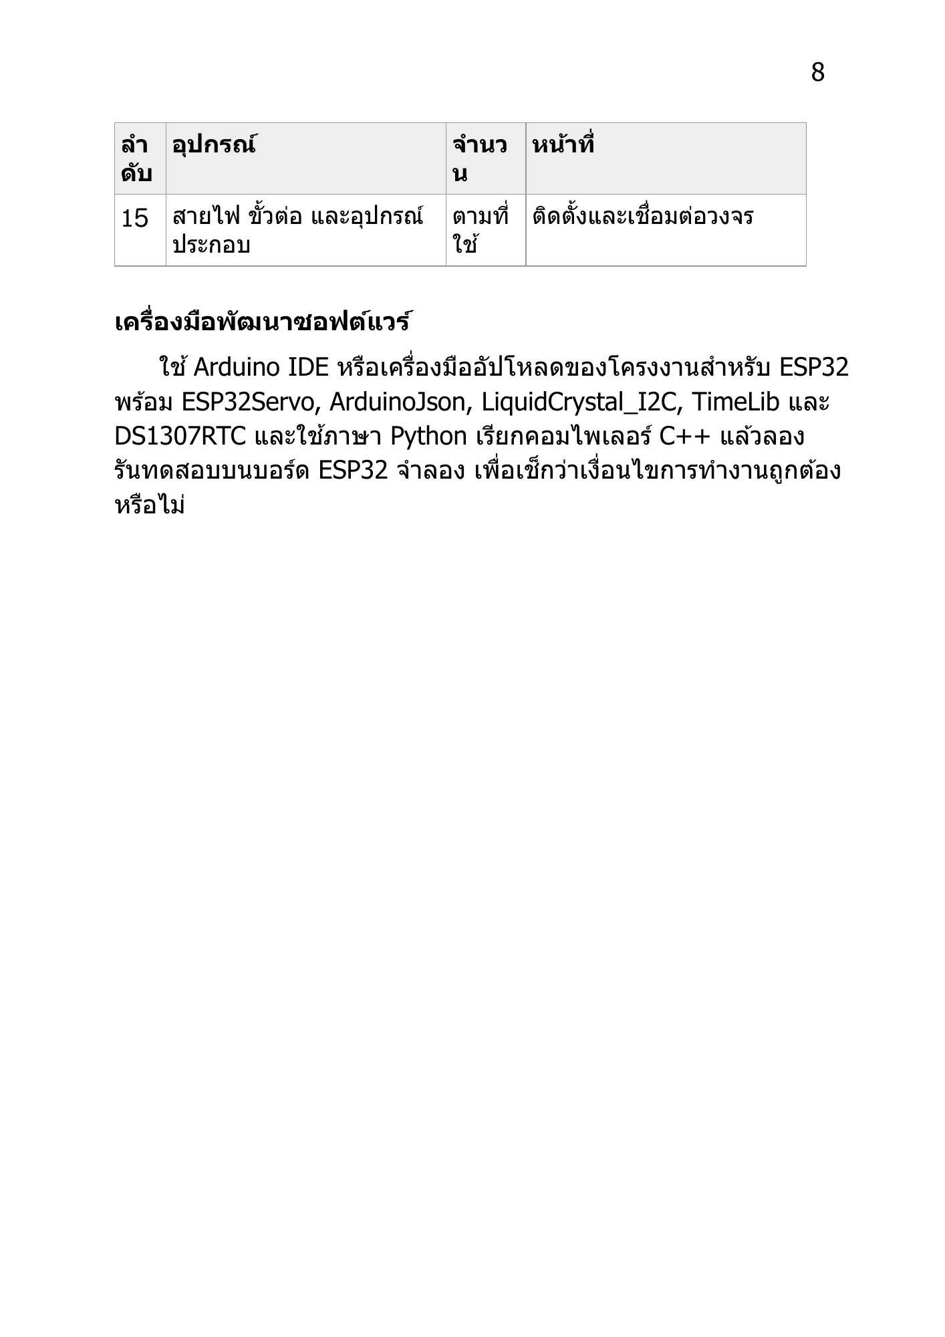
output/restart/qa/original-render/page-12.png
