Comxt-i/smart-pill-dispenser/output/restart/qa/original-render/page-13.png

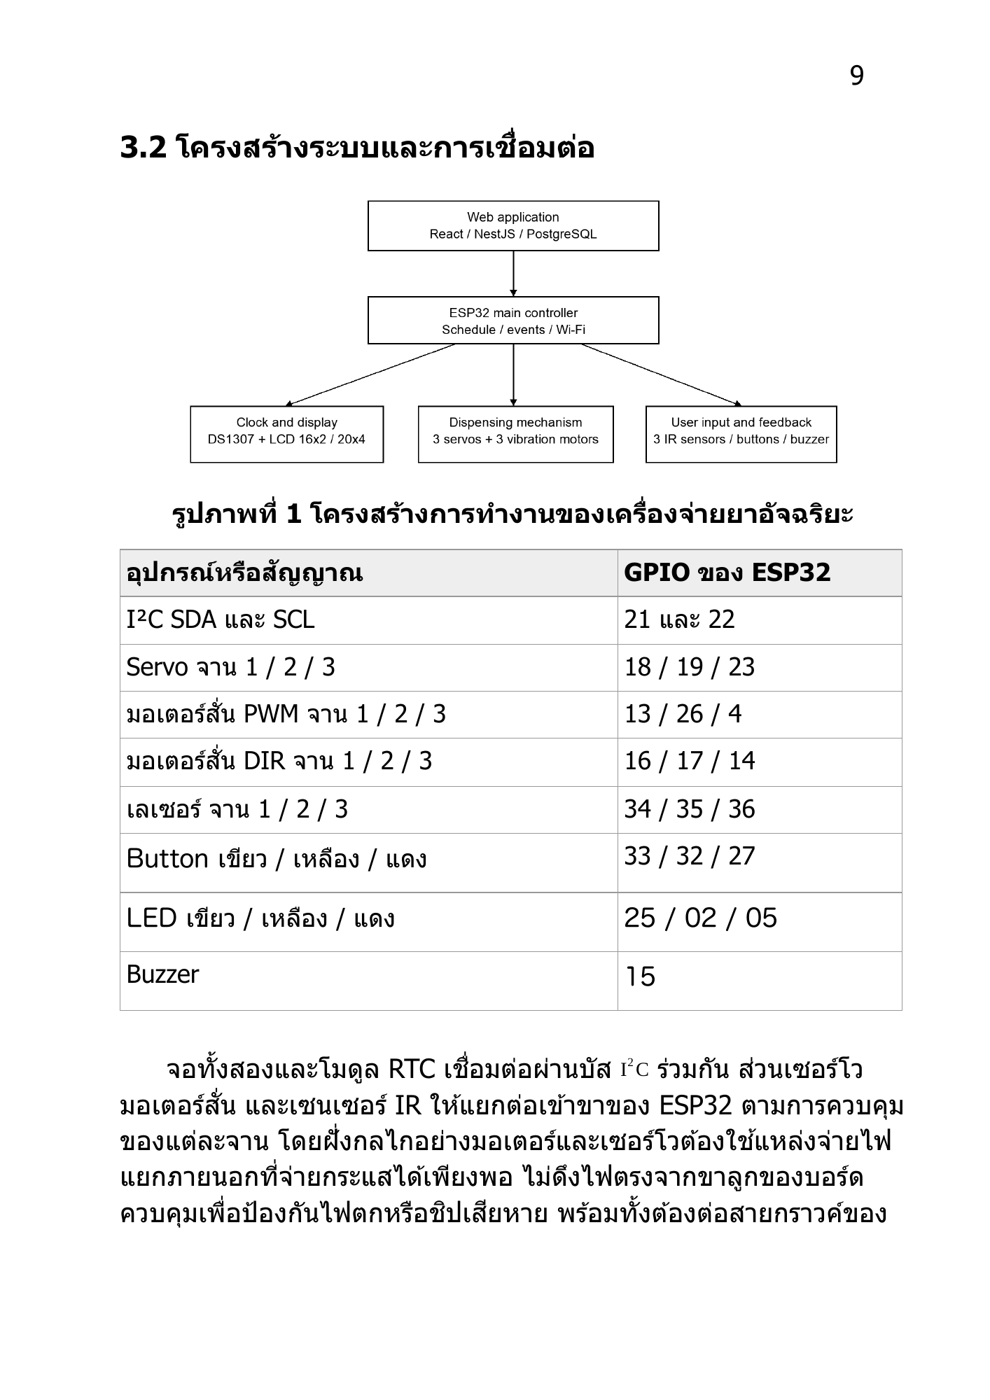
output/restart/qa/original-render/page-13.png
