Comxt-i/smart-pill-dispenser/output/restart/qa/original-render/page-14.png

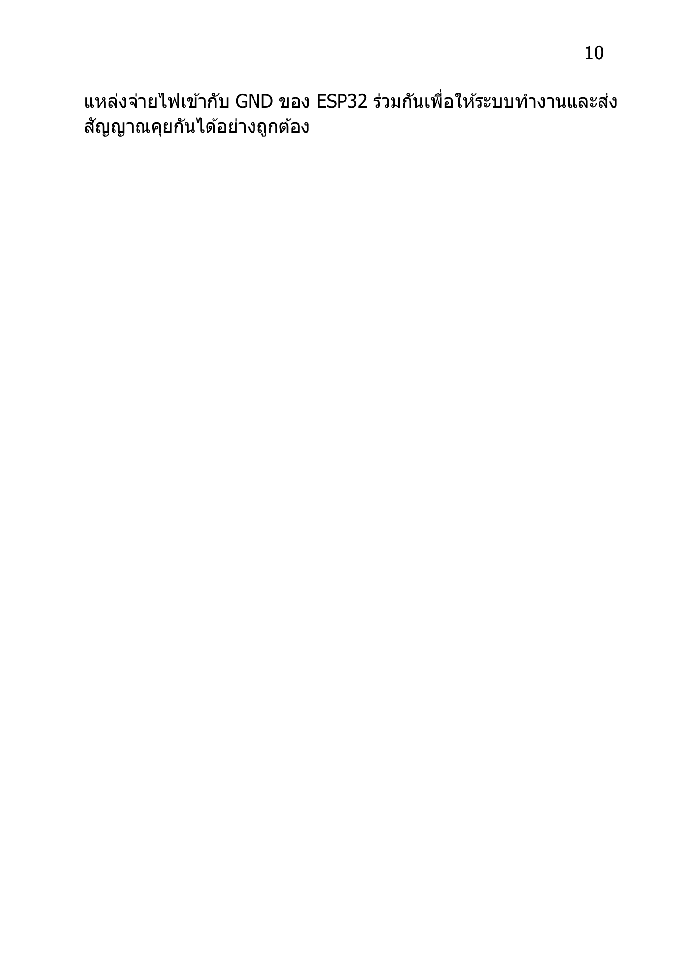
output/restart/qa/original-render/page-14.png
