Comxt-i/smart-pill-dispenser/output/restart/qa/original-render/page-15.png

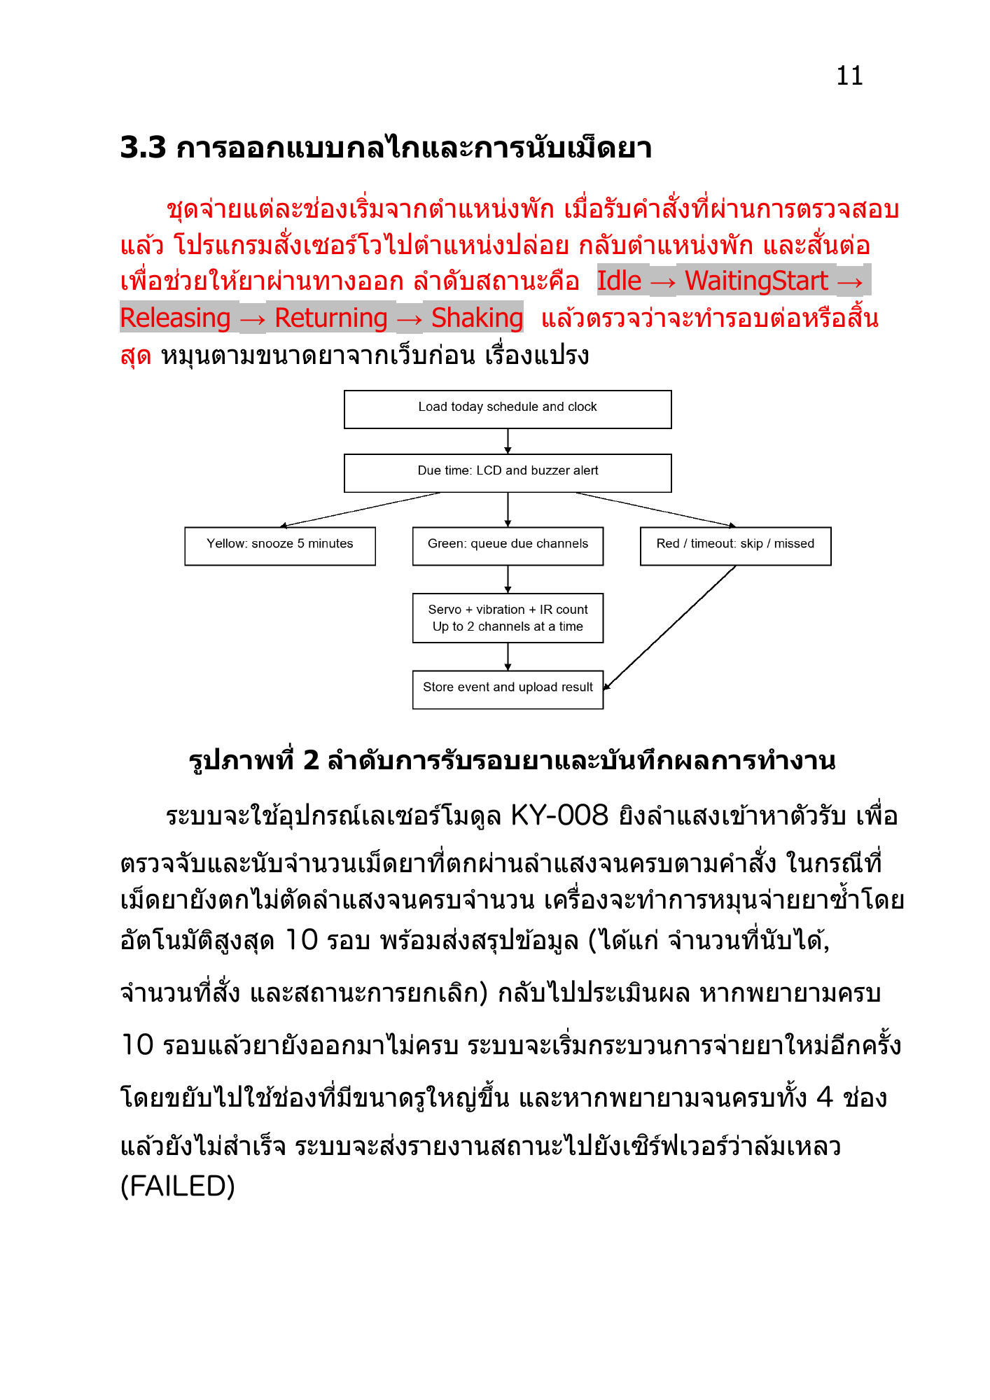
output/restart/qa/original-render/page-15.png
