Comxt-i/smart-pill-dispenser/output/restart/qa/original-render/page-16.png

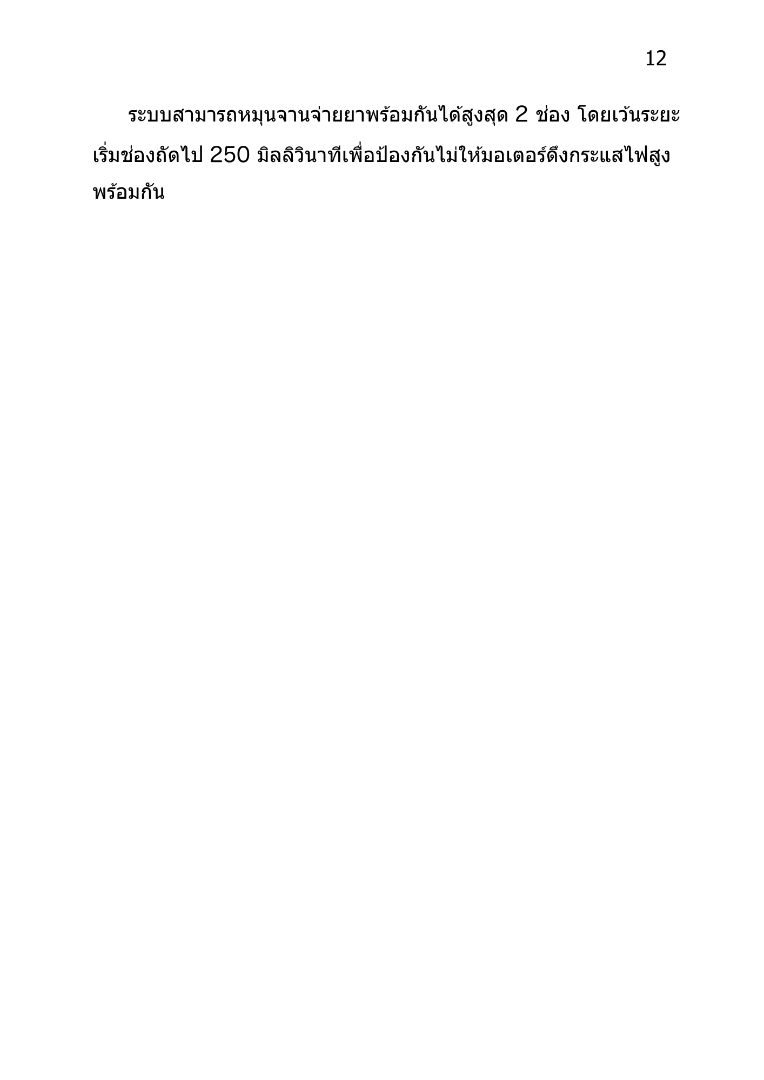
output/restart/qa/original-render/page-16.png
