Comxt-i/smart-pill-dispenser/output/restart/qa/original-render/page-17.png

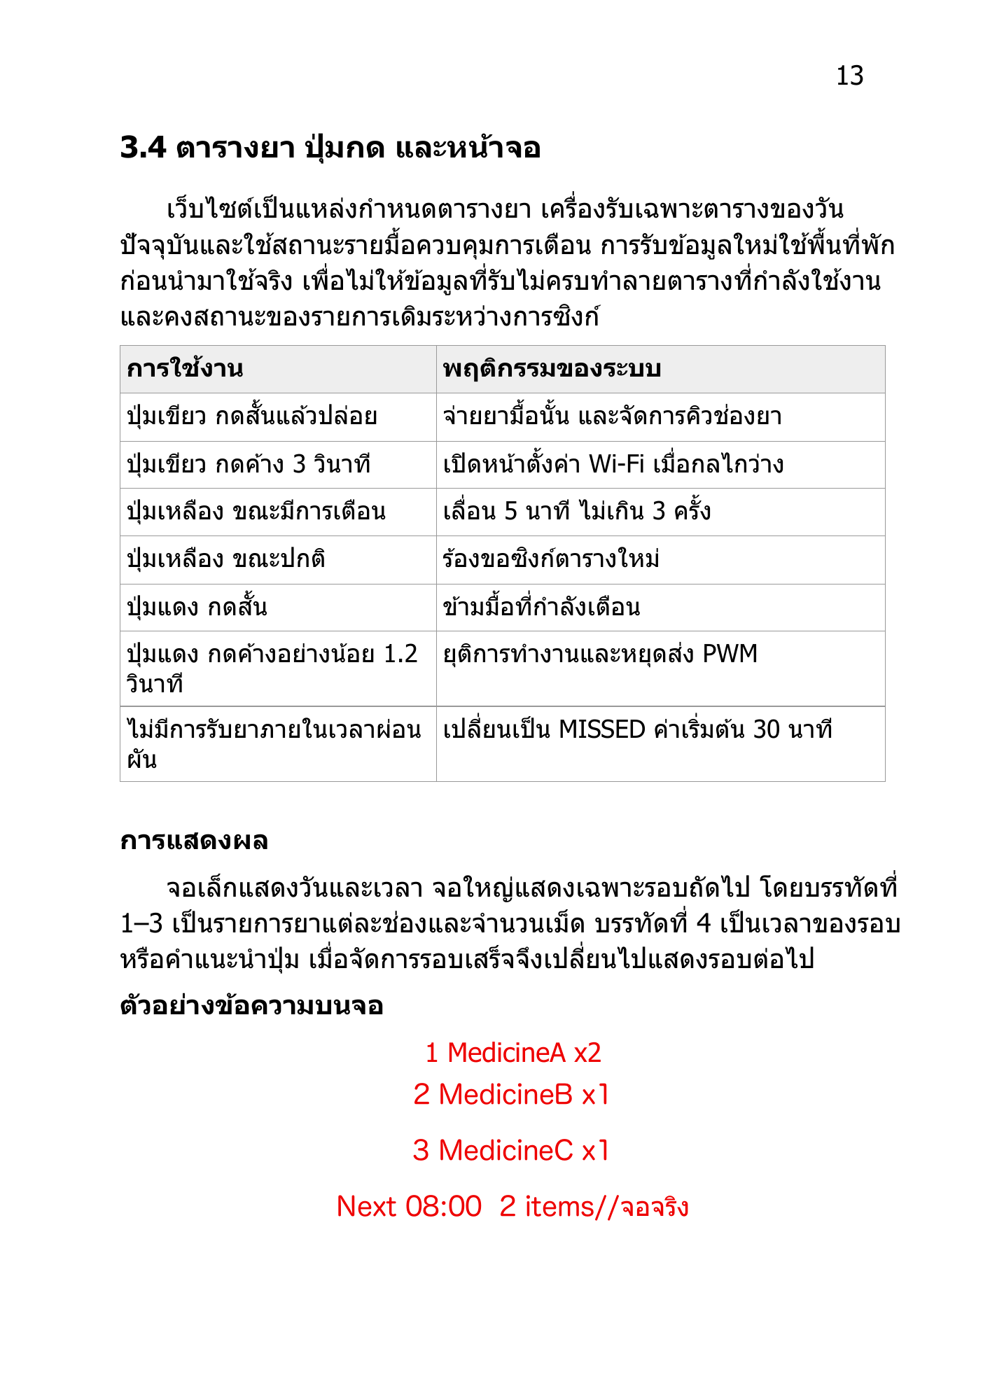
output/restart/qa/original-render/page-17.png
