Comxt-i/smart-pill-dispenser/output/restart/qa/original-render/page-18.png

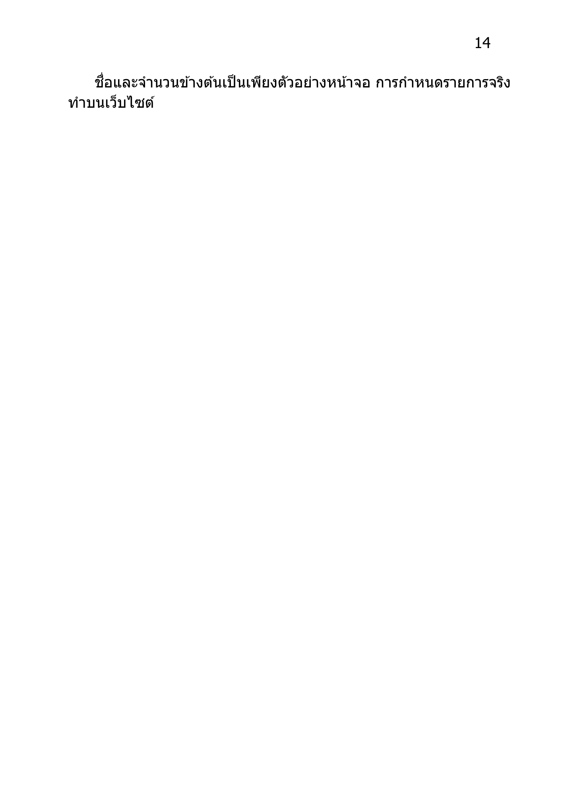
output/restart/qa/original-render/page-18.png
