Comxt-i/smart-pill-dispenser/output/restart/qa/original-render/page-19.png

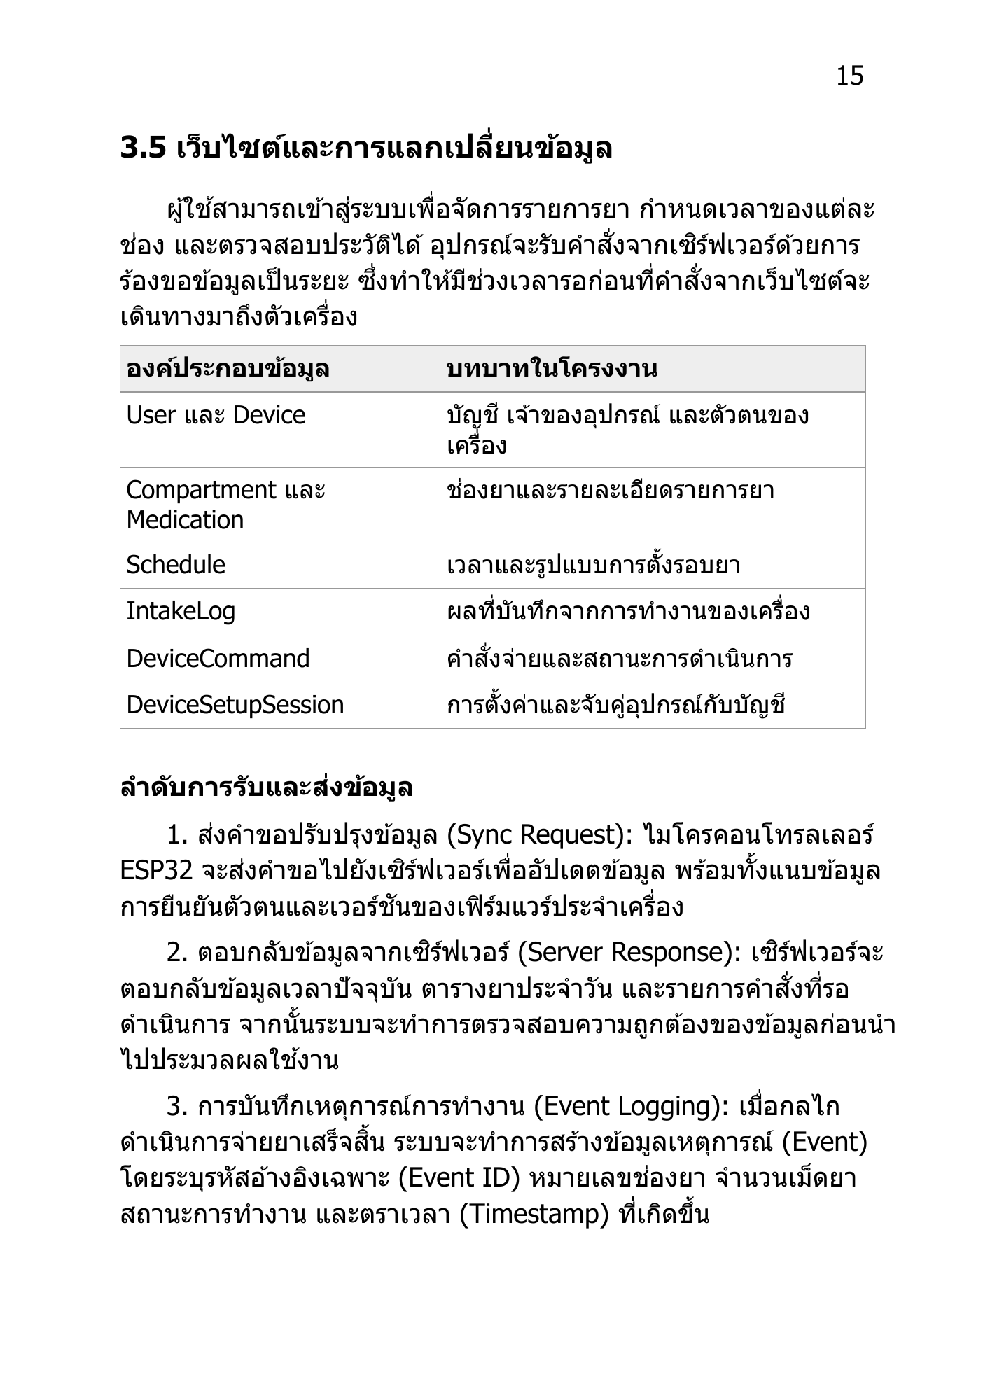
output/restart/qa/original-render/page-19.png
