Comxt-i/smart-pill-dispenser/output/restart/qa/original-render/page-20.png

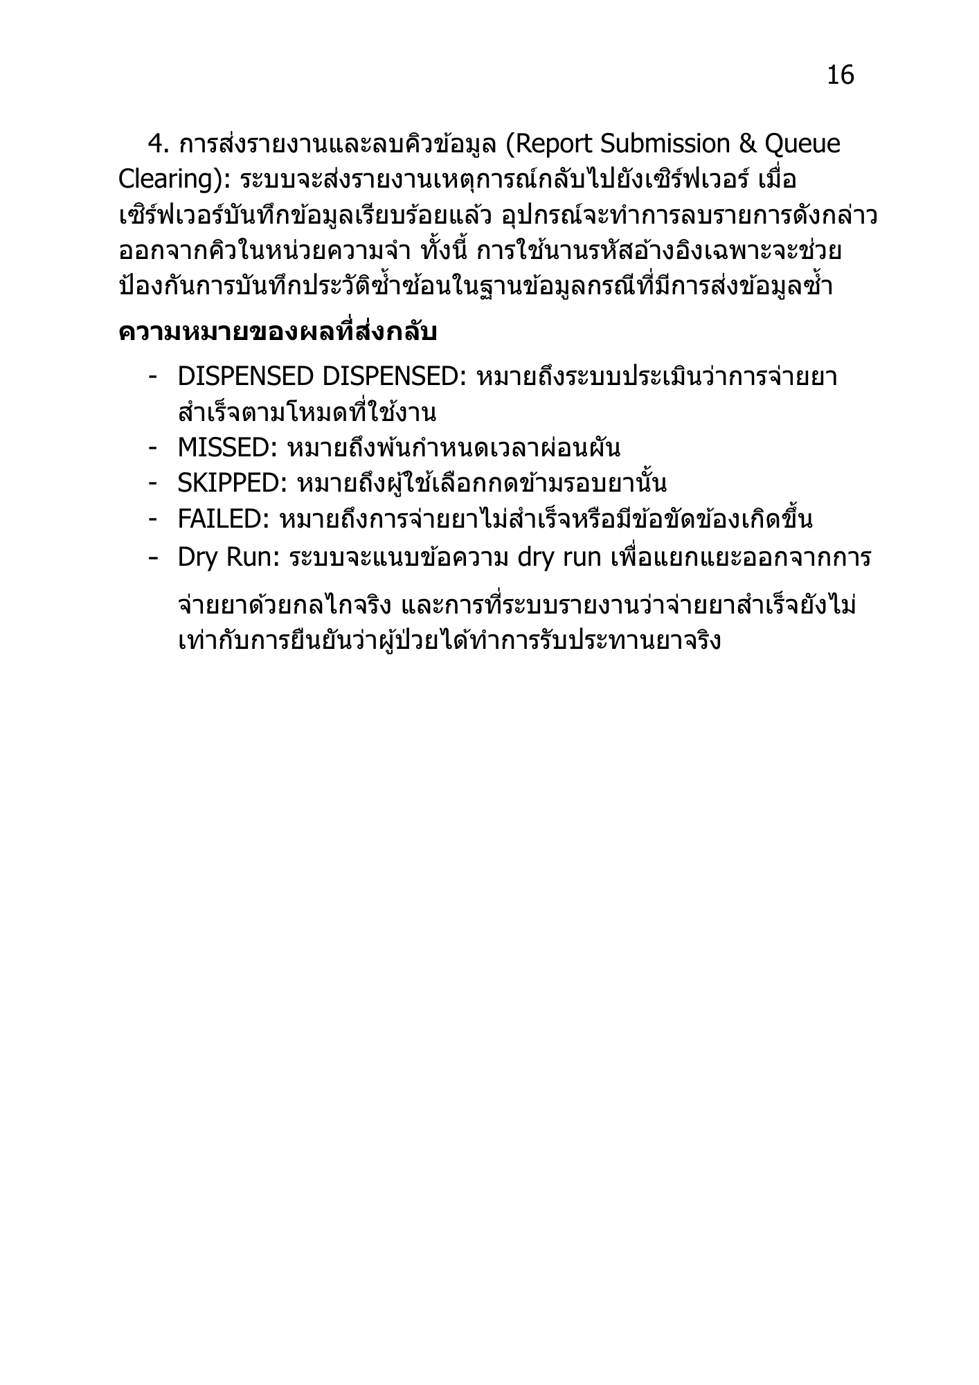
output/restart/qa/original-render/page-20.png
