Comxt-i/smart-pill-dispenser/output/restart/qa/original-render/page-21.png

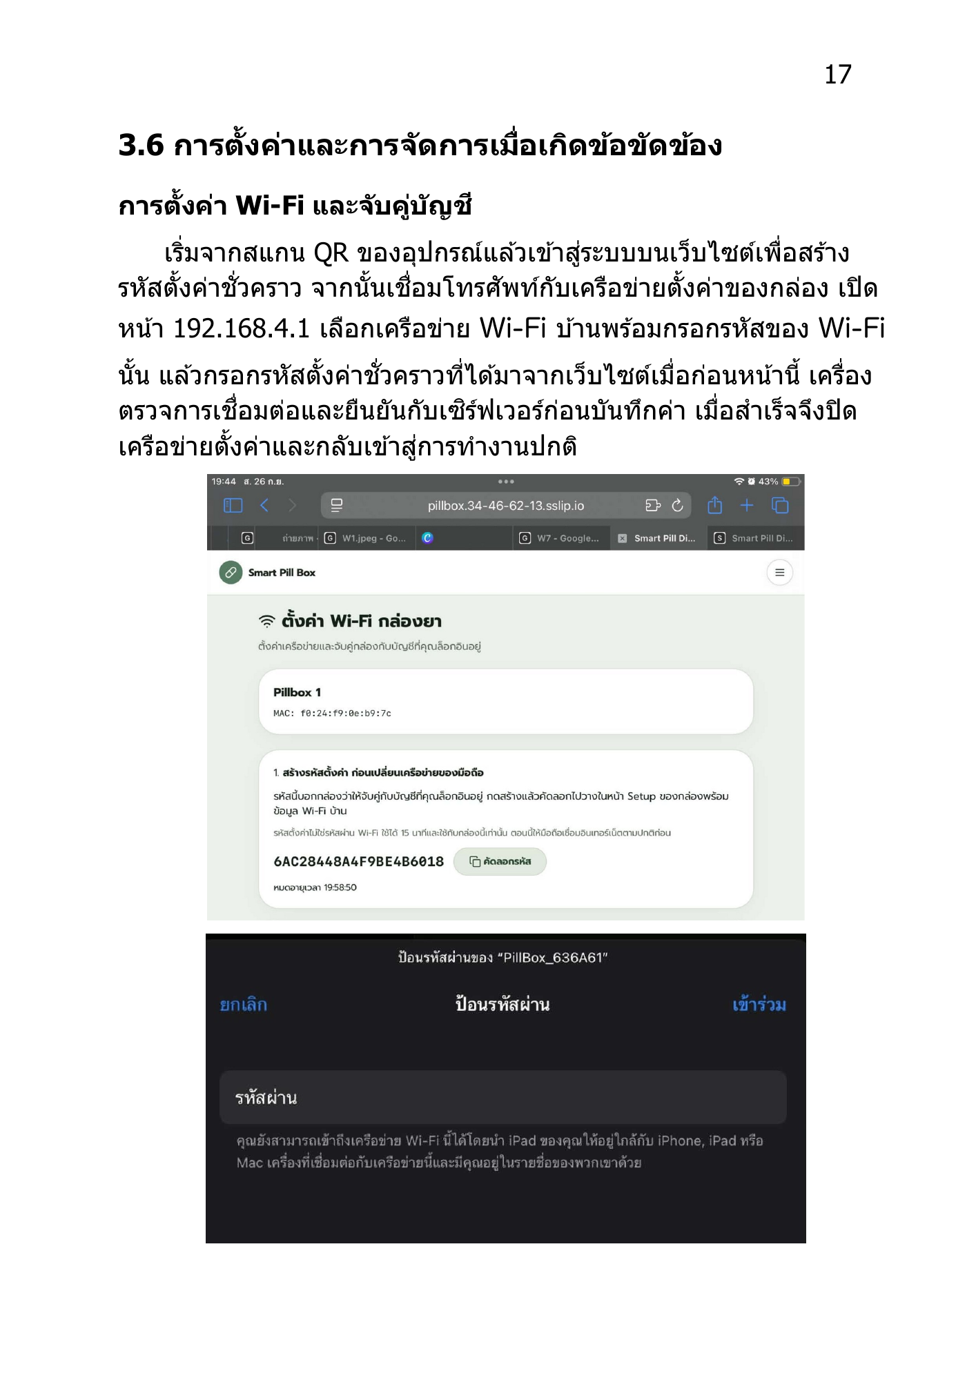
output/restart/qa/original-render/page-21.png
