Comxt-i/smart-pill-dispenser/output/restart/qa/original-render/page-22.png

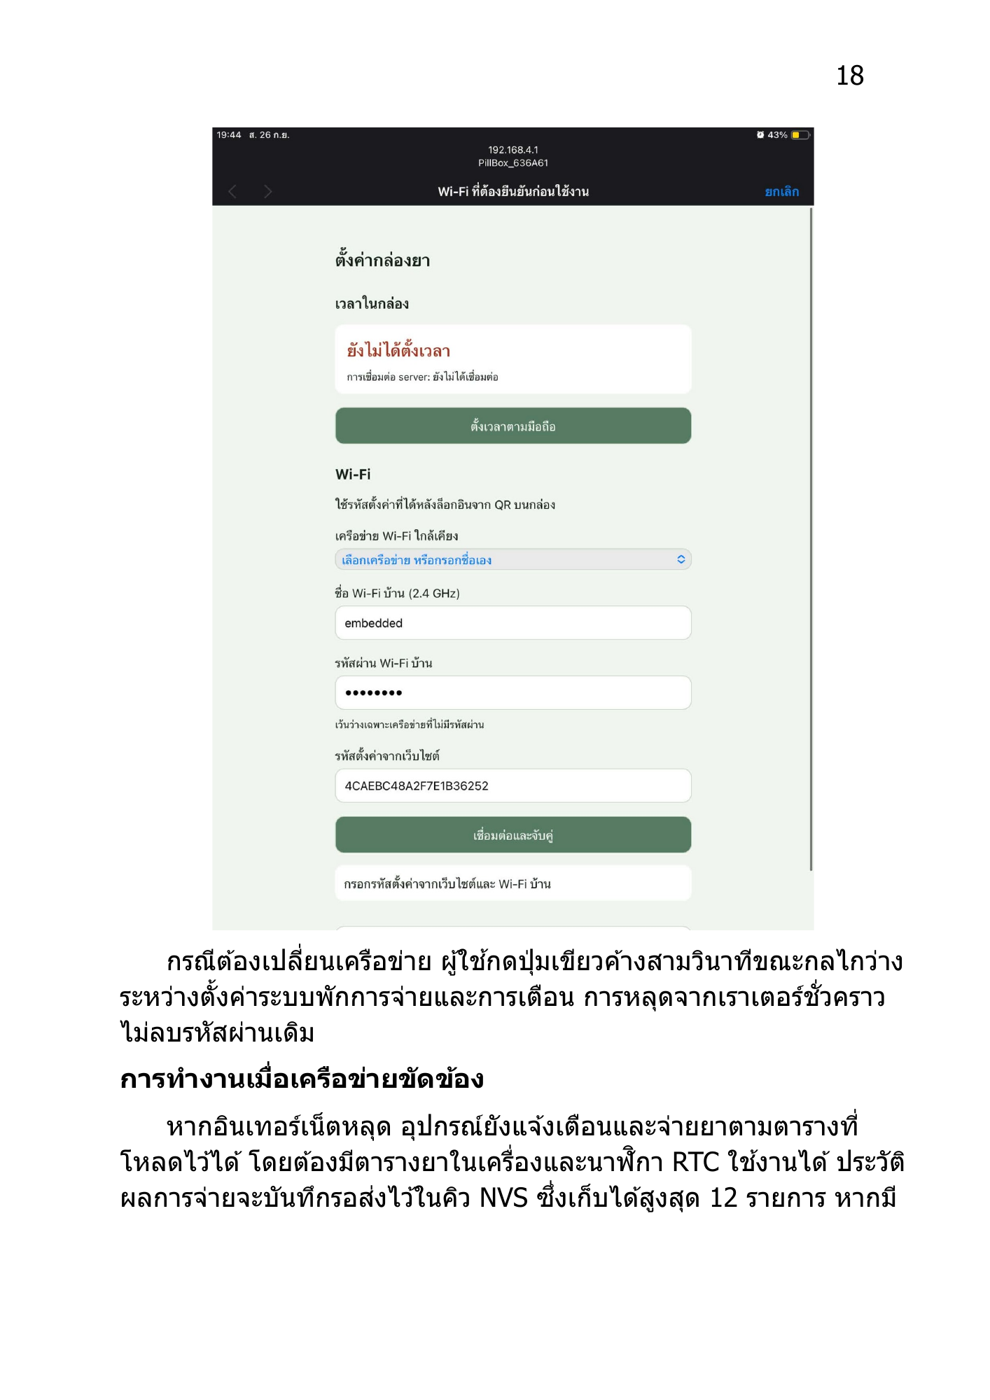
output/restart/qa/original-render/page-22.png
