Comxt-i/smart-pill-dispenser/output/restart/qa/original-render/page-23.png

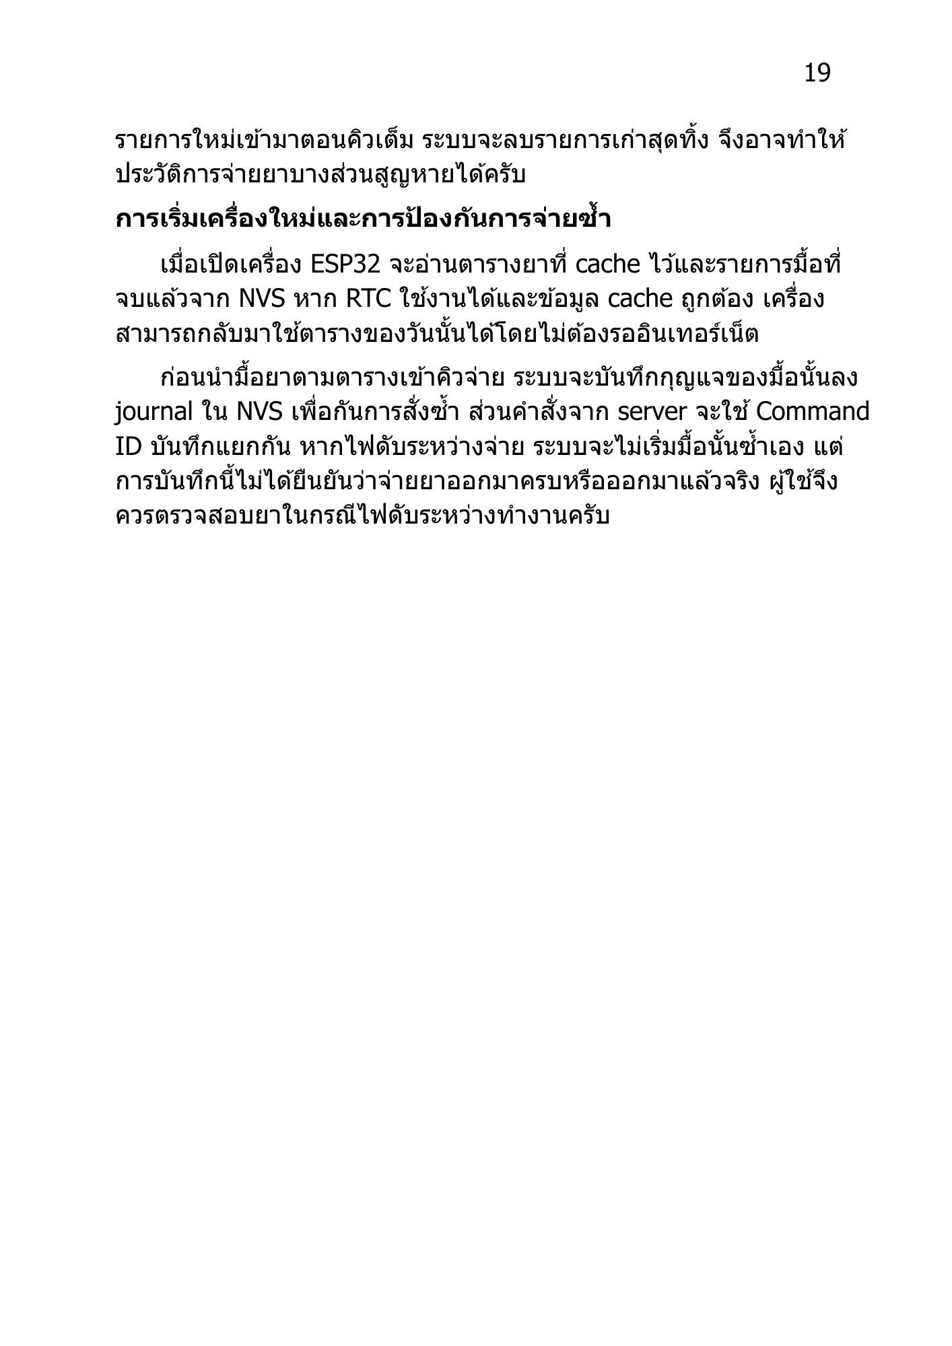
output/restart/qa/original-render/page-23.png
