Comxt-i/smart-pill-dispenser/output/restart/qa/original-render/page-24.png

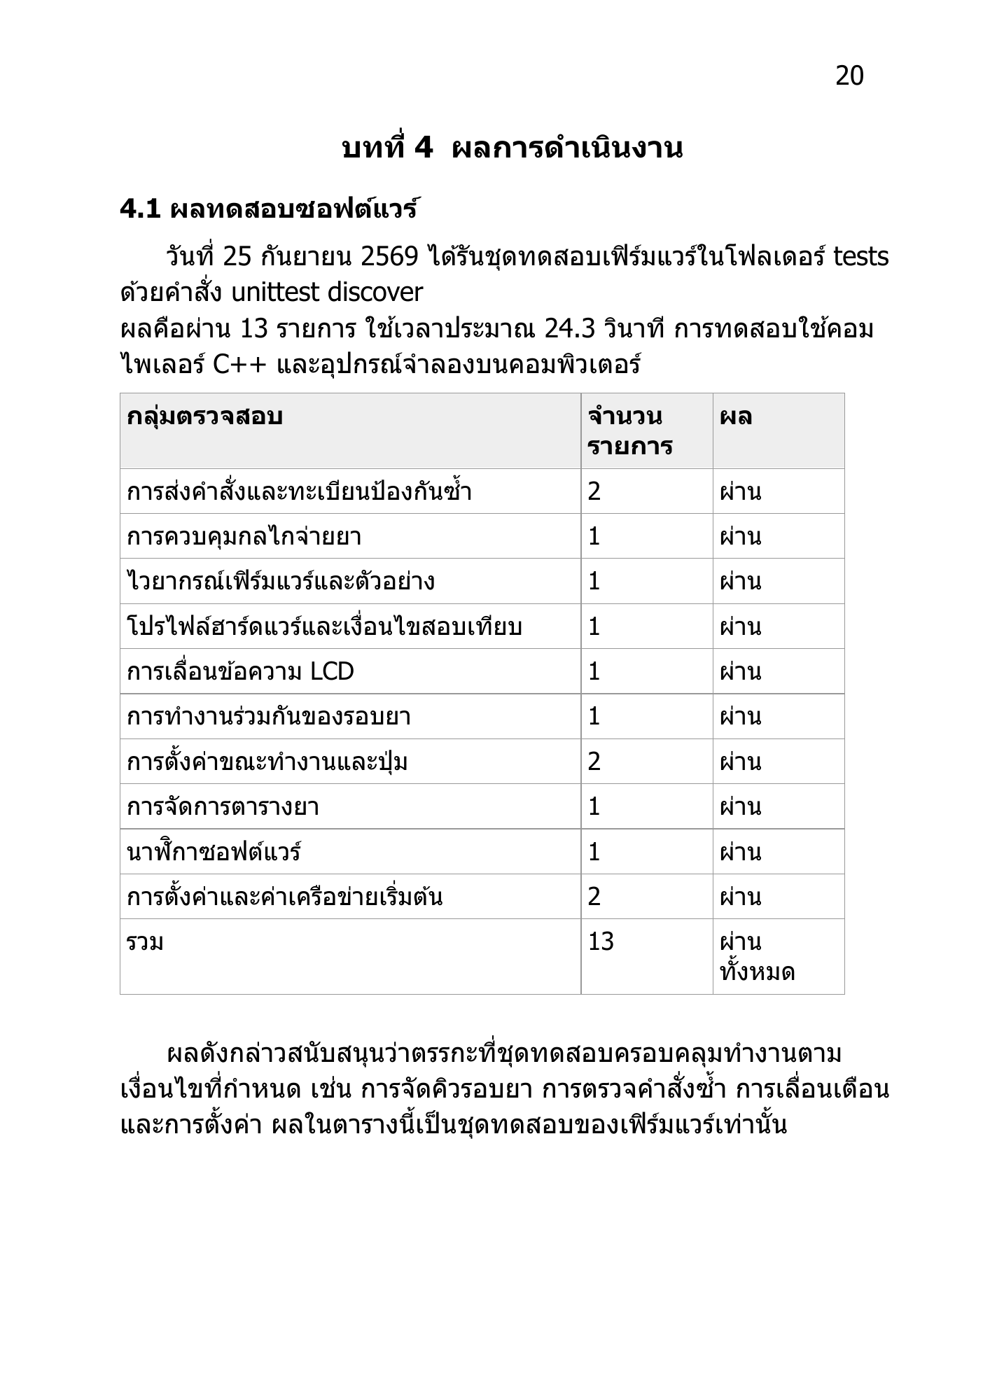
output/restart/qa/original-render/page-24.png
