Comxt-i/smart-pill-dispenser/output/restart/qa/original-render/page-25.png

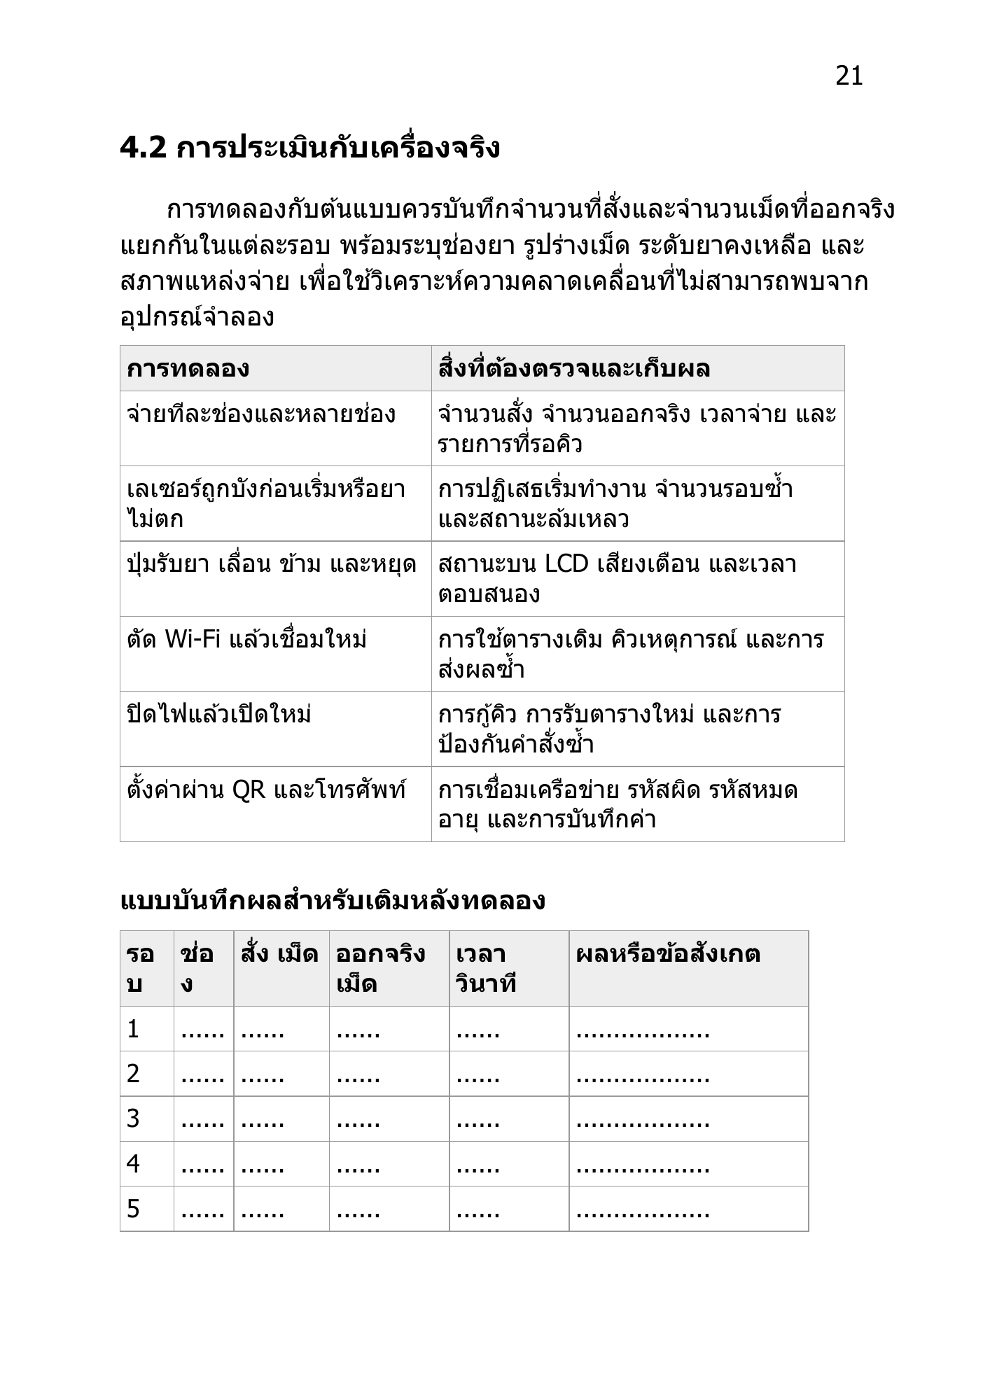
output/restart/qa/original-render/page-25.png
