Comxt-i/smart-pill-dispenser/output/restart/qa/original-render/page-26.png

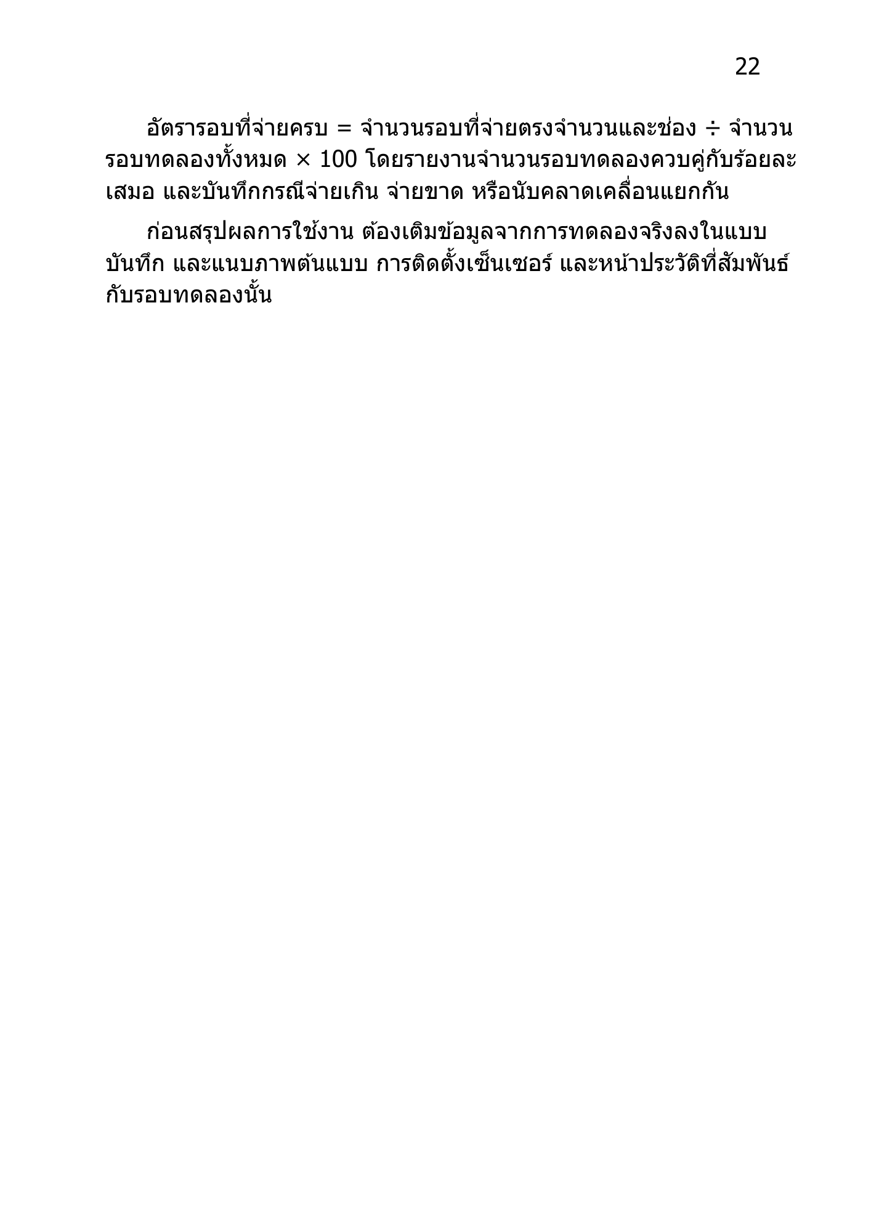
output/restart/qa/original-render/page-26.png
