Comxt-i/smart-pill-dispenser/output/restart/qa/original-render/page-27.png

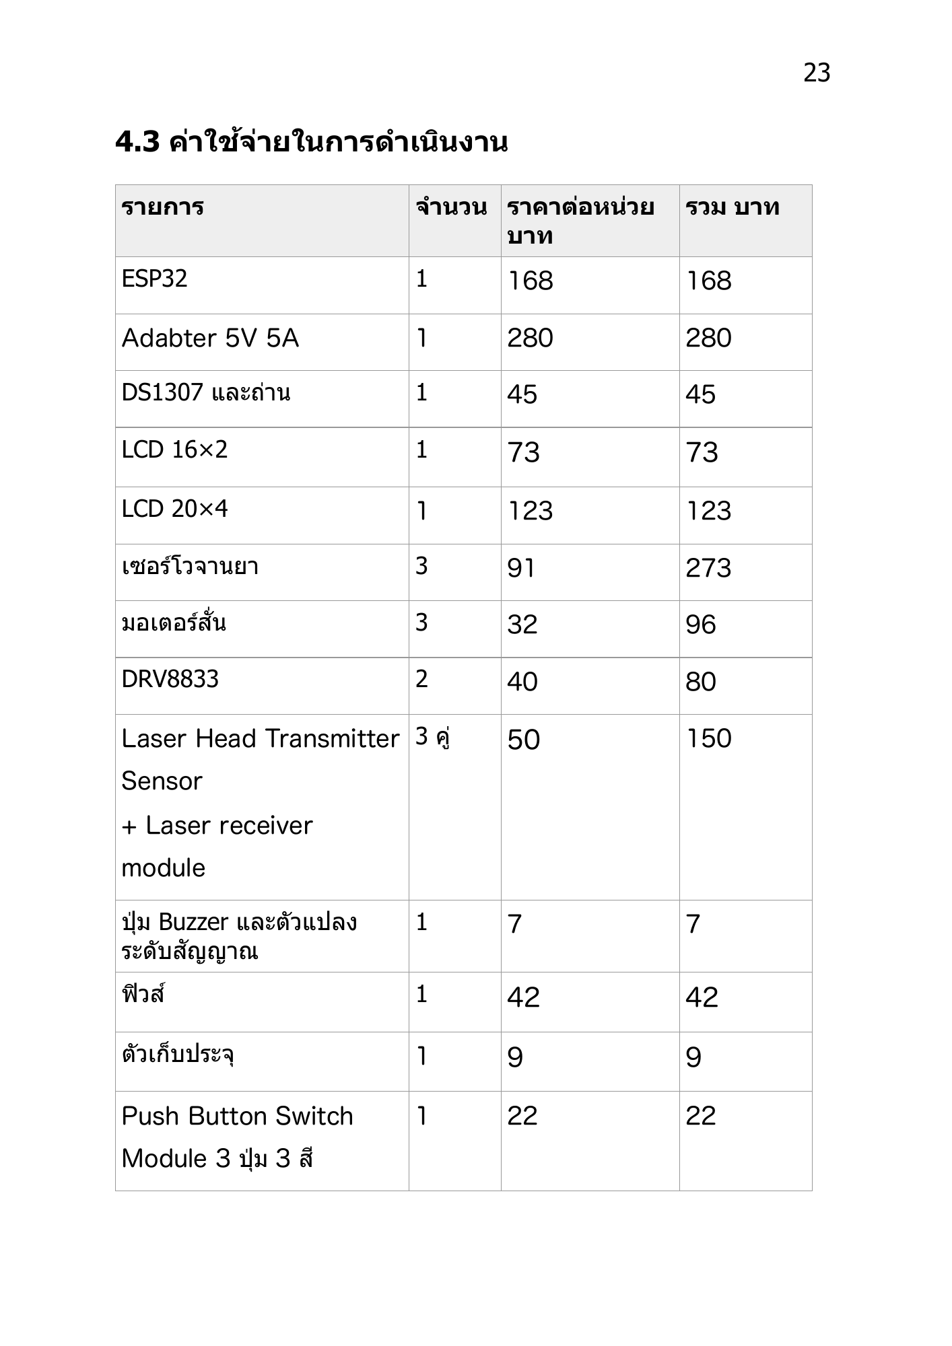
output/restart/qa/original-render/page-27.png
