Comxt-i/smart-pill-dispenser/output/restart/qa/original-render/page-28.png

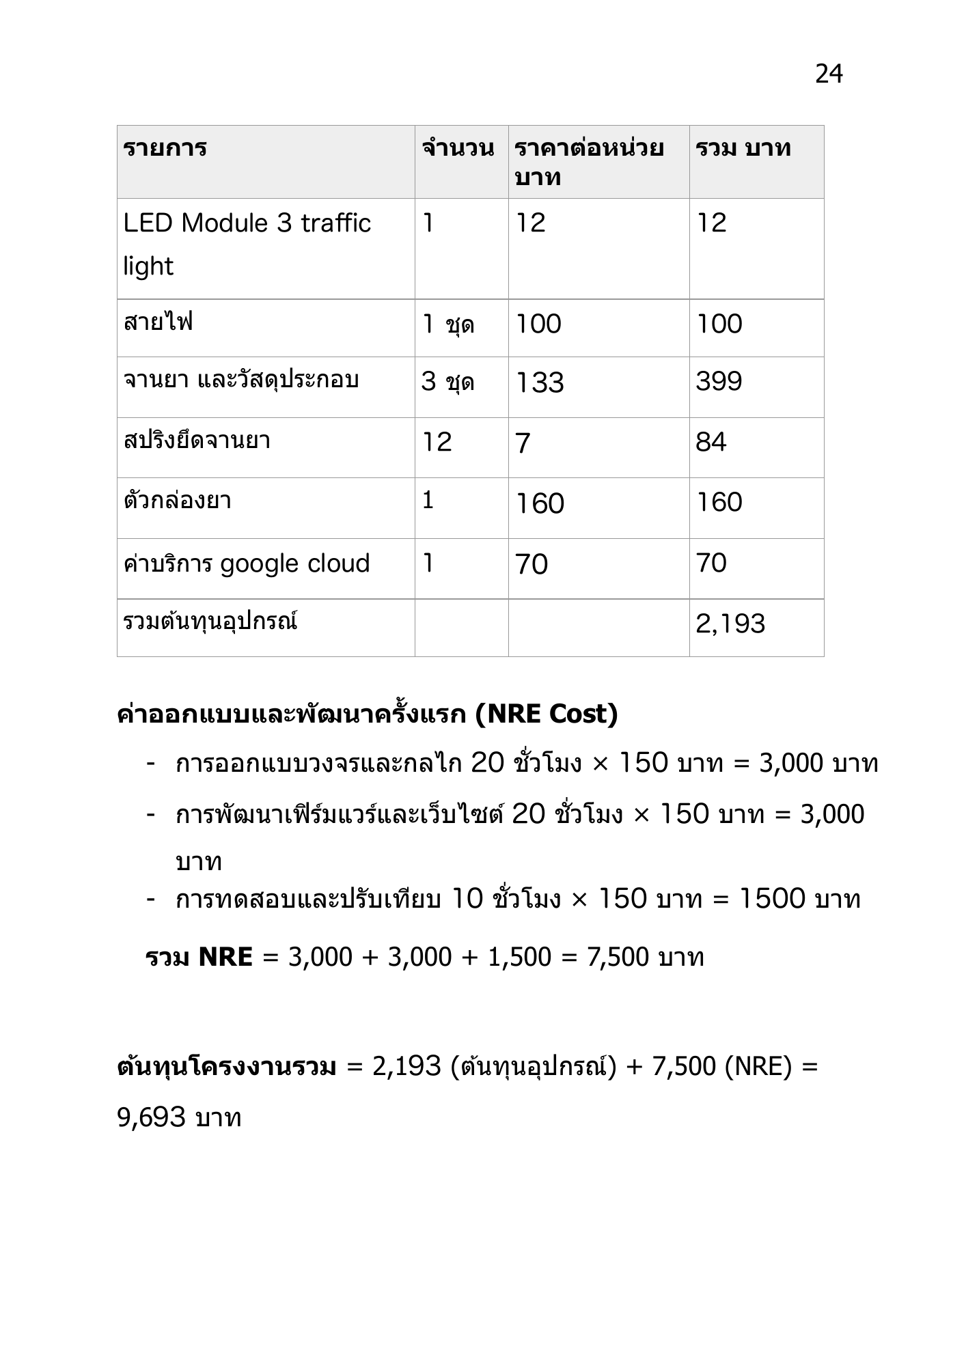
output/restart/qa/original-render/page-28.png
