Comxt-i/smart-pill-dispenser/output/restart/qa/original-render/page-29.png

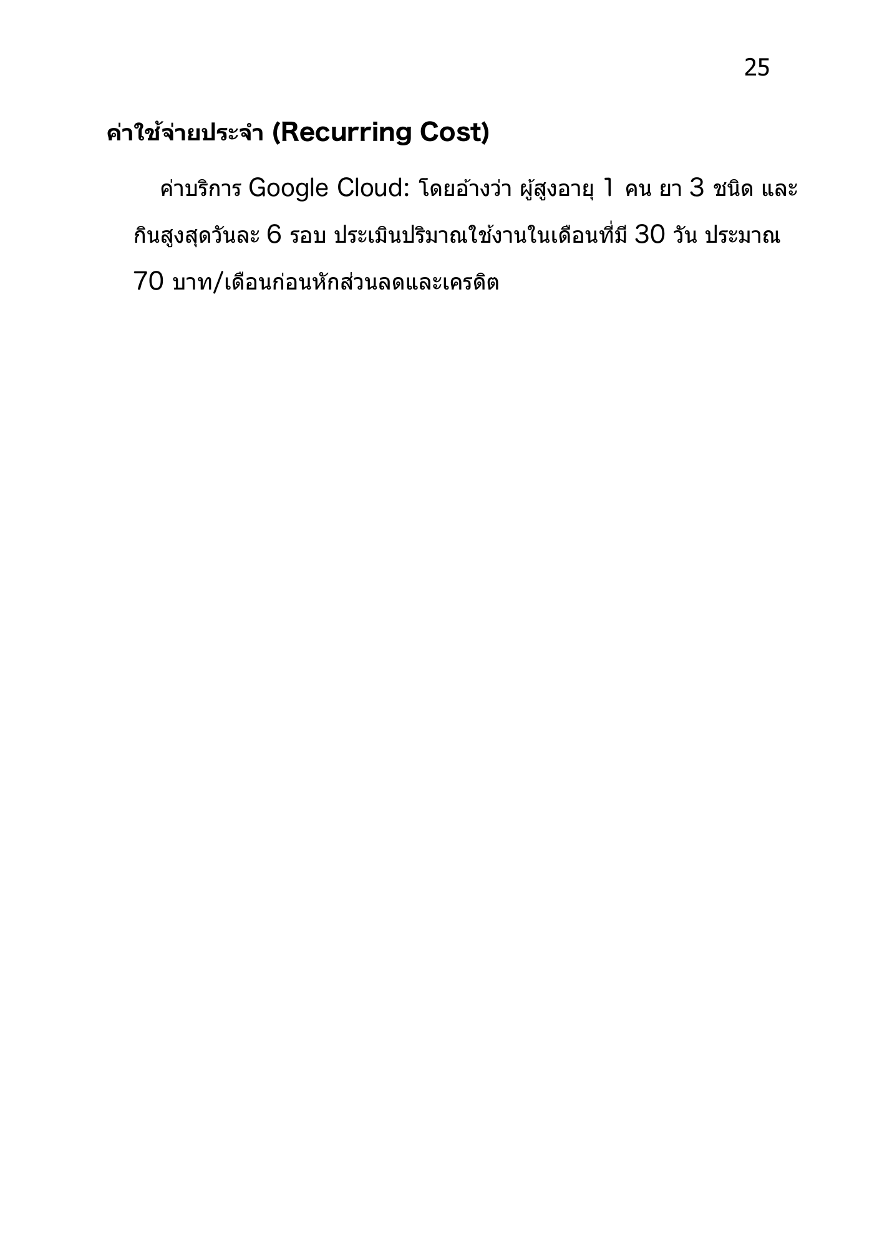
output/restart/qa/original-render/page-29.png
