Comxt-i/smart-pill-dispenser/output/restart/qa/original-render/page-30.png

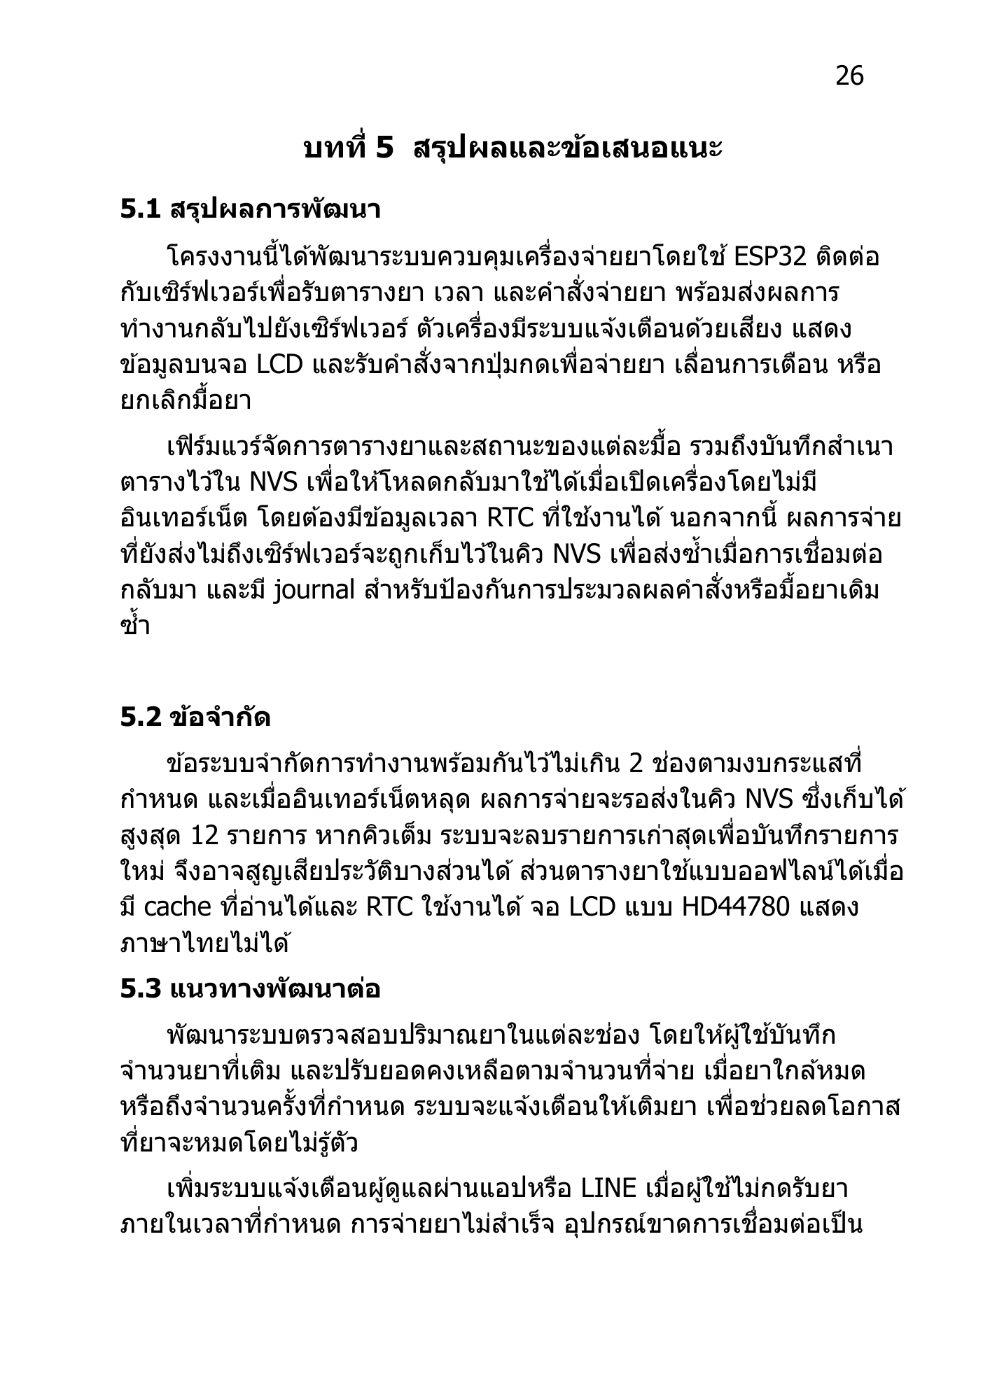
output/restart/qa/original-render/page-30.png
