Comxt-i/smart-pill-dispenser/output/restart/qa/source-images-0.jpg

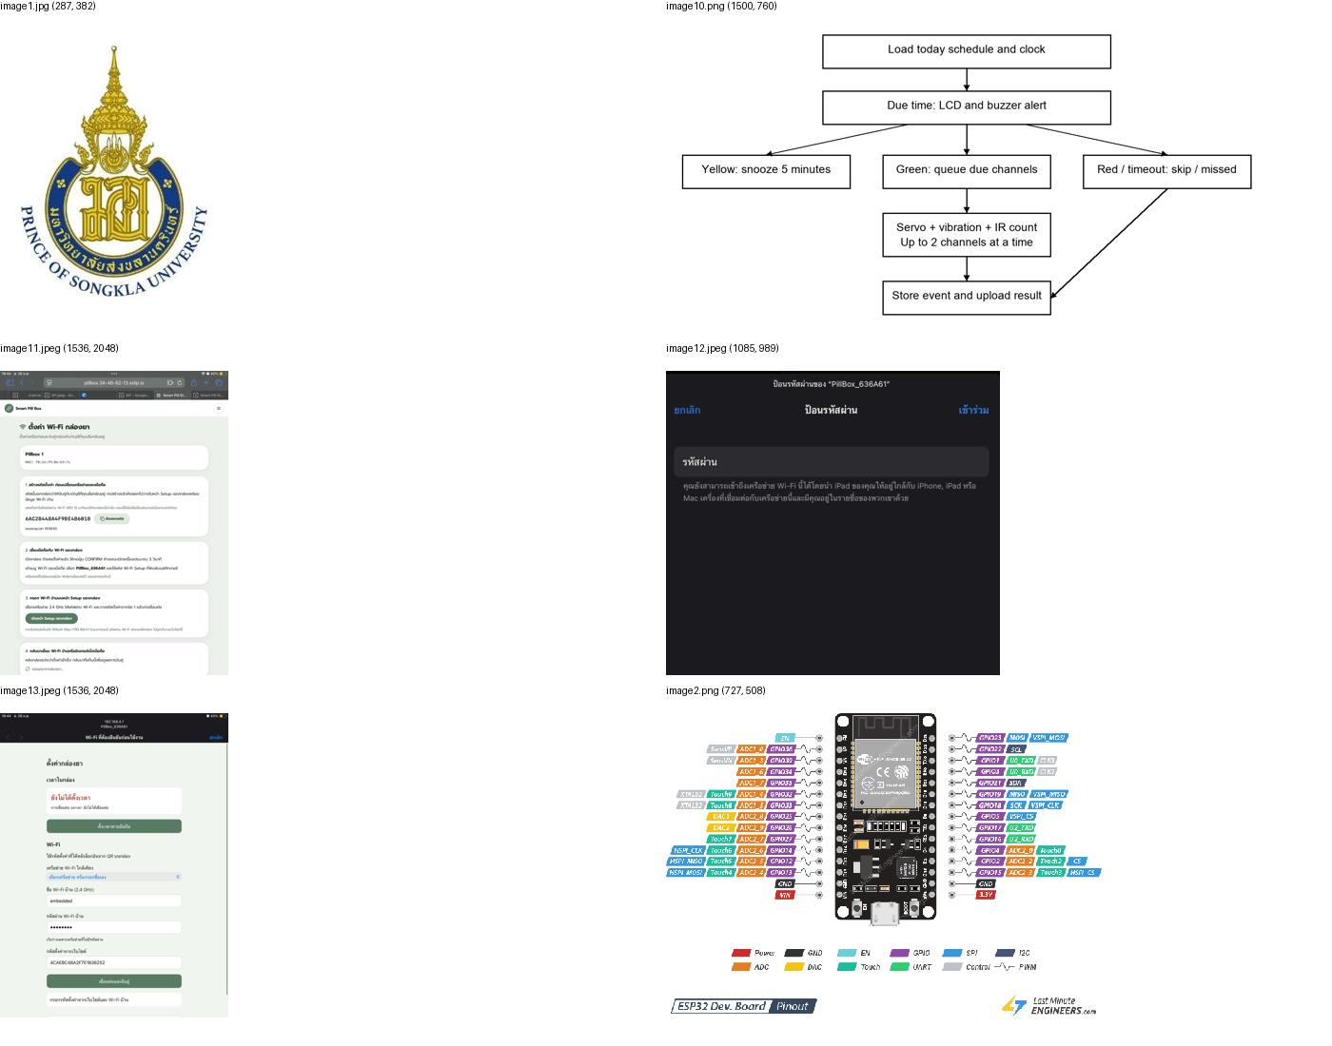
output/restart/qa/source-images-0.jpg
