Comxt-i/smart-pill-dispenser/output/restart/qa/source-images-2.jpg

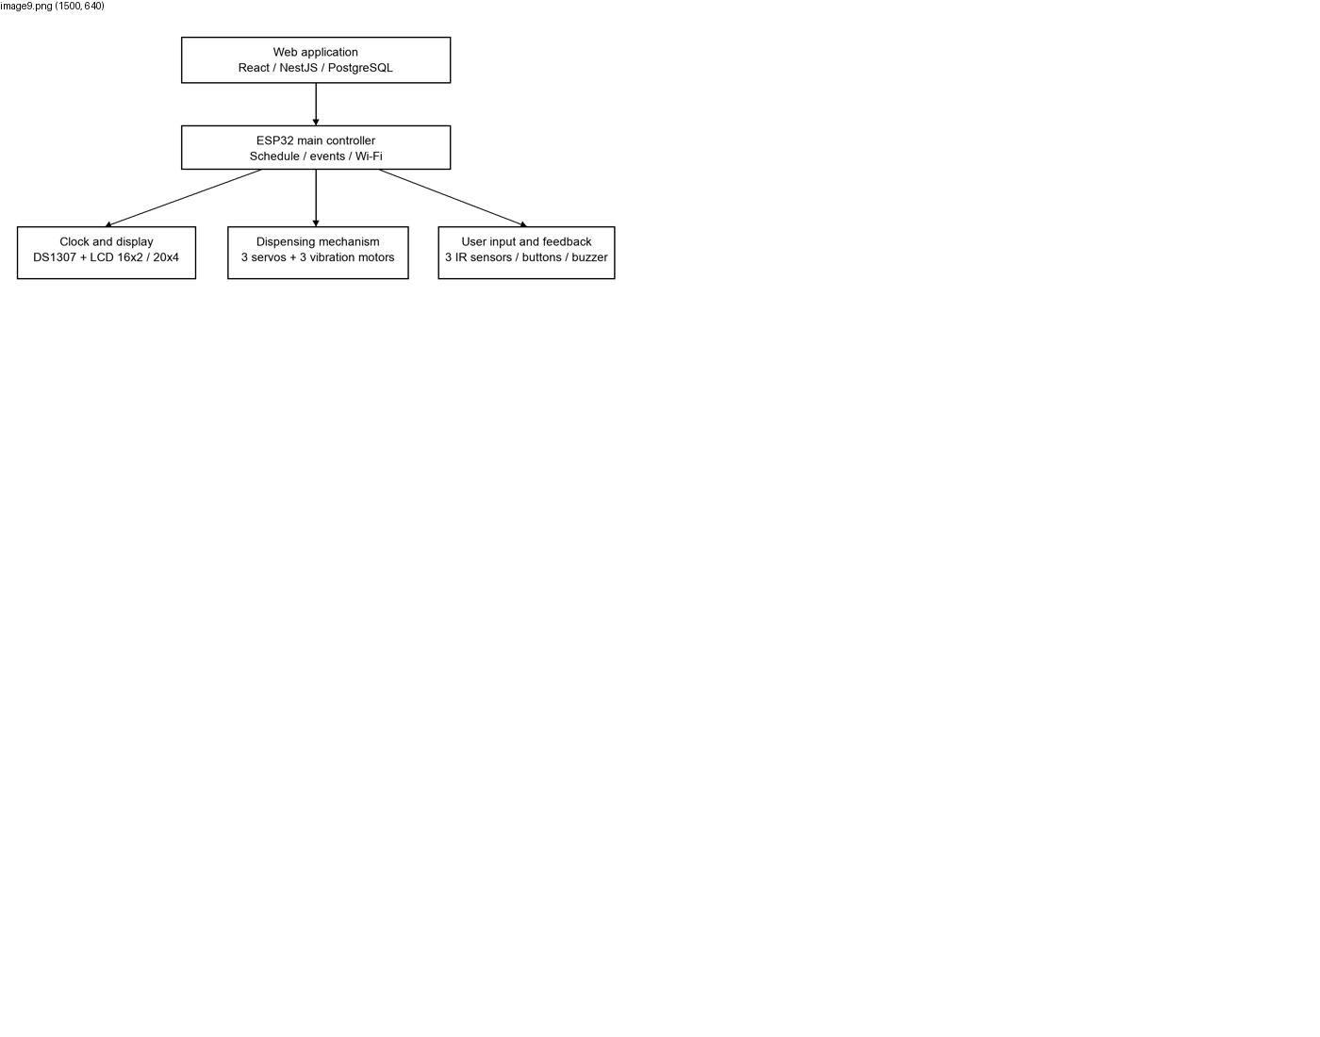
output/restart/qa/source-images-2.jpg
