Comxt-i/smart-pill-dispenser/ESP32_Main/dispenser_control.h

#pragma once

#include "config.h"
#include <Arduino.h>

// SensorBlocked = ตัวรับไม่เห็นแสงเลเซอร์ (มีของขวาง เล็งไม่ตรง หรือตัวรับไม่มีไฟ แยกกันไม่ได้ทางไฟฟ้า)
// LaserOff      = สั่งเปิดเลเซอร์ไม่ได้ (PCF8574 ไม่ตอบทางบัส I2C)
// SensorUnstable = ตัวรับเห็นแสงบ้างไม่เห็นบ้าง (จุดแสงค่อนขอบตัวรับ ยึดไม่แน่น) นับเม็ดไม่ได้
enum class DispenseResult {
  Started, Invalid, Disabled, Busy, Cancelled, ServoError, SensorBlocked, LaserOff, SensorUnstable
};

/**
 * ผลของการจ่ายยาหนึ่งครั้งที่ "จบแล้ว" ไม่ว่าจะจบครบหรือถูกยกเลิกกลางคัน
 *
 * นับเป็นเม็ด ไม่ใช่รอบหมุน เพราะเซ็นเซอร์ IR ยืนยันเม็ดที่ตกจริง
 * จำนวนรอบที่หมุนไปกี่รอบเป็นเพียงผลพลอยได้ เก็บไว้ดูว่ากลไกฝืดแค่ไหน
 */
/**
 * เหตุที่รอบจ่ายจบ ส่งขึ้นบันทึกบนเว็บ ดูจากมือถือได้ว่าทำไมจานหยุด โดยไม่ต้องต่อคอมดู Serial
 */
enum class StopReason : uint8_t {
  Done,           // นับได้ครบตามที่สั่ง
  AllHolesTried,  // ลองครบทุกช่องแล้วไม่มีเม็ดตกเพิ่ม
  Jam,            // ลำแสงถูกบังค้าง มีของติดขวาง
  Noise,          // สัญญาณรบกวนถี่จนนับไม่ได้ หยุดกันจ่ายเกิน
  Cancelled,      // ถูกสั่งหยุด (ปุ่มแดง)
  AttemptLimit,   // ชนเพดานจำนวนรอบ (ตามตรรกะไม่ควรเกิด)
};

struct DispenseOutcome {
  uint8_t dispenser;       // จาน 1..DISPENSER_COUNT
  uint8_t requestedPills;  // จำนวนเม็ดที่สั่ง
  uint8_t dispensedPills;  // จำนวนเม็ดที่ตกจริง (ถ้า sensorVerified เป็น false คือค่าที่อนุมาน)
  uint8_t attempts;        // หมุนไปกี่รอบกว่าจะได้ครบ
  bool cancelled;          // true = ถูกสั่งหยุดก่อนครบ
  bool sensorVerified;     // true = นับจากเซ็นเซอร์ IR จริง
  StopReason stopReason;   // ทำไมรอบนี้จบ (finishRun ตั้งให้ทุกครั้ง)
  // ลำแสงถูกบังแต่ไม่ถึงเกณฑ์ PILL_MIN_BLOCK_US (ไม่นับเป็นเม็ด) กี่ครั้ง และนานสุดเท่าไร
  // ใช้แยก "เซ็นเซอร์เห็นเม็ดเล็กแต่สั้นเกินเกณฑ์" ออกจาก "เซ็นเซอร์ไม่เห็นอะไรเลย"
  uint8_t uncountedBlocks;
  uint32_t longestUncountedUs;
  // เม็ดที่บังลำแสงสั้นที่สุดในบรรดาที่นับได้ (0 = ไม่ได้นับเลย) ถ้าใกล้ PILL_MIN_BLOCK_US = เกณฑ์เสี่ยงนับขาด
  uint32_t shortestCountedUs;
  // นานที่สุด ถ้ายาวกว่าสั้นสุดหลายเท่า = ยาตกติดกันเป็นก้อน (นับเป็นเม็ดเดียว เสี่ยงให้ยาเกิน)
  uint32_t longestCountedUs;
};

/**
 * ดับมอเตอร์สั่นทั้งสามตัวทันที ต้องเป็นคำสั่งแรกสุดใน setup()
 *
 * GPIO14 (ขา DIR ของจาน 3) ปล่อยสัญญาณคล็อกออกมาเองตอนบูตตามปกติของชิป
 * กับ DRV8833 นั่นแปลว่า IN2=HIGH ขณะที่ IN1 ยังลอยอยู่ = มอเตอร์วิ่งเต็มกำลัง
 * และจะวิ่งไปเรื่อยๆ จนกว่าจะมีคนเขียนขานั้นให้เป็น LOW
 *
 * แยกออกมาจาก dispenserControlBegin() เพราะตัวนั้นอยู่ท้าย setup()
 * กว่าจะถึงก็ผ่าน Serial, ปุ่มบูต และการสแกน I2C ไปแล้วเป็นวินาที
 */
void dispenserSafePinsEarly();

void dispenserControlBegin();

/**
 * พาทุกจานกลับตำแหน่งพัก (135 องศา กึ่งกลางของ servo 270 องศา) ตอนเปิดเครื่อง
 *
 * ปกติ servo ถูกขับเฉพาะตอนจ่ายยาแล้วปล่อยแรงหลังจบ เพื่อไม่ให้ครางและกินไฟ
 * ผลคือหลังไฟดับหรือหยุดฉุกเฉิน จานค้างอยู่ตำแหน่งไหนก็ตำแหน่งนั้น ไม่ได้เริ่มที่กึ่งกลาง
 *
 * ขยับทีละจาน กระแสกระชากของ servo จะได้ไม่ซ้อนกันสามตัว เรียกใน setup() เท่านั้น (block ราว 2 วินาที)
 */
void dispenserHomeAll();
void dispenserControlUpdate();

/**
 * สั่งจ่ายยา `pills` เม็ดจากจาน `dispenser`
 *
 * จะวนหมุน-เขย่าเป็นรอบๆ จนเซ็นเซอร์นับครบ
 *
 * `preferredHole` คือช่องปล่อยยาตามขนาดที่ผู้ใช้กรอกบนเว็บ (0-3 จากเล็กไปใหญ่)
 * ลองช่องนั้นก่อน ATTEMPTS_PER_HOLE รอบ ไม่ตกก็ไล่ไปช่องที่ใหญ่กว่า (ไม่ย้อนไปช่องที่เล็กกว่า)
 * PILL_HOLE_ANY = ไม่ได้กรอก ไล่จากช่องเล็กสุด
 * ไม่มีเซ็นเซอร์: หมุนหนึ่งรอบต่อเม็ดที่ช่องแรกเท่านั้น ไม่วนหาช่อง
 * ไม่ block — ต้องเรียก dispenserControlUpdate() ทุกลูป
 *
 * หลายจานทำงานพร้อมกันได้ถึง MAX_CONCURRENT_DISPENSERS จาน
 * เกินกว่านั้นจะคืน Busy ผู้เรียกต้องลองใหม่เมื่อ dispenserHasCapacity() เป็น true
 */
DispenseResult dispenseMedicine(uint8_t dispenser, uint8_t pills,
                                int8_t preferredHole = PILL_HOLE_ANY);

/** หยุดทุกจานที่กำลังทำงานอยู่ */
void stopDispenser();

/** true ขณะมีจานใดจานหนึ่งกำลังทำงานอยู่ */
bool dispenserIsBusy();

/** true เมื่อยังรับคำสั่งจ่ายเพิ่มได้อีกอย่างน้อยหนึ่งจาน */
bool dispenserHasCapacity();

/**
 * ดึงผลของรอบที่เพิ่งจบออกมาหนึ่งครั้ง (คืน false ถ้ายังไม่มีผลใหม่)
 * ใช้ให้ loop หลักรู้ว่าจ่ายเสร็จเมื่อไรโดยไม่ต้องรอแบบ blocking
 */
bool takeDispenseOutcome(DispenseOutcome &outcome);

/** อ่านสถานะดิบของเซ็นเซอร์ IR ของจานหนึ่ง สำหรับหน้าเว็บวินิจฉัย */
bool pillSensorBlocked(uint8_t dispenser);

/**
 * ตรวจตัวรับเลเซอร์ทุกจานตอนนี้เลย (เปิดเลเซอร์แป๊บหนึ่ง เทียบตอนมืดกับตอนสว่าง แล้วดับ)
 * ใช้ตอนเปิดเครื่อง ให้เห็นผลบนจอโดยไม่ต้องต่อคอม ข้ามเองถ้ามีจานทำงานอยู่
 */
void dispenserSensorSelfTest();
/** PCF8574 ที่คุม relay เลเซอร์ตอบครั้งล่าสุดที่สั่งไหม (ไม่ใช้สวิตช์เลเซอร์ = true) */
bool laserSwitchResponding();
/** ตัวรับของจานนั้น: 1 = ใช้ได้, 0 = ไม่เห็นแสงเลเซอร์, 2 = แสงไม่นิ่ง (กะพริบ), -1 = ยังไม่ได้ตรวจหรือปิดเซ็นเซอร์ */
int8_t pillSensorStatus(uint8_t dispenser);
/**
 * ผลนับจากการตรวจตัวรับครั้งล่าสุด: อ่านได้ HIGH กี่ครั้งจาก LASER_CHECK_SAMPLES ตอนเลเซอร์ดับและตอนติด
 * ส่งขึ้นเว็บให้ไล่ปัญหาจากมือถือได้ (ต่อคอมดู Serial พร้อม adapter ไม่ได้) คืน false ถ้ายังไม่ได้ตรวจ
 */
bool pillSensorReads(uint8_t dispenser, uint8_t &darkHigh, uint8_t &litHigh);
/**
 * จานที่ตรวจไม่ผ่านเสียแบบไหน สั้นพอขึ้นจอ (ภาษาอังกฤษ) nullptr = ผ่านหรือยังไม่ได้ตรวจ
 *   "LIGHT W/O LASER"  ตัวรับเห็นแสงทั้งที่เลเซอร์ดับ: แสงรอบข้างส่องเข้าตัวรับ
 *                      หรือเลเซอร์จานนั้นต่อไฟตรง ไม่ผ่าน NO ของ relay (ติดตลอด)
 *   "NEVER SEES LASER" ตัวรับไม่เห็นแสงเลเซอร์เลย: เล็งไม่โดน เลเซอร์ไม่ติด หรือตัวรับไม่มีไฟ
 *   "BEAM FLICKERS"    แสงไม่นิ่ง: จุดแสงค่อนขอบตัวรับ หรือยึดไม่แน่น
 */
const char *pillSensorFaultHint(uint8_t dispenser);
