Comxt-i/smart-pill-dispenser/output/restart/qa/prepare.py

from pathlib import Path
from PIL import Image,ImageDraw,ImageFont
import shutil,json
Q=Path('output/restart/qa');S=Path('output/restart/source')
shutil.copy(S/'image1.jpg',Q/'image1.jpg')
# Crop browser chrome and redact all setup credentials and household identifiers.
im=Image.open(S/'image11.jpeg').convert('RGB');dr=ImageDraw.Draw(im)
for b in [(120,570,760,680),(120,940,920,1050)]:dr.rectangle(b,fill='black')
im.crop((80,230,1470,1870)).save(Q/'old-web.png')
im=Image.open(S/'image12.jpeg').convert('RGB');im.crop((30,30,1060,960)).save(Q/'join-ap.png')
im=Image.open(S/'image13.jpeg').convert('RGB');dr=ImageDraw.Draw(im)
for b in [(300,1370,1340,1445),(300,1500,1340,1590),(300,1640,1340,1760)]:dr.rectangle(b,fill='black')
im.crop((180,220,1400,1940)).save(Q/'actual-portal.png')
s=(Q/'build_report.py').read_text().replace("ROOT/'output/qa'","ROOT/'output/restart/qa'")
s=s.replace('29.489','30.406').replace('29.622','30.576').replace('16:50:35–16:51:04','23:54:38–23:55:09').replace('output/evidence/test-run.txt','output/restart/evidence/test-run.txt')
a=s.index("p('ภาพที่ 3.1 และ 3.2") ; b=s.index("p('การอ้างอิงซอฟต์แวร์",a)
s=s[:a]+"""p('ต้นฉบับล่าสุดมีภาพหน้าจอการตั้งค่าที่ถ่ายจากโทรศัพท์และแท็บเล็ต แต่ไม่มีภาพทั้งเครื่องหรือภายในที่ตรวจการเดินสายได้ ภาพที่ 3.1 แสดงขั้นตอนเข้าร่วมเครือข่ายอุปกรณ์ ส่วนภาพที่ 3.2 แสดงหน้าเว็บภายในอุปกรณ์ก่อนเวลาและเซิร์ฟเวอร์พร้อม ภาพทั้งสองไม่ยืนยันการจับคู่หรือจ่ายยาสำเร็จ')
pic('join-ap.png','ภาพที่ 3.1 หน้าจอเข้าร่วมเครือข่ายอุปกรณ์จากต้นฉบับ [7]',6)
pic('actual-portal.png','ภาพที่ 3.2 หน้าเว็บตั้งค่าที่ถ่ายจากอุปกรณ์ โดยปิดบังข้อมูลเครือข่ายและรหัส [7]',6)
"""+s[b:]
s=s.replace('มีภาพบอร์ดบางส่วน','ตามรายการและโค้ด; ยังไม่มีภาพติดตั้ง').replace('มีภาพโมดูล','ภาพผลิตภัณฑ์ไม่ยืนยันการติดตั้ง')
s=s.replace("p('ยังไม่มีภาพจาน", "p('ค่าพัลส์เริ่มต้นใน hardware_profile.h คือพัก 1,500 ไมโครวินาที และรูปล่อยสี่ตำแหน่ง 2,167 / 2,463 / 833 / 537 ไมโครวินาทีทุกช่อง ช่วงควบคุม 500–2,500 ไมโครวินาที และเวลาสั่น 600 มิลลิวินาที เป็นค่าตั้งต้น มิใช่ผลสอบเทียบกับเครื่อง ภาพผลิตภัณฑ์เซอร์โวในต้นฉบับระบุ SG90 แต่คำอธิบายในโค้ดระบุ SG92R 270 องศา จึงยังไม่สรุปรุ่นหรือมุมที่ติดตั้งจริง')\np('ยังไม่มีภาพจาน")
s=s.replace("p('ทะเบียนคำสั่งลด", "p('สำหรับรอบตามตาราง เมื่อเปิดกลไกจริง pill_app.cpp จองคีย์ dose ที่ประกอบด้วย schedule ID วัน และโหมดก่อนจัดคิว หากจองไม่ได้จะรายงาน FAILED พร้อมข้อความให้ตรวจยา ส่วน dry run ไม่จองคีย์นี้ในเส้นทางดังกล่าว ทะเบียนรองรับ 64 รายการและเก็บตามช่วง 86,400 วินาทีโดยต้องมีเวลาที่ใช้ได้ จึงไม่ควรอ้างว่าป้องกันซ้ำได้ตลอดไปหรือยืนยันจำนวนที่ออกเมื่อไฟดับ')\np('ทะเบียนคำสั่งลด")
s=s.replace("pic('portal.png','ภาพที่ 3.12 หน้าตั้งค่าในเฟิร์มแวร์ที่เปิดด้วยข้อมูลจำลอง [5]',9)","pic('old-web.png','ภาพที่ 3.12 หน้าเว็บตั้งค่ารุ่นก่อนจากต้นฉบับ ปิดบังรหัสแล้ว [7]',8)")
s=s.replace("p('ภาพที่ 3.12 มาจาก HTML ใน setup_portal.h ที่แสดงในเบราว์เซอร์ภายในเครื่อง ไม่ใช่ภาพโทรศัพท์ที่เชื่อม ESP32 จริง ช่องกรอกรหัสผ่านในภาพไม่มีข้อมูลลับ การเปิดหน้านี้ได้ยังไม่ยืนยันการจับคู่สำเร็จ')","p('ภาพที่ 3.12 เป็นภาพถ่ายหน้าเว็บที่ผู้จัดทำแนบในต้นฉบับ แสดงอายุรหัส 15 นาทีและรูปแบบรหัสรุ่นก่อน ปัจจุบันโค้ดกำหนดรหัสแปดตัวอายุห้านาที และยังรับรหัส legacy 20 ตัวจนถึงวันหมดอายุเดิม ภาพนี้จึงใช้แสดงพัฒนาการของหน้าจอ ไม่ใช้เป็นคู่มือค่าปัจจุบัน และไม่ยืนยันการตั้งค่าสำเร็จ')")
s=s.replace("('จานยาและวัสดุประกอบ','1 ชุด','398','398')","('จานยาและวัสดุประกอบ','3','133','399')").replace('2,122','2,123').replace('9,622','9,623').replace(',398,',',399,')
s=s.replace('ตรงกับยอดเดิม และผลคูณแต่ละบรรทัดตรงกัน','เมื่อแยกบริการ Cloud 70 บาทออกจากยอดเดิม 2,193 บาท และผลคูณแต่ละบรรทัดตรงกัน')
s=s.replace('จึงคงยอดเดิมในฐานะประมาณการภายใต้รายการและสมมติฐานเดิม','ยอดรวมเดิม 9,693 บาทรวม Cloud 70 บาทไว้ด้วย จึงปรับเป็นประมาณการครั้งแรก 9,623 บาทภายใต้รายการและสมมติฐานที่ระบุ')
s=s.replace('ภาพต้นแบบมีเพียงบางส่วน','ยังไม่มีภาพทั้งเครื่องและการติดตั้งกลไก').replace('ภาพบอร์ดและ RTC ตราสถาบัน','ภาพหน้าจอตั้งค่า ตราสถาบัน')
s=s.replace('ภาพหน้าจอในรายงานใช้ frontend/dist กับคำตอบ API จำลองในเครื่อง.','ภาพเว็บไซต์ปัจจุบันใช้ frontend/dist กับคำตอบ API จำลองในเครื่อง; ภาพถ่ายจากต้นฉบับอ้างอิง [7].')
s=s.replace('ไม่พบไฟล์สอบเทียบ', 'ไม่พบไฟล์สอบเทียบ')
s=s.replace('ภาพอุปกรณ์บางส่วน','ภาพหน้าจอตั้งค่าบางขั้นตอน')
s=s.replace("p('การตรวจไวยากรณ์", "p('เก็บสำเนาไฟล์โค้ดและทดสอบพร้อมรายการแฮชที่ output/restart/evidence เพื่อทวนสอบรุ่นที่ตรวจ ระหว่างรันมีเอกสารประกอบสองไฟล์เปลี่ยนจากการแก้ภายนอกงานนี้ แต่ตรวจว่าโค้ดและไฟล์ทดสอบที่ใช้ไม่เปลี่ยน จึงใช้ผลรันนี้อ้างอิงเฉพาะซอฟต์แวร์ดังกล่าว')\np('การตรวจไวยากรณ์")
(Q/'build_report.py').write_text(s)
meta=Path('output/restart/evidence/test-run.json');v=json.loads(meta.read_text());v['code_and_tests_unchanged']=True;v['changed_during_run']=['docs/UPLOAD_FIRMWARE.md','docs/SERVER_API.md'];meta.write_text(json.dumps(v,indent=2))
