Comxt-i/smart-pill-dispenser/ESP32_Main/net_sync.h

#pragma once

#include <Arduino.h>

#include "config.h"
#include "event_queue.h"

/** คำสั่งจ่ายยาที่เว็บฝากไว้ให้เครื่องมารับ */
struct RemoteCommand {
  char id[40];
  char type[12];  // DISPENSE, BUZZ, CANCEL
  char scheduleId[40];
  uint8_t slot;
  float amount;
  unsigned long receivedAtMs; // Local receipt time; expire queued commands after 15 minutes.
};

void netSyncBegin();

/**
 * ดึงเวลา + ตารางยาของวันนี้ + คำสั่งค้าง จาก GET /api/device/sync
 * คืน true เมื่อได้ข้อมูลครบและ commit ลง schedule_store แล้ว
 */
/**
 * เริ่มขอตารางยา + เวลา + คำสั่งจาก server โดยไม่รอ (คืน false ถ้ามีงานค้างหรือยังไม่พร้อม)
 * ผลถูกนำไปใช้ใน netSyncService() ของ loop รอบถัดๆ ไป
 */
bool netSyncFetch();

/** ส่งผลการจ่ายยาที่ค้างในคิวขึ้น server แล้วลบรายการที่ server ตอบรับออกจากคิว */
/** เริ่มส่งผลการจ่ายยาที่ค้างในคิวโดยไม่รอ ผลถูกนำไปใช้ใน netSyncService() */
bool netSyncFlushEvents();

/**
 * นำผลของงานเครือข่ายที่เสร็จแล้วไปใช้ (อัปเดตตาราง นาฬิกา คิว) ไม่ block
 * ต้องเรียกจาก loop หลักเท่านั้น และเฉพาะตอนที่ยอมให้แตะ I2C/NVS ได้ (ไม่ใช่ระหว่างจ่ายยา)
 */
void netSyncService();

/**
 * ตัดสินว่าจะทำงานเครือข่ายอะไรต่อ (ไม่ block): sync ถ้าถึงรอบ ไม่อย่างนั้นเปิดสาย /wait
 * ค้างไว้ให้ server บอกทันทีเมื่อมีอะไรเปลี่ยน เรียกทุกรอบ loop ได้
 */
void netSyncPump();

/**
 * ใช้ตารางยาที่เก็บไว้ในเครื่อง (เลือกมื้อของวันนี้ตามนาฬิกาเครื่อง)
 * เรียกตอนเปิดเครื่องหลังนาฬิกาพร้อม และตอนขึ้นวันใหม่ คืน false ถ้ายังไม่มีตารางเก็บไว้
 */
bool netSyncApplyCachedSchedule();

/** sync ครั้งแรกหลังเปิดเครื่องได้คำตอบแล้ว (สำเร็จหรือล้มเหลว) */
bool netSyncFirstSyncFinished();

/** true เมื่อถึงรอบที่ควรเรียก netSyncFetch() (คุมจังหวะตาม next_poll_sec ของ server) */
bool netSyncDue();

/** สั่งให้ sync รอบถัดไปเกิดขึ้นทันที เช่น หลังขึ้นวันใหม่หรือผู้ใช้กดปุ่ม */
void netSyncRequestNow();

/** เวลาที่ server ส่งมาล่าสุด (epoch ท้องถิ่น) 0 = ยังไม่เคย sync สำเร็จ */
uint32_t netSyncLastServerEpoch();
int netSyncTimezoneOffsetMinutes();

/** ดึงคำสั่งที่รออยู่ออกมาทีละรายการ คืน false เมื่อคิวคำสั่งว่าง */
bool netSyncTakeCommand(RemoteCommand &command);

/** สถิติสำหรับหน้าเว็บสถานะและ Serial */
bool netSyncLastCallOk();
unsigned long netSyncLastOkMs();
const char *netSyncLastError();
/** เหตุล้มเหลวล่าสุดแบบสั้นภาษาอังกฤษ ("CONN -1", "HTTP 401", "NO CLOCK") สำหรับจอ LCD */
const char *netSyncLastErrorShort();
/** มีงานเครือข่ายค้างอยู่ (รอผลหรือรอ loop หลักรับผล) ใช้ไล่ปัญหาจากหน้าสถานะ */
bool netSyncJobBusy();
const char *netSyncConfigVersion();

/** Complete a logged-in setup session using the hardware API key. Returns HTTP status or 0 while waiting for TLS. */
int netSyncCompleteSetup(const char *token);
