Comxt-i/smart-pill-dispenser/tests/runtime_button_integration_test.cpp

#include <cassert>
#include "../ESP32_Main/buttons.cpp"
#include "../ESP32_Main/pill_app.cpp"
uint32_t nowMs = 0;
int levels[64];
bool busy = false, inSetup = false;
int dispenseCalls = 0, setupCalls = 0, stopCalls = 0;
Dose testDose = {};
Slot testSlot = {};
PendingEvent lastEvent = {};
int queuedEvents = 0;
DispenseResult simulatedResult = DispenseResult::Started;
SerialClass Serial;
WiFiClass WiFi;
unsigned long millis() { return nowMs; }
void pinMode(uint8_t, uint8_t) {}
int digitalRead(uint8_t pin) { return levels[pin]; }
bool dispenserIsBusy() { return busy; }
bool dispenserHasCapacity() { return !busy; }
bool wifiSetupActive() { return inSetup; }
bool wifiStartSetup() { ++setupCalls; inSetup = true; return true; }
void alertOneShot(AlertPattern) {}
void alertSet(AlertPattern) {}
void lcdShowMessage(const char*, const char*) {}
void netSyncRequestNow() {}
void stopDispenser() { ++stopCalls; busy = false; }
// 42 เป็นค่าที่เป็นไปไม่ได้ ใช้จับกรณีที่ช่องตามขนาดยาไม่ถูกส่งต่อมาเลย
int8_t lastRequestedHole = 42;
DispenseResult dispenseMedicine(uint8_t, uint8_t pills, int8_t hole) { ++dispenseCalls; lastRequestedHole = hole; if (!pills) return DispenseResult::Invalid; busy = simulatedResult == DispenseResult::Started; return simulatedResult; }
Dose* scheduleDoseAt(const DoseRef&) { return &testDose; }
const Slot* scheduleSlotOf(const DoseRef&) { return &testSlot; }
int scheduleFindSlot(uint8_t) { return 0; }
const Slot &scheduleSlot(uint8_t) { return testSlot; }
void scheduleSetState(const DoseRef&, DoseState state) { testDose.state = state; }
bool scheduleSnooze(const DoseRef&, int) { return true; }
bool scheduleCanSnooze(const DoseRef&, int) { return true; }
uint8_t scheduleAlertingDoses(DoseRef *out, uint8_t) {
  if (testDose.state != DoseState::Alerting) return 0;
  out[0] = {0,0,true}; return 1;
}
uint32_t rtcLocalEpoch() { return 0; }
int rtcMinutesOfDay() { return 0; }
void eventQueueMakeId(char*, size_t) {}
bool eventQueuePush(const PendingEvent &event) { lastEvent = event; ++queuedEvents; return true; }

// ไฟสถานะไม่มีผลต่อพฤติกรรมของปุ่ม จึงกลืนทิ้งได้
// Reached only from appBegin()/appStatusJson(), which this test never calls.
// --gc-sections drops them on ELF, but MinGW/PE keeps every function, so without
// these the test cannot link on Windows at all.
void alertBegin() {}
void eventQueueBegin() {}
void scheduleBegin(void (*)(const DoseRef&, DoseState, DoseState)) {}
void dispenserControlBegin() {}
void dispenserHomeAll() {}
void dispenserSensorSelfTest() {}
bool laserSwitchResponding() { return true; }
int8_t pillSensorStatus(uint8_t) { return 1; }
bool pillSensorReads(uint8_t, uint8_t &, uint8_t &) { return false; }
const char *pillSensorFaultHint(uint8_t) { return nullptr; }
const char *doseStateName(DoseState) { return ""; }
void netSyncBegin() {}
void netSyncService() {}
int pumpCalls = 0;
void netSyncPump() { ++pumpCalls; }
bool netSyncFirstSyncFinished() { return false; }
bool flashStoreBegin() { return true; }
bool netSyncApplyCachedSchedule() { return false; }
void scheduleCacheBegin() {}
void scheduleCacheMarkClosed(const char*, uint32_t) {}
bool scheduleCacheIsClosed(const char*, uint32_t) { return false; }
uint32_t scheduleDayKey() { return 20260925; }
bool netSyncLastCallOk() { return true; }
unsigned long netSyncLastOkMs() { return millis(); }
const char *netSyncLastErrorShort() { return ""; }
bool netSyncJobBusy() { return false; }
const char *netSyncLastError() { return ""; }
const char *netSyncConfigVersion() { return ""; }
void rtcLcdBegin() {}
I2cLineState i2cLastLineState() { return I2cLineState{}; }
const char *rtcClockSource() { return "RTC"; }
void wifiWebBegin() {}
void delay(unsigned long ms) { nowMs += ms; }
// หน้าจอตั้งค่าและหน้าวินิจฉัยตอนบูตเรียกสามตัวนี้
const char *wifiSetupStatusShort() { return "OPEN"; }
bool wifiHasSavedNetwork() { return true; }
const char *wifiSavedSsid() { return "Home"; }
bool rtcIsPresent() { return true; }
bool rtcLostTimeDetected() { return false; }
bool rtcWasOffAtLastBoot() { return false; }
bool rtcHasTime() { return true; }
void rtcSetNetworkOnline(bool) {}
bool rtcOscillatorHalted() { return false; }
uint8_t i2cFoundCount() { return 0; }
uint8_t i2cFoundAddress(uint8_t) { return 0; }
void statusLedBegin() {}
void statusLedFlash(LedColor) {}
void statusLedSet(LedPattern) {}
void statusLedUpdate() {}
void tick(uint32_t ms) { nowMs += ms; buttonsUpdate(); handleButtons(); }
void press(ButtonId id) {
  levels[BUTTON_PINS[static_cast<uint8_t>(id)]] = LOW;
  tick(1); tick(BUTTON_DEBOUNCE_MS);
}
void release(ButtonId id) {
  levels[BUTTON_PINS[static_cast<uint8_t>(id)]] = HIGH;
  tick(1); tick(BUTTON_DEBOUNCE_MS);
}
void resetCase() {
  for (int &level : levels) level = HIGH;
  buttonsBegin(); setupButton = {};
  // runOwner เป็นอาร์เรย์รายจานแล้ว เพราะจ่ายพร้อมกันได้หลายจาน
  for (auto &owner : runOwner) owner = RunOwner::None;
  pendingDoseCount = deferredEventCount = 0; cancelPressActive = false;
  busy = inSetup = false;
  dispenseCalls = setupCalls = stopCalls = 0;
  testDose.state = DoseState::Alerting;
  strcpy(testDose.scheduleId, "dose-1");
  testSlot.number = 1; testSlot.amountPerDose = 1; testSlot.pillHole = 2;
}
int networkCalls = 0, clockCalls = 0, motionTicks = 0;
bool outcomeReady = false;
DispenseOutcome suppliedOutcome = {};
void commandJournalDoseKey(char*, size_t, const char*, uint32_t, bool) {}
bool commandJournalReserve(const char*, uint32_t) { return true; }
bool commandJournalRelease(const char*) { return true; }
const char *commandJournalLastError() { return ""; }
void dispenserControlUpdate() { ++motionTicks; }
void wifiWebLoop() { ++networkCalls; }
void rtcLcdUpdate() { ++clockCalls; }
void alertUpdate() {}
void lcdMedicineTick() {}
void lcdSetMedicineScreen(const char *const *, uint8_t, const char *const *, uint8_t) {}
bool rtcIsValid() { return false; }
uint32_t rtcDayKey() { return 20260925; }
bool scheduleConsumeDayRollover() { return false; }
bool scheduleHasData() { return false; }
uint8_t scheduleSnoozeCount(const DoseRef&) { return 0; }
uint8_t scheduleSlotCount() { return 0; }
DoseRef scheduleTick(int, uint32_t, bool) { return {}; }
DoseRef scheduleFindByScheduleId(const char*) { return {0,0,true}; }
DoseRef scheduleFirstSnoozed() { return {}; }
bool doseIsOpen(const Dose&) { return false; }
int doseEffectiveMinutes(const Dose&) { return 0; }
bool netSyncDue() { return true; }
bool netSyncFetch() { ++networkCalls; return true; }
bool netSyncFlushEvents() { ++networkCalls; return true; }
// คำสั่งที่ server ฝากไว้ให้กล่องรับรอบถัดไป (ไม่มี = คืน false)
RemoteCommand waitingCommand = {};
bool commandWaiting = false;
bool netSyncTakeCommand(RemoteCommand &out) {
  if (!commandWaiting) return false;
  out = waitingCommand; commandWaiting = false; return true;
}
uint8_t eventQueueSize() { return 1; }
const char *wifiSetupSsid() { return "test"; }
const char *wifiSetupPassword() { return "test-only"; }
bool takeDispenseOutcome(DispenseOutcome &out) {
  if (!outcomeReady) return false;
  out = suppliedOutcome; outcomeReady = false; return true;
}
int main() {
  resetCase();
  press(ButtonId::Dispense); tick(500);
  assert(dispenseCalls == 0 && setupCalls == 0);
  release(ButtonId::Dispense);
  assert(dispenseCalls == 1 && setupCalls == 0);
  assert(lastRequestedHole == 2);  // ช่องตามขนาดยาของช่องนั้นถูกส่งต่อไปจริง
  tick(500); assert(dispenseCalls == 1);

  // During an alert, holding green 3 s accepts the dose. It must never open setup:
  // setup silences the alert and blocks dispensing, so the dose was silently missed
  // and the LCD sat on the Wi-Fi screen. People hold the button while waiting.
  resetCase();
  press(ButtonId::Dispense); tick(3000);
  assert(setupCalls == 0 && dispenseCalls == 1);
  release(ButtonId::Dispense);
  assert(dispenseCalls == 1 && setupCalls == 0);

  // "It jumped to the setup screen by itself": a quick press, then the loop blocks for
  // seconds inside an HTTPS sync. The user let go long ago, but the first sample after
  // the block still carried the stale "held" state, which the gesture read as a 4 s hold.
  // A press we could not watch must never be treated as a deliberate 3 s hold.
  resetCase(); testDose.state = DoseState::Done;
  press(ButtonId::Dispense);
  levels[BUTTON_PINS[static_cast<uint8_t>(ButtonId::Dispense)]] = HIGH;  // released during the block
  nowMs += 4000;                                                        // network call blocked the loop
  tick(1); tick(BUTTON_DEBOUNCE_MS); tick(500);
  assert(setupCalls == 0);
  // ...and during an alert the same stale sample must not be read as a hold either.
  resetCase();
  press(ButtonId::Dispense);
  levels[BUTTON_PINS[static_cast<uint8_t>(ButtonId::Dispense)]] = HIGH;
  nowMs += 4000;
  tick(1); tick(BUTTON_DEBOUNCE_MS); tick(500);
  assert(setupCalls == 0);
  // A real hold across a block is still a real hold: the pin is still down afterwards.
  resetCase(); testDose.state = DoseState::Done;
  press(ButtonId::Dispense);
  nowMs += 4000;
  tick(1);
  assert(setupCalls == 1);
  release(ButtonId::Dispense);

  // With no dose due, the same hold opens setup exactly as before.
  resetCase(); testDose.state = DoseState::Done;
  press(ButtonId::Dispense); tick(3000);
  assert(setupCalls == 1 && dispenseCalls == 0);
  release(ButtonId::Dispense);
  assert(dispenseCalls == 0 && setupCalls == 1);
  // Subsequent short presses during setup must not dispense either, even if a dose
  // becomes due while setup is open.
  testDose.state = DoseState::Alerting;
  press(ButtonId::Dispense); release(ButtonId::Dispense);
  assert(dispenseCalls == 0);

  resetCase(); busy = true;
  press(ButtonId::Dispense); tick(1000); busy = false; tick(2000);
  release(ButtonId::Dispense);
  assert(setupCalls == 0 && dispenseCalls == 0);
  // Once idle, a fresh 3 s hold during the (still active) alert accepts the dose.
  press(ButtonId::Dispense); tick(3000);
  assert(setupCalls == 0 && dispenseCalls == 1);

  resetCase(); busy = true;
  press(ButtonId::Dispense);
  press(ButtonId::Cancel); tick(CANCEL_HOLD_MS);
  assert(stopCalls == 1);
  tick(3000); release(ButtonId::Dispense);
  assert(setupCalls == 0 && dispenseCalls == 0);
  // The real application reports explicit simulation markers for the button.
  resetCase(); simulatedResult=DispenseResult::Disabled;
  queuedEvents=0;
  press(ButtonId::Dispense); release(ButtonId::Dispense);
  assert(queuedEvents == 1 && strcmp(lastEvent.status, "DISPENSED") == 0);
  assert(strstr(lastEvent.note, "dry run") != nullptr);
  simulatedResult = DispenseResult::Started;

  // Dispensing from the web is gone: pills come out only when someone at the box presses green.
  // A DISPENSE command still waiting on an old server is closed with ACK (no intake history)
  // and never moves the mechanism, even with the box idle and nothing blocking commands.
  resetCase(); testDose.state = DoseState::Done; queuedEvents = 0;
  waitingCommand = {}; strcpy(waitingCommand.id, "web-dispense"); strcpy(waitingCommand.type, "DISPENSE");
  waitingCommand.slot = 1; waitingCommand.amount = 2; commandWaiting = true;
  appLoop();
  assert(!commandWaiting);  // the command really was taken and handled, not just left waiting
  assert(dispenseCalls == 0 && !busy);
  assert(queuedEvents == 1 && strcmp(lastEvent.commandId, "web-dispense") == 0);
  assert(strcmp(lastEvent.status, "ACK") == 0 && strstr(lastEvent.note, "disabled"));
  // Other web commands still work (control: the command path itself is alive).
  resetCase(); testDose.state = DoseState::Done; queuedEvents = 0;
  waitingCommand = {}; strcpy(waitingCommand.id, "web-buzz"); strcpy(waitingCommand.type, "BUZZ");
  commandWaiting = true;
  appLoop();
  assert(queuedEvents == 1 && strcmp(lastEvent.commandId, "web-buzz") == 0 && strstr(lastEvent.note, "buzz"));
  assert(strcmp(lastEvent.status, "ACK") == 0 && dispenseCalls == 0);

  PendingEvent skipped = {}; strcpy(skipped.status, "SKIPPED"); strcpy(skipped.note, "cancelled by user");
  queueEvent(skipped);
  assert(strstr(lastEvent.note, "dry run") && strstr(lastEvent.note, "cancelled by user"));
  assert(pillsFor(0.5f) == 0 && pillsFor(1.5f) == 0);
  assert(pillsFor(0) == 0 && pillsFor(NAN) == 0 && pillsFor(INFINITY) == 0);
  assert(pillsFor(MAX_PILLS_PER_DOSE + 1) == 0 && pillsFor(2) == 2);
  resetCase(); busy = true; networkCalls = clockCalls = motionTicks = 0;
  appLoop();
  assert(motionTicks == 1 && networkCalls == 0 && clockCalls == 0);
  busy = false; inSetup = true;
  appLoop();
  assert(networkCalls == 1 && clockCalls == 1); // Idle networking resumes.
  resetCase(); simulatedResult = DispenseResult::Started;
  press(ButtonId::Dispense);
  levels[DISPENSE_BUTTON_PIN] = HIGH; tick(1); nowMs += BUTTON_DEBOUNCE_MS;
  networkCalls = 0;
  appLoop(); // This release starts motion before the HTTP sync phase.
  assert(busy && networkCalls == 1); // Only pre-gesture local web handling, no HTTP sync.
  // A finished run nobody owns has no dose to record against: report nothing.
  resetCase(); runOwner[0] = RunOwner::None; queuedEvents = 0;
  suppliedOutcome = {1, 1, 1, 1, false, true, StopReason::Done, 0, 0, 0, 0}; outcomeReady = true;
  handleDispenseOutcome();
  assert(!outcomeReady && queuedEvents == 0);
  resetCase(); runOwner[0] = RunOwner::Dose;
  testDose.failureReported = false;
  suppliedOutcome = {1, 2, 1, 1, false, true, StopReason::Done, 0, 0, 0, 0}; outcomeReady = true;
  handleDispenseOutcome();
  assert(testDose.state == DoseState::Failed && strstr(lastEvent.note, "1/2"));

  // ปุ่มเขียวอ่านว่ากดค้าง (ปุ่มค้าง/สายหลวม): เครื่องต้องยังคุยกับ server ต่อ
  // เดิมรอให้ปล่อยปุ่มก่อน ถ้าค้างตลอด เว็บเห็นกล่อง OFFLINE และตารางไม่อัปเดตอีกเลย
  resetCase(); busy = false; inSetup = false; testDose.state = DoseState::Done; runOwner[0] = RunOwner::None;
  press(ButtonId::Dispense);
  pumpCalls = 0;
  appLoop(); appLoop();
  assert(buttonHeld(ButtonId::Dispense) && pumpCalls == 2);
  release(ButtonId::Dispense);
}
