Comxt-i/smart-pill-dispenser/output/restart/evidence/snapshot/tests/net_async_test.cpp

// ทดสอบการส่งงานเครือข่ายแบบไม่ block ระหว่าง loop หลักกับ task เบื้องหลัง
//
// คอมไพล์บนคอมไม่มี FreeRTOS งานจึงถูกทำทันทีตอนส่ง แต่ผลต้องรออยู่จนกว่า loop หลัก
// จะเรียก netSyncService() เหมือนบนเครื่องจริงทุกประการ ซึ่งคือสิ่งที่เทสต์นี้ตรวจ
#include <cassert>
#include <cstring>
#include "../ESP32_Main/net_sync.cpp"
#include "../ESP32_Main/command_journal.cpp"
#include "../ESP32_Main/schedule_cache.cpp"

FakeHttp fakeHttp;
SerialClass Serial;
WiFiClass WiFi;
unsigned long testNow = 1000;
unsigned long millis() { return testNow; }
void delay(unsigned long ms) { testNow += ms; }
#ifdef _WIN32
int settimeofday(const struct timeval *, const struct timezone *) { return 0; }
#endif

// โมดูลอื่นที่ net_sync เรียก: นับไว้พอให้รู้ว่าผลถูกนำไปใช้ "เมื่อไร"
int syncCommits = 0, queueRemovals = 0, queuePersists = 0;
uint8_t queued = 0;
PendingEvent pendingEvent = {};
uint32_t rtcLocalEpoch() { return 1800000000; }
uint32_t rtcDayKey() { return 20260926; }
void rtcSyncFromEpoch(uint32_t) {}
void scheduleBeginSync() {}
void scheduleCommitSync() { ++syncCommits; }
int scheduleStageSlot(uint8_t, bool, const char *, const char *, float) { return 0; }
void scheduleStageDose(int, const char *, const char *, int, bool) {}
void scheduleStageSlotPillHole(int, int8_t) {}
uint8_t eventQueueSize() { return queued; }
const PendingEvent &eventQueueAt(uint8_t) { return pendingEvent; }
void eventQueueRemove(const char *) { ++queueRemovals; }
void eventQueuePersist() { ++queuePersists; }

static bool lastUrlHas(const char *part)
{
  return !fakeHttp.urls.empty() && strstr(fakeHttp.urls.back().c_str(), part) != nullptr;
}
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
