Comxt-i/smart-pill-dispenser/(commit log)

2026-09-12 Restructure dispenser for one Nano and document three IR sensors
2026-09-27 Fix timer rollover and TLS clock type comparison
    [boot_policy.h, net_sync.cpp]
